Het-Bhavsar/Atrium/README.md

<p align="center">
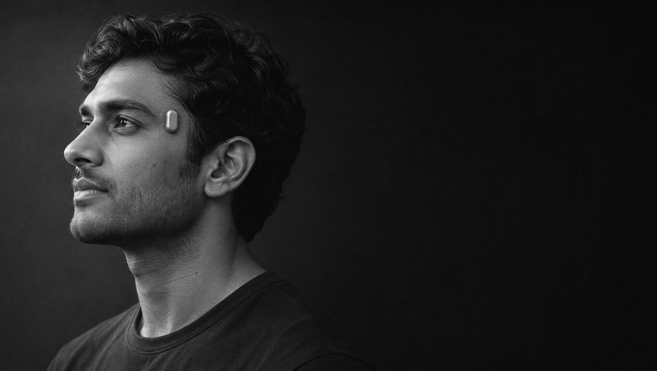
[picture p1: docs/images/photos/hero_mono.jpg]
A man in profile wearing the Atrium pod beside his eye
  
  <br><sub>Illustration: the pod at true scale. No EVT units are built yet.</sub>
</p>

<p align="center">
  Atrium mark
</p>

<h1 align="center">Atrium</h1>

<p align="center">
  <b>An open optical wearable, small enough to forget.</b><br>
  Designed in Ahmedabad by <a href="https://localforge.in">Local Forge</a>.
</p>

<p align="center">
  <a href="https://certification.oshwa.org/in000108.html">OSHW certification mark, UID IN000108</a>
</p>

<p align="center">
  <a href="docs/quick-start.md">Quick start</a> ·
  <a href="#the-story">Story</a> ·
  <a href="#inside">Inside</a> ·
  <a href="#whats-next">What's next</a> ·
  <a href="#at-a-glance">At a glance</a> ·
  <a href="#get-the-app">Get the app</a> ·
  <a href="#whats-in-this-repository">Repository</a> ·
  <a href="CONTRIBUTING.md">Contribute</a> ·
  <a href="#licence">Licence</a>
</p>

---

## Small. Quiet. Open.

Atrium is a 20.9 × 11 × 5.3 mm pod worn on the temporal region, the flat of the head beside the eye. It reads the skin
with light and motion: pulse, heart-rate variability, skin-temperature trend, sleep and activity. It keeps a log and
syncs it to your phone over Bluetooth LE. A small Plinth charges it, and a pocket case charges it on the go.

https://github.com/user-attachments/assets/29e595bc-7b6f-4664-8e52-f603c6576f4c

<p align="center">
  <sub>The film, 57 s: the radio island, the power island, the flex, the cell, the pod, then green and red light on skin.
  <a href="docs/images/video/atrium_assembly_film_1080p.mp4">Download the MP4</a>.</sub>
</p>

<p align="center">
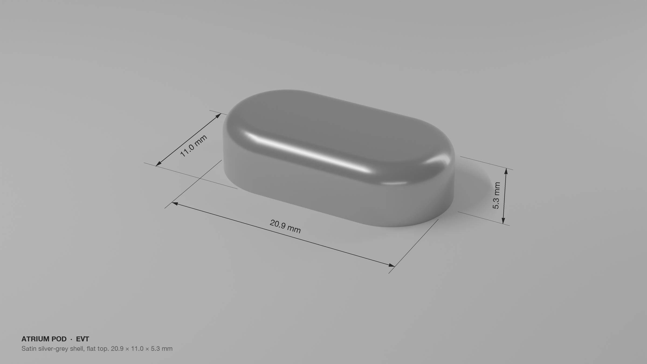
[picture p2: docs/images/renders/pod_studio_dimensions.png]
Studio render of the pod with its dimensions: 20.9 by 11.0 by 5.3 mm
  
</p>

<p align="center">
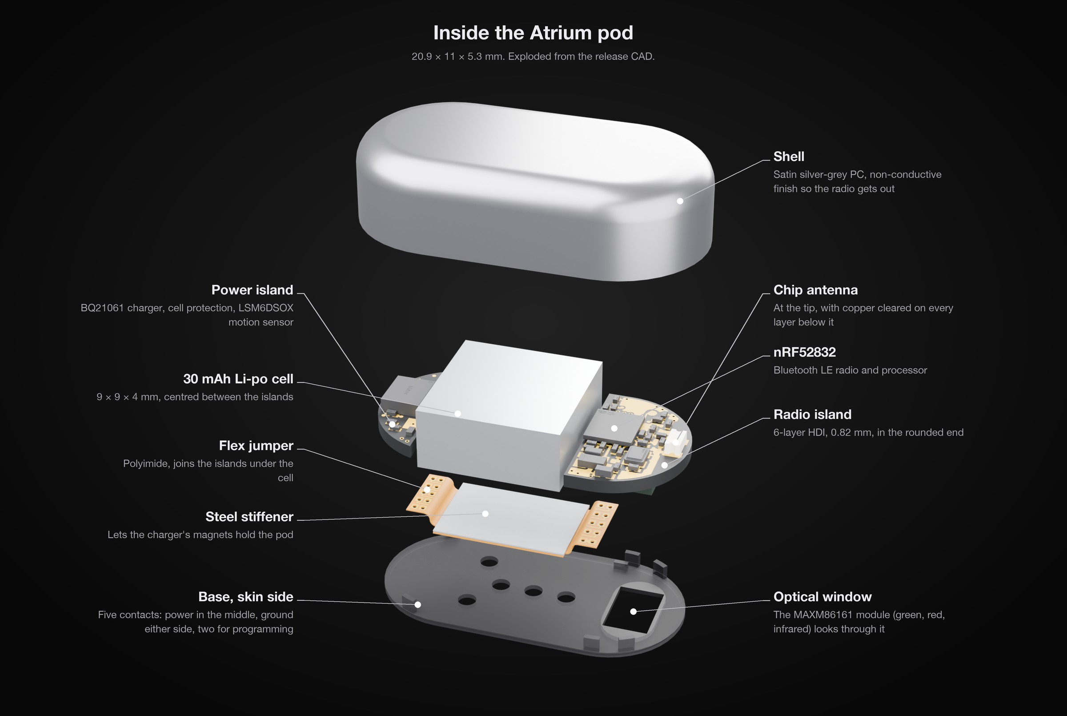
[picture p3: docs/images/plates/pod_exploded_infographic.jpg]
Exploded view of the pod with each part labelled: shell, chip antenna, nRF52832, radio island, power island, cell, flex, stiffener, base and optical window
  
</p>

Every file that defines it is here: schematics, board layouts, Gerbers, BOMs, enclosure CAD and drawings, the
simulations behind the numbers, the firmware for the pod and the case, and the phone app. Read it, build it, change it.

<p align="center">
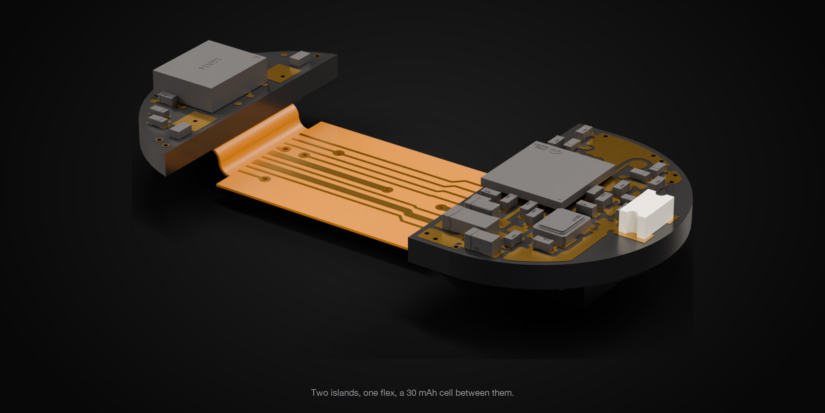
[picture p4: docs/images/plates/boards.jpg]
The two pod boards joined by the flex
  
</p>

<p align="center">
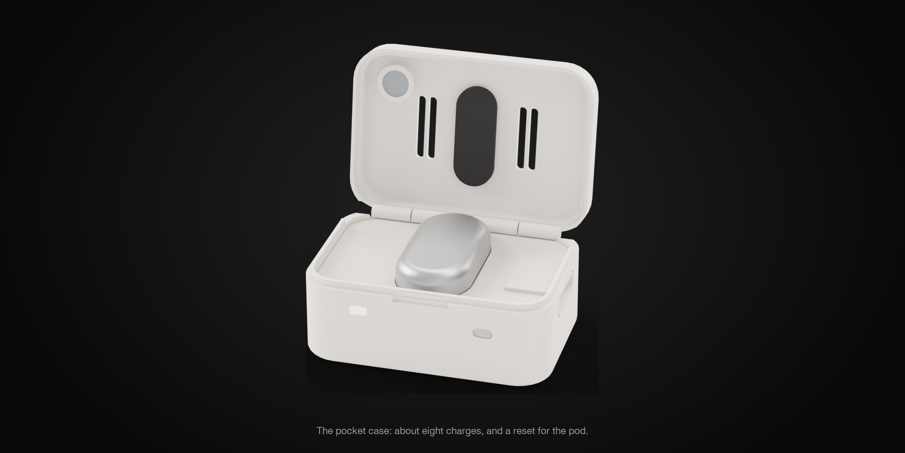
[picture p5: docs/images/plates/case.jpg]
Charging case, open, with the pod in its nest
  
</p>

## Quick start

| I want to | Start here |
|---|---|
| Try the app without a pod | Install the demo APK from [Releases](https://github.com/Het-Bhavsar/Atrium/releases/latest) |
| Read the design | Schematic and PCB PDFs in `hardware/`, drawings in `mechanical/` |
| Build the firmware | `firmware/tests/fw.sh image`, then `test` and `build` (Docker only) |
| Make, flash and pair pods | [`docs/quick-start.md`](docs/quick-start.md) |

## The story

Every great building has a centre. In a Roman house it was the atrium: an open hall with the sky for a roof. Light came
in there, people gathered there, and nothing was hidden. Your heart has one too: the chamber where blood arrives before
every beat.

I named Atrium after both. It reads your pulse with light, and like the hall, it is open: every schematic, every line of
firmware and every data format is public.

It started as a 28 × 14 mm board with a discrete optical front end. That was too big to forget on your head, so I moved
the optics into one module, dropped to a 30 mAh cell, and split the electronics into two small boards in the rounded
ends of the pod, joined by a flex under a centred cell. Each step, and what I tried and left behind, is in
[`docs/story.md`](docs/story.md) and [`legacy/`](legacy/).

<p align="center">
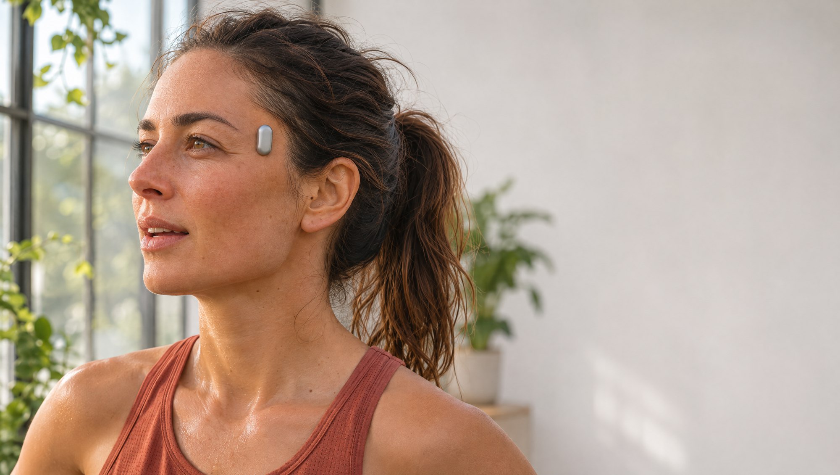
[picture p6: docs/images/photos/pod_worn.jpg]
The pod worn upright in the temporal hollow, beside the eye
  
  <br><sub>Worn upright in the temporal hollow, a thumb-width behind the eye. Illustrations, with the pod at true scale.</sub>
</p>

**Atrium. Open to the sky. Open to everyone.**

## Inside

Every board is routed by hand: no autorouter, arc bends on the antenna feed and a copper-free zone under the chip
antenna on every layer.

<p align="center">
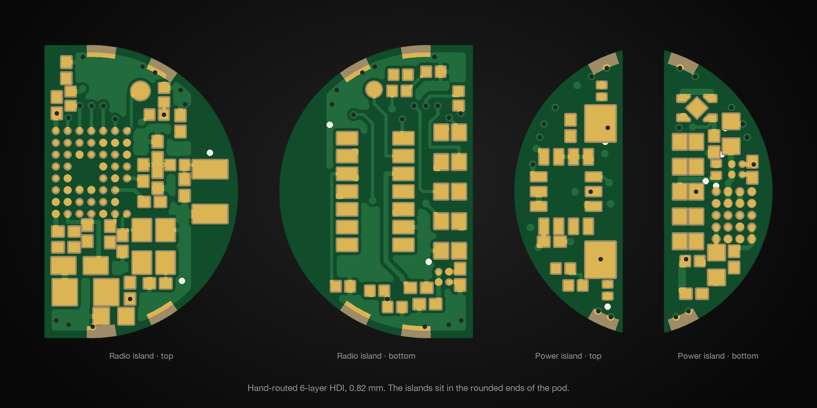
[picture p7: docs/images/plates/layout_islands.jpg]
Radio and power island layouts, top and bottom
  
</p>

<p align="center">
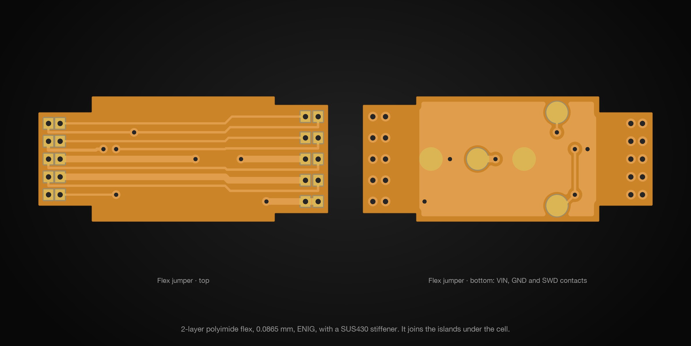
[picture p8: docs/images/plates/layout_flex.jpg]
Flex jumper layout, top and bottom
  
</p>

<p align="center">
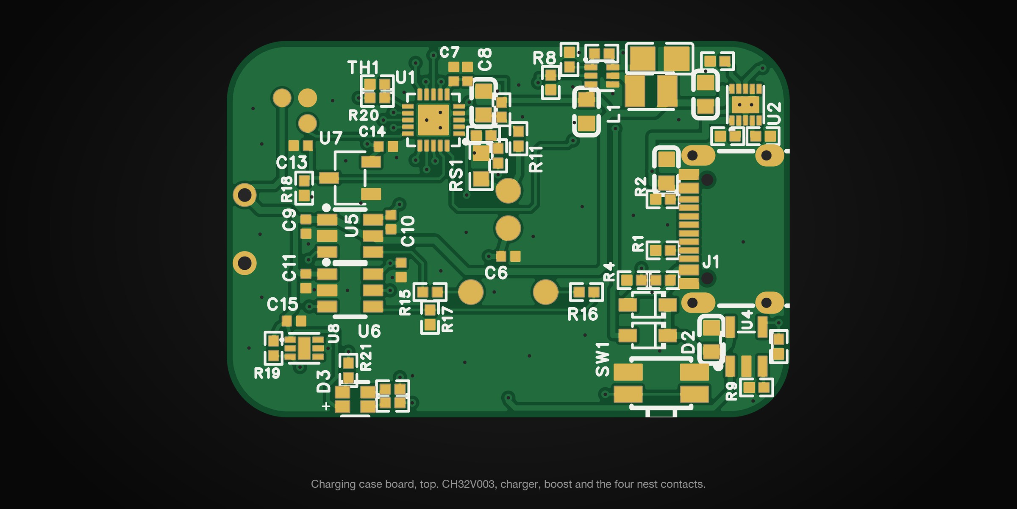
[picture p9: docs/images/plates/layout_case.jpg]
Charging case board layout, top
  
</p>

<p align="center">
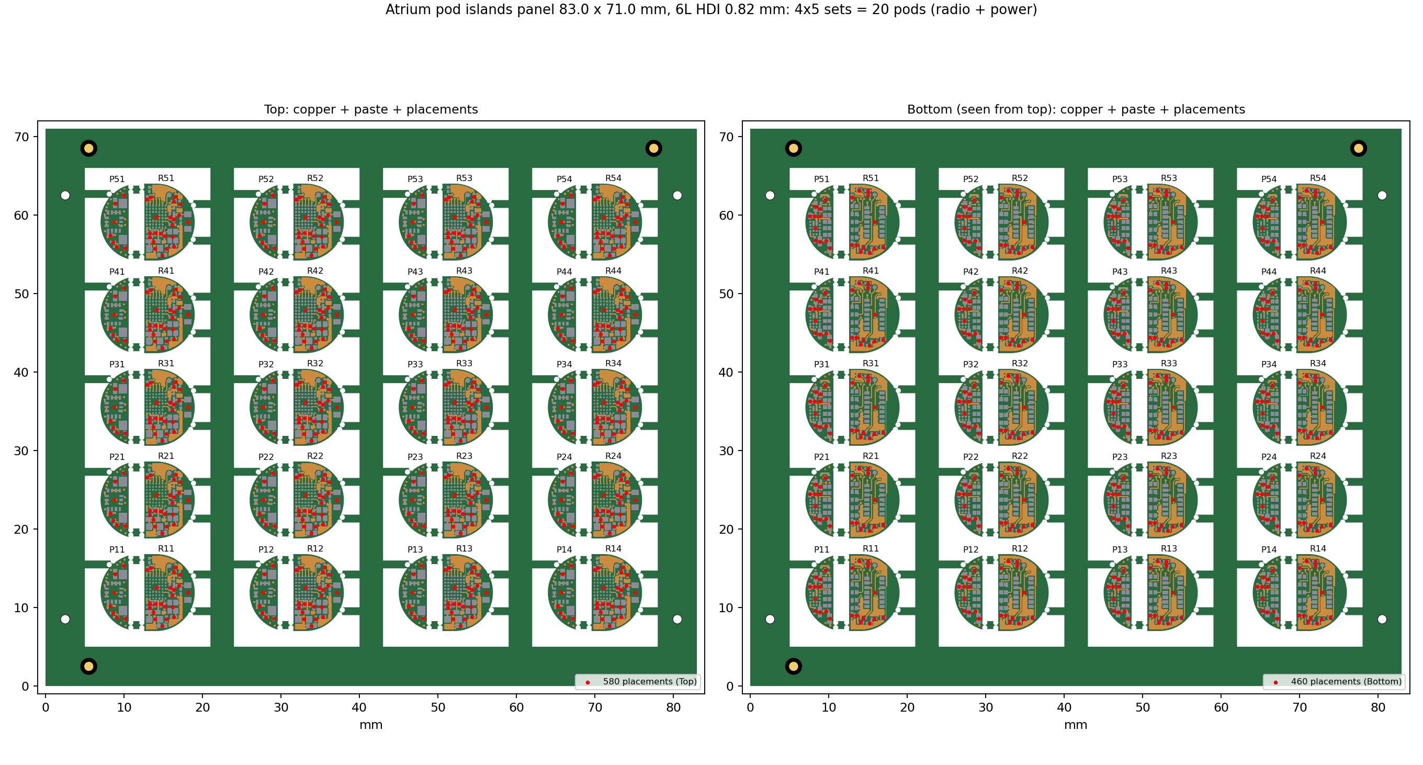
[picture p10: hardware/pod/islands-panel/Pod_Islands_Panel_render.png]
The islands panel: 20 pods on one 6-layer panel
  
  <br><sub>One 83 × 71 mm panel builds 20 pods: one PCB order, one stencil per side, one assembly run.</sub>
</p>

## What's next

The EVT build is about proving the basics on real heads. While that happens, these are the three directions I care
most about.

**Smaller, with a custom cell.** The pod is 20.9 mm long today because the cell is an off-the-shelf 9 × 9 × 4 mm
pouch, and the radio island, cell and power island have to sit in a row. With a cell made to the shape of the shell I
think we can bring the pod to around 17 mm. That is the size I wanted from the start, and the first thing I will chase
after EVT.

**A voice on the head.** The temporal region sits right on the bone. The next version could add bone-conduction audio and
a voice pickup, so you can tap the pod and talk to an AI assistant, with the answer heard through
the bone and nothing in your ear. It is designed on paper and deliberately left out of EVT, so this build stays simple.

### Brain blood flow?

It's the first thing people ask about a sensor on the side of the head, so here is the straight answer: **no, Atrium
can't see blood flow in the brain, and neither can any sensor whose light and detector sit this close
together.** I wanted it to, so I tested it before
claiming anything.

<p align="center">
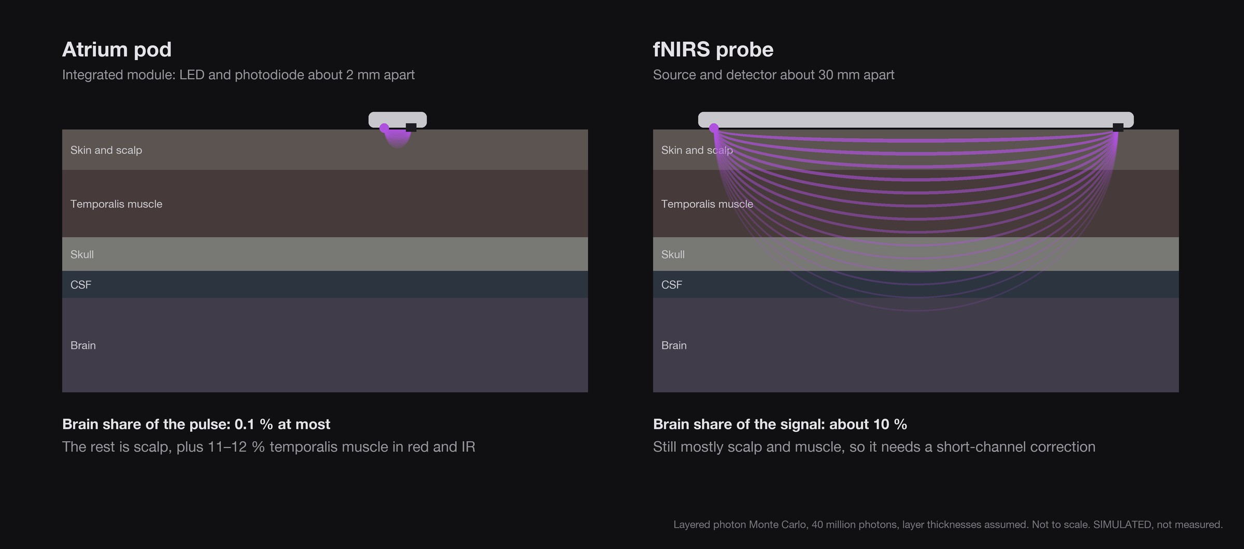
[picture p11: docs/images/research/light_depth_explainer.jpg]
How deep light travels at 2 mm and at 30 mm spacing
  
</p>

An optical sensor works by shining light into the skin and catching what scatters back. The light comes back along a
curved path, and **how deep that path goes depends on how far apart the light and the detector are.** Under the pod
there are a few millimetres of scalp, 4 to 17 mm of jaw muscle depending on the person, then the skull and some fluid
before you reach the brain.

- **The usual way, which Atrium uses.** An integrated optical module: green, red and infrared LEDs and the photodiode
  in one 2.9 × 4.3 mm package, so they are fixed about 2 mm apart by the part itself. Our photon simulations say green never leaves the scalp, and in red and infrared the brain's share of the
  pulse is **0.1 % at most**; the rest is scalp and the temporalis muscle. The pulse at the side of your head comes from
  the superficial temporal artery, which feeds the scalp, not the brain.
- **A far detector, which we tried.** Rev B.1 had a second photodiode 18.5 mm from the LEDs. At that distance our
  simulation puts the brain at about 1 % of the pulse and the jaw muscle at about three quarters, so it was dropped.
- **The fNIRS way.** Near-infrared light with the source and the detector about **3 cm** apart, so the light that makes
  it across has gone deep enough to reach the brain. Even then the brain is only **about 10 %** of the signal, which
  is why research systems add a short scalp-only channel and subtract it.

Better processing can't close that gap. To detect a brain signal in a 24-person study it would need to be about 2 % of
the pulse; at the pod's spacing it is 20 to 450 times smaller, depending on the person, faster sampling barely helps, and the jaw muscle
produces false "deep" results on its own. So when a small device says it reads brain blood flow, ask how far apart its
light and detector are, whether it has a short channel, and what it was validated against.

A 3 cm optical path needs a band or a longer probe and a proper study with a reference. It is on my research list, not
in this product. Atrium is a wellness device: pulse, heart-rate variability, sleep and skin temperature, done
honestly. The full reasoning is in [`docs/brain-blood-flow.md`](docs/brain-blood-flow.md), and the study itself, with its
figures and all the data, is in [`docs/research/brain-blood-flow/`](docs/research/brain-blood-flow/README.md).

If any of this is the part you want to build, start with the [roadmap](docs/roadmap.md) and open an issue.

— Het

## At a glance

| | |
|---|---|
| **Pod** | 20.9 × 11 × 5.3 mm capsule, flat top, satin silver-grey (NCVM on PC, non-conductive for the antenna) |
| **Boards** | Two rigid 6-layer HDI islands, 0.82 mm (1+4+1, laser microvias, filled via-in-pad), joined by a 2-layer polyimide flex under the cell |
| **Radio** | Bluetooth LE, nRF52832 WLCSP; KH-1608 chip antenna at the tip, 50 Ω coplanar feed with arc bends, copper-free on every layer under the antenna |
| **Optics** | MAXM86161A module (green, red and infrared LEDs, photodiode, front end) behind a pill window |
| **Other sensors** | LSM6DSOX motion, a skin NTC and a top NTC |
| **Power** | 30 mAh Li-po (9 × 9 × 4 mm), BQ21061 charger, AP6683 protection, 1.8 V rails; about 4 days in the default mode (to be measured on EVT units) |
| **Charging** | ENIG contacts on the skin side: VIN at the centre and ground either side, so it charges either way round, plus two SWD contacts for the programming jig and the charging case. A steel stiffener and two magnets hold it on the Plinth |
| **Case** | 2-layer board: CH32V003 MCU, BQ24040 charger with cell-temperature cut-off, 5 V boost and current limit into the pod; about 8 pod charges per case charge (estimated) |
| **Wear** | Upright, window end up. A hidden 0.15 mm disposable pad in a bed under the pod; nothing shows |
| **Build** | Parts from the LCSC / JLCPCB catalogue; both islands on one panel for one PCBA order |
| **Software** | Pod firmware on Zephyr RTOS with MCUboot, case firmware for the CH32V003, Flutter app for Android and iOS. No account and no cloud: data stays on the phone |

## Get the app

<p align="center">
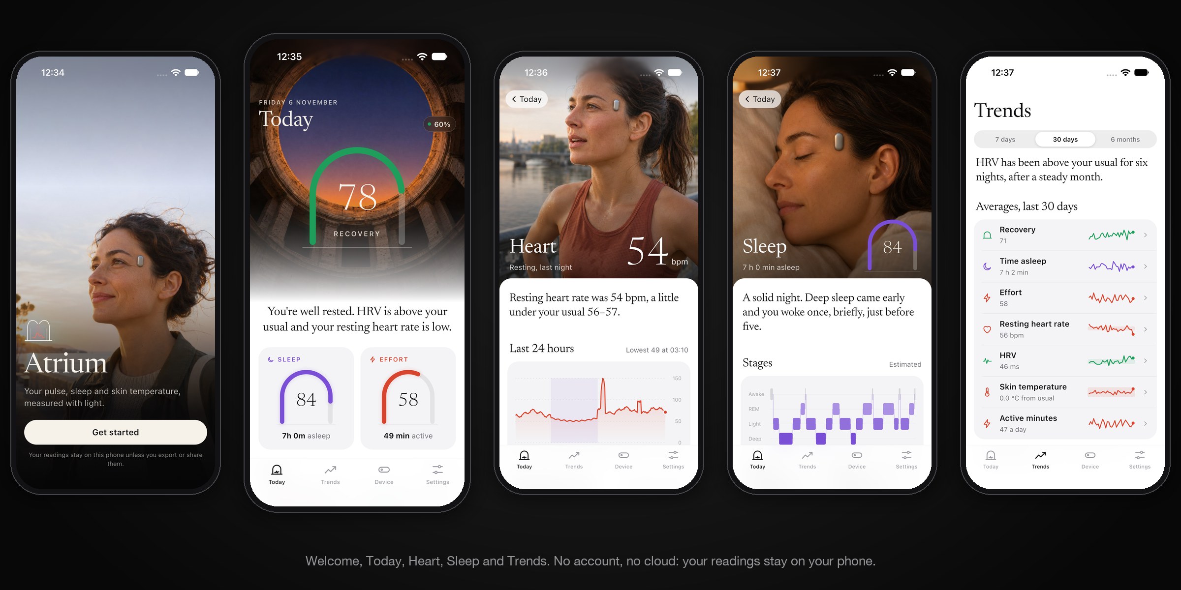
[picture p12: docs/images/app/app_daily.jpg]
App screens: Welcome, Today, Heart, Sleep, Trends
  
</p>

<p align="center">
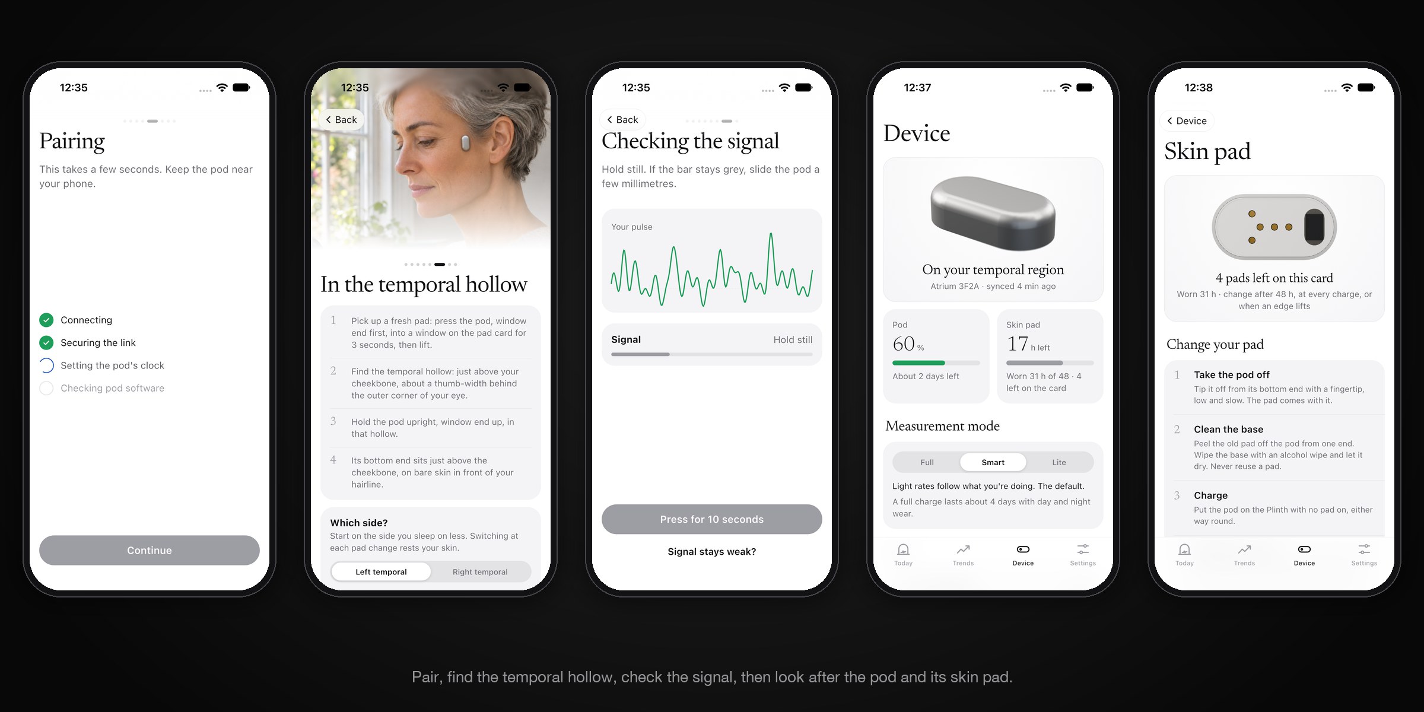
[picture p13: docs/images/app/app_setup.jpg]
Setup screens: pairing, placement, signal check, device and skin pad
  
  <br><sub>Screens from the demo build, with sample data. The photographs in the app are illustrations.</sub>
</p>

The Android app is on the [Releases page](https://github.com/Het-Bhavsar/Atrium/releases/latest):

- `atrium-…-demo-arm64-v8a.apk`: sample data, no pod needed. Start here.
- `atrium-…-pod-arm64-v8a.apk`: talks to a real pod over Bluetooth.
- `armeabi-v7a` builds for older phones.

The iOS app builds from `app/android-ios` with Flutter (see its README).

## What's in this repository

```
hardware/
  pod/radio-island/      schematic (SchDoc, PDF, SVG) · pcb (PcbDoc, PDF, STEP, renders) · production (Gerbers, BOM, CPL, IPC netlist)
  pod/power-island/      same
  pod/flex-jumper/       same
  pod/islands-panel/     the 4 × 5 panel of both islands: PcbDoc, Gerbers, BOM, CPL, order notes
  case/charging-case/    same as the islands
  design-data/           netlist, pin map, PCB and flex rules, board outlines (DXF)
  simulation/            reports: RF chain, impedance, link budget, optics, power, charging, thermal, assembly
  stencil-report.md      stencil area ratios for every board
  easyeda/               the native EasyEDA Pro project: every board, editable
mechanical/
  pod/ case/ plinth/ programming-jig/ packaging/    drawings (PDF) · STEP · STL · GLB · DXF
  renders/                                          product and section renders
firmware/                pod (Zephyr) and case (CH32V003) firmware with tests
app/android-ios/         Flutter app for Android and iOS
docs/                    story, architecture, mechanical, placement, charging case, build and test, features, BLE GATT, brochure
legacy/                  earlier revisions and concepts, with why each was dropped
```

The `.SchDoc` and `.PcbDoc` files are Altium format, exported from EasyEDA Pro, and open in Altium Designer and in KiCad
(File → Import). The PDFs and Gerbers need no EDA tool.

## Status

Engineering validation (EVT).

| | |
|---|---|
| Schematics | Captured and checked against the netlist |
| Boards | Hand-routed: radio and power islands (6-layer HDI), flex jumper, charging case. DRC: islands and panel 0 errors; flex and case have explained, accepted items ([`hardware/README.md`](hardware/README.md#checks)) |
| Production files | Gerbers, BOM, CPL and a 4 × 5 islands panel ready to order |
| Enclosure | Pod, skin pad, Plinth, case, jig and packaging CAD with fit checks and drawings |
| Firmware | Pod and case firmware build; unit tests pass |
| App | Android and iOS app with demo and real-pod modes; v0.1.2 APKs |
| First units | Not built yet |

Open engineering items are tracked in [`docs/open-items.md`](docs/open-items.md).

## Contributing

Atrium is built in the open and welcomes help: firmware, the app, signal processing, mechanical, testing on real heads,
documentation. Start with [`CONTRIBUTING.md`](CONTRIBUTING.md) and the [roadmap](docs/roadmap.md).

## Not a medical device

Atrium is for wellness and research. It does not diagnose, treat or prevent any condition, and its readings must not be
used for medical decisions.

## Licence

Copyright 2026 Het Bhavsar. Atrium is published through [Local Forge](https://localforge.in), an open-source
community that enables made-in-India hardware development. Source location:
<https://github.com/Het-Bhavsar/Atrium>.

| Folder | What it covers | Licence | SPDX |
|---|---|---|---|
| `hardware/`, `mechanical/` | Schematics, layout, the EasyEDA Pro project, production files, CAD, drawings, simulations | [CERN Open Hardware Licence v2, Strongly Reciprocal](LICENSE) | `CERN-OHL-S-2.0` |
| `firmware/` | Pod and case firmware | [Apache License 2.0](firmware/LICENSE) | `Apache-2.0` |
| `app/` | Phone app | [Apache License 2.0](app/LICENSE) | `Apache-2.0` |
| `docs/`, `README.md` and the other Markdown files | Documentation, images, renders, photographs and research data | [Creative Commons Attribution-ShareAlike 4.0](docs/LICENSE) | `CC-BY-SA-4.0` |
| `legacy/` | Earlier revisions: design files under `CERN-OHL-S-2.0`, text and images under `CC-BY-SA-4.0` | [legacy/LICENSE.md](legacy/LICENSE.md) | both |

- **Hardware.** CERN-OHL-S-2.0 is strongly reciprocal: if you make and convey a product from these files, or a modified
  version of them, you must make the complete source of your version available under the same licence, keep the
  copyright and licence notices, and keep or add a source location that points to it.
- **Software.** Apache-2.0 allows use, change and redistribution, including commercial, with a patent grant. Keep the
  licence and copyright notices and mark the files you change.
- **Documents.** CC BY-SA 4.0 requires credit ("Atrium by Het Bhavsar / Local Forge", with a link to the source location), a link to
  the licence, a note of changes, and the same licence on adaptations.
- **Names and marks.** The licences cover the design, code and text. They do not grant rights to the names "Atrium" and
  "Local Forge" or their logos. A product built from these files must not suggest that Local Forge made or endorses it.
- **Selling it.** The licences let anyone make, change and sell Atrium without asking first. What they may not do is
  close it or borrow its name: whoever sells hardware made from these files must publish the complete source of their
  version (including their changes) under CERN-OHL-S-2.0, keep every copyright, licence and source-location notice,
  credit the documentation, and must not use the names Atrium or Local Forge, their logos or an OSHWA certification
  that is not theirs. Someone who breaks these terms loses the licence. The seller, not the designer, is responsible
  for the safety and regulatory approval of what they sell.
- **Third-party material.** Libraries the firmware and app build against, the app font, the datasets behind the sleep
  model and the depth study, and the component library parts keep their own licences; see
  [THIRD_PARTY_NOTICES.md](THIRD_PARTY_NOTICES.md).
- **No warranty.** Each licence disclaims all warranties and liability to the extent the law allows.

Atrium is certified open source hardware: [OSHW] IN000108 | Certified open source hardware | [oshwa.org/cert](https://certification.oshwa.org/in000108.html).
OSHWA certified version 0.1.0-evt on 14 November 2026. The certification covers the openness of the design, not its
safety or quality ([certification.md](docs/certification.md)).
