Het-Bhavsar/Atrium/hardware/pod/islands-panel/README.md

# Pod islands panel

One 6-layer panel carries both pod islands, so a build needs one PCB order, one stencil per side and one assembly setup.

| Item | Value |
|---|---|
| Panel | 83.0 × 71.0 mm, 5 mm frame, 3 mm bar between the columns. Above the 70 × 70 mm minimum for JLC Standard PCBA, which the islands need (0.35 mm IC pitch, 0.3 mm BGA pitch, parts on both sides) |
| Contents | 4 columns × 5 rows of sets: 20 radio islands and 20 power islands (20 pods) |
| Stack-up | JLC06081H-2313, 0.82 mm, the same as the single boards |
| Tabs | Each pod is held at both ends: two radio tip tabs (inside the antenna's copper-free zone) and one power tab at 133°; the two islands of a set are joined by two corner tabs. Nearest pad to any tab end: 0.40 mm |
| Break-off | Mouse bites: two 0.50 mm NPTH holes per tab end at 0.65 mm pitch, centres 0.30 mm outside the board edge (280 per panel) |
| Copper at the tabs | Pour kept off every tab body and 0.2 mm back from each joint, the same pull-back as every board edge |
| Fiducials and tooling | 3 fiducials per side (1.0 mm copper, 2.0 mm mask opening), 4 × 1.152 mm NPTH tooling holes |
| Placements | 1,040 per panel (580 top, 460 bottom), 31 BOM lines |
| Nets | Each island has its own net names (`GND_R11`, `VSYS_P32`, …), so the flying-probe netlist keeps the islands apart |

## Files

| File | What it is |
|---|---|
| `Pod_Islands_Panel.PcbDoc` | Panel layout (Altium format, exported from EasyEDA Pro) |
| `Pod_Islands_Panel_gerber.zip` | Gerbers, drills and the flying-probe file. Paste layers carry the enlarged fine-pitch apertures |
| `Pod_Islands_Panel_BOM.csv`, `Pod_Islands_Panel_CPL.csv` | Assembly files in JLC format; designators carry the set (`U1_R11` = radio, row 1, column 1). CPL positions are in the same coordinates as the Gerbers |
| `Pod_Islands_Panel_render.png` | Top and bottom with every placement marked |

The panel was checked against both source boards part by part (all 40 islands: parts, pad nets, tracks, vias) and, as
Gerbers, layer by layer: all six copper layers, both masks and both paste layers match an independent merged-Gerber build, and the 4,484 drill hits match (3,944 holes: EasyEDA writes each of the 540 through vias into both the `Through` and the `Through_Via` drill file). EasyEDA DRC on the panel: 0 errors. The panel PCB carries four panel-only rules:
board outline to hole and to TH pad 0 (the mouse bites sit on the edge by design), hole to hole 0.10 mm (bite pairs),
and board outline to SMD pad 0.195 mm, which absorbs a 1 µm rounding of the column-2 offset at the radio flex pads
(0.200 mm on the island itself, where the 0.20 mm rule passes).

## Order notes

1. Customer panel with two different designs. Confirm the "different designs" fee and HDI acceptance with the fab.
2. Stencil: one per side, 0.08 mm electropolished foil, on a frame. Ask the factory not to resize apertures.
3. Depanel by cutting the tabs (blade or router), never by snapping: WLCSP and DSBGA parts sit a few millimetres from
   the tabs on a 0.82 mm board. Sand the nubs flush; the islands sit in a 0.15 mm wall clearance.
4. X-ray U1 (WLCSP) and U2, U10, U13 (DSBGA) on the first panel.
5. Support the panel under the frame and bars on both passes (worst island deflection about 64 µm at a 2 N nozzle force).
6. Bottom side first.
7. Check the orientation of the WLCSP, DSBGA, LGA and DFN parts in the fab's CPL preview before paying.
