Het-Bhavsar/Atrium/hardware/stencil-report.md

# Stencil area-ratio report

Per-pad stencil apertures of every EVT board, from the paste Gerbers in each `production/` folder (IPC-7525: area ratio ≥ 0.66 releases cleanly from a laser-cut foil; 0.5–0.66 needs an electropolished or nano-coated foil). The pod islands are ordered with a 0.08 mm electropolished foil; the fine-pitch apertures (U1 0.21 mm, U2/U13 0.20 mm, U10 0.22 mm circles, U12 exposed pad 0.38 mm square) are already enlarged in the released paste layers.

| Board | Side | Apertures | Smallest (mm) | Min AR @0.08 | @0.10 | @0.12 | Below 0.66 @0.10 |
|---|---|---|---|---|---|---|---|
| RADIO | top | 101 | 0.21 x 0.21 (U1.H7) | 0.70 | 0.56 | 0.47 | 50 |
| RADIO | bottom | 49 | 0.20 x 0.20 (U2.B2) | 0.67 | 0.54 | 0.45 | 4 |
| POWER | top | 28 | 0.30 x 0.20 (D12.1) | 0.78 | 0.62 | 0.52 | 4 |
| POWER | bottom | 55 | 0.20 x 0.20 (U13.B2) | 0.67 | 0.54 | 0.45 | 30 |
| FPC1 | top | 20 | 0.45 x 0.50 (.JP1) | 1.50 | 1.20 | 1.00 | 0 |
| FPC1 | bottom | 5 | 1.00 x 1.00 (.P3) | 2.98 | 2.39 | 1.99 | 0 |
| CASE | top | 174 | 0.60 x 0.20 (U1.1) | 0.96 | 0.77 | 0.64 | 0 |

Apertures under 0.66 on a 0.10 foil:
- RADIO top U1.H7: 0.21 x 0.21 mm, AR 0.70 / 0.56 / 0.47 (0.08 / 0.10 / 0.12 foil)
- RADIO top U1.G7: 0.21 x 0.21 mm, AR 0.70 / 0.56 / 0.47 (0.08 / 0.10 / 0.12 foil)
- RADIO top U1.F7: 0.21 x 0.21 mm, AR 0.70 / 0.56 / 0.47 (0.08 / 0.10 / 0.12 foil)
- RADIO top U1.E7: 0.21 x 0.21 mm, AR 0.70 / 0.56 / 0.47 (0.08 / 0.10 / 0.12 foil)
- RADIO top U1.D7: 0.21 x 0.21 mm, AR 0.70 / 0.56 / 0.47 (0.08 / 0.10 / 0.12 foil)
- RADIO top U1.C7: 0.21 x 0.21 mm, AR 0.70 / 0.56 / 0.47 (0.08 / 0.10 / 0.12 foil)
- RADIO top U1.B7: 0.21 x 0.21 mm, AR 0.70 / 0.56 / 0.47 (0.08 / 0.10 / 0.12 foil)
- RADIO top U1.A7: 0.21 x 0.21 mm, AR 0.70 / 0.56 / 0.47 (0.08 / 0.10 / 0.12 foil)
- RADIO top U1.H6: 0.21 x 0.21 mm, AR 0.70 / 0.56 / 0.47 (0.08 / 0.10 / 0.12 foil)
- RADIO top U1.G6: 0.21 x 0.21 mm, AR 0.70 / 0.56 / 0.47 (0.08 / 0.10 / 0.12 foil)
- RADIO top U1.F6: 0.21 x 0.21 mm, AR 0.70 / 0.56 / 0.47 (0.08 / 0.10 / 0.12 foil)
- RADIO top U1.E6: 0.21 x 0.21 mm, AR 0.70 / 0.56 / 0.47 (0.08 / 0.10 / 0.12 foil)
- RADIO top U1.D6: 0.21 x 0.21 mm, AR 0.70 / 0.56 / 0.47 (0.08 / 0.10 / 0.12 foil)
- RADIO top U1.C6: 0.21 x 0.21 mm, AR 0.70 / 0.56 / 0.47 (0.08 / 0.10 / 0.12 foil)
- RADIO top U1.B6: 0.21 x 0.21 mm, AR 0.70 / 0.56 / 0.47 (0.08 / 0.10 / 0.12 foil)
- RADIO top U1.A6: 0.21 x 0.21 mm, AR 0.70 / 0.56 / 0.47 (0.08 / 0.10 / 0.12 foil)
- RADIO top U1.H5: 0.21 x 0.21 mm, AR 0.70 / 0.56 / 0.47 (0.08 / 0.10 / 0.12 foil)
- RADIO top U1.G5: 0.21 x 0.21 mm, AR 0.70 / 0.56 / 0.47 (0.08 / 0.10 / 0.12 foil)
- RADIO top U1.F5: 0.21 x 0.21 mm, AR 0.70 / 0.56 / 0.47 (0.08 / 0.10 / 0.12 foil)
- RADIO top U1.C5: 0.21 x 0.21 mm, AR 0.70 / 0.56 / 0.47 (0.08 / 0.10 / 0.12 foil)
- RADIO top U1.B5: 0.21 x 0.21 mm, AR 0.70 / 0.56 / 0.47 (0.08 / 0.10 / 0.12 foil)
- RADIO top U1.A5: 0.21 x 0.21 mm, AR 0.70 / 0.56 / 0.47 (0.08 / 0.10 / 0.12 foil)
- RADIO top U1.H4: 0.21 x 0.21 mm, AR 0.70 / 0.56 / 0.47 (0.08 / 0.10 / 0.12 foil)
- RADIO top U1.G4: 0.21 x 0.21 mm, AR 0.70 / 0.56 / 0.47 (0.08 / 0.10 / 0.12 foil)
- RADIO top U1.F4: 0.21 x 0.21 mm, AR 0.70 / 0.56 / 0.47 (0.08 / 0.10 / 0.12 foil)
- RADIO top U1.C4: 0.21 x 0.21 mm, AR 0.70 / 0.56 / 0.47 (0.08 / 0.10 / 0.12 foil)
- RADIO top U1.B4: 0.21 x 0.21 mm, AR 0.70 / 0.56 / 0.47 (0.08 / 0.10 / 0.12 foil)
- RADIO top U1.A4: 0.21 x 0.21 mm, AR 0.70 / 0.56 / 0.47 (0.08 / 0.10 / 0.12 foil)
- RADIO top U1.H3: 0.21 x 0.21 mm, AR 0.70 / 0.56 / 0.47 (0.08 / 0.10 / 0.12 foil)
- RADIO top U1.G3: 0.21 x 0.21 mm, AR 0.70 / 0.56 / 0.47 (0.08 / 0.10 / 0.12 foil)
- RADIO top U1.F3: 0.21 x 0.21 mm, AR 0.70 / 0.56 / 0.47 (0.08 / 0.10 / 0.12 foil)
- RADIO top U1.E3: 0.21 x 0.21 mm, AR 0.70 / 0.56 / 0.47 (0.08 / 0.10 / 0.12 foil)
- RADIO top U1.D3: 0.21 x 0.21 mm, AR 0.70 / 0.56 / 0.47 (0.08 / 0.10 / 0.12 foil)
- RADIO top U1.C3: 0.21 x 0.21 mm, AR 0.70 / 0.56 / 0.47 (0.08 / 0.10 / 0.12 foil)
- RADIO top U1.B3: 0.21 x 0.21 mm, AR 0.70 / 0.56 / 0.47 (0.08 / 0.10 / 0.12 foil)
- RADIO top U1.A3: 0.21 x 0.21 mm, AR 0.70 / 0.56 / 0.47 (0.08 / 0.10 / 0.12 foil)
- RADIO top U1.H2: 0.21 x 0.21 mm, AR 0.70 / 0.56 / 0.47 (0.08 / 0.10 / 0.12 foil)
- RADIO top U1.G2: 0.21 x 0.21 mm, AR 0.70 / 0.56 / 0.47 (0.08 / 0.10 / 0.12 foil)
- RADIO top U1.F2: 0.21 x 0.21 mm, AR 0.70 / 0.56 / 0.47 (0.08 / 0.10 / 0.12 foil)
- RADIO top U1.E2: 0.21 x 0.21 mm, AR 0.70 / 0.56 / 0.47 (0.08 / 0.10 / 0.12 foil)
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
- POWER bottom U12.1: 0.40 x 0.20 mm, AR 0.80 / 0.64 / 0.53 (0.08 / 0.10 / 0.12 foil)
- POWER bottom U12.4: 0.40 x 0.20 mm, AR 0.80 / 0.64 / 0.53 (0.08 / 0.10 / 0.12 foil)
- POWER bottom U12.3: 0.40 x 0.20 mm, AR 0.80 / 0.64 / 0.53 (0.08 / 0.10 / 0.12 foil)
