Het-Bhavsar/Atrium/hardware/simulation/summary.md

# Atrium simulation results

Each section links to its full report.

## Power budget (locked 20.9 mm build)

Full report: [results/power_budget.md](power_budget.md)

## NTC + SAADC (TH1 skin, TH4 top)

Full report: [results/ntc_saadc.md](ntc_saadc.md)

## BLE link budget (pod on the temporal region -> phone)

Full report: [results/link_budget.md](link_budget.md)

## 50 ohm feed on the 6-layer stack (L1 over L2, prepreg 2313)

Full report: [results/cpwg_6l.md](cpwg_6l.md)

## I2C pull-ups (1.8 V, 400 kHz)

Full report: [results/i2c_pullup.md](i2c_pullup.md)

## 32 MHz crystal load

Full report: [results/crystal_load.md](crystal_load.md)

## Charging (BQ21061, 15 mA, CC/CV, generic cell model)

Full report: [results/charge.md](charge.md)

## Tolerance stacks

Full report: [results/stack_tolerance.md](stack_tolerance.md)

## HRV (RMSSD) timing error vs PPG sample rate

Full report: [results/hrv_timing.md](hrv_timing.md)

## Pi-match search: synthetic detuned antenna (demo)

Full report: [results/smith_match_demo.md](smith_match_demo.md)

## RF chain as drawn: insertion loss and harmonic rejection (50 ohm ports)

Full report: [results/rf_chain.md](rf_chain.md)

## Flex jumper DC: line resistance and IR drop

Full report: [results/flex_dc.md](flex_dc.md)

## PPG optics at the temporal region (MAXM86161, diffusion model)

Full report: [results/ppg_optics.md](ppg_optics.md)

## Pod thermal (steady state)

Full report: [results/thermal.md](thermal.md)
