Het-Bhavsar/Atrium/hardware/design-data/pinmap/nrf52832_pinmap.md

# nRF52832-CIAA pin map

Canonical table: `docs/architecture.md` (pin map section).
Source of truth: `hardware/design-data/netlist/atrium_nets.yaml` (nets on `U1.P0.x`).
Firmware mirror: `firmware/boards/atrium/atrium_pod/atrium_pod.dts` and `atrium_pod-pinctrl.dtsi`.
