Het-Bhavsar/Atrium/hardware/case/mechanical/renders/case_fit_report.txt

ATRIUM CASE FIT CHECK
================================================================
Case:
[PASS] pogo engagement: cradle floor 11.62, barrel top 11.50, plunger tip 13.10 = pad face 13.10
[PASS] pogo stroke: working compression 0.6 vs max stroke 1.2 [VERIFY part drawing]
[PASS] plunger in window hole: radial 0.30 vs pocket float 0.15
[PASS] USB-C J1 vs docked pod: overlap 0.00 mm3; J1 rear y 6.8, pod skin y 7.3: clearance 0.50 mm nominal, 0.35 with pocket float
[PASS] case cell swell (6.3 max +10 %): pocket 7.2 - 6.93 - foam solid 0.24 = +0.03
[PASS] case cell footprint (max): x 12.6-39.6 in -0.2-41.2, w 25.5 in 26.4
[PASS] hall closed: magnet 1.49 mm beside, face 1.40 mm above the die: |Bz| 88 mT vs BOP max 4.8 mT x2
[PASS] magnet pocket vs pod pocket: cradle wall between them 0.50 mm
    lid  10 deg:   8.4 mm,  3.882 mT (on-axis bound)
    lid  20 deg:  15.1 mm,  0.784 mT (on-axis bound)
    lid  30 deg:  21.6 mm,  0.280 mT (on-axis bound)
    lid 100 deg:  60.6 mm,  0.014 mT (on-axis bound)
[PASS] hall open (lid 100 deg): 0.014 mT vs BRP min 0.5 mT

    lid at  10 deg: overlap 0.0000 mm3
    lid at  30 deg: overlap 0.0000 mm3
    lid at  60 deg: overlap 0.0000 mm3
    lid at  90 deg: overlap 0.0000 mm3
    lid at 110 deg: overlap 0.0000 mm3
[PASS] lid swing 10-110 deg: max overlap 0.0000 mm3 with base, cradle and pod

Case outer: 44.4 x 29.4 x 19.9 mm (hinge knuckles add 1.5 mm)

FAILED: none
