Het-Bhavsar/Atrium/docs/open-items.md

# Open items

The engineering questions still open on the EVT pod and charging case, with where each one is closed. Status as of 2026-11-11; close each item with its source (datasheet section or measurement).

Build-specific items (B-1 to B-10) are in [build-assembly-test.md](build-assembly-test.md). `[VERIFY]` in any doc marks a value that is not yet confirmed.

## Datasheet checks before schematic freeze

| # | Item | Where to check |
|---|---|---|
| O-1 | Closed 2026-11-11: the radio island matches Nordic's CIAA WLCSP DC/DC reference part for part: C3 1.0 pF shunt on the ANT ball, L3 3.3 nH series, C6 100 pF on DEC3, C7 100 pF on DEC2 (A2, which the reference does decouple), C4 100 nF on DEC1, C9 1.0 µF on DEC4, L1 10 µH and L2 15 nH, C8 4.7 µF at A7, C5 100 nF at H7, C1 / C2 12 pF for the 8 pF crystal. Only case sizes differ: C9 is 0201 (0402 in the reference) and C8 is 0201 (0603), so C8 keeps less of its 4.7 µF under bias [VERIFY on the first pod: VDD ripple in radio TX] | nRF52832 PS, Reference circuitry, Figure 5 and Table 5; CIAA reference layout 1.0 schematic |
| O-2 | Closed 2026-11-11: TI says "if LDO is not used, short to VINLS" and gives VINLS at least 1 µF. The board ties LS/LDO (ball D4) to VINLS (E4) with C56 1 µF. NC1 (C3) may float. NC2 (C4) is "connect to ground if possible"; it is left open, as on TI's EVM, where it only goes to a header. LP (D3) is tied low on purpose: the charger then answers on I²C only with VIN present, and the firmware talks to it only when docked (`firmware/README.md`, cut-off row) | TI SLUSDU0A Table 5-1; BQ21061EVM user guide SLUUC59 |
| O-3 | Closed 2026-11-11: ICHG_CTRL is 0x13 and resets to 0x08, which is 10 mA (1.25 mA per code while ICHARGE_RANGE, PCHRGCTRL 0x14 bit 7, is 0). Ship mode is ICCTRL0 0x35 bit 7 and takes effect when VIN goes away. The 50 s I²C watchdog returns the charger registers to reset unless the host keeps talking. The firmware writes ICHG at every dock and services the watchdog every 10 s | TI SLUSDU0A Tables 7-20, 7-21 and 7-29, section 7.3.2.2 |
| O-4 | Closed 2026-11-11: overcharge 4.25 / 4.30 / 4.35 V (release 4.10 V), overdischarge 2.7 / 2.8 / 2.9 V (release 3.0 V), discharge over-current 0.9 A typical, short circuit 10 A, RDS(on) 55 mΩ at 3.6 V. Keep the BQ21061 at its 4.20 V regulation: the AP6683 can trip from 4.25 V | ALLPOWER AP6683 data sheet (LCSC C2849565), page 3 |
| O-5 | MAXM86161A INTB polarity (open-drain; the data sheet does not state the level). PART_ID is 0x36 in both the MAXM86161 and MAXM86161A data sheets | Bring-up: scope INTB on the first pod |
| O-6 | Closed 2026-11-11: COUT 1 µF nominal with 0.5 µF effective as the stability minimum; no input capacitor is needed below 0.5 Ω of source impedance, and C51 22 µF is beside U13. C63 and C21 are 1 µF 6.3 V X5R 0201 (GRM033R60J105KEA2D) at 1.8 V [VERIFY with Murata's DC-bias data that at least 0.5 µF is left; a 1 µF 0402 is the fallback] | TI SBVS277C section 6.3 and section 8.1 |
| O-7 | Closed 2026-11-11: in every Kinghelm layout the pad nearest the feed line is the feed and the far pad has no ground. The board matches: pad 2 is the feed, pad 1 is unconnected (O-48). Layouts 2 and 3 also run a floating copper extension from the far pad (a 2.0 × 0.7 mm strip to the board edge; an L-shaped trace of about 4.5 + 2 mm that stays 0.5 mm clear of ground); layout 1 has none, and neither has ours, since the 1.36 mm-wide zone has no room for one (O-13). Our clearance is smaller than Kinghelm's 5 × 3 to 5.5 × 4 mm, as known; the match is tuned on the VNA (O-13) | Kinghelm KH-1608-H08 specification V1.0, pages 4 to 6 |
| O-8 | Closed 2026-11-08: JLC06081H-2313 6-layer 0.82 mm, CPWG 0.124 mm / 0.127 mm gap (JLC impedance calculator) | – |
| O-9 | JLC flex: adhesiveless option, 1/3 oz Cu, PI 12.5 µm, ENIG on both sides, PI stiffener | JLC FPC capabilities |
| O-10 | Zephyr: `st,lsm6dso` binding properties for the LSM6DSOX; MLC via ST's tools | The Zephyr version you build with |

## Added by the 2026-11-07 review

| # | Item | Where to check |
|---|---|---|
| O-22 | Closed 2026-11-11: pinout 1 VDD, 2 and 3 GND (cell negative), 4 VM (pack negative), plus the exposed pad; it matches the board. The data sheet's application circuit takes VDD straight from the cell, and its evaluation board uses 1 k / 0.1 µF; R51 330 Ω and C55 100 nF stay (about 0.2 mV of error at 0.7 µA). Thresholds in O-4 | ALLPOWER AP6683 data sheet, pages 2, 3, 5 and 11 |
| O-23 | Closed 2026-11-11: body 1.70 ± 0.20 × 0.93 ± 0.20 × 0.75 ± 0.20 mm; land pattern and pads in O-50 | Kinghelm KH-1608-H08 specification V1.0, pages 2 and 6 |
| O-24 | Closed 2026-11-11: C23733 is Samsung CL05A475MP5NRNC, 4.7 µF 10 V X5R 0402 (better than the 6.3 V part first assumed); a JLC basic part | LCSC C23733 |
| O-25 | JLC FPC minimum static bend radius for 1-layer adhesiveless PI (bend zones r about 0.41–0.43 mm, about 5.8 × t) | JLC FPC capabilities |
| O-26 | Closed 2026-11-11 for the PCB. The supplier publishes no drawing. Its two photos show the 400909 with a protection board folded along one 9 mm edge and two nickel tabs, about 1.3 mm wide, about 4.5 mm apart and centred on that edge. The power island's BT1 / BT2 pads (1.0 × 1.2 mm, 4.6 mm apart, centred on the cell) match within what a photo can show. The photo also gives the tolerances: 9 ± 1 mm wide and long, 4.0 ± 0.2 mm thick. A cell at +1 mm would not fit the 9.3 mm bay, so the order must ask for at most 9.2 mm (O-11). Order the cells to our drawing: tabs 4.6 mm apart, centred, positive tab on the BT1 side (B-3) | Supplier listing photos, 2026-11-11; B-3 |
| O-27 | ~~Zirconia coupon on the VNA~~: the production shell is now PC with NCVM, see O-36 (zirconia only for a premium edition) | VNA |
| O-28 | Plinth magnet pull on the 0.1 mm SUS430 stiffener against two pogos at ≤ 0.3 N each | Bench |
| O-29 | Closed 2026-11-11: the library footprint (0.60 × 1.15 mm pads at 1.512 mm pitch) is replaced by Kinghelm's land pattern (O-50) | Kinghelm KH-1608-H08 specification V1.0, page 6 |
| O-30 | Closed 2026-11-10: the radio island is routed with DRC 0 (O-45, O-47); nothing is added on it for EVT | Layout |
| O-31 | Closed 2026-11-11: our pads are exactly ADI's land pattern: 14 pads 0.660 × 0.400 mm, 0.600 mm pitch, columns 1.900 mm apart (±0.95), rows over 3.600 mm. Package 2.9 × 4.3 × 1.4 mm, terminals 0.40 × 0.60 mm. Keep copper and vias away from the two Ø0.1 mm features near pins 7 and 8 (they have no pads) | ADI 21-100309 rev B and 90-100106 rev A |
| O-32 | 6-layer HDI 1+4+1 (JLC06081H-2313, 0.82 mm): buried-via and lamination fees are "manual quote" on the order page. Confirm the stacked L1–L5 skip via (laser on buried) and filled via-in-pad on the WLCSP / DSBGA with JLC engineering before ordering. JLC's HDI FAQ (2026-11-09) treats a skip via as a blind via and splits it into a laser via stacked on a mechanical buried via in production, so the single 0.10 mm L1–L5 and L2–L6 holes in the drill files are the expected data. The buried part needs a pad 0.15 mm larger than its hole: with the 0.25 mm inner pads it has to be drilled at 0.10 mm, which JLC lists as extreme capability for a buried span of up to 1.0 mm (about 0.69 mm here). Confirm that with JLC engineering, or grow the inner pads to 0.30 mm for a standard 0.15 mm buried drill | JLC order page / engineering |
| O-33 | Closed 2026-11-11, accepted for EVT. Nordic's CIAA reference layout (its Gerbers) uses 0.193 mm round ball pads, a 0.345 mm mask opening (not solder-mask-defined) and 1:1 paste. Ours: 0.170 mm pads (15 of the 50 also carry the 0.25 mm microvia pad), 0.272 mm mask openings, not solder-mask-defined, and 0.21 mm paste. Nordic staff on DevZone give 0.14 to 0.20 mm as fine and endorse filled, capped via-in-pad. X-ray the first panel (B-2). For DVT: 0.19 mm pads to match the reference | nRF52832-CIAA reference layout 1.0 Gerbers; nRF52832 PS v1.9 Table 2 (ball 0.20 mm); Nordic DevZone 11290, 92252, 104232 |
| O-45 | Part spacing on the islands (2026-11-10 ECO). Pad-to-pad gaps under 0.15 mm went from 20 to 11 on the radio island and from 8 to 4 on the power island; DRC stays at 0. What is left has no legal move inside the outline: the RF match (C3, C42, Z41, ANT1: 0.107–0.132 mm, kept short on purpose), parts held by the board edge (C8–C9 0.090, C4–C9 0.095, R11–TH4 0.105, C30–L1 0.108, C10–R3 0.112, C12–C30 0.130, C53–R51 0.145) and passives next to fine-pitch ICs (C9–U1 0.109, C60–U11 0.103, C53–U10 0.109, C56–U10 0.132). JLC recommends 0.15 mm between 0201/0402 parts and 1.0 mm from a chip to a QFN or BGA. For EVT: tell the assembler, check these spots with AOI and X-ray on the first panel, and keep the 0.08 mm stencil. For DVT: grow the islands or move parts so every passive is at least 0.30 mm from a fine-pitch IC | First panel AOI / X-ray; DVT layout |
| O-47 | Blind-via clearance to the routed edge. JLC's HDI rules ask for 0.35 mm from a blind or skip via's hole edge to the routed edge. The 2026-11-10 change moved 12 of the 14 vias that were closer (8 on the radio island, 4 on the power island, and all 20 copies on the panel); DRC stays at 0 on both islands and the panel. Two remain on the radio island: the DEC1 microvia in U1's outer ball column (0.291 mm; the ball pads sit 0.34 mm from the edge, so only moving U1 about 0.07 mm inward clears it) and the GND microvia in pad JR3 (0.289 mm; no spot in that pad keeps the 0.15 mm via spacing to the TH4_SENSE, TH1_SENSE and DCC vias, although JLC's own spacing rules would allow (14.27, 5.29)). For EVT: ask JLC engineering to accept both. For DVT: move U1 inward | JLC engineering; DVT layout |
| O-48 | Closed 2026-11-10, pin-by-pin datasheet review before fabrication. Three faults fixed: (a) radio island RF match: C3 1.0 pF now shunts the ANT ball node to ground and L3 3.3 nH follows it, as in the nRF52832 CIAA DC/DC reference (PS v1.8, section 53.5, Figure 175); the board had L3 first. C3, L3 and C42 swapped lands, so only C3 pin 1 changed net (RF_50R to ANT_NRF). (b) ANT1 pin 1 (far end) is no longer tied to GND: none of the Kinghelm KH-1608-H08 layouts grounds it (spec V1.0 p5-6). (c) Charging case R19 is fitted, 330k (C25778): the HAL248 output is open drain (Hallwee V3.3 p4) and the firmware reads the lid pin without a pull-up. Radio island DRC 0 after the change; same edits on all 20 panel copies. (d) Flex JP6 (GND) had no copper path to the flex ground (only through the power island), so a bare-board test against the flex netlist would fail; a bottom track now ties it to the ground pour | nRF52832 PS, Kinghelm spec, Hallwee data sheet |
| O-49 | Closed 2026-11-10, follow-up to the O-48 review. (a) Power island C50 (VIN) and C52 (CELL_P) were 1 uF 0201s, which keep well under the BQ21061's 1 uF effective minimum at 4.35-5.3 V DC bias; both are now 10 uF 10 V 0402 (CL05A106MP5NUNC, C315248), about 2.0 uF at 5.3 V and 2.5 uF at 4.35 V on Samsung's curves. C50 keeps its spot on the top; C52 is now vertical on the bottom between the clamp band and R51, and the through GND via under its old spot moved to (3.20, 1.62). All 20 panel copies carry the same change. (b) Case VBUS had no surge clamp: D4 TSD05DYFR (C22396185) now sits from VBUS to GND beside C1. (c) Case USB detect: D1 leaks up to about 60 uA at 70 C back into VBUS while the boost runs, which lifted VBUS_DET above VIL through the 100k R4; R3 and R4 are now 2.2k (C25879): 0.13 V with USB out, 2.3-2.8 V with it in. (d) Crystal C0: NDK's specification for the NX1612SA 32 MHz 8 pF (EXS00A-CS14160) gives C0 0.54 pF and ESR 60 ohm max, inside Nordic's 100 ohm limit for C0 <= 3 pF; the crystal stays (confirm the STD-CIS-3 suffix with NDK). (e) Case U6 DIR floated until firmware set PC7: R25 100k (C25741) now holds it low (pod to MCU) from power-up. Schematics, boards, panel and every export were redone; DRC 0 on both islands and the panel; on the case, DRC lists only J1's own pads to its own slots (0.171 mm against 0.2 mm), inside the vendor footprint and unchanged | Samsung CL05A106MP5NUNC DC-bias curve, TI TSD05 data sheet, 1N5819WS leakage curve, NDK EXS00A-CS14160, TI SN74LVC1T45 data sheet |
| O-50 | Closed 2026-11-11, antenna land pattern. ANT1 now uses Kinghelm's footprint: 0.70 × 0.90 mm pads at 1.875 mm pitch (1.175 mm gap under the body), same centre (19.40, 5.50). It was 0.60 × 1.15 mm at 1.512 mm, which put copper 0.13 mm further under the body. The pads end 0.27 mm from the board edge (was 0.20 mm). The feed from Z41 is one straight 50 Ω line into pad 2. The top keep-out keeps one notch, for that feed only, so ground stops at x 18.76 mm all along the antenna zone. The feed-end silk dot moved 0.19 mm outward, clear of the larger pad opening. All 20 panel copies carry the same change; DRC 0 on the radio island and the panel. Return loss is still tuned on the VNA (O-13) | Kinghelm KH-1608-H08 specification V1.0, page 6 |

## EVT measurements

| # | Item | Pass criteria |
|---|---|---|
| O-11 | 10 × 400909 cells: dimensions and capacity at 0.2 C | All ≤ 9.2 × 9.2 × 4.05 mm; capacity known (the power budget assumes 30 mAh × 80 %) |
| O-12 | Contact pads in artificial sweat (ISO 3160-2), 72 h worn | No visible corrosion, < 1 µA leakage |
| O-13 | Antenna: S11 with shell, cell and head (or phantom); tune the pi-match. Expect the resonance above 2.45 GHz (estimate): our copper-free zone is about 1.36 × 5.6 mm, half of Kinghelm's smallest layout (5 × 3 mm), and pad 1 has no tuning extension, which Kinghelm adds in that layout (O-7). The match brings the impedance to 50 Ω but cannot recover efficiency lost far off resonance; if the radiated check (O-14) falls short, DVT widens the zone and adds a floating extension on pad 1 as in Kinghelm's layout 3 | ≤ −10 dB across 2402–2480 MHz |
| O-14 | OTA RSSI at 1 / 3 / 5 m, phone in hand / front pocket / back pocket | Compare with the link budget in `hardware/simulation/` |
| O-15 | Average current with a PPK2 in each mode | Compare with the power budget in `hardware/simulation/` (189 µA typical) |
| O-16 | VLED headroom: lowest VSYS at which the green PPG SNR holds | Sets the firmware optical cut-off (placeholder 3.3 V) |
| O-17 | NTC accuracy against a reference thermometer, 20–45 °C | ±0.3 °C after the R–T table replaces the beta LUT |
| O-18 | HRV against a chest-strap ECG: 25 sps with interpolation vs 100 sps windows | RMSSD bias < 3 ms at rest |
| O-19 | Skin pad wear: 5–10 people, desk day, run, shower, side-sleep; days per pad (1–2 estimated), edge lift, removal comfort | No lift-off within a day; no irritation |
| O-20 | ~~Skin cradle retention~~: superseded by the skin pad (2026-11-07) | – |
| O-21 | Swell: 300 cycles, measure cell growth | ≤ 0.2 mm (the swell gap) |
| O-43 | MAXM86161A optics, first pods (no recording exists yet): (a) green DC per mA and perfusion on 10 people across skin types at 5, 10 and 15 mA, and whether DC is linear in current; (b) dark noise in counts at each ADC range (4, 8, 16, 32 µA), LEDs off; (c) IR and red DC at 10 mA on light skin at the 16 µA range (saturation; the optics model's IR efficiency is under the data sheet's); (d) green Vf at 5–15 mA (with O-16); (e) whether a LEDx_PA write while sampling glitches the FIFO | Sets whether a green trim ships, with its target and floor, and whether the ADC range changes. Until then the LED currents stay at the mode table (`hardware/simulation/ppg_optics.md`) |
| O-44 | Firmware update on the first pods, with the app: (a) the MCUmgr image list is readable right after the slot swap, so the app can wait for the image to be confirmed (60 s) before it reports done; (b) an upload cut part-way resumes, or restarts cleanly, when the same image (same hash) is sent again; (c) the swap time for a 214 KB image (the app waits 10 s before reconnecting) | The app's update flow finishes with the version and the confirmed state checked, and a bad image reverts by itself (`docs/ble_gatt.md` §9) |
| O-34 | Skin pad tape: double-coated medical, opaque skin-tone, about 0.15 mm total (the bed depth follows the tape) | 3M / Solventum data sheets; converter |
| O-35 | Pad converter: die-cut registration ≤ 0.10 mm so the pad lands in the bed off the card | Converter sample |
| O-36 | NCVM silver shell: antenna return loss and efficiency, bare vs coated shell; re-tune the match if it moves | VNA, with O-13 |
| O-37 | Shell rim hardcoat on skin: ISO 10993-5/-10, or mask the rim during NCVM | Coating supplier |
| O-38 | Board clamp vs island thickness 0.82 ± 0.10 mm: the ribs and posts are rigid, so a 0.92 mm board meets 0.10 mm of interference and a 0.72 mm board rattles. Options: a compliant pad on each rib tip (for example 0.2 mm silicone foam at 25–75 % compression) or crush bumps. 2026-11-08: solder-mask openings were added on both islands, both sides, at the clamp bands, which takes the nominal crush from 0.024 mm toward 0 [VERIFY on a measured board; the board STEP still exports a single 0.844 mm slab] | First PCB lot, calipers |
| O-39 | Closed 2026-11-08: the flex fab outline is the flat pattern, with the lands moved 0.47 mm (power) and 0.51 mm (radio) outboard to give each S-bend its bend allowance; the mechanical fit check passes | – |
| O-46 | Case thermistor TH2 (BQ24040 TS): its courtyard is 0.100 mm from the deck, exactly at the 0.1 mm minimum (case fit report, 2026-11-10), and it sits on the board 3.0 mm from U2, above the cell rather than on it. Check the deck clears it on the first printed case, and log TH2 against a thermocouple taped to the cell while charging at 200 mA from 20 °C and 40 °C ambient; if the cell runs more than 3 °C above TH2, shift the JEITA window or move TH2 | First case build, thermocouple |
| O-40 | Charging case: measure the KP-502030 (thickness, lead exit and gauge, PCM; the CAD reserves 5.0 mm and runs the leads to holes at (−15.5, ±2.0)); pick the SMD pogo (free 3.25, 1.0 stroke, ≤ 0.3 N at 0.68); the lid foam (1.0 thick, 1.5–2.7 N at 25 %); HAL248 operate point vs about 18 mT; SKSCLAE010 stem centre height and width (the CAD assumes 0.6 / 1.2); USB-C C2765186 STEP vs the 17.99 mouth; and whether a 0.2 mm recessed 2.8 × 1.4 mm cap is pressable with a fingertip (print it) | Sharvi sample, pogo and foam data sheets |
| O-41 | Closed 2026-11-10: U3 is now the MAXM86161AEFD+T (LCSC C54021201), the active code. Its data sheet (19-102034 Rev 1) against the MAXM86161 (19-100523 Rev 1): same package outline 21-100309 and land pattern 90-100106, same 14-pin pinout, same register map, PART_ID 0x36 and 128-word FIFO, so the footprint and driver are unchanged. Only the LEDs differ: green 70 mW at 175 mA (was 25 mW at 150 mA) with Vf 3.1 V typ, 3.4 V max (was 3.35 / 3.8 V); red 11 mW at 20 mA (was 9 mW), Vf 2.4 V max (was 2.5 V); infrared unchanged. JLC had none in stock on 2026-11-10, so the order goes through JLC parts sourcing. The old MAXM86161EFD+T fits the same board. | Data sheet comparison; first A-code part on the bench |
| O-42 | Closed 2026-11-09: version text on the bottom silkscreen, 1.0 mm characters: `ATRIUM EVT v0.1.0 2026-11` on the charging-case board and `EVT v0.1` on the flex (inside every pod). The radio and power islands have no clear strip for text of a legible size (the largest fits 0.55 mm characters), so the pod is marked through its flex. DRC unchanged apart from the known accepted items | – |
