Het-Bhavsar/Atrium/hardware/pod/flex-jumper/pcb/Atrium_Flex_Jumper_PCB.pdf

No. | Quantity | Comment | Designator | Footprint | Value | Manufacturer Part
Manufacturer | Supplier Part | Supplier
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
