Het-Bhavsar/Atrium/app/README.md

# App

<p align="center">
  Five app screens: Welcome, Today, Heart, Sleep, Trends
</p>

<p align="center">
  Setup screens: pairing, placement, signal check, device and skin pad
  <br><sub>Screens from the demo build, with sample data. The photographs in the app are illustrations.</sub>
</p>

| Folder | Contents |
|---|---|
| `android-ios/` | The Atrium phone app (Flutter, Android and iOS): pairing, fit guide, daily views, sync and pod updates. Build and run steps are in its README |

Prebuilt Android APKs are on the [Releases page](https://github.com/Het-Bhavsar/Atrium/releases/latest). Licence:
Apache-2.0 (see `LICENSE`).

## Every screen

From the demo build on an iPhone 17 Pro simulator.

<table>
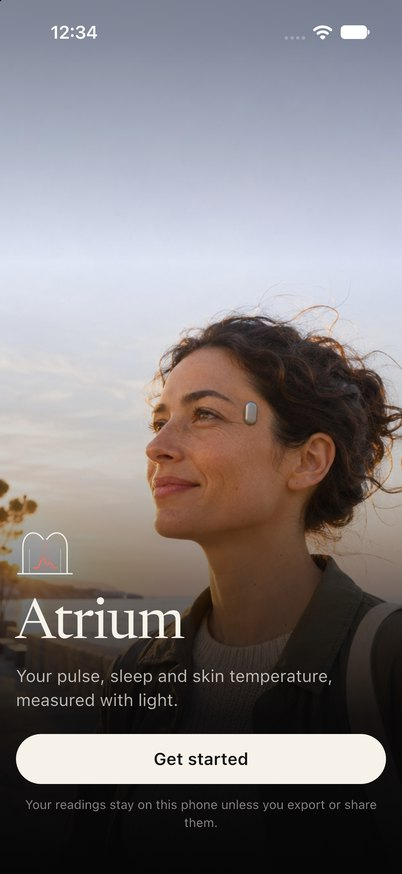
[picture p50: docs/images/app/screen_welcome.jpg]
Welcome screen
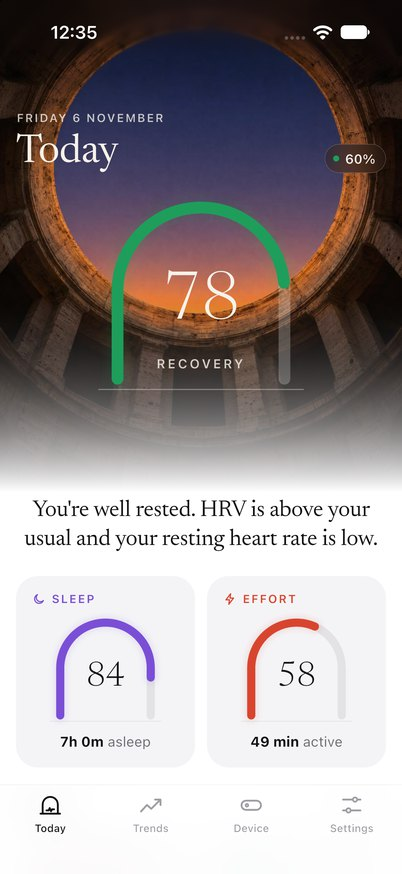
[picture p51: docs/images/app/screen_today.jpg]
Today screen
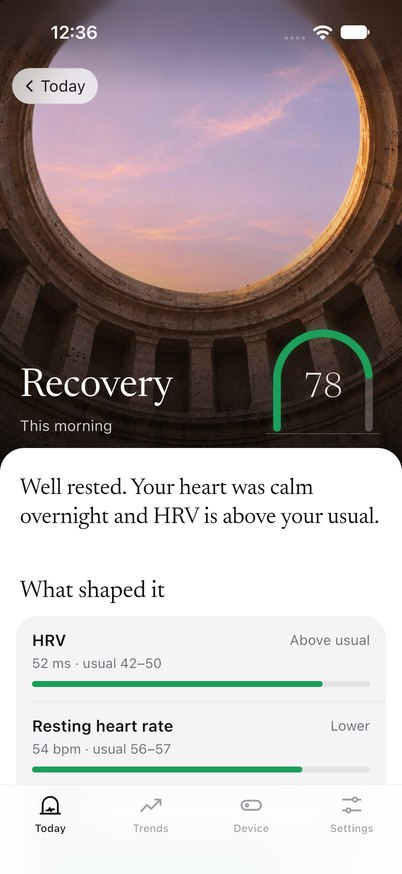
[picture p52: docs/images/app/screen_recovery.jpg]
Recovery screen
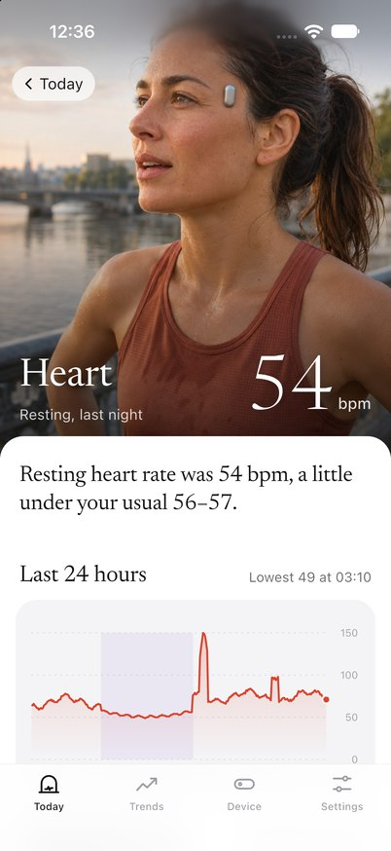
[picture p53: docs/images/app/screen_heart.jpg]
Heart screen
<tr><td align="center"><br><sub>Welcome</sub></td><td align="center"><br><sub>Today</sub></td><td align="center"><br><sub>Recovery</sub></td><td align="center"><br><sub>Heart</sub></td></tr>
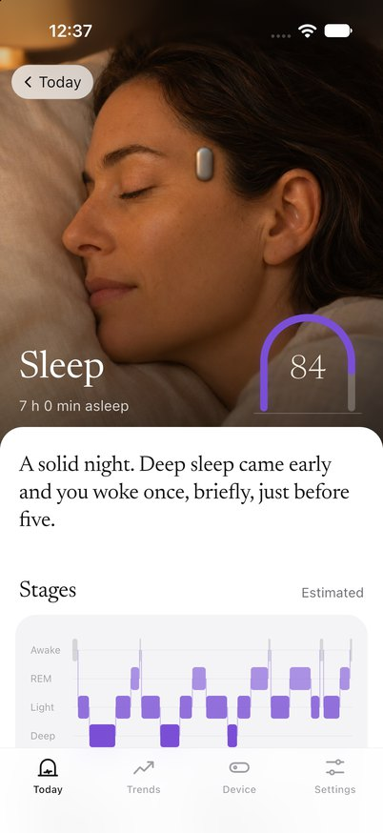
[picture p54: docs/images/app/screen_sleep.jpg]
Sleep screen
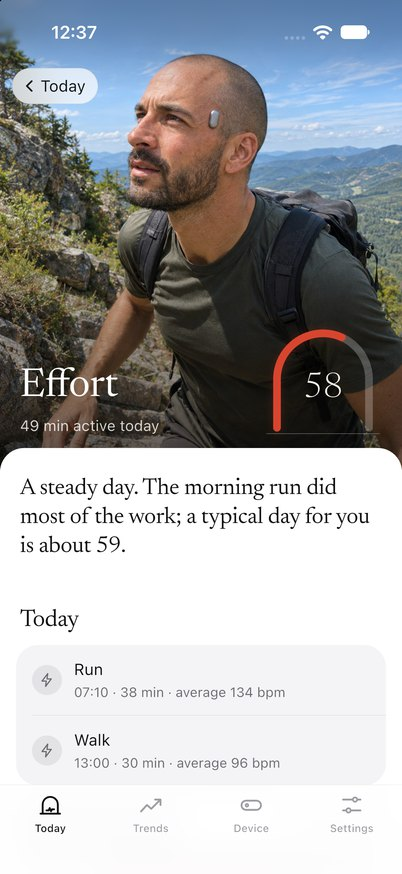
[picture p55: docs/images/app/screen_effort.jpg]
Effort screen
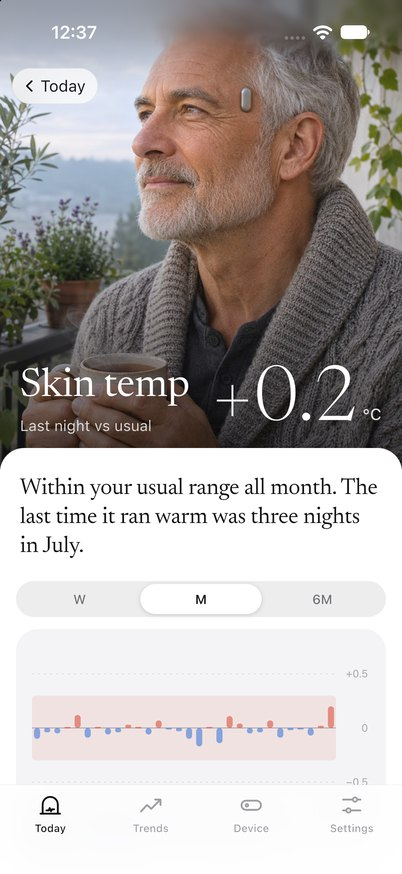
[picture p56: docs/images/app/screen_temp.jpg]
Skin temperature screen
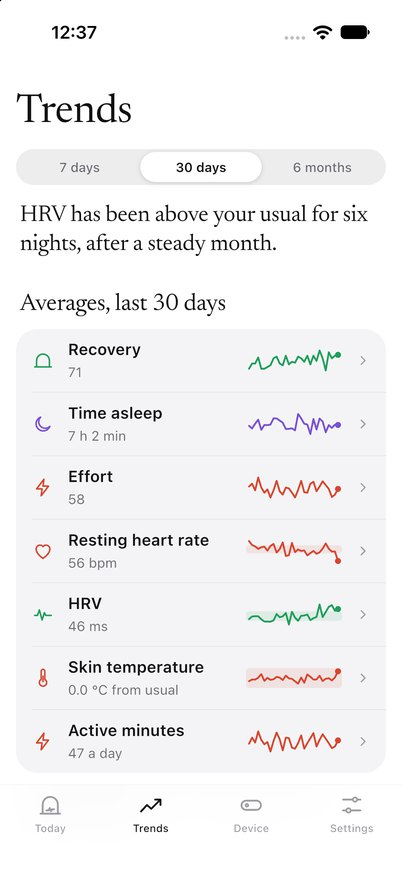
[picture p57: docs/images/app/screen_trends.jpg]
Trends screen
<tr><td align="center"><br><sub>Sleep</sub></td><td align="center"><br><sub>Effort</sub></td><td align="center"><br><sub>Skin temperature</sub></td><td align="center"><br><sub>Trends</sub></td></tr>
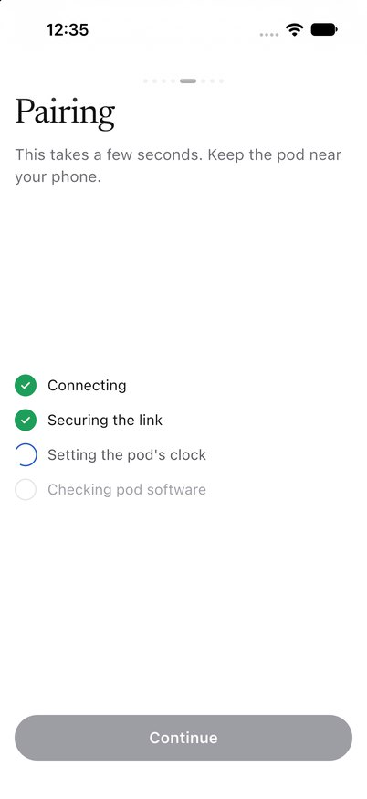
[picture p58: docs/images/app/screen_pair.jpg]
Pairing screen
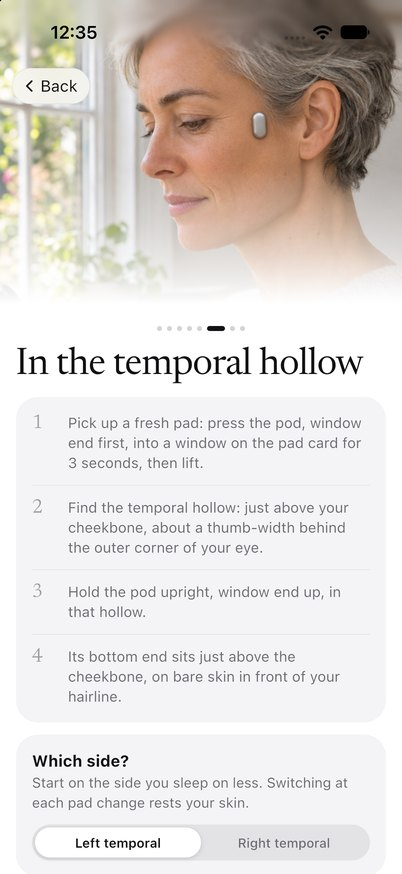
[picture p59: docs/images/app/screen_place-noglasses.jpg]
Placement screen
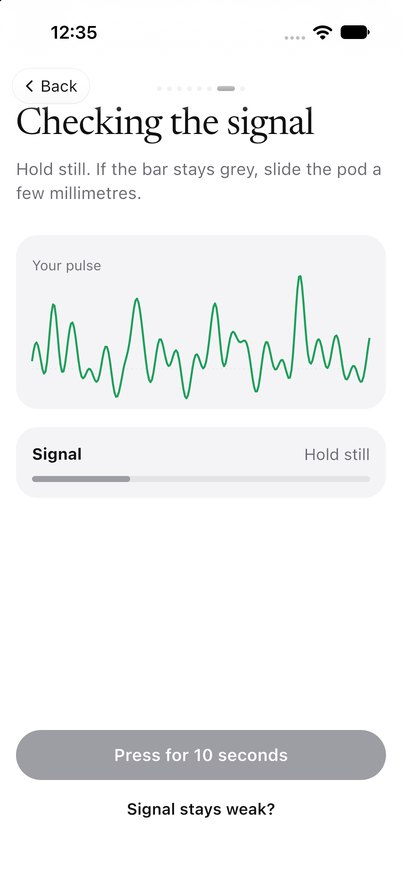
[picture p60: docs/images/app/screen_signal.jpg]
Signal check screen
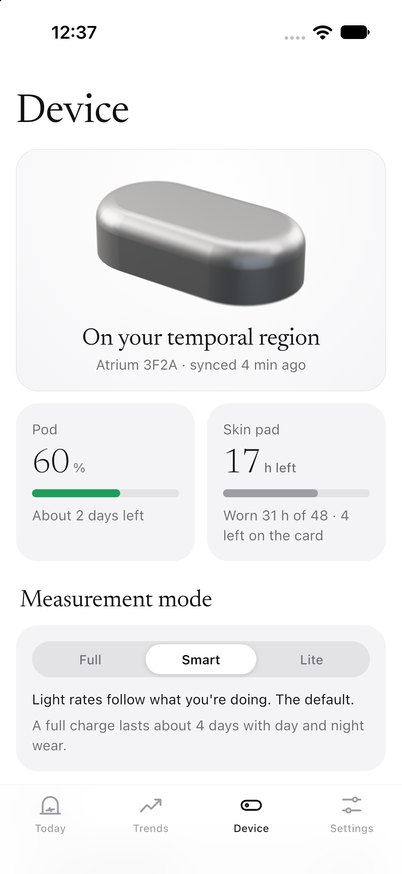
[picture p61: docs/images/app/screen_device.jpg]
Device screen
<tr><td align="center"><br><sub>Pairing</sub></td><td align="center"><br><sub>Placement</sub></td><td align="center"><br><sub>Signal check</sub></td><td align="center"><br><sub>Device</sub></td></tr>
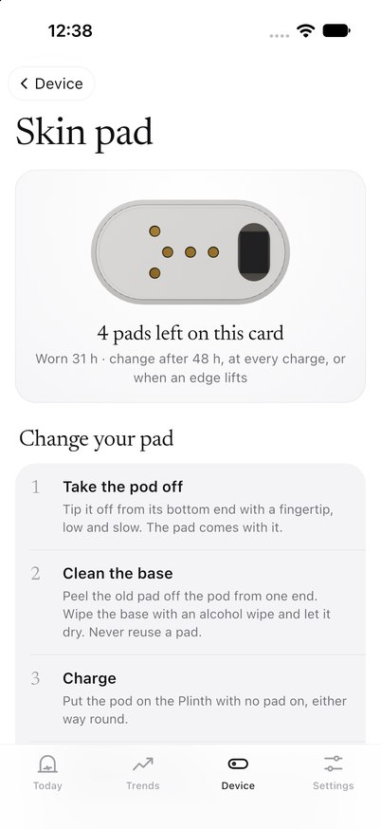
[picture p62: docs/images/app/screen_pad.jpg]
Skin pad screen
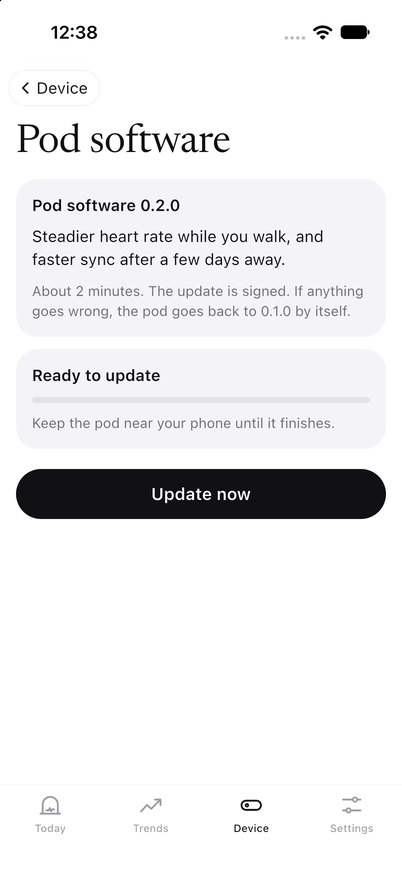
[picture p63: docs/images/app/screen_fw.jpg]
Pod software screen
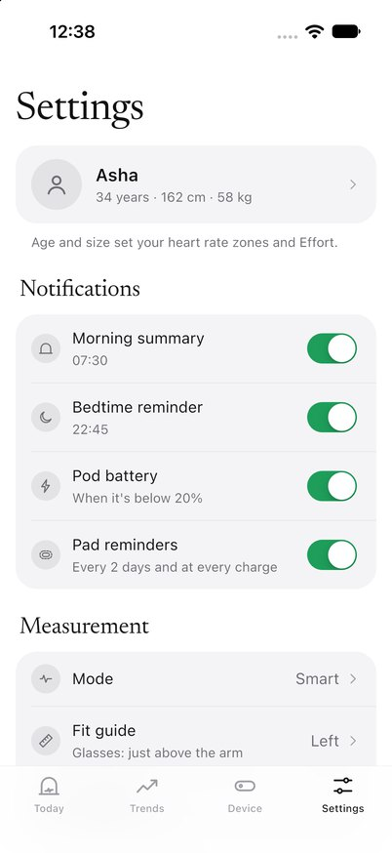
[picture p64: docs/images/app/screen_settings.jpg]
Settings screen
<tr><td align="center"><br><sub>Skin pad</sub></td><td align="center"><br><sub>Pod software</sub></td><td align="center"><br><sub>Settings</sub></td></tr>
</table>
