Het-Bhavsar/Atrium/hardware/pod/radio-island/pcb/Atrium_Radio_Island_PCB.pdf

No. | Quantity | Comment | Designator | Footprint | Value | Manufacturer Part | Manufacturer | Supplier Part | Supplier
1 | 1 | KH-1608-H0 8 | ANT1 | ANT-SMD_L 1.7-W0.9 | | KH-1608-H0 8 | kinghelm( 金 ) 航标 | C2925416 | LCSC
2 | 2 | 12pF | C1,C2 | C0201 | 12pF | GRM0335C1 H120GA01D | muRata(村田 ) | C161404 | LCSC
3 | 1 | 1pF | C3 | C0201 | 1pF | GJM0335C1 H1R0BB01D | muRata(村田 ) | C237514 | LCSC
4 | 3 | 100nF | C4,C5,C12 | C0201 | 100nF | GRM033R60 J104KE19D | muRata(村田 ) | C76928 | LCSC
5 | 2 | 100pF | C6,C7 | C0201 | 100pF | 0201CG101J 500NT | FH(风华 ) | C62550 | LCSC
6 | 1 | 4.7uF | C8 | C0201 | 4.7uF | GRM035R60 J475ME15D | muRata(村田 ) | C335103 | LCSC
7 | 5 | 1uF | C9,C20,C21,C31,C32 | C0201 | 1uF | GRM033R60 J105KEA2D | muRata(村田 ) | C76929 | LCSC
8 | 1 | 10uF | C30 | C0402 | 10uF | CL05A106M Q5NUNC | SAMSUNG( 三星 ) | C15525 | LCSC
9 | 1 | 10uH | L1 | L0603 | 10uH | LQM18DN10 0M70L | muRata(村田 ) | C713281 | LCSC
10 | 1 | 15nH | L2 | L0402-R-RD | 15nH | VHF100505H Q15NJT | FH(风华 ) | C395049 | LCSC
11 | 1 | 3.3nH | L3 | L0201-RD | 3.3nH | LQP03TN3N 3B02D | muRata(村田 ) | C98045 | LCSC
12 | 2 | 4.7k | R1,R2 | R0201 | 4.7k | RC0201FR-0 74K7L | YAGEO(国巨 ) | C138135 | LCSC
13 | 1 | 100k | R3 | R0201 | 100k | 0201WMF10 03TEE | UNI-ROYAL( 厚声 ) | C270364 | LCSC
14 | 2 | 1M | R5,R41 | R0201 | 1M | RC0201FR-0 71ML | YAGEO(国巨 ) | C295786 | LCSC
15 | 2 | 10k | R10,R11 | R0201 | 10k | RT0201BRD 0710KL | YAGEO(国巨 ) | C852211 | LCSC
16 | 1 | 2.2M | R40 | R0201 | 2.2M | RC0201FR-0 72M2L | YAGEO(国巨 ) | C474576 | LCSC
17 | 2 | NCP03XH10 3F05RL | TH1,TH4 | R0201 | 10K | NCP03XH10 3F05RL | muRata(村田 ) | C98098 | LCSC
18 | 1 | NRF52832-C IAA-G-R7 | U1 | WLCSP-50_ L3.2-W3.0-T L_NRF52832 | | NRF52832-C IAA-G-R7 | NORDIC | C3606951 | LCSC
19 | 1 | TPS7A0218P YCHR | U2 | WLCSP-4_L 0.6-W0.6-P0. 35-R2-C2-TL | | TPS7A0218P YCHR | TI(德州仪器 ) | C3752366 | LCSC
20 | 1 | MAXM86161 AEFD+T | U3 | OLGA-14_L4 .3-W2.9-P0.6 0-TL | | MAXM86161 AEFD+T | Analog Devices | C54021201 | LCSC
21 | 1 | - | Y1 | CRYSTAL-S MD_4P-L1.6-W1.2-BL | - NX1612SA-3 | 2MHZ-STD-CIS-3 | NDK | C910049 | LCSC

22

1

0 | Z41 | R0201
0 | 0201WMF00
00TEE

UNI-ROYAL(
厚声

)

C473473 LCSC
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
