Het-Bhavsar/Atrium/hardware/pod/power-island/pcb/Atrium_Power_Island_PCB.pdf

No. | Quantity | Comment | Designator | Footprint | Value | Manufacturer Part | Manufacturer | Supplier Part | Supplier
1 | 2 | 10uF | C50,C52 | C0402 | 10uF | CL05A106M P5NUNC | SAMSUNG( ) 三星 | C315248 | LCSC
2 | 1 | 22uF | C51 | C0402 | 22uF | GRM155R60 J226ME11D | muRata(村田 ) | C415703 | LCSC
3 | 1 | 4.7uF | C53 | C0402 | 4.7uF | CL05A475M P5NRNC | SAMSUNG( 三星 ) | C23733 | LCSC
4 | 2 | 100nF | C55,C60 | C0201 | 100nF | GRM033R60 J104KE19D | muRata(村田 ) | C76928 | LCSC
5 | 2 | 1uF | C56,C63 | C0201 | 1uF | GRM033R60 J105KEA2D | muRata(村田 ) | C76929 | LCSC
6 | 3 | ESD5V3U04-0201 | D10,D12,D13 | X3-DFN0603 -2_L0.6-W0.3 -RD | | ESD5V3U04-0201 | TECH PUBLI C(台舟 ) | C521889 | LCSC
7 | 1 | 10k | R50 | R0201 | 10k | 0201WMF10 02TEE | UNI-ROYAL( ) 厚声 | C473048 | LCSC
8 | 1 | 330 | R51 | R0201 | 330 | RC0201FR-0 7330RL | YAGEO(国巨 ) | C274872 | LCSC
9 | 1 | NCP03XH10 3F05RL | TH5 | R0201 | 10K | NCP03XH10 3F05RL | muRata(村田 ) | C98098 | LCSC
10 | 1 | BQ21061YF PR | U10 | DSBGA-20_L 2.0-W1.6-R4-C5-P0.40-BL -1 | | BQ21061YF PR | TI(德州仪器 ) | C2869893 | LCSC
11 | 1 | LSM6DSOXT R | U11 | LGA-14L_L3. 0-W2.5-P0.5 0-TL | | LSM6DSOXT R | ST(意法半导 体) | C481766 | LCSC
12 | 1 | AP6683 | U12 | DFN-4_L1.0-W1.0-P0.65-BL-EP | | AP6683 | ALLPOWER( 铨力 ) | C2849565 | LCSC
13 | 1 | TPS7A0218P YCHR | U13 | WLCSP-4_L 0.6-W0.6-P0. 35-R2-C2-TL | | TPS7A0218P YCHR | TI(德州仪器 ) | C3752366 | LCSC
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
