Het-Bhavsar/Atrium/legacy/concepts/README.md

# Concepts (not taken forward)

Studies made on the final EVT insides (20.9 × 11 × 5.3 mm), kept for reference.

| Item | What it showed | Outcome |
|---|---|---|
| `form-studies/form_study.png` | Out-of-the-box forms on the same insides: the capsule, Comet (round head, tapered tail), Hover (sloped ends) and Hover with a thumb-print dish | The capsule was chosen: flat top, R 1.8 round, one continuous side wall |
| `form-studies/pod_side.png`, `pod_in_skin.png` | Side profile, and the pod seated in an early skin carrier | The carrier gave way to the frame-and-bed base |
| `form-studies/case_button_options.png` | Charging-case button: a separate cap through a lip, or a flexure tab cut in the wall | The separate cap went into the EVT case |
| `skin-cradle/` | A soft cradle that held the pod on the skin (STEP, STL) | Replaced by a hidden 0.15 mm disposable pad in a 0.05 mm bed |
