Het-Bhavsar/Atrium/app/android-ios/assets/img/box-open.png

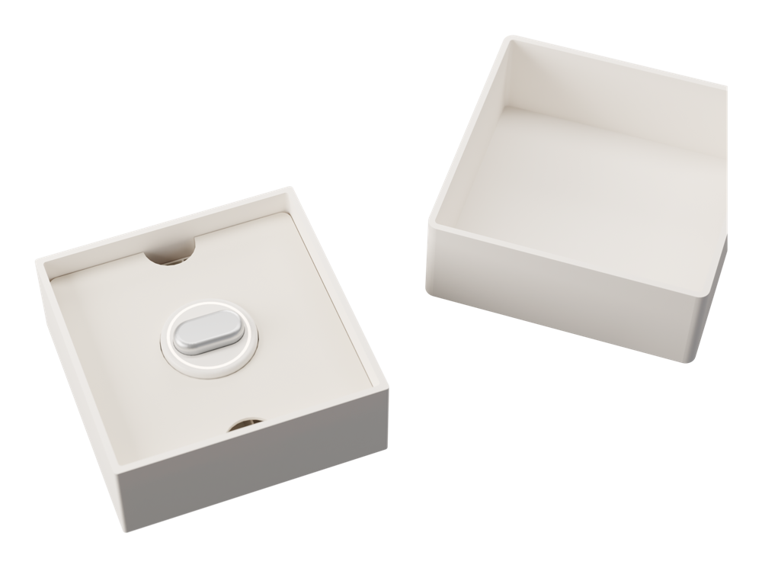
app/android-ios/assets/img/box-open.png
