Het-Bhavsar/Atrium/app/android-ios/assets/img/effort.jpg

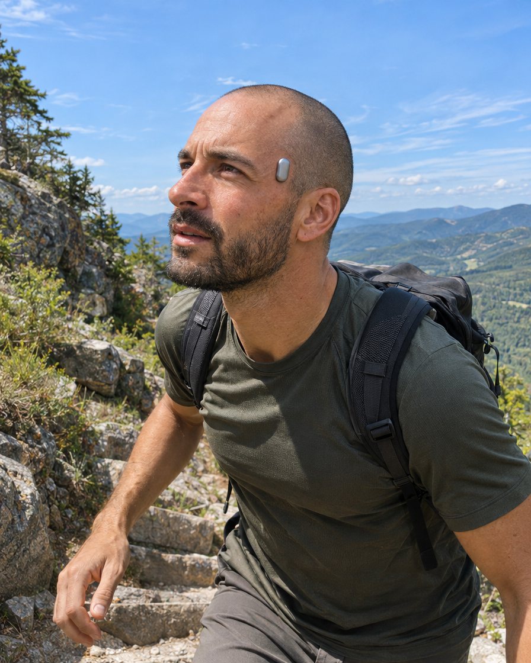
app/android-ios/assets/img/effort.jpg
