Het-Bhavsar/Atrium/app/android-ios/assets/img/fit-glasses.jpg

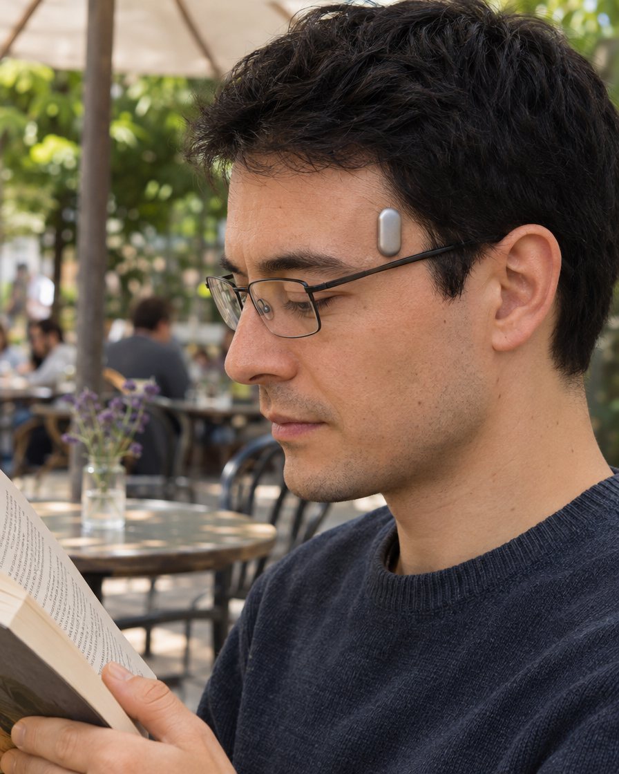
app/android-ios/assets/img/fit-glasses.jpg
