Het-Bhavsar/Atrium/app/android-ios/assets/img/fit-noglasses.jpg

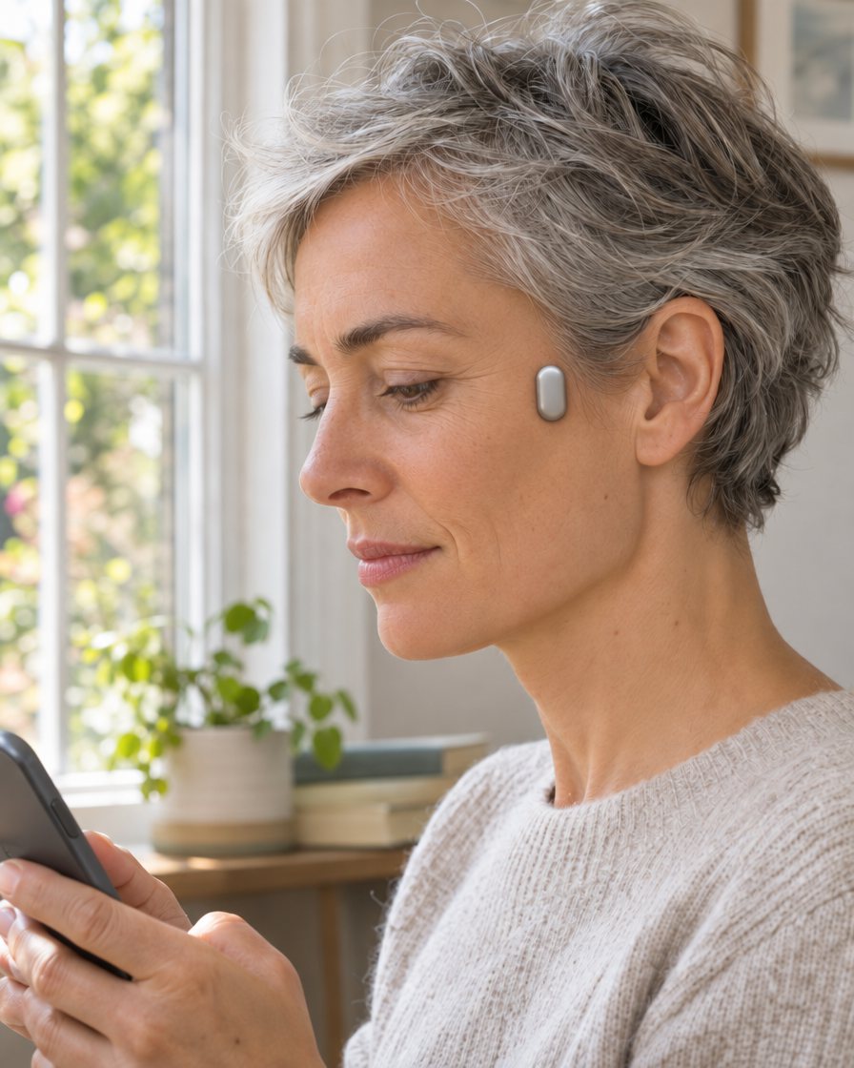
app/android-ios/assets/img/fit-noglasses.jpg
