Het-Bhavsar/Atrium/app/android-ios/assets/img/heart.jpg

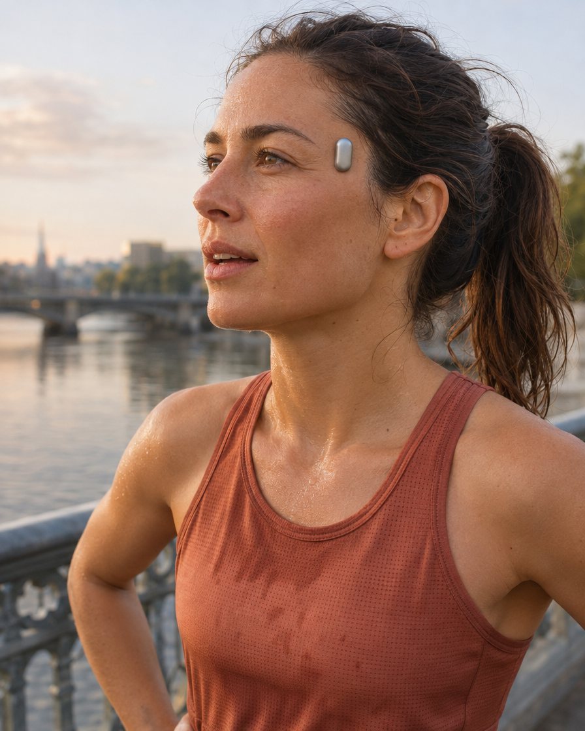
app/android-ios/assets/img/heart.jpg
