Het-Bhavsar/Atrium/app/android-ios/assets/img/local-forge.jpg

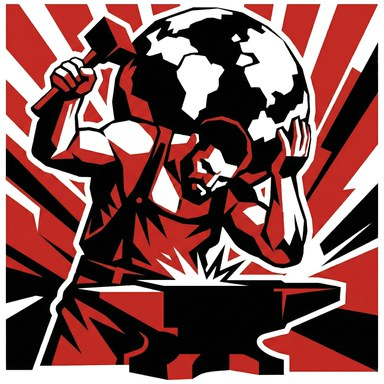
app/android-ios/assets/img/local-forge.jpg
