Het-Bhavsar/Atrium/app/android-ios/assets/img/pod-plinth.png

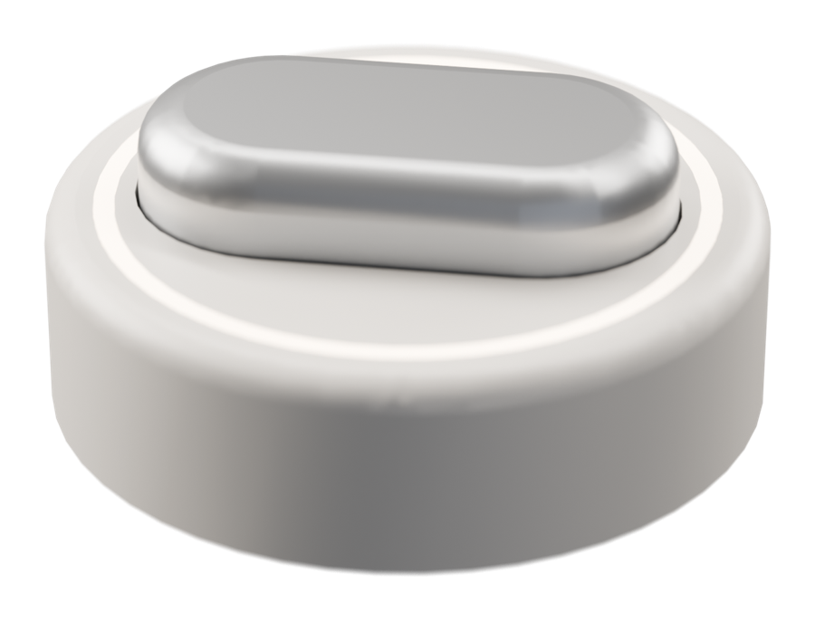
app/android-ios/assets/img/pod-plinth.png
