Het-Bhavsar/Atrium/app/android-ios/assets/img/pod-skin.png

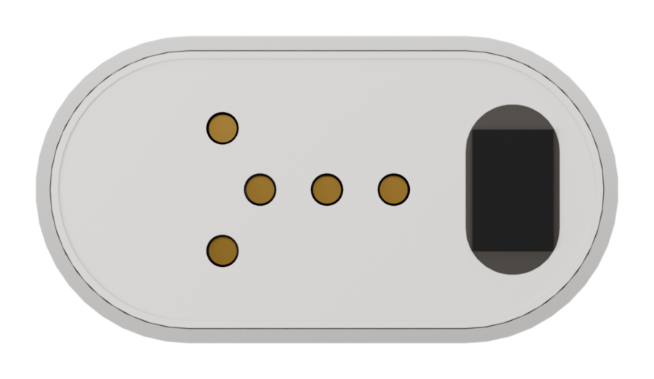
app/android-ios/assets/img/pod-skin.png
