Het-Bhavsar/Atrium/app/android-ios/assets/img/pod.png

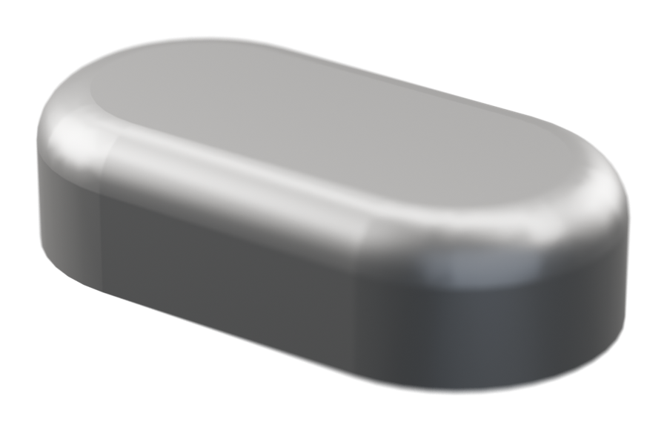
app/android-ios/assets/img/pod.png
