Het-Bhavsar/Atrium/app/android-ios/assets/img/sky-dawn.jpg

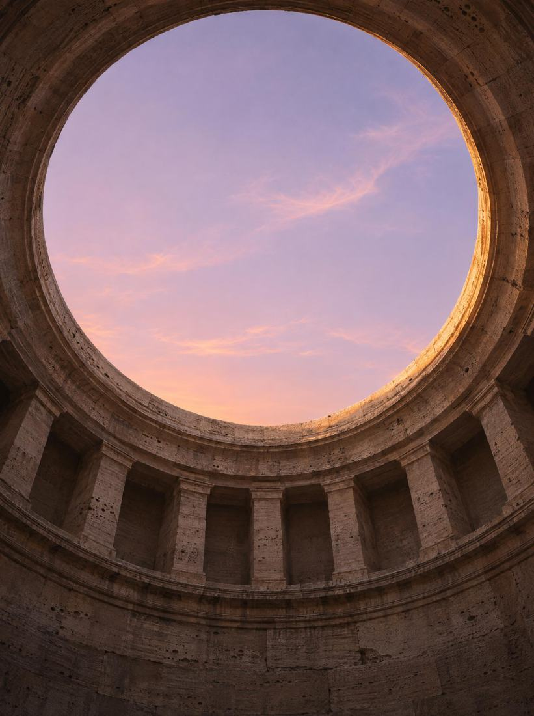
app/android-ios/assets/img/sky-dawn.jpg
