Het-Bhavsar/Atrium/app/android-ios/assets/img/sky-day.jpg

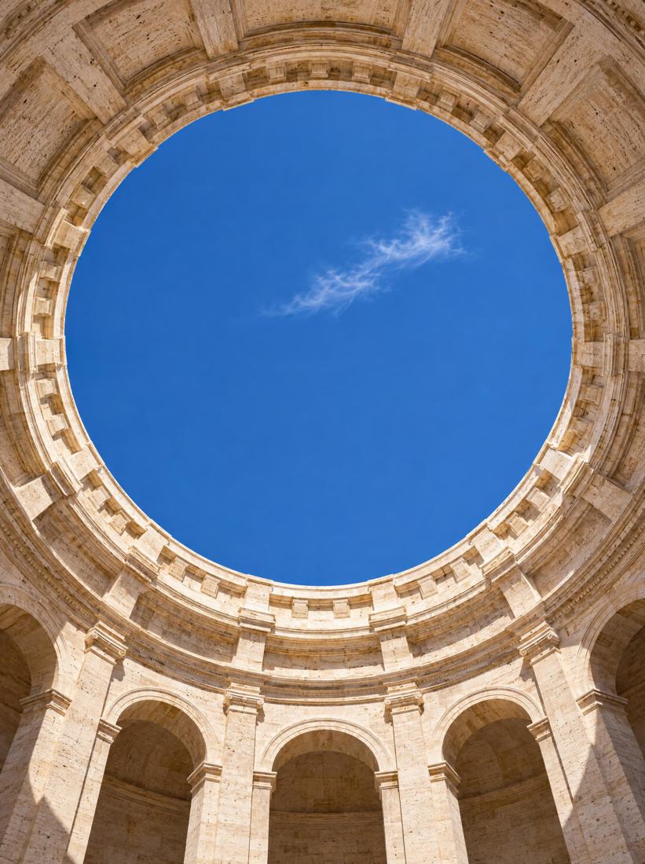
app/android-ios/assets/img/sky-day.jpg
