Het-Bhavsar/Atrium/app/android-ios/assets/img/sky-dusk.jpg

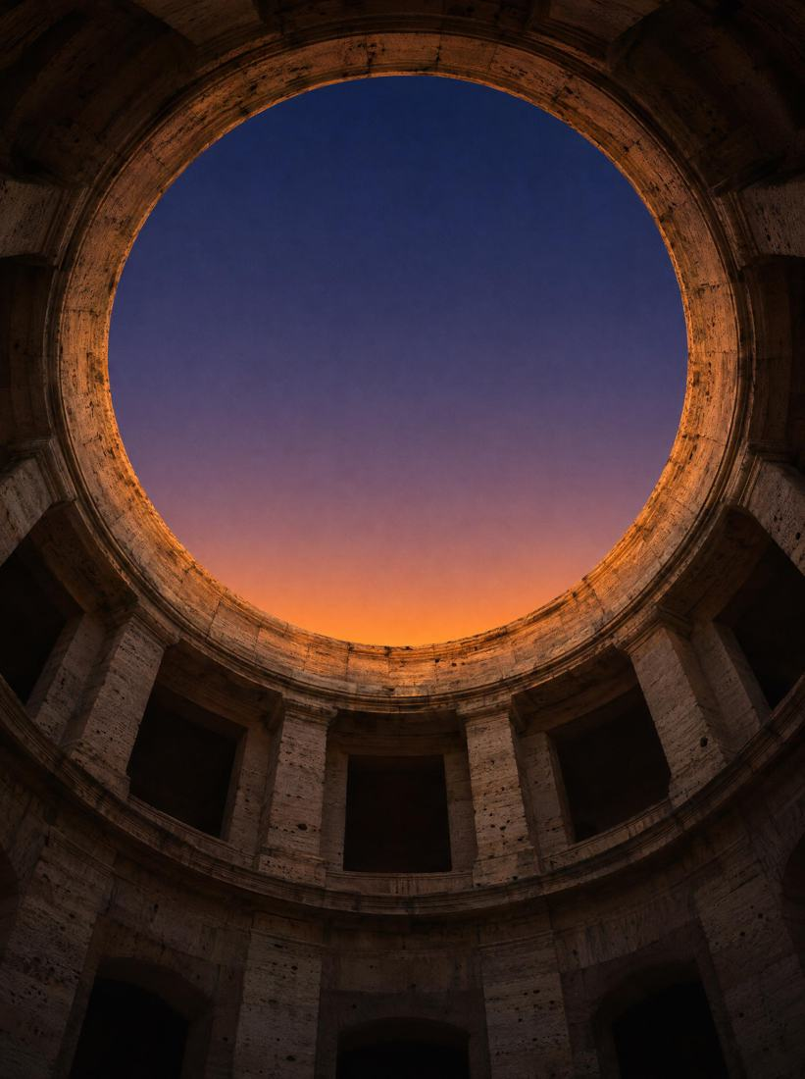
app/android-ios/assets/img/sky-dusk.jpg
