Het-Bhavsar/Atrium/app/android-ios/assets/img/sky-night.jpg

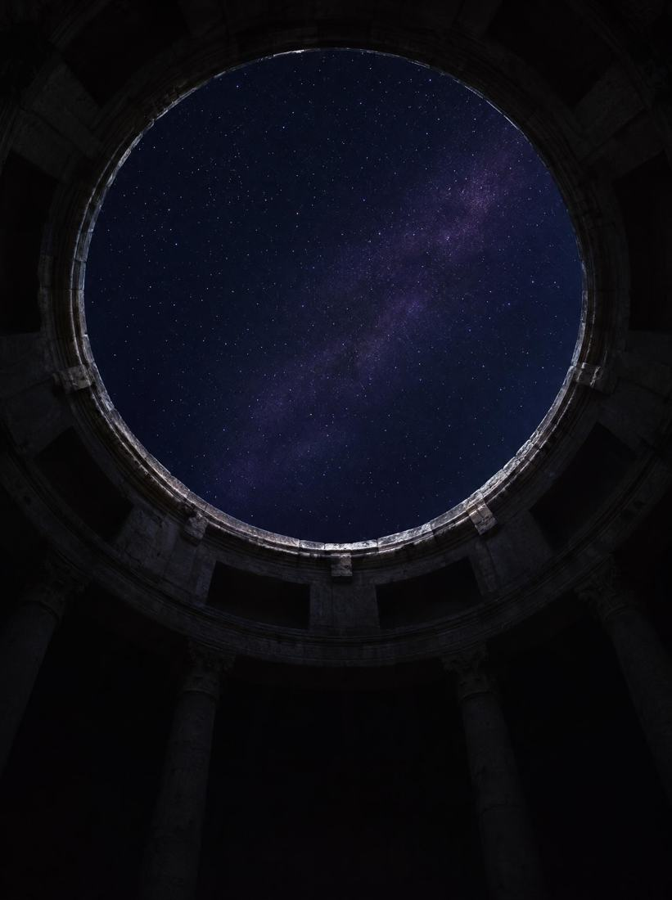
app/android-ios/assets/img/sky-night.jpg
