Het-Bhavsar/Atrium/app/android-ios/assets/img/sleep.jpg

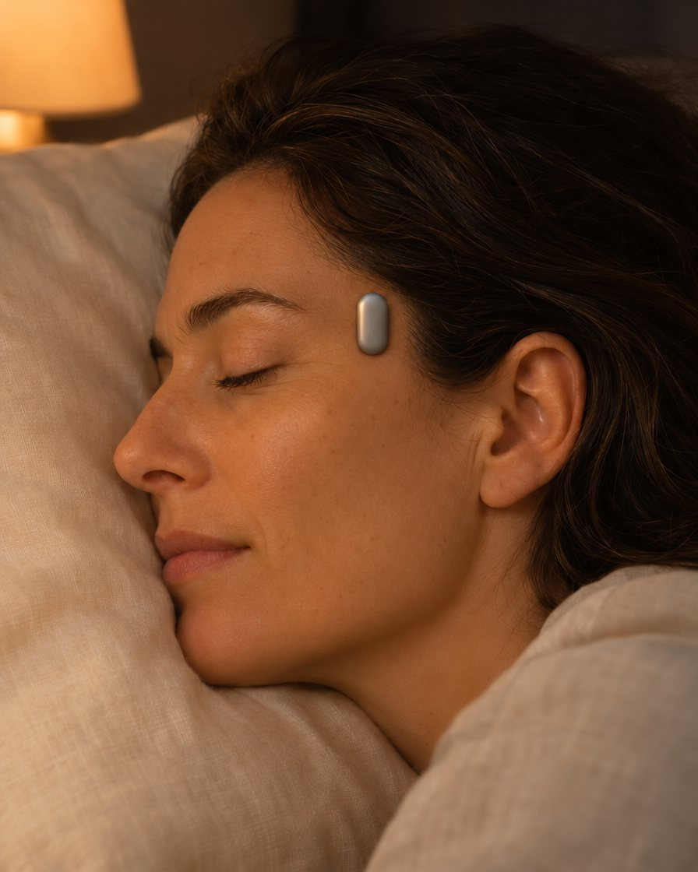
app/android-ios/assets/img/sleep.jpg
