Het-Bhavsar/Atrium/app/android-ios/assets/img/temp.jpg

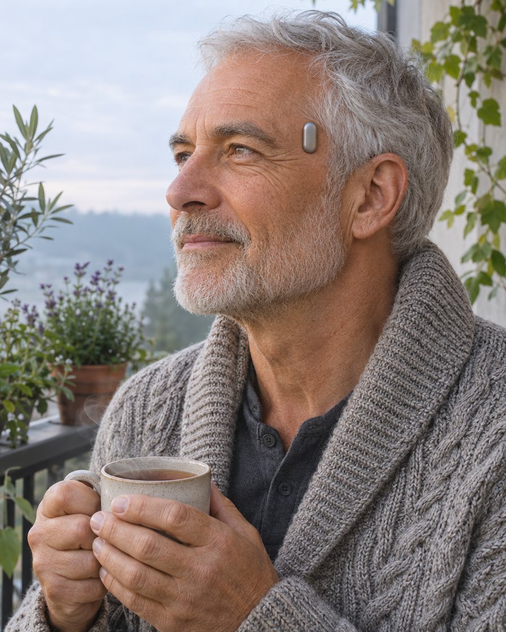
app/android-ios/assets/img/temp.jpg
