Het-Bhavsar/Atrium/app/android-ios/assets/img/welcome.jpg

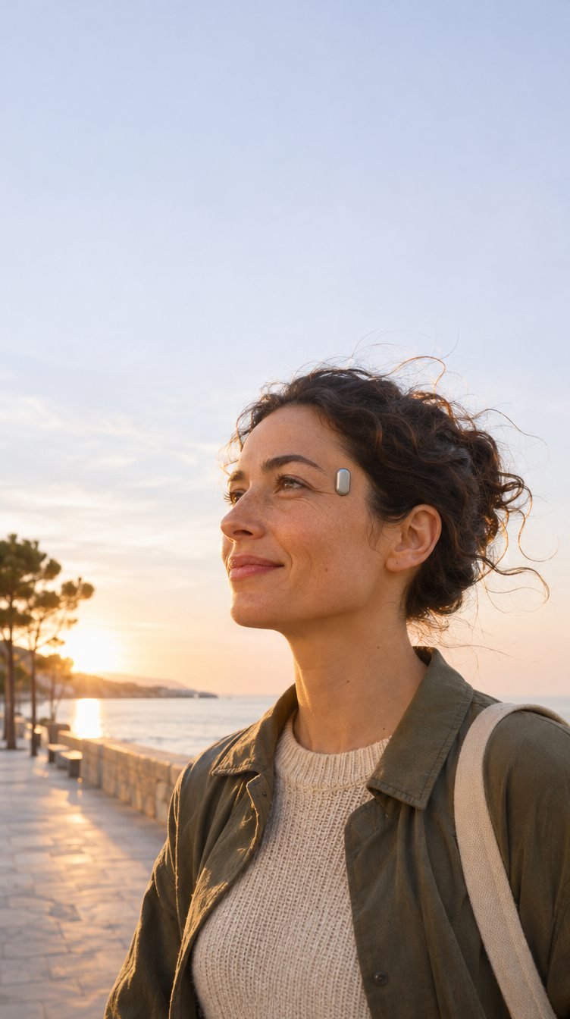
app/android-ios/assets/img/welcome.jpg
