Het-Bhavsar/Atrium/docs/images/renders/boards_dark.png

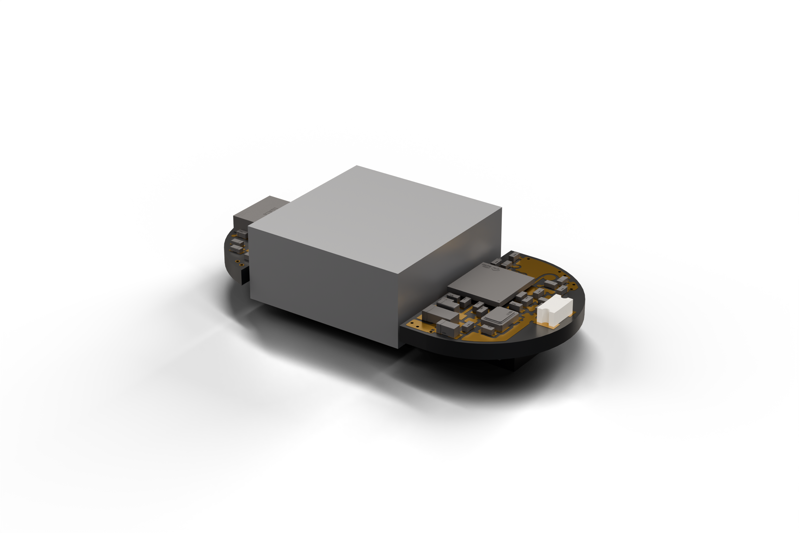
docs/images/renders/boards_dark.png
