Het-Bhavsar/Atrium/docs/images/renders/boards_open_dark.png

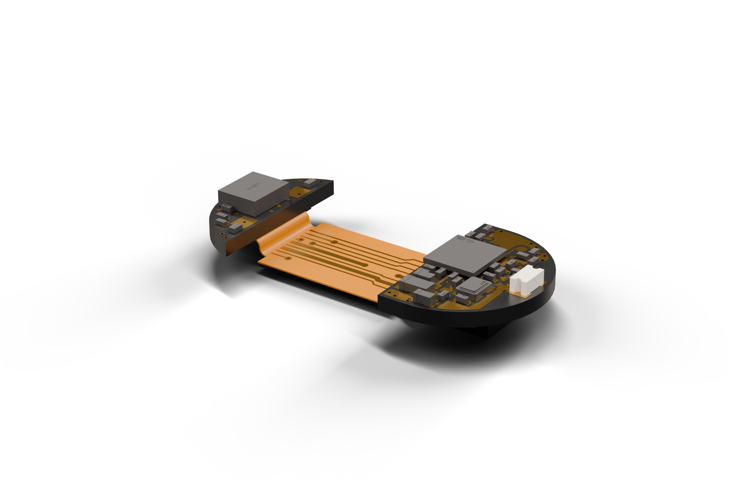
docs/images/renders/boards_open_dark.png
