Het-Bhavsar/Atrium/docs/images/renders/boards_top_dark.png

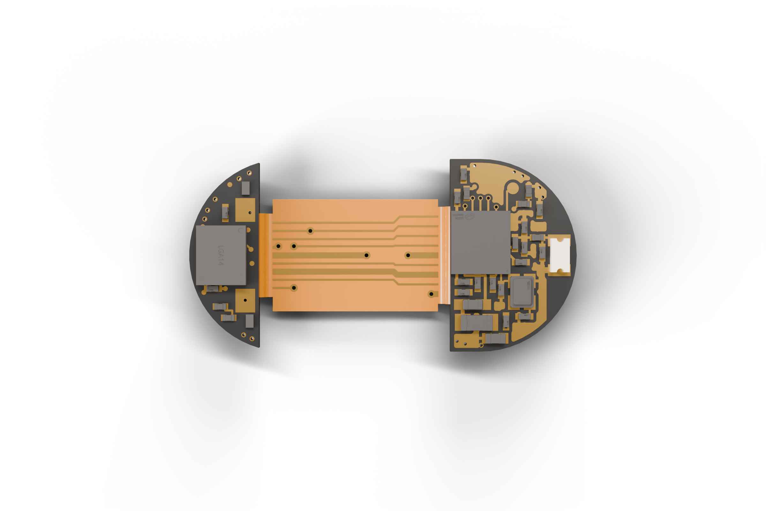
docs/images/renders/boards_top_dark.png
