Het-Bhavsar/Atrium/docs/images/renders/case_closed.png

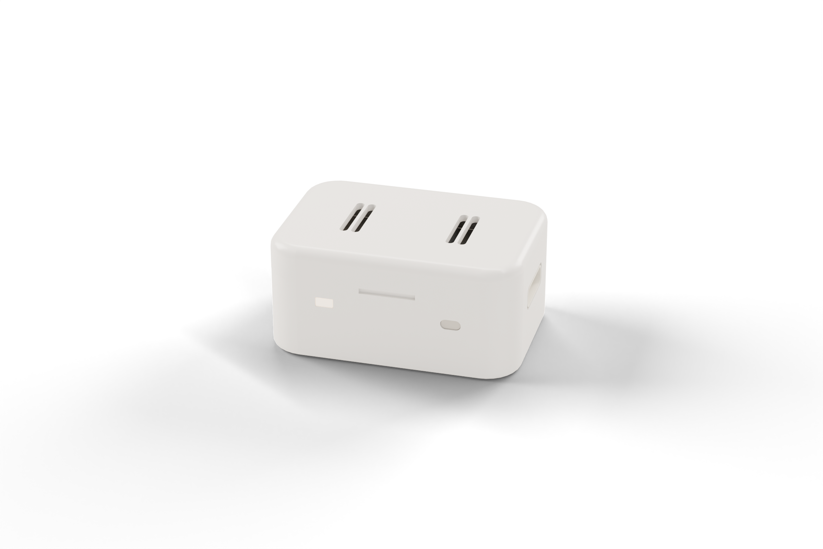
docs/images/renders/case_closed.png
