Het-Bhavsar/Atrium/docs/images/renders/case_open.png

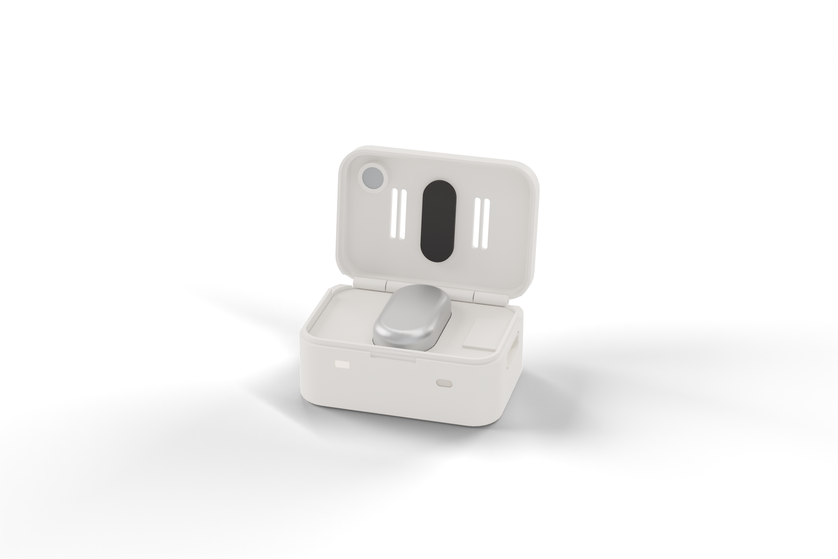
docs/images/renders/case_open.png
