Het-Bhavsar/Atrium/docs/images/renders/hero_dark.png

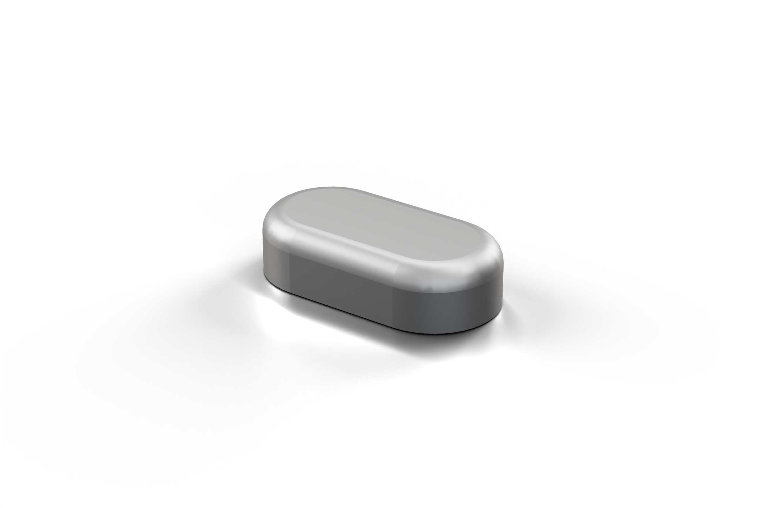
docs/images/renders/hero_dark.png
