Het-Bhavsar/Atrium/docs/images/renders/packaging.png

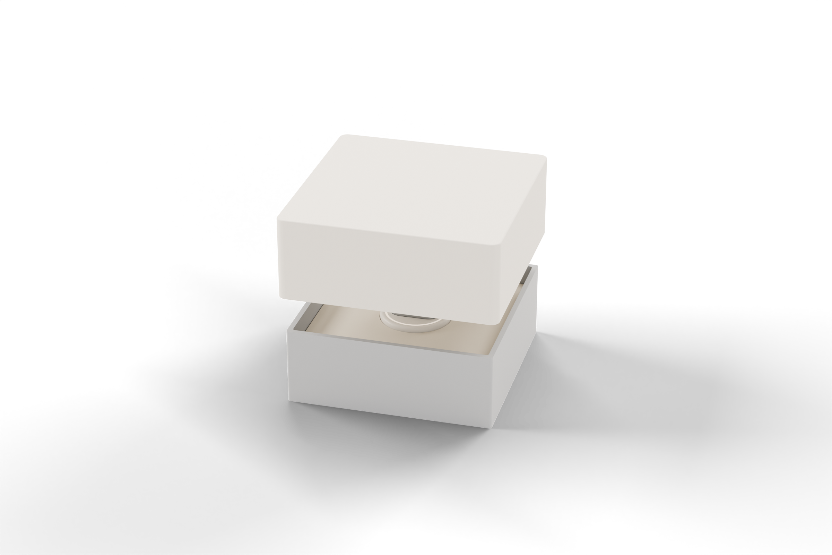
docs/images/renders/packaging.png
