Het-Bhavsar/Atrium/docs/images/renders/pad.png

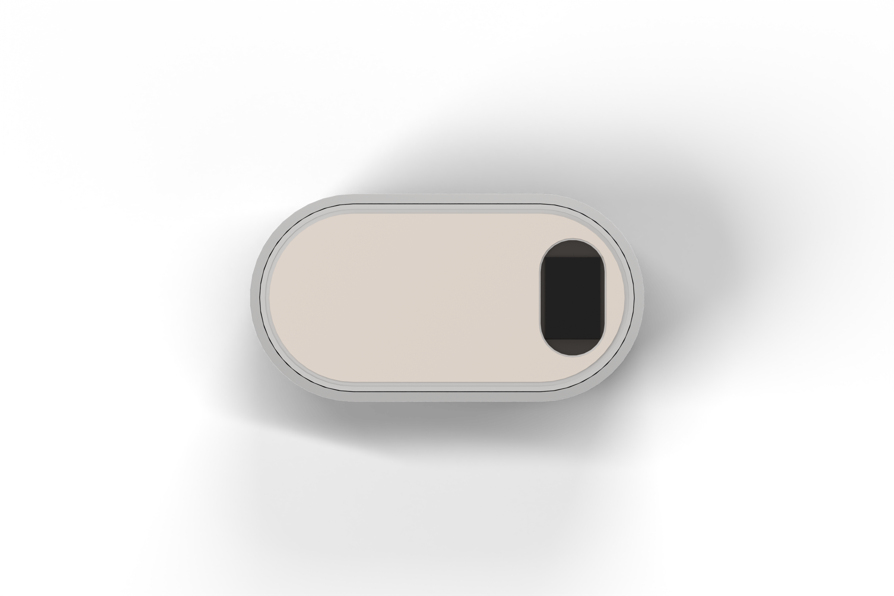
docs/images/renders/pad.png
