Het-Bhavsar/Atrium/docs/images/renders/plinth.png

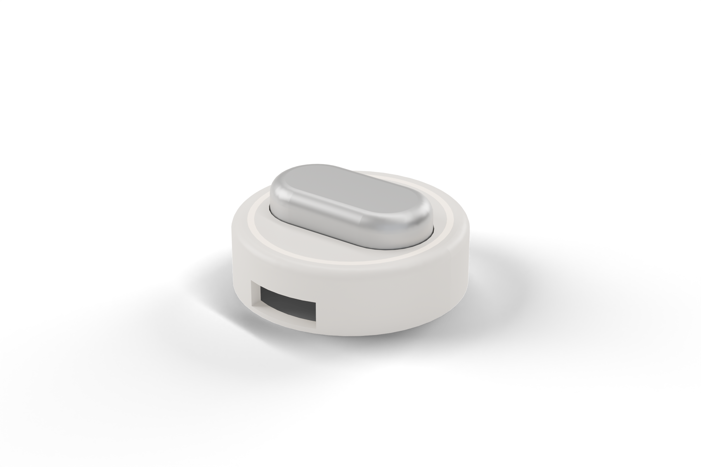
docs/images/renders/plinth.png
