Het-Bhavsar/Atrium/docs/images/renders/pod_low.png

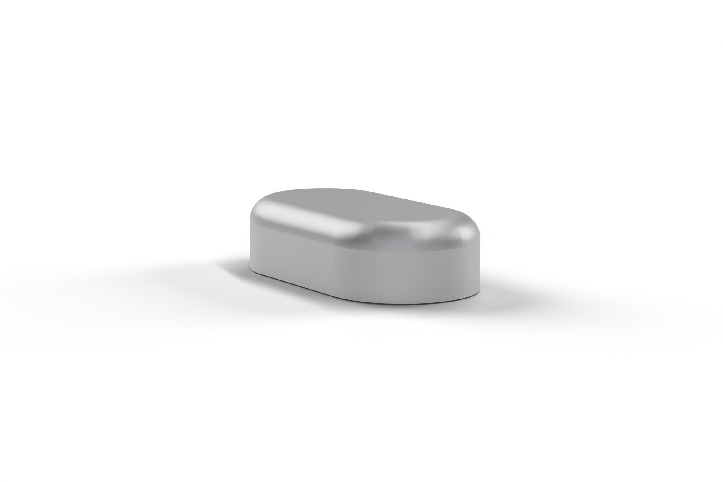
docs/images/renders/pod_low.png
