Het-Bhavsar/Atrium/docs/images/renders/pod_open.png

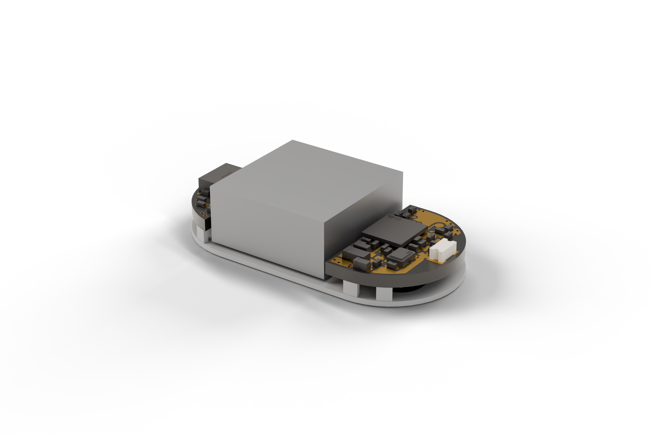
docs/images/renders/pod_open.png
