Het-Bhavsar/Atrium/docs/images/renders/pod_threequarter.png

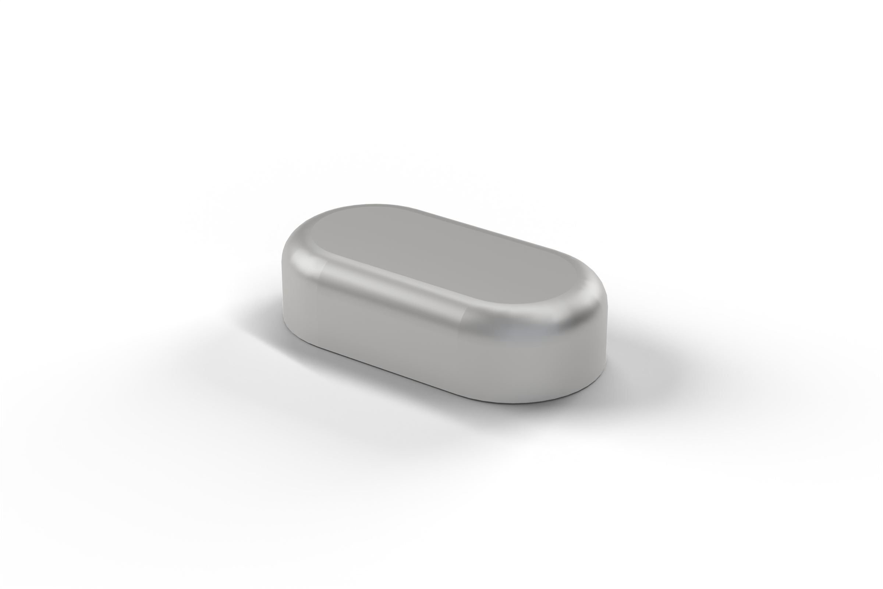
docs/images/renders/pod_threequarter.png
