Het-Bhavsar/Atrium/docs/images/renders/pod_top.png

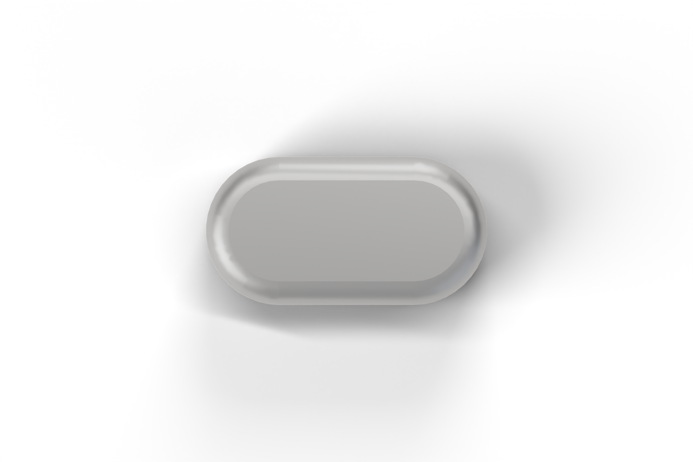
docs/images/renders/pod_top.png
