Het-Bhavsar/Atrium/hardware/case/charging-case/pcb/Atrium_Charging_Case_render_top.png

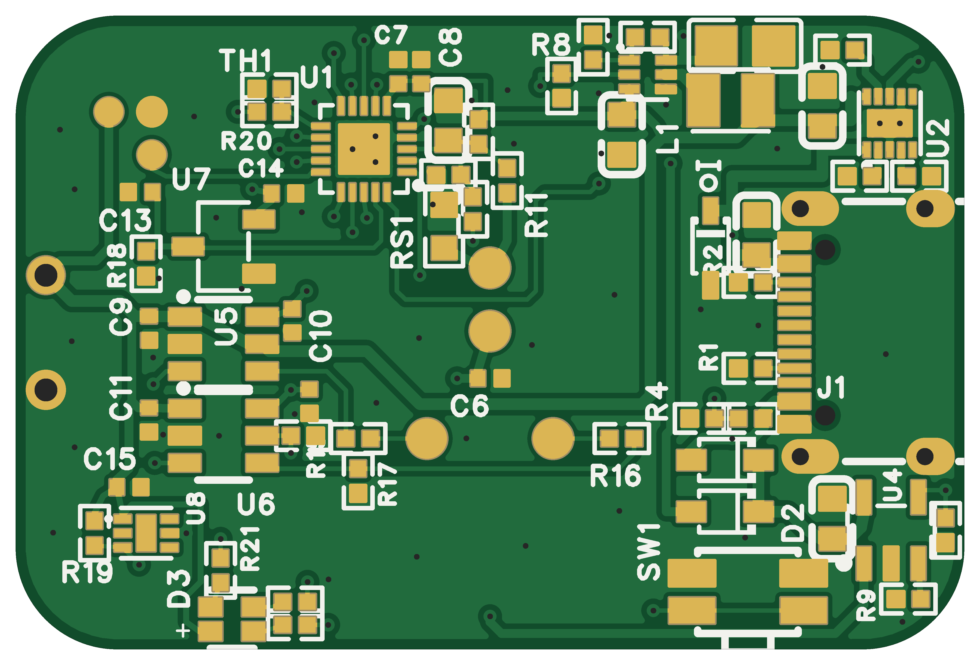
hardware/case/charging-case/pcb/Atrium_Charging_Case_render_top.png
