Het-Bhavsar/Atrium/hardware/design-data/outline/atrium_outlines.png

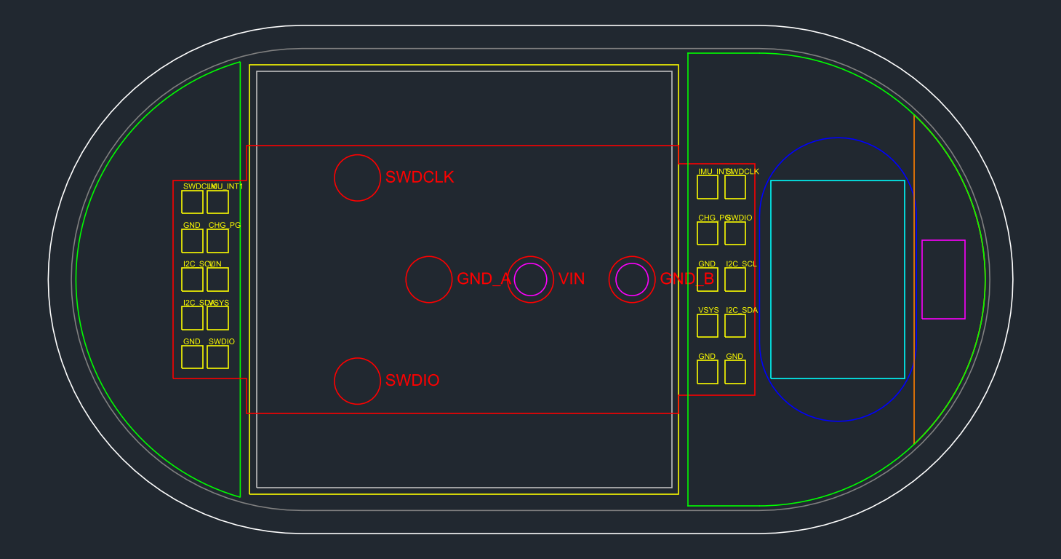
hardware/design-data/outline/atrium_outlines.png
