Het-Bhavsar/Atrium/hardware/pod/flex-jumper/pcb/Atrium_Flex_Jumper_render_top.png

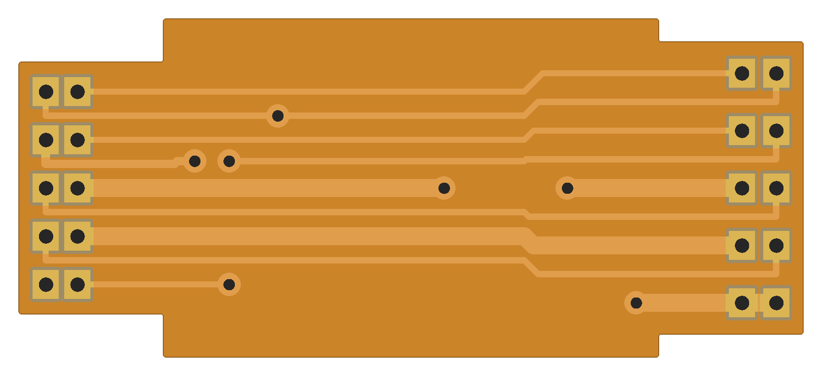
hardware/pod/flex-jumper/pcb/Atrium_Flex_Jumper_render_top.png
