Het-Bhavsar/Atrium/hardware/pod/power-island/pcb/Atrium_Power_Island_render_top.png

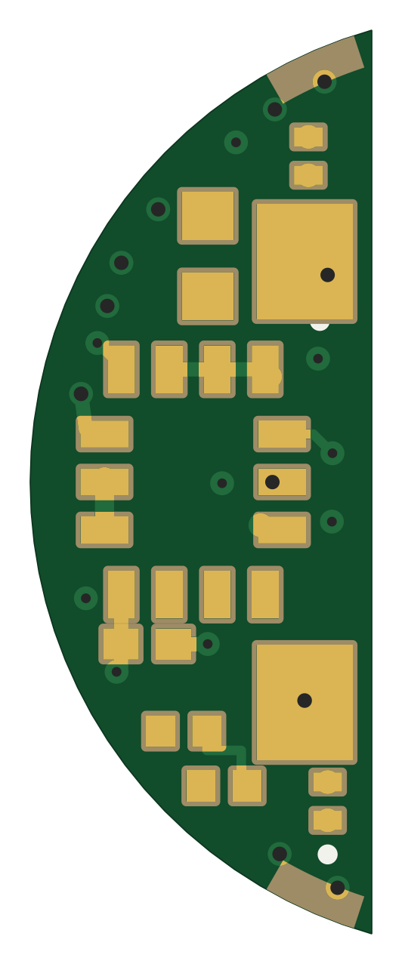
hardware/pod/power-island/pcb/Atrium_Power_Island_render_top.png
