Het-Bhavsar/Atrium/hardware/pod/radio-island/pcb/Atrium_Radio_Island_render_bottom.png

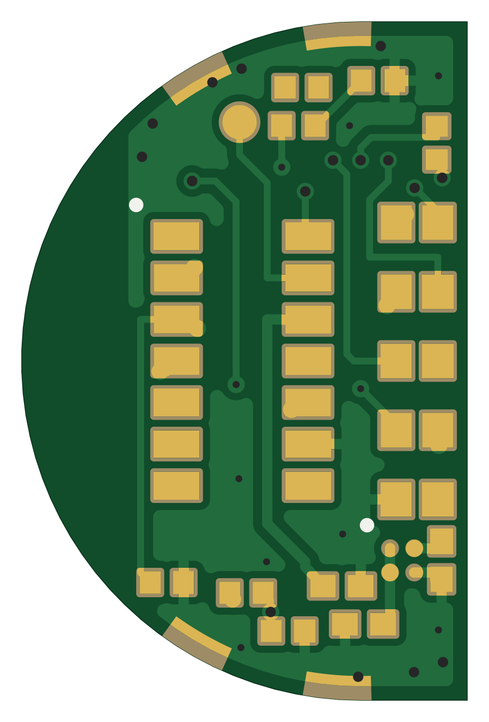
hardware/pod/radio-island/pcb/Atrium_Radio_Island_render_bottom.png
