Het-Bhavsar/Atrium/hardware/simulation/charge.png

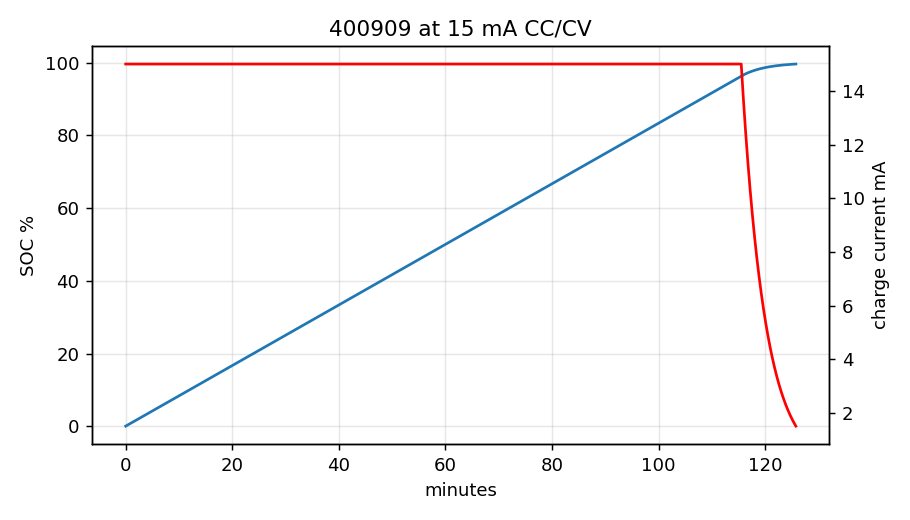
hardware/simulation/charge.png
