Het-Bhavsar/Atrium/hardware/simulation/hrv_timing.png

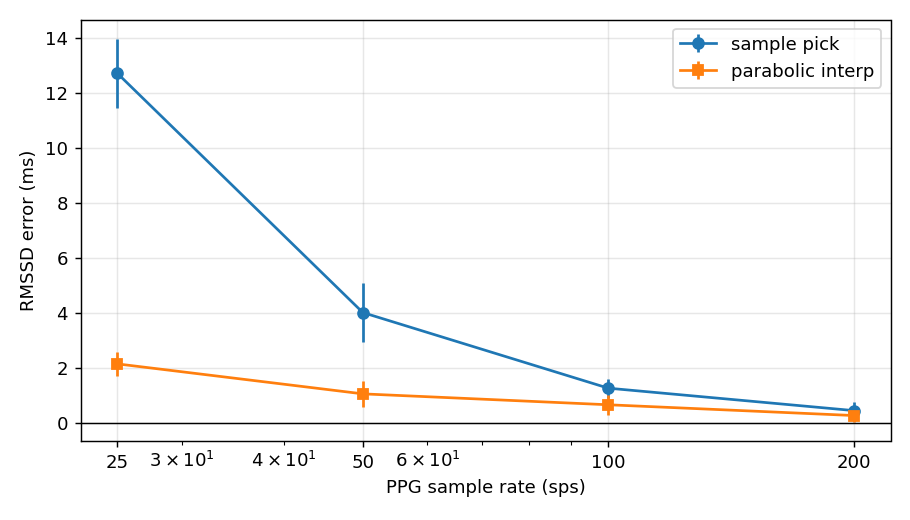
hardware/simulation/hrv_timing.png
