Het-Bhavsar/Atrium/hardware/simulation/link_budget.png

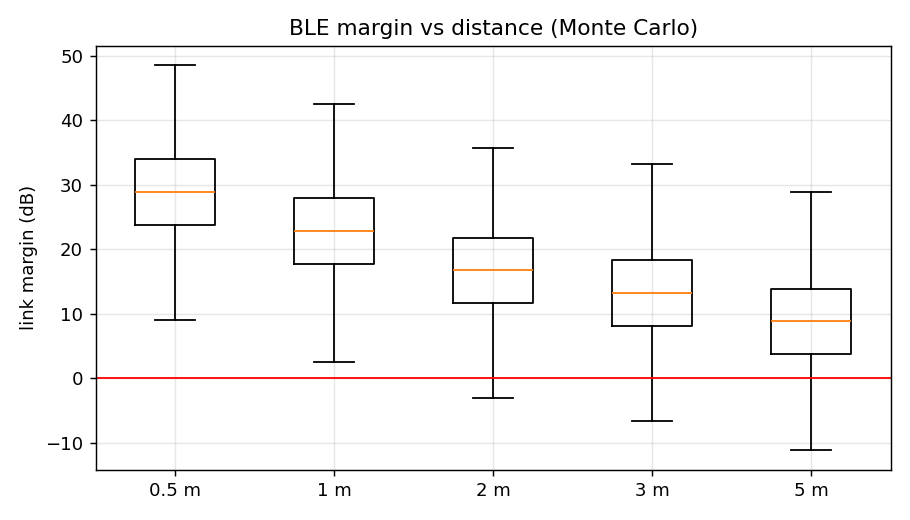
hardware/simulation/link_budget.png
