Het-Bhavsar/Atrium/hardware/simulation/ntc_saadc.png

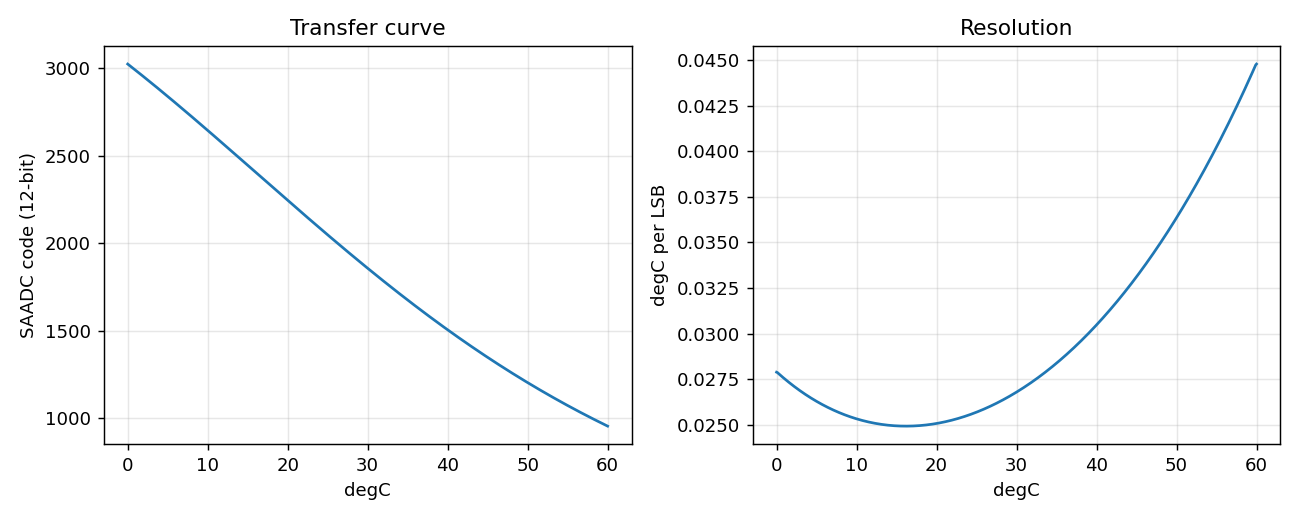
hardware/simulation/ntc_saadc.png
