Het-Bhavsar/Atrium/hardware/simulation/power_budget.png

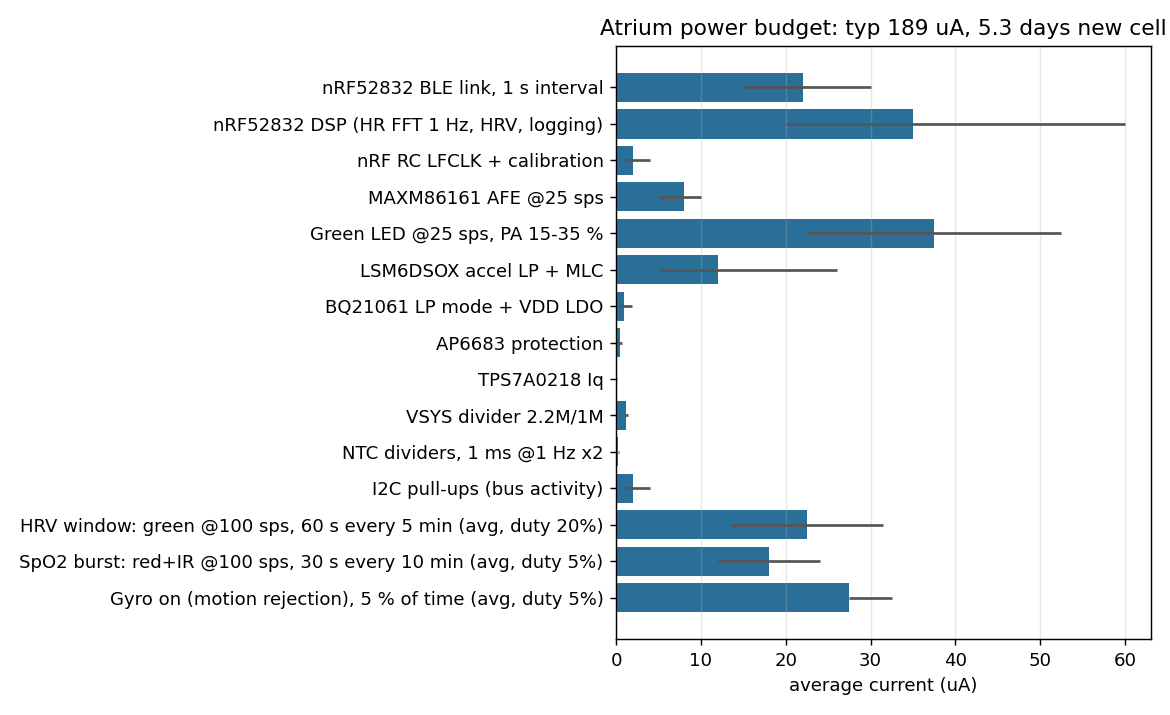
hardware/simulation/power_budget.png
