Het-Bhavsar/Atrium/hardware/simulation/ppg_optics.png

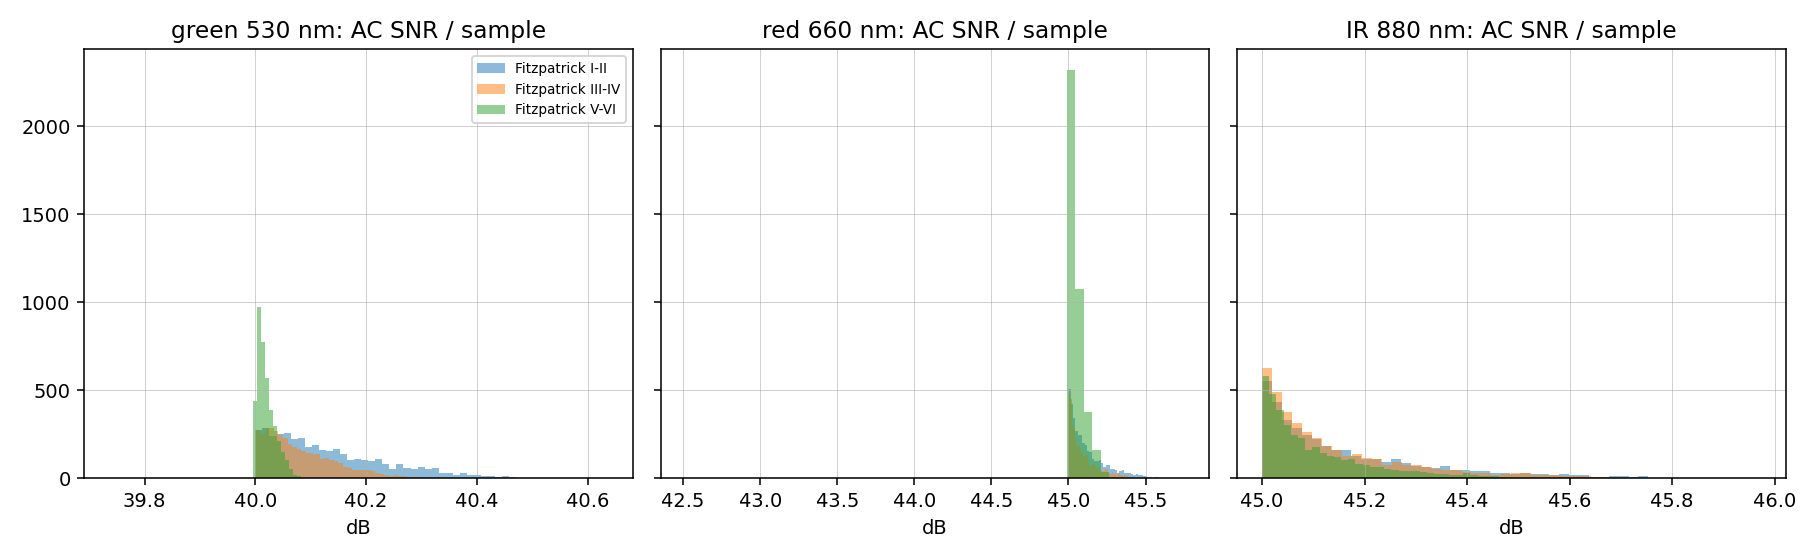
hardware/simulation/ppg_optics.png
