Het-Bhavsar/Atrium/hardware/simulation/rf_chain.png

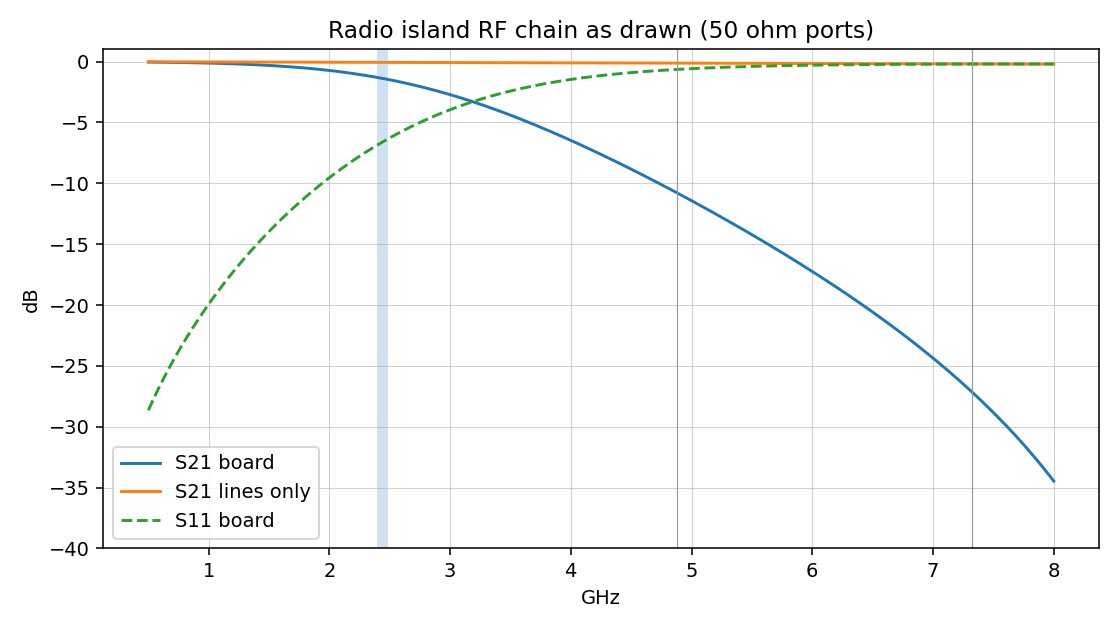
hardware/simulation/rf_chain.png
