Het-Bhavsar/Atrium/hardware/simulation/smith_match_demo.png

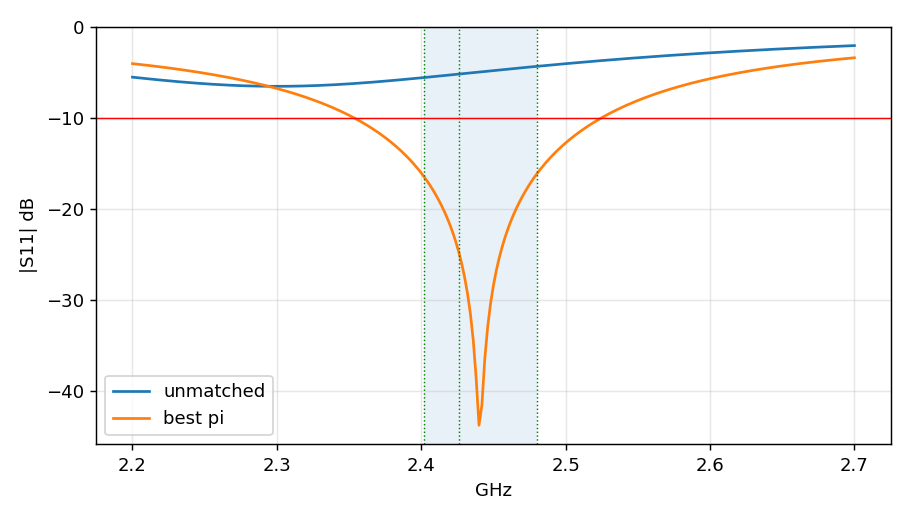
hardware/simulation/smith_match_demo.png
