Het-Bhavsar/Atrium/mechanical/case/DXF/case_pcb_outline.png

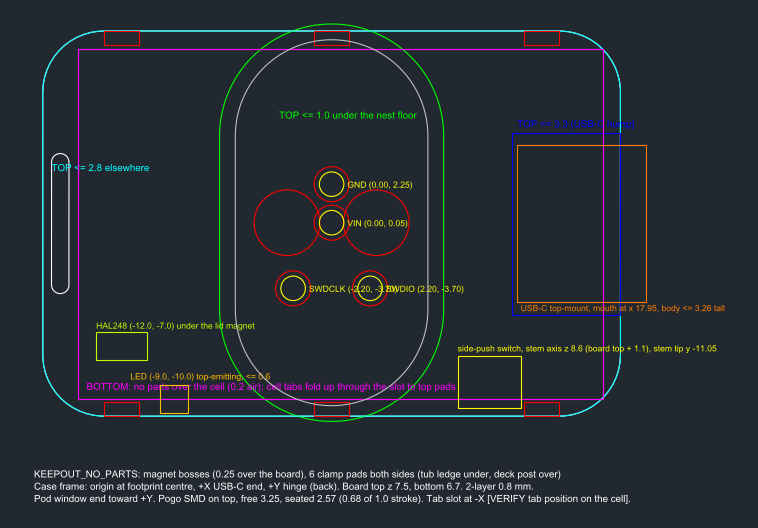
mechanical/case/DXF/case_pcb_outline.png
