Het-Bhavsar/Atrium/mechanical/renders/case_open.png

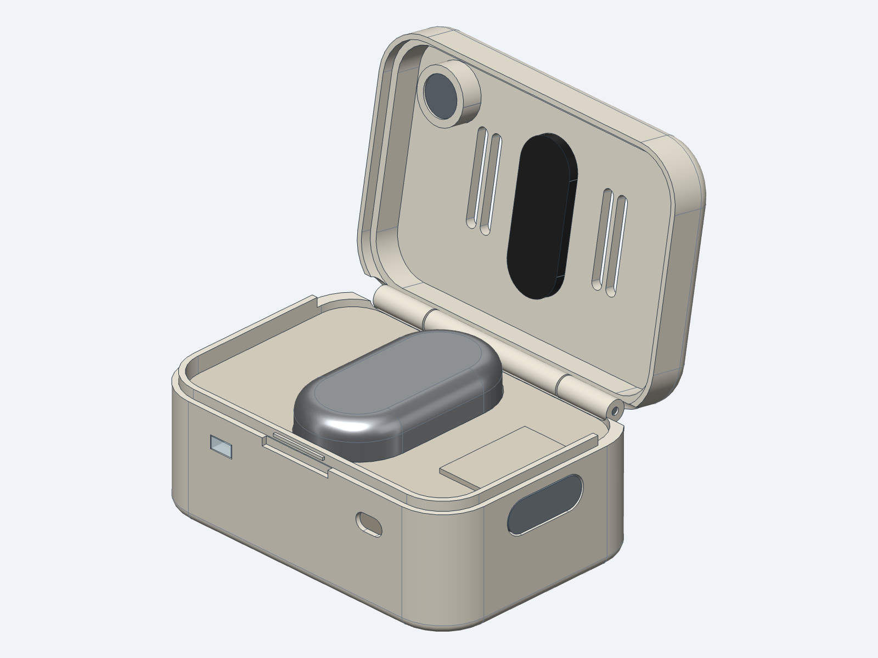
mechanical/renders/case_open.png
