Het-Bhavsar/Atrium/mechanical/renders/case_section_x0.png

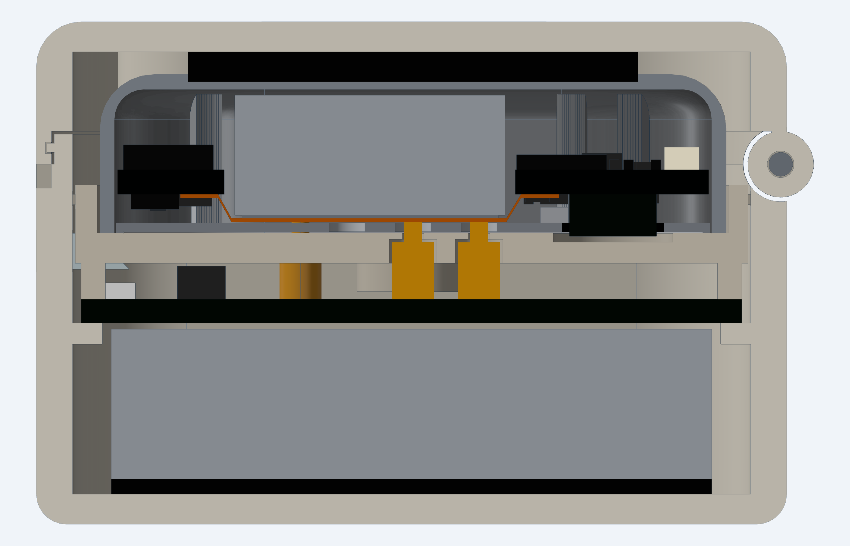
mechanical/renders/case_section_x0.png
