Het-Bhavsar/Atrium/mechanical/renders/hero_on_pad_skin_side.png

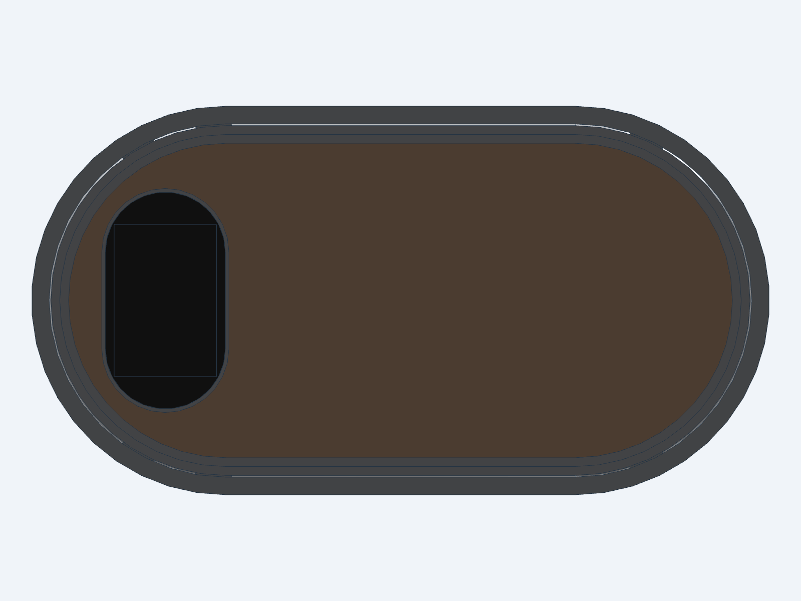
mechanical/renders/hero_on_pad_skin_side.png
