Het-Bhavsar/Atrium/mechanical/renders/hero_pod_clear_three_quarter.png

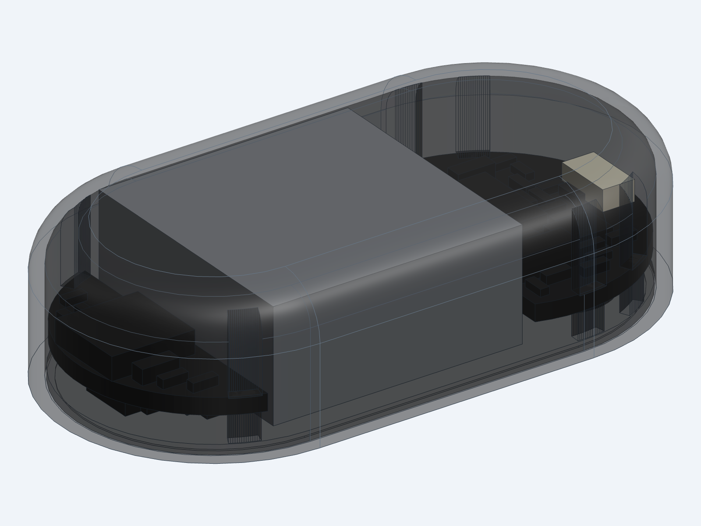
mechanical/renders/hero_pod_clear_three_quarter.png
