Het-Bhavsar/Atrium/mechanical/renders/hero_pod_low.png

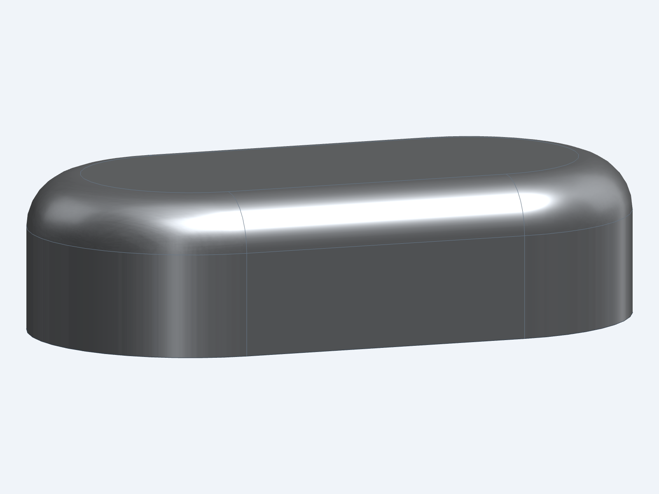
mechanical/renders/hero_pod_low.png
