Het-Bhavsar/Atrium/mechanical/renders/hero_pod_top.png

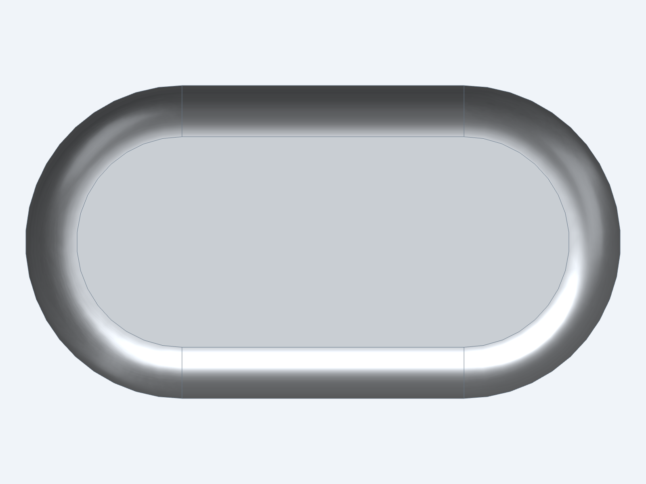
mechanical/renders/hero_pod_top.png
