Het-Bhavsar/Atrium/mechanical/renders/hero_skin_frame_low.png

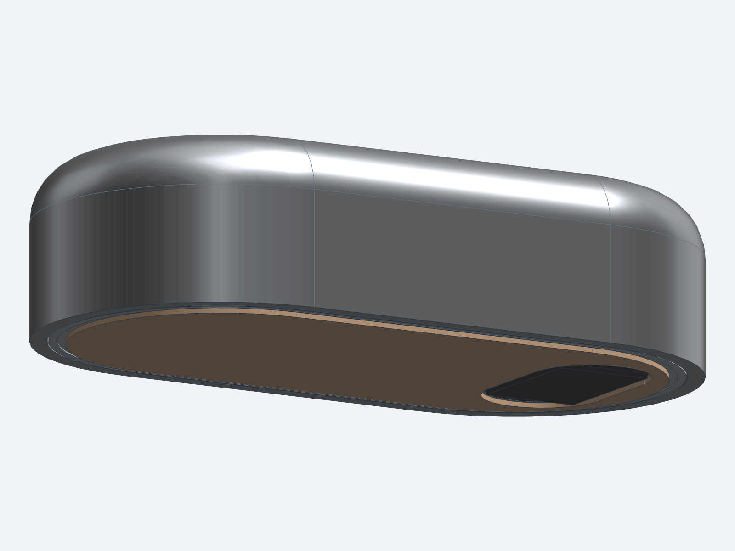
mechanical/renders/hero_skin_frame_low.png
