Het-Bhavsar/Atrium/mechanical/renders/hero_worn.png

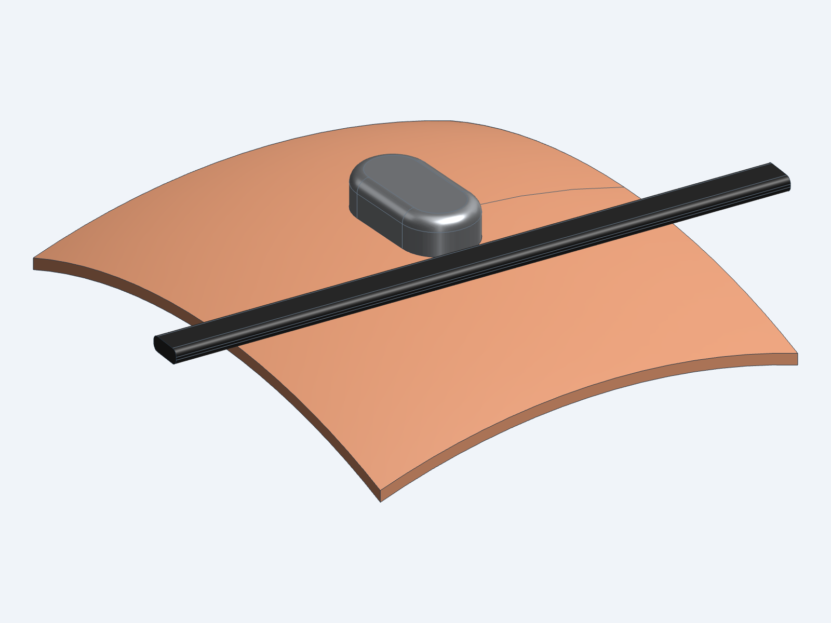
mechanical/renders/hero_worn.png
