Het-Bhavsar/Atrium/mechanical/renders/hero_worn_face_on.png

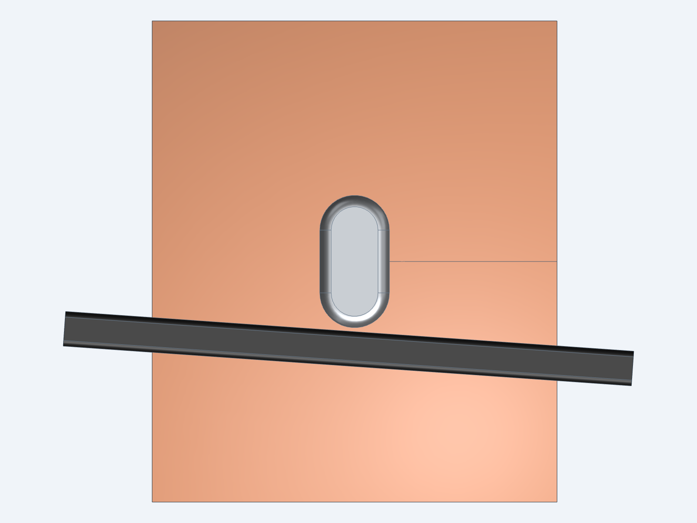
mechanical/renders/hero_worn_face_on.png
