Het-Bhavsar/Atrium/mechanical/renders/packaging_closed.png

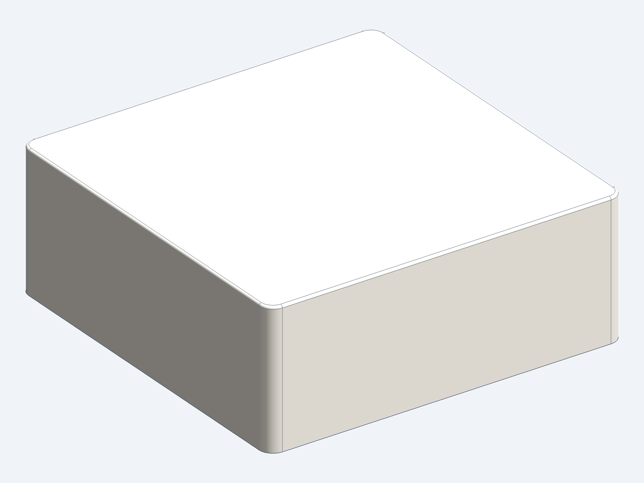
mechanical/renders/packaging_closed.png
