Het-Bhavsar/Atrium/hardware/pod/islands-panel-1x2/Pod_Islands_Panel_1x2_BOM.csv

Comment | Designator | Footprint | LCSC Part # | Qty per panel
KH-1608-H08 2.45 GHz chip antenna 0603 | ANT1_R11,ANT1_R21 |  | C2925416 | 2
100 nF X5R 0201 | C12_R11,C4_R11,C5_R11,C12_R21,C4_R21,C5_R21,C55_P11,C60_P11,C55_P21,C60_P21 |  | C76928 | 10
12 pF C0G 0201 | C1_R11,C2_R11,C1_R21,C2_R21 |  | C161404 | 4
1 uF X5R 0201 | C20_R11,C21_R11,C31_R11,C32_R11,C9_R11,C20_R21,C21_R21,C31_R21,C32_R21,C9_R21,C56_P11,C63_P11,C56_P21,C63_P21 |  | C76929 | 14
10 uF X5R 0402 | C30_R11,C30_R21 |  | C15525 | 2
1.0 pF C0G 0201 | C3_R11,C3_R21 |  | C237514 | 2
10 uF X5R 0402 10 V | C50_P11,C50_P21,C52_P11,C52_P21 |  | C315248 | 4
22 uF X5R 0402 6.3 V | C51_P11,C51_P21 |  | C415703 | 2
4.7 uF X5R 0402 6.3 V | C53_P11,C53_P21 |  | C23733 | 2
100 pF C0G 0201 | C6_R11,C7_R11,C6_R21,C7_R21 |  | C62550 | 4
4.7 uF X5R 0201 | C8_R11,C8_R21 |  | C335103 | 2
ESD5V3U04-0201 | D10_P11,D12_P11,D13_P11,D10_P21,D12_P21,D13_P21 |  | C521889 | 6
LQM18DN100M70L 10 uH 0603 | L1_R11,L1_R21 |  | C713281 | 2
15 nH 0402 | L2_R11,L2_R21 |  | C395049 | 2
3.3 nH 0201 | L3_R11,L3_R21 |  | C98045 | 2
10 kohm 0201 0.1 % 25 ppm | R10_R11,R11_R11,R10_R21,R11_R21 |  | C852211 | 4
4.7 kohm 0201 1 % | R1_R11,R2_R11,R1_R21,R2_R21 |  | C138135 | 4
100 kohm 0201 | R3_R11,R3_R21 |  | C270364 | 2
2.2 Mohm 0201 1 % | R40_R11,R40_R21 |  | C474576 | 2
1 Mohm 0201 | R41_R11,R5_R11,R41_R21,R5_R21 |  | C295786 | 4
10 kohm 0201 1 % | R50_P11,R50_P21 |  | C473048 | 2
330 ohm 0201 | R51_P11,R51_P21 |  | C274872 | 2
NCP03XH103F05RL 10k B3380 0201 | TH1_R11,TH4_R11,TH1_R21,TH4_R21,TH5_P11,TH5_P21 |  | C98098 | 6
BQ21061YFPR I2C linear charger | U10_P11,U10_P21 | DSBGA-20 2.0x1.6 0.4p | C2869893 | 2
LSM6DSOXTR IMU | U11_P11,U11_P21 | LGA-14 2.5x3.0x0.83 | C481766 | 2
AP6683 1-cell protection with integrated FET | U12_P11,U12_P21 | DFN-4-EP 1x1 | C2849565 | 2
NRF52832-CIAA-G-R7 | U1_R11,U1_R21 | WLCSP-50 3.0x3.2 0.4p | C3606951 | 2
TPS7A0218PYCHR 1.8 V LDO | U2_R11,U2_R21,U13_P11,U13_P21 | DSBGA-4 0.64x0.64 (YCH) | C3752366 | 4
MAXM86161AEFD+T | U3_R11,U3_R21 | OLGA-14 2.9x4.3x1.4 | C54021201 | 2
NX1612SA-32MHZ-STD-CIS-3 32 MHz 8 pF 1612 | Y1_R11,Y1_R21 |  | C910049 | 2
0 ohm 0201 (series pi element) | Z41_R11,Z41_R21 |  | C473473 | 2
