Het-Bhavsar/Atrium/hardware/case/bom/case_bom.csv

refs | qty | part | lcsc | jlc_type | unit_usd | package | mfr_part
J1 | 1 | USB-C 6P | C668623 | expand | 0.039 | SMD | TYPE-C 6P(073)
U1 | 1 | BQ24073RGTR (OUT 4.4 V, replaces BQ24075 per schematic sim) | C15220 | expand | 0.9796 | QFN-16-EP(3x3) | BQ24073RGTR
U2 | 1 | TPS61099DRVR | C2842395 | expand | 1.3116 | WSON-6-EP(2x2) | TPS61099DRVR
L1 | 1 | 1uH DFE201610E-1R0M=P2 | C161082 | expand | 0.1369 | 0806 | DFE201610E-1R0M=P2
U3 | 1 | SY6280AAAC | C207620 | expand | 0.0903 | SOT-23-5 | SY6280AAAC
U4 | 1 | DRV5032FADBZR | C140921 | expand | 0.1751 | SOT-23 | DRV5032FADBZR
Q1 | 1 | 2N7002 | C8545 | base | 0.0172 | SOT-23 | 2N7002
P1 P2 | 2 | Pogo 2.0 x 4.5 | C2826546 | expand | 0.0763 | SMD,D=2mm | BWCD-L4.5W2.0H2.3
D1 | 1 | SMF6.0A unidirectional TVS, VRWM 6.0 V | C2857264 | expand | 0.0182 | SOD-123FL | SMF6.0A
LED1 | 1 | Red 0603 KT-0603R | C2286 | base | 0.0077 | 0603 | KT-0603R
LED2 | 1 | Green 0603 KT-0603G | C12624 | expand | 0.0119 | 0603 | KT-0603G
R1 R2 | 2 | 5.1k 1% 0402 | C25905 | base | 0.0023 | 0402 | 0402WGF5101TCE
R3 | 1 | 5.9k 1% 0402 | C273691 | expand | 0.0029 | 0402 | RC0402FR-075K9L
R4 | 1 | 3.24k 1% 0402 | C11457 | expand | 0.0012 | 0402 | 0402WGF3241TCE
R5 | 1 | 33.2k 1% 0402 | C122548 | expand | 0.001 | 0402 | 0402WGF3322TCE
R6 R7 | 2 | 1k 1% 0402 | C11702 | base | 0.0013 | 0402 | 0402WGF1001TCE
R8 R11 | 2 | 1M 1% 0402 | C26083 | base | 0.0015 | 0402 | 0402WGF1004TCE
R9 | 1 | 270k 1% 0402 | C25770 | expand | 0.0021 | 0402 | 0402WGF2703TCE
R10 | 1 | 16.9k 1% 0402 | C25858 | expand | 0.0013 | 0402 | 0402WGF1692TCE
C1 C2 | 2 | 4.7uF 16V X5R 0603 | C19666 | base | 0.015 | 0603 | CL10A475KO8NNNC
C3 | 1 | 10uF 10V X5R 0603 | C19702 | base | 0.0203 | 0603 | CL10A106KP8NNNC
C4 | 1 | 22uF 6.3V X5R 0603 | C59461 | base | 0.0171 | 0603 | CL10A226MQ8NRNC
C5 C7 C8 | 3 | 1uF 25V X5R 0402 | C52923 | base | 0.0063 | 0402 | CL05A105KA5NQNC
C6 C9 | 2 | 100nF 16V X7R 0402 | C1525 | base | 0.0031 | 0402 | CL05B104KO5NNNC
U5 | 1 | TLV803EC29DBZR supervisor 2.93 V open drain | C2867948 | expand | 0.3366 | SOT-23 | TLV803EC29DBZR
