Het-Bhavsar/Atrium/hardware/case/schematic/case_pin_netlist.csv

ref | pin | pin_name_or_value | net
J1 | A9 | VBUS | VBUS_IN
J1 | A5 | CC1 | CC1
J1 | B5 | CC2 | CC2
J1 | G | GND | GND
U1 | 13 | IN | VBUS_IN
U1 | 12 | ILIM | ILIM
U1 | 16 | ISET | ISET
U1 | 14 | TMR | TMR
U1 | 4 | #CE | GND
U1 | 6 | EN1 | GND
U1 | 5 | EN2 | VBUS_IN
U1 | 15 | TD | GND
U1 | 8 | VSS | GND
U1 | EP | VSS | GND
U1 | 10 | OUT | SYS
U1 | 11 | OUT | SYS
U1 | 2 | BAT | CVBAT
U1 | 3 | BAT | CVBAT
U1 | 1 | TS | NTC
U1 | 9 | #CHG | LEDR_K
U1 | 7 | #PGOOD | LEDG_K
U2 | 6 | VIN | SYS
U2 | 4 | EN | EN_5V
U2 | 1 | GND | GND
U2 | EP | GND | GND
U2 | 5 | SW | SW_B
U2 | 2 | VOUT | V5
U2 | 3 | FB | FB
U3 | 5 | IN | V5
U3 | 4 | EN | EN_5V
U3 | 3 | ISET | ISET2
U3 | 2 | GND | GND
U3 | 1 | OUT | POD_VBUS
U4 | 1 | VCC | SYS
U4 | 3 | GND | GND
U4 | 2 | OUT | HALL
Q1 | 1 | G | HALL
Q1 | 2 | S | GND
Q1 | 3 | D | EN_5V
BT1 | + | + | CVBAT
BT1 | − | − | GND
BT1 | T | NTC | NTC
P1 | 1 | pogo | POD_VBUS
P2 | 1 | pogo | GND
R1 | 1 | 5.1k | CC1
R1 | 2 | 5.1k | GND
R2 | 1 | 5.1k | CC2
R2 | 2 | 5.1k | GND
C1 | 1 | 4.7µF | VBUS_IN
C1 | 2 | 4.7µF | GND
D1 | 1 | SMF6.0A | VBUS_IN
D1 | 2 | SMF6.0A | GND
R3 | 1 | 5.9k 1% | ISET
R3 | 2 | 5.9k 1% | GND
R4 | 1 | 3.24k 1% | ILIM
R4 | 2 | 3.24k 1% | GND
R5 | 1 | 33.2k 1% | TMR
R5 | 2 | 33.2k 1% | GND
C7 | 1 | 1µF | VBUS_IN
C7 | 2 | 1µF | GND
C2 | 1 | 4.7µF | SYS
C2 | 2 | 4.7µF | GND
C8 | 1 | 1µF | CVBAT
C8 | 2 | 1µF | GND
R6 | 1 | 1k | VBUS_IN
R6 | 2 | 1k | LED1_A
LED1 | A | red | LED1_A
LED1 | K | red | LEDR_K
R7 | 1 | 1k | VBUS_IN
R7 | 2 | 1k | LED2_A
LED2 | A | green | LED2_A
LED2 | K | green | LEDG_K
L1 | 1 | 1µH C161082 | SYS
L1 | 2 | 1µH C161082 | SW_B
C3 | 1 | 10µF | SYS
C3 | 2 | 10µF | GND
C4 | 1 | 22µF | V5
C4 | 2 | 22µF | GND
R8 | 1 | 1M 1% | V5
R8 | 2 | 1M 1% | FB
R9 | 1 | 270k 1% | FB
R9 | 2 | 270k 1% | GND
R10 | 1 | 16.9k 1% | ISET2
R10 | 2 | 16.9k 1% | GND
C5 | 1 | 1µF | POD_VBUS
C5 | 2 | 1µF | GND
R11 | 1 | 1M | SYS
R11 | 2 | 1M | EN_5V
C6 | 1 | 100nF | SYS
C6 | 2 | 100nF | GND
U5 | 3 | VDD | SYS
U5 | 2 | RESET# | EN_5V
U5 | 1 | GND | GND
C9 | 1 | 100nF | SYS
C9 | 2 | 100nF | GND
