Het-Bhavsar/Atrium/hardware/pod/schematic/pod_pin_netlist.csv

ref | pin | pin_name_or_value | net
U7 | B1 | VIN | VBAT
U7 | C1 | EN | VBAT
U7 | C2 | VSET | GND
U7 | A1 | GND | GND
U7 | B2 | SW | SW
U7 | A2 | VOS | V1V8
U6 | 2 | CELL | VBAT
U6 | 3 | VDD | VBAT
U6 | 1 | CTG | GND
U6 | 6 | QSTRT | GND
U6 | 4 | GND/EP | GND
U6 | 9 | GND/EP | GND
U6 | 8 | SDA | SDA
U6 | 7 | SCL | SCL
U6 | 5 | ALRT | FG_ALRT
BT1 | + | cell + tab | VBAT
BT1 | - | cell - tab | BATN
D1 | K |  | VBUS
D1 | A |  | GND
U1 | A7 | VDD | V1V8
U1 | H7 | VDD | V1V8
U1 | B7 | DEC1 | DEC1
U1 | A2 | DEC2 | DEC2
U1 | C2 | DEC3 | DEC3
U1 | A6 | DEC4 | DEC4
U1 | B6 | DCC | NC
U1 | B2 | XC1 | XC1
U1 | A1 | XC2 | XC2
U1 | D7 | P0.00/XL1 | XL1
U1 | C7 | P0.01/XL2 | XL2
U1 | C4 | VSS | GND
U1 | C5 | VSS | GND
U1 | E3 | VSS | GND
U1 | F5 | VSS | GND
U1 | D2 | VSS_PA | GND
U1 | D1 | ANT | ANT
U1 | B3 | P0.25 | PPG_INT
U1 | A3 | P0.28 | IMU_INT1
U1 | F4 | P0.11 | IMU_INT2
U1 | A4 | P0.29 | FG_ALRT
U1 | A5 | P0.30 | TMP_ALERT
U1 | B5 | P0.31 | CHRG_N
U1 | H6 | P0.12 | FL_CS
U1 | G4 | P0.13 | FL_SCK
U1 | H5 | P0.14 | FL_MOSI
U1 | H4 | P0.15 | FL_MISO
U1 | G1 | SWDIO | SWDIO
U1 | F1 | SWDCLK | SWCLK
U1 | H1 | P0.21/nRESET | NRESET
Y1 | 1 | X | XC1
Y1 | 2 | GND | GND
Y1 | 4 | GND | GND
Y1 | 3 | X | XC2
Y2 | 1 | X | XL1
Y2 | 2 | X | XL2
AE1 | 1 | feed | RF2
AE1 | 2 | pad 2 | GND
U2 | A2 | VDD | V1V8
U2 | B3 | VLED | VBAT
U2 | B1 | VREF | VREF
U2 | A1 | GND | GND
U2 | C3 | PGND | GND
U2 | A4 | PD1_IN | PD1_K
U2 | A3 | PD2_IN | PD2_K
U2 | C1 | LED1_DRV | LED_G
U2 | D1 | LED2_DRV | LED_R
U2 | D2 | LED3_DRV | LED_IR
U2 | C2 | LED4_DRV/TRIG | GND
U2 | B2 | INTB | PPG_INT
U2 | D3 | SDI/SDA | SDA
U2 | D4 | SCLK/SCL | SCL
U2 | C4 | SDO/ADDR | V1V8
U2 | B4 | CSB/I2C_SEL | V1V8
D2 | 2 | A common | VBAT
D2 | 5 | A common | VBAT
D2 | 3 | K green | LED_G
D2 | 4 | K red | LED_R
D2 | 1 | K IR | LED_IR
PD1 | 1 | A | GND
PD1 | 3 | C | PD1_K
PD1 | 4 | C | PD1_K
PD1 | 5 | C | PD1_K
PD2 | 1 | A | GND
PD2 | 3 | C | PD2_K
PD2 | 4 | C | PD2_K
PD2 | 5 | C | PD2_K
U3 | 8 | Vdd | V1V8
U3 | 5 | Vdd_IO | V1V8
U3 | 6 | GND | GND
U3 | 7 | GND | GND
U3 | 1 | SDO/SA0 | GND
U3 | 12 | CS | V1V8
U3 | 10 | OCS_Aux | NC
U3 | 11 | SDO_Aux | NC
U3 | 14 | SDA | SDA
U3 | 13 | SCL | SCL
U3 | 4 | INT1 | IMU_INT1
U3 | 9 | INT2 | IMU_INT2
U3 | 2 | SDx/AH1 | GND
U3 | 3 | SCx/AH2 | GND
U4 | 5 | V+ | V1V8
U4 | 2 | GND | GND
U4 | 4 | ADD0 | GND
U4 | 7 | EP | GND
U4 | 6 | SDA | SDA
U4 | 1 | SCL | SCL
U4 | 3 | ALERT | TMP_ALERT
U8 | 8 | VCC | V1V8
U8 | 4 | GND | GND
U8 | EP | GND | GND
U8 | 3 | WP# | V1V8
U8 | 7 | HOLD# | V1V8
U8 | 1 | CS# | FL_CS
U8 | 6 | CLK | FL_SCK
U8 | 5 | DI | FL_MOSI
U8 | 2 | DO | FL_MISO
J1.1 | 1 | VBUS | VBUS
J1.2 | 1 | GND | GND
J1.3 | 1 | SWCLK | SWCLK_P
J1.4 | 1 | SWDIO | SWDIO_P
J1.5 | 1 | nRESET | NRESET_P
U5 | A2 | IN | VBUS
U5 | A1 | OUT | VBAT
U5 | B1 | TS | TS
U5 | B2 | ISET | ISET
U5 | C1 | CHG# | CHRG_N
U5 | C2 | VSS | GND
U9 | 1 | VDD | PROT_VDD
U9 | 2 | GND | BATN
U9 | 3 | CTL | SHIP
U9 | 4 | VM | GND
U9 | 5 | EP | BATN
U1 | D6 | P0.03/AIN1 | NTC_SENSE
U1 | E6 | P0.04 | NTC_PWR
U1 | E7 | P0.05 | SHIP
R1 | 1 | 6.04k 1% | ISET
R1 | 2 | 6.04k 1% | GND
C1 | 1 | 1µF | VBUS
C1 | 2 | 1µF | GND
C2 | 1 | 4.7µF | VBAT
C2 | 2 | 4.7µF | GND
L1 | 1 | 2.2µH C5224594 | SW
L1 | 2 | 2.2µH C5224594 | V1V8
C3 | 1 | 4.7µF | VBAT
C3 | 2 | 4.7µF | GND
C4 | 1 | 10µF | V1V8
C4 | 2 | 10µF | GND
C5 | 1 | 1µF | VBAT
C5 | 2 | 1µF | GND
C11 | 1 | 12pF | XC1
C11 | 2 | 12pF | GND
C12 | 1 | 12pF | XC2
C12 | 2 | 12pF | GND
C13 | 1 | 10pF | XL1
C13 | 2 | 10pF | GND
C14 | 1 | 10pF | XL2
C14 | 2 | 10pF | GND
C15 | 1 | 100nF | DEC1
C15 | 2 | 100nF | GND
C16 | 1 | 1µF | DEC4
C16 | 2 | 1µF | GND
C17 | 1 | 100nF | V1V8
C17 | 2 | 100nF | GND
C18 | 1 | 4.7µF | V1V8
C18 | 2 | 4.7µF | GND
C19 | 1 | 100pF | DEC3
C19 | 2 | 100pF | GND
CM1 | 1 | 1.0pF | ANT
CM1 | 2 | 1.0pF | GND
LM1 | 1 | 3.3nH | ANT
LM1 | 2 | 3.3nH | RF1
CM2 | 1 | DNP | RF1
CM2 | 2 | DNP | GND
CT1 | 1 | DNP | RF1
CT1 | 2 | DNP | GND
RT1 | 1 | 0Ω | RF1
RT1 | 2 | 0Ω | RF2
CT2 | 1 | DNP | RF2
CT2 | 2 | DNP | GND
C7 | 1 | 10µF | VBAT
C7 | 2 | 10µF | GND
C8 | 1 | 100nF | VBAT
C8 | 2 | 100nF | GND
C9 | 1 | 1µF | V1V8
C9 | 2 | 1µF | GND
C10 | 1 | 1uF | VREF
C10 | 2 | 1uF | GND
R3 | 1 | 4.7k | SDA
R3 | 2 | 4.7k | V1V8
R4 | 1 | 4.7k | SCL
R4 | 2 | 4.7k | V1V8
R5 | 1 | 100Ω | SWDIO
R5 | 2 | 100Ω | SWDIO_P
R6 | 1 | 100Ω | SWCLK
R6 | 2 | 100Ω | SWCLK_P
R7 | 1 | 100Ω | NRESET
R7 | 2 | 100Ω | NRESET_P
C6 | 1 | 100nF | V1V8
C6 | 2 | 100nF | GND
C20 | 1 | 100nF | V1V8
C20 | 2 | 100nF | GND
C21 | 1 | 100nF | V1V8
C21 | 2 | 100nF | GND
R12 | 1 | 1k | VBAT
R12 | 2 | 1k | PROT_VDD
C22 | 1 | 100nF | PROT_VDD
C22 | 2 | 100nF | BATN
TH1 | 1 | NTC 10k 1% B3380 (edge reference) | NTC_SENSE
TH1 | 2 | NTC 10k 1% B3380 (edge reference) | GND
R13 | 1 | 10k 0.1% (NTC divider) | NTC_PWR
R13 | 2 | 10k 0.1% (NTC divider) | NTC_SENSE
TH2 | 1 | NTC 10k 1% B3380 (cell temp → charger TS) | TS
TH2 | 2 | NTC 10k 1% B3380 (cell temp → charger TS) | GND
U1 | F7 | P0.06 | SDA
U1 | F6 | P0.07 | SCL
C23 | 1 | 100pF | DEC2
C23 | 2 | 100pF | GND
TP1 | 1 | test pad | VBAT
TP2 | 1 | test pad | V1V8
TP3 | 1 | test pad | BATN
TP4 | 1 | test pad | SHIP
U1 | C6 | P0.02/AIN0 | VBUS_SENSE
U1 | G7 | P0.08 | CHG_INH
R14 | 1 | 1M | VBUS
R14 | 2 | 1M | VBUS_SENSE
R15 | 1 | 470k | VBUS_SENSE
R15 | 2 | 470k | GND
R16 | 1 | 1k | CHG_INH
R16 | 2 | 1k | TS
