Het-Bhavsar/Atrium/hardware/case/pcb/placement/case_placement.csv

ref | side | x_mm | y_mm | w_mm | h_mm | max_height_mm | label
J1 | top | 20.0 | 3.4 | 9.0 | 6.8 | 3.3 | USB-C 6P
D1 | top | 13.6 | 5.6 | 1.7 | 0.9 | 0.7 | TVS VBUS
R1 | top | 13.6 | 3.0 | 1.0 | 0.5 | 0.35 | 5k1 CC1
R2 | top | 26.4 | 3.0 | 1.0 | 0.5 | 0.35 | 5k1 CC2
C1 | top | 26.4 | 5.4 | 1.6 | 0.8 | 0.8 | 4u7 VBUS
U1 | top | 8.0 | 10.0 | 3.5 | 3.5 | 0.9 | BQ24075
R3 | top | 4.0 | 13.4 | 1.0 | 0.5 | 0.35 | ISET
R4 | top | 6.2 | 13.4 | 1.0 | 0.5 | 0.35 | ILIM
R5 | top | 8.4 | 13.4 | 1.0 | 0.5 | 0.35 | TMR
C2 | top | 11.8 | 13.4 | 1.6 | 0.8 | 0.8 | 4u7 OUT
C7 | top | 11.8 | 9.0 | 1.6 | 0.8 | 0.8 | 1u IN
C8 | top | 4.4 | 9.0 | 0.8 | 1.6 | 0.8 | 1u BAT
LED1 | top | 3.0 | 22.5 | 1.6 | 0.8 | 0.6 | red CHG
LED2 | top | 6.0 | 22.5 | 1.6 | 0.8 | 0.6 | green PGOOD
R6 | top | 3.0 | 20.6 | 1.0 | 0.5 | 0.35 | 1k
R7 | top | 6.0 | 20.6 | 1.0 | 0.5 | 0.35 | 1k
U2 | top | 28.0 | 10.0 | 2.0 | 2.0 | 0.8 | TPS61099
L1 | top | 31.4 | 10.0 | 2.0 | 1.6 | 1.0 | 1u DFE2016
C3 | top | 28.0 | 7.6 | 1.6 | 0.8 | 0.8 | 10u VIN
C4 | top | 34.6 | 10.0 | 0.8 | 1.6 | 0.8 | 22u VOUT
R8 | top | 26.0 | 12.4 | 1.0 | 0.5 | 0.35 | FB top
R9 | top | 28.2 | 12.4 | 1.0 | 0.5 | 0.35 | FB bot
U3 | top | 28.0 | 16.0 | 3.0 | 2.8 | 1.1 | SY6280
R10 | top | 31.6 | 16.0 | 0.5 | 1.0 | 0.35 | ISET
C5 | top | 34.2 | 16.0 | 0.8 | 1.6 | 0.8 | 1u OUT
POGO1 | top | 18.73 | 20.3 | 2.0 | 2.0 | 4.5 | VBUS
POGO2 | top | 21.27 | 20.3 | 2.0 | 2.0 | 4.5 | GND
U4 | top | 36.6 | 22.4 | 3.0 | 2.8 | 1.1 | DRV5032 hall
Q1 | top | 31.6 | 22.0 | 3.0 | 2.8 | 1.1 | 2N7002
R11 | top | 31.6 | 19.4 | 1.0 | 0.5 | 0.35 | 1M
C6 | top | 36.0 | 19.2 | 1.0 | 0.5 | 0.5 | 100n hall
BT+ | top | 36.4 | 4.0 | 2.0 | 1.6 | 0.1 | cell +
BT- | top | 36.4 | 6.6 | 2.0 | 1.6 | 0.1 | cell −
NTC | top | 33.4 | 4.0 | 1.4 | 1.4 | 0.1 | cell NTC
