Het-Bhavsar/Atrium/hardware/pod/bom/pod_bom.csv

refs | qty | part | lcsc | jlc_type | unit_usd | package | mfr_part
U1 | 1 | nRF52832-CIAA-R | C509405 | expand | 5.31 | WLCSP-50(3x3.2) | NRF52832-CIAA-R
U2 | 1 | MAX86174AENE+T | C5669018 | expand | 6.803 | WLP-16(1.7x1.8) | MAX86174AENE+T
U3 | 1 | LSM6DSV16XTR | C5267406 | expand | 3.3525 | LGA-14 | LSM6DSV16XTR
U4 | 1 | TMP117AIDRVR | C699536 | expand | 1.0319 | WDFN-6-EP(2x2) | TMP117AIDRVR
U5 | 1 | BQ25101YFPR | C478468 | expand | 0.8144 | DSBGA-6 | BQ25101YFPR
U6 | 1 | MAX17048G+T10 | C2682616 | expand | 2.0115 | DFN-8-EP(2x2) | MAX17048G+T10
U7 | 1 | TPS62840YBGR | C2071139 | expand | 1.1415 | DSBGA-6(1x1.5) | TPS62840YBGR
U8 | 1 | W25Q64JWUUIQ | C6604692 | expand | 3.0532 | USON-8(3x4) | W25Q64JWUUIQ
U9 | 1 | LPB1010HQVF | C47345803 | expand | 0.0875 | DFN-4-EP(1x1) | LPB1010HQVF
L1 | 1 | 2.2uH SLO160808T2R2MTT | C5224594 | expand | 0.0995 | 0603 | SLO160808T2R2MTT
D1 | 1 | ESD5V3U04-0201 (replaces ESDA5-1F4, not in EasyEDA library) | C521889 | expand | 0.0401 | 0201 | ESD5V3U04-0201
D2 | 1 | SFH 7016 | C2900452 | expand | 1.4179 | SMD-6P,1.9x1.7mm | SFH 7016
PD1 PD2 | 2 | VEMD5080X01 | C5224049 | expand | 1.7106 | SMD-4P,5x4mm | VEMD5080X01
Y1 | 1 | 32 MHz XRCGB32M000F1S1BR0 | C6938063 | expand | 0.1981 | SMD2016-4P | XRCGB32M000F1S1BR0
Y2 | 1 | 32.768 kHz Q-SC16S0322070AAAN | C5221452 | expand | 0.3019 | SMD1610-2P | Q-SC16S0322070AAAN
AE1 | 1 | RFECA3216060A1T | C127620 | expand | 0.0563 | 1206 | RFECA3216060A1T
TH1 TH2 | 2 | NTC 10k NCP03XH103F05RL | C98098 | expand | 0.0167 | 0201 | NCP03XH103F05RL
C8 C15 C20 C21 C22 | 5 | 100nF 16V X5R 0201 | C307380 | expand | 0.004 | 0201 | CL03A104KO3NNNC
C6 C17 | 2 | 100nF 16V X7R 0402 | C1525 | base | 0.0031 | 0402 | CL05B104KO5NNNC
C1 C5 C9 C10 C16 | 5 | 1uF 25V X5R 0402 | C52923 | base | 0.0063 | 0402 | CL05A105KA5NQNC
C2 C3 C18 | 3 | 4.7uF 10V X5R 0402 | C23733 | base | 0.0118 | 0402 | CL05A475MP5NRNC
C4 C7 | 2 | 10uF 6.3V X5R 0402 | C15525 | base | 0.0257 | 0402 | CL05A106MQ5NUNC
C11 C12 | 2 | 12pF C0G 0201 | C85890 | expand | 0.005 | 0201 | GRM0335C1H120JA01D
C13 C14 | 2 | 10pF C0G 0201 | C76921 | expand | 0.0032 | 0201 | GRM0335C1H100JA01D
C19 C23 | 2 | 100pF C0G 0201 | C76922 | expand | 0.0067 | 0201 | GRM0335C1H101JA01D
CM1 | 1 | 1.0pF C0G 0201 high-Q | C237514 | expand | 0.0197 | 0201 | GJM0335C1H1R0BB01D
LM1 | 1 | 3.3nH 0201 LQP03TN3N3B02D | C98045 | expand | 0.0128 | 0201 | LQP03TN3N3B02D
RT1 | 1 | 0R 0201 | C473473 | expand | 0.0011 | 0201 | 0201WMF0000TEE
R1 | 1 | 6.04k 1% 0201 | C270341 | expand | 0.0014 | 0201 | 0201WMF6041TEE
R12 R16 | 2 | 1k 1% 0201 | C270365 | expand | 0.0012 | 0201 | 0201WMF1001TEE
R5 R6 R7 | 3 | 100R 1% 0201 | C77623 | expand | 0.0023 | 0201 | RC0201FR-07100RL
R13 | 1 | 10k 0.1% 0201 | C852211 | expand | 0.0581 | 0201 | RT0201BRD0710KL
R3 R4 | 2 | 4.7k 1% 0402 | C25900 | base | 0.0017 | 0402 | 0402WGF4701TCE
R14 | 1 | 1M 1% 0201 | C473482 | expand | 0.0015 | 0201 | 0201WMF1004TEE
R15 | 1 | 470k 1% 0201 | C473560 | expand | 0.0012 | 0201 | 0201WMF4703TEE
