Het-Bhavsar/Atrium/hardware/case/charging-case/production/Atrium_Charging_Case_BOM.csv

No. | Quantity | Comment | Designator | Footprint | Value | Manufacturer Part | Manufacturer | Supplier Part | Supplier
1 | 3 | 10uF | C1,C3,C5 | C0603 | 10uF | CL10A106KP8NNNC | SAMSUNG(三星) | C19702 | LCSC
2 | 1 | 4.7uF | C2 | C0603 | 4.7uF | CL10A475KO8NNNC | SAMSUNG(三星) | C19666 | LCSC
3 | 1 | 22uF | C4 | C0805 | 22uF | CL21A226MAYNNNE | SAMSUNG(三星) | C602037 | LCSC
4 | 4 | 1uF | C6,C8,C13,C14 | C0402 | 1uF | CL05A105KA5NQNC | SAMSUNG(三星) | C52923 | LCSC
5 | 6 | 100nF | C7,C9,C10,C11,C12,C15 | C0402 | 100nF | CL05B104KO5NNNC | SAMSUNG(三星) | C1525 | LCSC
6 | 1 | 100pF | C16 | C0603 | 100pF | CL10C101JB8NNNC | SAMSUNG(三星) | C14858 | LCSC
7 | 2 | 1N5819WS | D1,D2 | SOD-323_L1.8-W1.3-LS2.5-RD |  | 1N5819WS | Hottech(合科泰) | C191023 | LCSC
8 | 1 | XL-1615RGBC-RF | D3 | LED-ARRAY-SMD_4P-L1.6-W1.5-BR_XL-1615RGBC-RF |  | XL-1615RGBC-RF | XINGLIGHT(成兴光) | C965840 | LCSC
9 | 1 | TSD05DYFR | D4 | SOD-323_L1.7-W1.3-LS2.6_DYF0002A |  | TSD05DYFR | TI(德州仪器) | C22396185 | LCSC
10 | 1 | TYPE-C 16PIN 2MD(073) | J1 | USB-C-SMD_TYPE-C-16PIN-2MD-073 |  | TYPE-C 16PIN 2MD(073) | SHOU HAN(首韩) | C2765186 | LCSC
11 | 1 | 1uH | L1 | IND-SMD_L2.5-W2.0_WPN252012H | 1uH | WPN252012H1R0MT | Sunlord(顺络) | C98348 | LCSC
12 | 2 | 5.1kΩ | R1,R2 | R0402 | 5.1kΩ | 0402WGF5101TCE | UNI-ROYAL(厚声) | C25905 | LCSC
13 | 2 | 2.2kΩ | R3,R4 | R0402 | 2.2kΩ | 0402WGF2201TCE | UNI-ROYAL(厚声) | C25879 | LCSC
14 | 1 | 2.7kΩ | R5 | R0402 | 2.7kΩ | 0402WGF2701TCE | UNI-ROYAL(厚声) | C25885 | LCSC
15 | 1 | 768kΩ | R6 | R0402 | 768kΩ | 0402WGF7683TCE | UNI-ROYAL(厚声) | C27017 | LCSC
16 | 3 | 100kΩ | R7,R20,R25 | R0402 | 100kΩ | 0402WGF1003TCE | UNI-ROYAL(厚声) | C25741 | LCSC
17 | 4 | 1MΩ | R8,R10,R17,R18 | R0402 | 1MΩ | 0402WGF1004TCE | UNI-ROYAL(厚声) | C26083 | LCSC
18 | 1 | 15kΩ | R9 | R0402 | 15kΩ | 0402WGF1502TCE | UNI-ROYAL(厚声) | C25756 | LCSC
19 | 1 | 10kΩ | R11 | R0402 | 10kΩ | 0402WGF1002TCE | UNI-ROYAL(厚声) | C25744 | LCSC
20 | 1 | 1.5MΩ | R12 | R0402 | 1.5MΩ | 0402WGF1504TCE | UNI-ROYAL(厚声) | C22276 | LCSC
21 | 2 | 1kΩ | R13,R21 | R0402 | 1kΩ | 0402WGF1001TCE | UNI-ROYAL(厚声) | C11702 | LCSC
22 | 1 | 20kΩ | R14 | R0402 | 20kΩ | 0402WGF2002TCE | UNI-ROYAL(厚声) | C25765 | LCSC
23 | 2 | 100Ω | R15,R16 | R0402 | 100Ω | 0402WGF1000TCE | UNI-ROYAL(厚声) | C25076 | LCSC
24 | 1 | 330kΩ | R19 | R0402 | 330kΩ | 0402WGF3303TCE | UNI-ROYAL(厚声) | C25778 | LCSC
25 | 2 | 330Ω | R22,R23 | R0402 | 330Ω | 0402WGF3300TCE | UNI-ROYAL(厚声) | C25104 | LCSC
26 | 1 | 2kΩ | R24 | R0402 | 2kΩ | 0402WGF2001TCE | UNI-ROYAL(厚声) | C4109 | LCSC
27 | 1 | 1Ω | RS1 | R0603 | 1Ω | 0603WAF100KT5E | UNI-ROYAL(厚声) | C22936 | LCSC
28 | 1 | SKSCLAE010 | SW1 | SW-SMD_4P-L3.5-W2.9-P1.30-LS4.8 |  | SKSCLAE010 | ALPSALPINE(阿尔卑斯阿尔派) | C130445 | LCSC
29 | 1 | NCU15WF104F6SRC | TH1 | R0402 |  | NCU15WF104F6SRC | muRata(村田) | C458473 | LCSC
30 | 1 | NCP15XH103F03RC | TH2 | R0402 |  | NCP15XH103F03RC | muRata(村田) | C77131 | LCSC
31 | 1 | CH32V003F4U6 | U1 | QFN-20_L3.0-W3.0-P0.40-TL-EP1.7 |  | CH32V003F4U6 | WCH(南京沁恒) | C5299908 | LCSC
32 | 1 | BQ24040DSQR | U2 | WSON-10_L2.0-W2.0-P0.40-BL-EP |  | BQ24040DSQR | TI(德州仪器) | C81080 | LCSC
33 | 1 | TPS61023DRLR | U3 | SOT-563-6_L1.6-W1.2-P0.5-LS1.6-BR |  | TPS61023DRLR | TI(德州仪器) | C919459 | LCSC
34 | 1 | SY6280AAC | U4 | SOT-23-5_L3.0-W1.7-P0.95-LS2.8-BL |  | SY6280AAC | Silergy(矽力杰) | C55136 | LCSC
35 | 2 | SN74LVC1T45DBVR | U5,U6 | SOT-23-6_L2.9-W1.6-P0.95-LS2.8-BR |  | SN74LVC1T45DBVR | TI(德州仪器) | C7843 | LCSC
36 | 1 | XC6206P182MR | U7 | SOT-23-3_L2.9-W1.6-P1.90-LS2.8-BR |  | XC6206P182MR | TOREX(特瑞仕) | C21659 | LCSC
37 | 1 | HAL248 SW | U8 | DFN-6_HAL248_SW |  | HAL248 SW | Hallwee(霍尔微电子) | C6320892 | LCSC
