Het-Bhavsar/Atrium/hardware/pod/pcb/placement/pod_placement.csv

ref | side | x_mm | y_mm | w_mm | h_mm | max_height_mm | label
C2 | top | 5.2 | 5.6 | 0.5 | 1.0 | 0.5 | 4u7 VBAT
U7 | top | 6.4 | 3.6 | 1.0 | 1.5 | 0.5 | TPS62840
L1 | top | 6.4 | 1.9 | 1.6 | 0.8 | 0.8 | 2u2
C3 | top | 7.6 | 3.6 | 0.5 | 1.0 | 0.5 | 4u7 Cin
C4 | top | 8.0 | 2.0 | 1.0 | 0.5 | 0.5 | 10u Cout
R2 | top | 5.4 | 4.0 | 0.3 | 0.6 | 0.3 | VSET
U6 | top | 7.2 | 10.8 | 2.0 | 2.0 | 0.8 | MAX17048
C5 | top | 5.6 | 9.6 | 0.5 | 1.0 | 0.5 | 1u FG
U2 | top | 13.0 | 4.0 | 1.7 | 1.8 | 0.5 | MAX86174A
C7 | top | 11.0 | 2.6 | 1.0 | 0.5 | 0.55 | 10u VLED
C8 | top | 11.0 | 3.6 | 0.6 | 0.3 | 0.3 | 100n VLED
C9 | top | 14.8 | 4.0 | 0.5 | 1.0 | 0.5 | 1u VDD
C10 | top | 13.0 | 2.2 | 1.0 | 0.5 | 0.5 | VREF cap
R3 | top | 13.6 | 9.6 | 1.0 | 0.5 | 0.35 | 4k7 SDA
R4 | top | 13.6 | 10.4 | 1.0 | 0.5 | 0.35 | 4k7 SCL
R5 | top | 15.2 | 9.2 | 0.6 | 0.3 | 0.3 | 100R SWDIO
R6 | top | 15.2 | 9.9 | 0.6 | 0.3 | 0.3 | 100R SWCLK
R7 | top | 15.2 | 10.6 | 0.6 | 0.3 | 0.3 | 100R RST
U1 | top | 18.2 | 7.0 | 3.0 | 3.2 | 0.5 | nRF52832
Y1 | top | 18.6 | 10.4 | 2.0 | 1.6 | 0.6 | 32 MHz
C11 | top | 16.9 | 9.9 | 0.6 | 0.3 | 0.3 | 12p
C12 | top | 16.9 | 10.6 | 0.6 | 0.3 | 0.3 | 12p
Y2 | top | 15.3 | 7.6 | 1.6 | 1.0 | 0.5 | 32.768k
C13 | top | 15.0 | 6.5 | 0.6 | 0.3 | 0.3 | 10p
C14 | top | 15.9 | 6.5 | 0.6 | 0.3 | 0.3 | 10p
C15 | top | 15.9 | 5.3 | 0.6 | 0.3 | 0.3 | DEC1 100n
C16 | top | 17.4 | 4.6 | 1.0 | 0.5 | 0.5 | DEC4 1u
C17 | top | 19.0 | 4.6 | 1.0 | 0.5 | 0.5 | VDD 100n
C18 | top | 17.4 | 3.6 | 1.0 | 0.5 | 0.5 | VDD 4u7
C19 | top | 19.0 | 3.7 | 0.6 | 0.3 | 0.3 | DEC2/3
CM1 | top | 20.2 | 7.8 | 0.3 | 0.6 | 0.3 | match C
LM1 | top | 20.8 | 7.0 | 0.6 | 0.3 | 0.3 | match L
CM2 | top | 21.4 | 7.8 | 0.3 | 0.6 | 0.3 | match C
CT1 | top | 22.2 | 7.8 | 0.3 | 0.6 | 0.3 | tune DNP
RT1 | top | 22.8 | 7.0 | 0.6 | 0.3 | 0.3 | 0R
CT2 | top | 23.25 | 7.8 | 0.3 | 0.6 | 0.3 | tune DNP
AE1 | top | 26.0 | 7.6 | 1.728 | 4.368 | 0.6 | chip ant
D2 | skin | 2.2 | 7.0 | 1.9 | 1.7 | 0.55 | SFH 7016
PD1 | skin | 8.2 | 7.0 | 4.1 | 5.2 | 0.85 | VEMD5080 near
U4 | skin | 14.0 | 7.0 | 2.0 | 2.0 | 0.8 | TMP117
C20 | skin | 14.0 | 5.4 | 0.6 | 0.3 | 0.3 | 100n TMP
PD2 | skin | 20.7 | 7.0 | 4.1 | 5.2 | 0.85 | VEMD5080 far
U3 | top | 10.4 | 11.0 | 3.0 | 2.5 | 0.83 | LSM6DSV16X
C6 | top | 12.4 | 11.0 | 0.5 | 1.0 | 0.5 | 100n IMU
U8 | top | 12.0 | 7.3 | 4.0 | 3.0 | 0.55 | W25Q64JW
C21 | top | 12.0 | 9.3 | 0.6 | 0.3 | 0.3 | 100n FLASH
TP1 | top | 9.0 | 4.4 | 0.8 | 0.8 | 0.05 | LED4 test
D1 | skin | 8.6 | 10.6 | 0.6 | 0.3 | 0.3 | ESDA5-1F4
J1.1 | skin | 9.0 | 12.0 | 1.2 | 1.2 | 0.0 | VBUS
J1.2 | skin | 11.54 | 12.0 | 1.2 | 1.2 | 0.0 | GND
J1.3 | skin | 14.08 | 12.0 | 1.2 | 1.2 | 0.0 | SWCLK
J1.4 | skin | 16.62 | 12.0 | 1.2 | 1.2 | 0.0 | SWDIO
J1.5 | skin | 19.16 | 12.0 | 1.2 | 1.2 | 0.0 | nRESET
U5 | top | 1.9 | 7.0 | 1.2 | 1.6 | 0.5 | BQ25101 DSBGA-6
R1 | top | 1.9 | 9.0 | 0.6 | 0.3 | 0.3 | ISET
C1 | top | 1.9 | 5.0 | 1.0 | 0.5 | 0.5 | 1u IN
TH2 | top | 3.3 | 7.0 | 0.6 | 0.3 | 0.3 | NTC cell (TS)
BT+ | top | 3.6 | 4.4 | 1.4 | 1.2 | 0.1 | cell + tab
BT- | top | 3.6 | 9.6 | 1.4 | 1.2 | 0.1 | cell - tab
U9 | top | 4.9 | 8.0 | 1.2 | 1.2 | 0.4 | LPB1010 prot
R12 | top | 4.9 | 6.4 | 0.6 | 0.3 | 0.3 | prot VDD R
C22 | top | 4.9 | 6.9 | 0.6 | 0.3 | 0.3 | prot VDD C
TH1 | top | 0.9 | 7.0 | 0.3 | 0.6 | 0.3 | NTC edge ref
R13 | top | 1.9 | 9.5 | 0.6 | 0.3 | 0.3 | NTC div 10k
