Het-Bhavsar/Atrium/mechanical/case/STEP/case_assembly.step

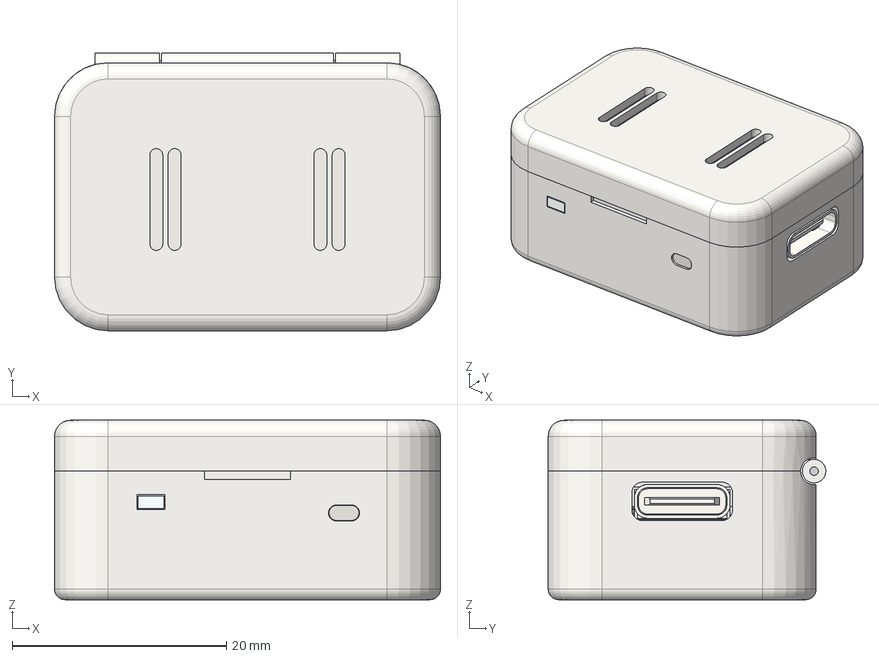
[picture p125: CAD file, 2026-11-09]
mechanical/case/STEP/case_assembly.step
36.0 x 25.9 x 16.8 mm
case_tub
case_deck
cell_kp502030
cell_foam
pogo_vin
pogo_gnd
pogo_swdio
pogo_swdclk
nest_magnet_1 x 2
board
hinge_pin
light_pipe
button_cap
cell_lead_pos
cell_lead_neg
case_lid
lid_pad_foam
lid_magnet
base
window_gasket
island_power
island_radio
ant1
u1
l3 x 7
z41 x 2
c6 x 2
c4 x 5
c7 x 4
l2
l1
y1
c1 x 2
u2
c30
r3
r53
r5 x 2
d12
r11
r41
r2
d13
r52 x 2
r10
r1
u11
u10
u13
c51
u12
c53
d10
c50
c60
th5
c63 x 3
c52
maxm86161
cell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
