Het-Bhavsar/Atrium/hardware/case/mechanical/STEP/atrium_case_assembly_lid_off_revB1-1.step

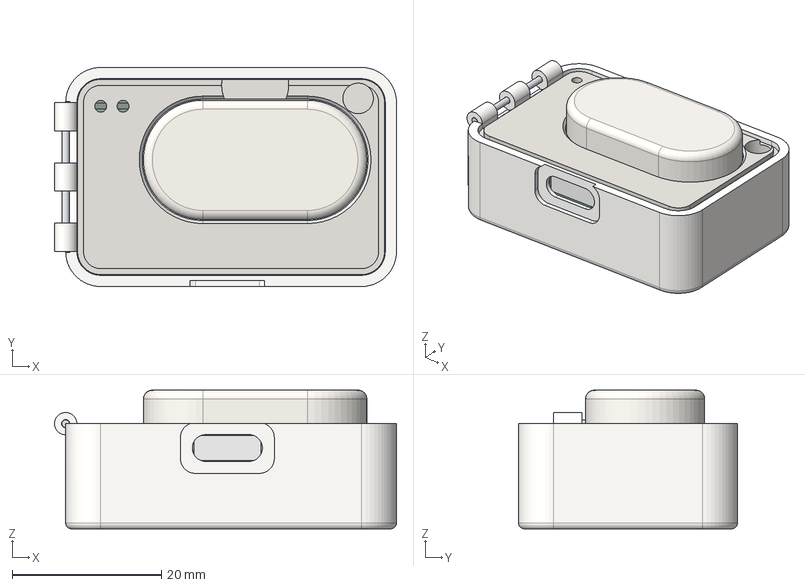
[picture p126: CAD file, 2026-11-06]
hardware/case/mechanical/STEP/atrium_case_assembly_lid_off_revB1-1.step
45.9 x 29.4 x 18.6 mm
case_base
cell_LP602525
cell_foam
case_pcb
J1
D1
R1 x 10
C1 x 4
U1 x 2
C8 x 21
LED1 x 2
U2 x 2
L1 x 2
U3 x 4
R10
C6
BTp x 4
NTC
P1
P2
case_cradle
hinge_pin_ss_d1
pod_top_shell
window_frame_black_pc
clear_led
clear_pd1
clear_pd2
thermal_button_316L
thermal_gap_pad
pod_pcb
C2 x 5
U7
C4 x 6
R2 x 6
U6
C7
R3 x 2
Y1
Y2
D2
PD1 x 2
U4
C20 x 2
U8
TP1
pad_J1_1 x 5
U5
U9
antenna_riser_fr4
AE1
cell_insulator_pi_tape
cell_301020
tab_pos
tab_neg
poron_swell_pad
pogo_seal_gasket
