Het-Bhavsar/Atrium/mechanical/pod/STEP/atrium_pod_assembly_ref.step

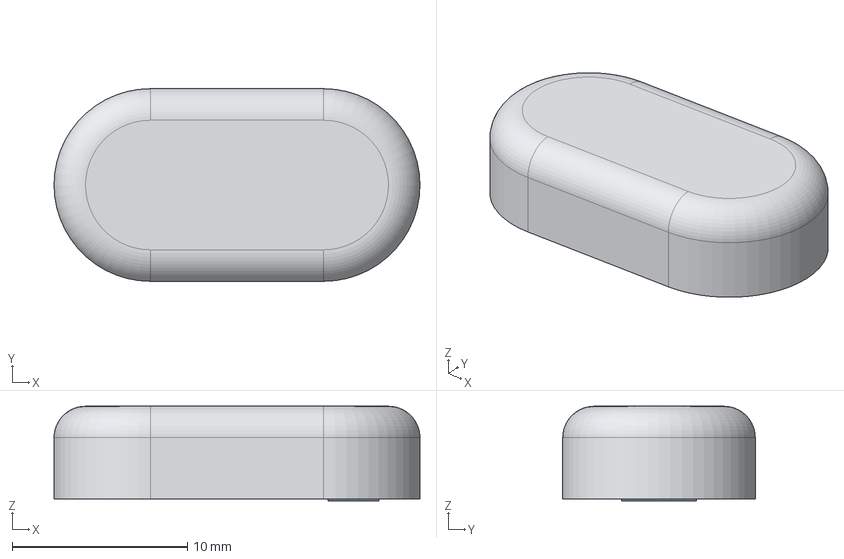
[picture p129: CAD file, 2026-11-09]
mechanical/pod/STEP/atrium_pod_assembly_ref.step
20.9 x 11.0 x 5.40 mm
base
window_gasket
island_power
island_radio
ant1
u1
l3 x 7
z41 x 2
c6 x 2
c4 x 5
c7 x 4
l2
l1
y1
c1 x 2
u2
c30
r3
r53
r5 x 2
d12
r11
r41
r2
d13
r52 x 2
r10
r1
u11
u10
u13
c51
u12
c53
d10
c50
c60
th5
c63 x 3
c52
maxm86161
cell
stiffener_sus430
flex
pad_vin x 5
