Het-Bhavsar/Atrium/hardware/pod/mechanical/STEP/atrium_pod_assembly_docked_revB1-1.step

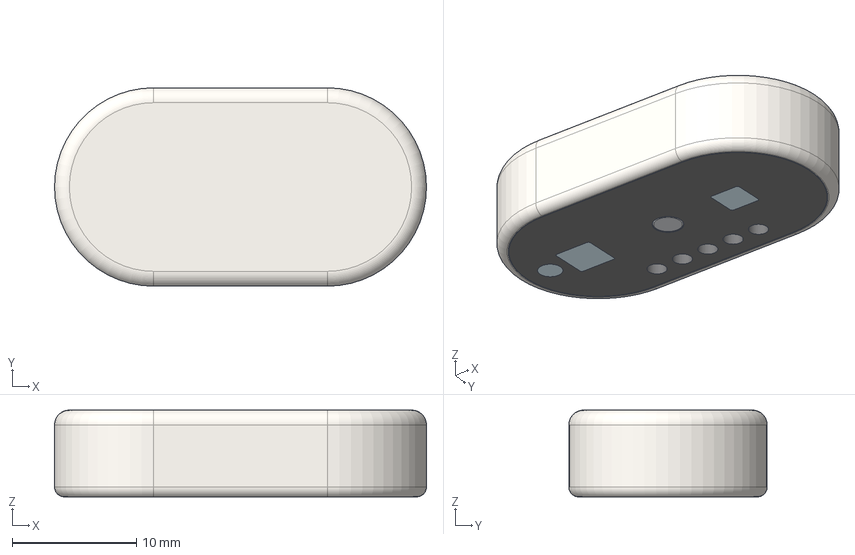
[picture p130: CAD file, 2026-11-06]
hardware/pod/mechanical/STEP/atrium_pod_assembly_docked_revB1-1.step
30.0 x 16.0 x 7.00 mm
pod_top_shell
window_frame_black_pc
clear_led
clear_pd1
clear_pd2
thermal_button_316L
thermal_gap_pad
pod_pcb
C2 x 5
U7
L1
C4 x 6
R2 x 6
U6
U2
C7
C8 x 18
R3 x 2
U1
Y1
Y2
D2
PD1 x 2
U4
C20 x 2
U3
U8
TP1
pad_J1_1 x 5
U5
BTp x 2
U9
antenna_riser_fr4
AE1
cell_insulator_pi_tape
cell_301020
tab_pos
tab_neg
poron_swell_pad
pogo_seal_gasket
