Het-Bhavsar/Atrium/hardware/case/charging-case/pcb/Atrium_Charging_Case.step

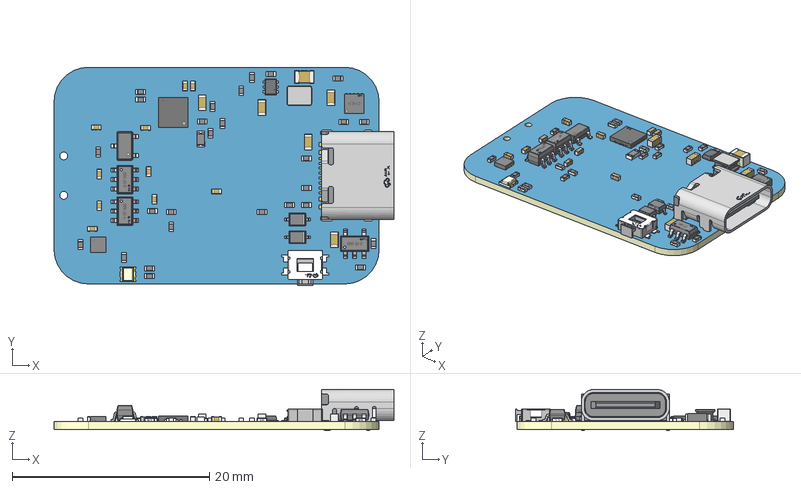
[picture p132: CAD file, 2026-11-14]
hardware/case/charging-case/pcb/Atrium_Charging_Case.step
34.5 x 22.2 x 4.16 mm
Board~pKXz
TopCopper~pKXz
BottomCopper~pKXz
TopSilkscreen~pKXz
BottomSilkscreen~pKXz
TopFpcStiffener~pKXz
BottomFpcStiffener~pKXz
C0603~C0603_L1.6-W0.8-H0.8~8BYh x 5
C0805~C0805_L2.0-W1.3-H1.3~7R14
C0402~C0402_L1.0-W0.5-H0.5~tspA x 10
IND-SMD_L2.5-W2.0_WPN252012H~IND-SMD_L2.5-W2.0-H1.2-252012~Cclq
USB-C-SMD_TYPE-C-16PIN-2MD-073~USB-C-SMD_TYPE-C-6PIN-2MD-073~yYUe
R0402~R0402_L1.0-W0.5-H0.4~k0I0 x 27
R0603~R0603~Pg0i
SW-SMD_4P-L3.5-W2.9-P1.30-LS4.8~SW-SMD_4P-L3.5-W2.9-P1.30-LS4~wOro
SOT-23-5_L3.0-W1.7-P0.95-LS2.8-BL~SOT-23-5_L2.9-W1.6-H1.1-LS2.8-P0.95~0y2Z
DFN-6_HAL248_SW~DFN-6_HAL248_SW~TSv2
SOT-23-6_L2.9-W1.6-P0.95-LS2.8-BR~SOT-23-6_L2.9-W1.6-H1.5-LS2.8-P0.95~ZigJ x 2
SOT-23-3_L2.9-W1.6-P1.90-LS2.8-BR~SOT-23-3L_L2.9-W1.6-H1.1-LS2.8-P0.95~hQTJ
SOD-323_L1.8-W1.3-LS2.5-RD~SOD-323_L1.8-W1.3-LS2.5-RD~6GKj x 2
QFN-20_L3.0-W3.0-P0.40-TL-EP1.7~QFN-20_L3.0-W3.0-H0.6-P0.40-BL~Cok4
LED-ARRAY-SMD_4P-L1.6-W1.5-BR_XL-1615RGBC-RF~LED-ARRAY-SMD_4P-L1.6-W1.5-BR_XL-1615RGBC-RF~3sAM
SOT-563-6_L1.6-W1.2-P0.5-LS1.6-BR~SOT-563-6_L1.6-W1.2-P0.5-LS1.6-BL~FM5W
WSON-10_L2.0-W2.0-P0.40-BL-EP~WSON-10_L2.0-W2.0-H0.8-P0.40~UBnM
