Het-Bhavsar/Atrium/hardware/case/mechanical/DXF/atrium_case_pcb_keepouts_revB1-1.dxf

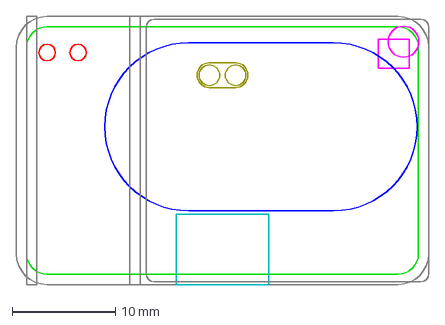
[picture p133: CAD file, 2026-11-06]
hardware/case/mechanical/DXF/atrium_case_pcb_keepouts_revB1-1.dxf
40.0 x 26.0 mm
