Het-Bhavsar/Atrium/hardware/design-data/outline/atrium_outlines.dxf

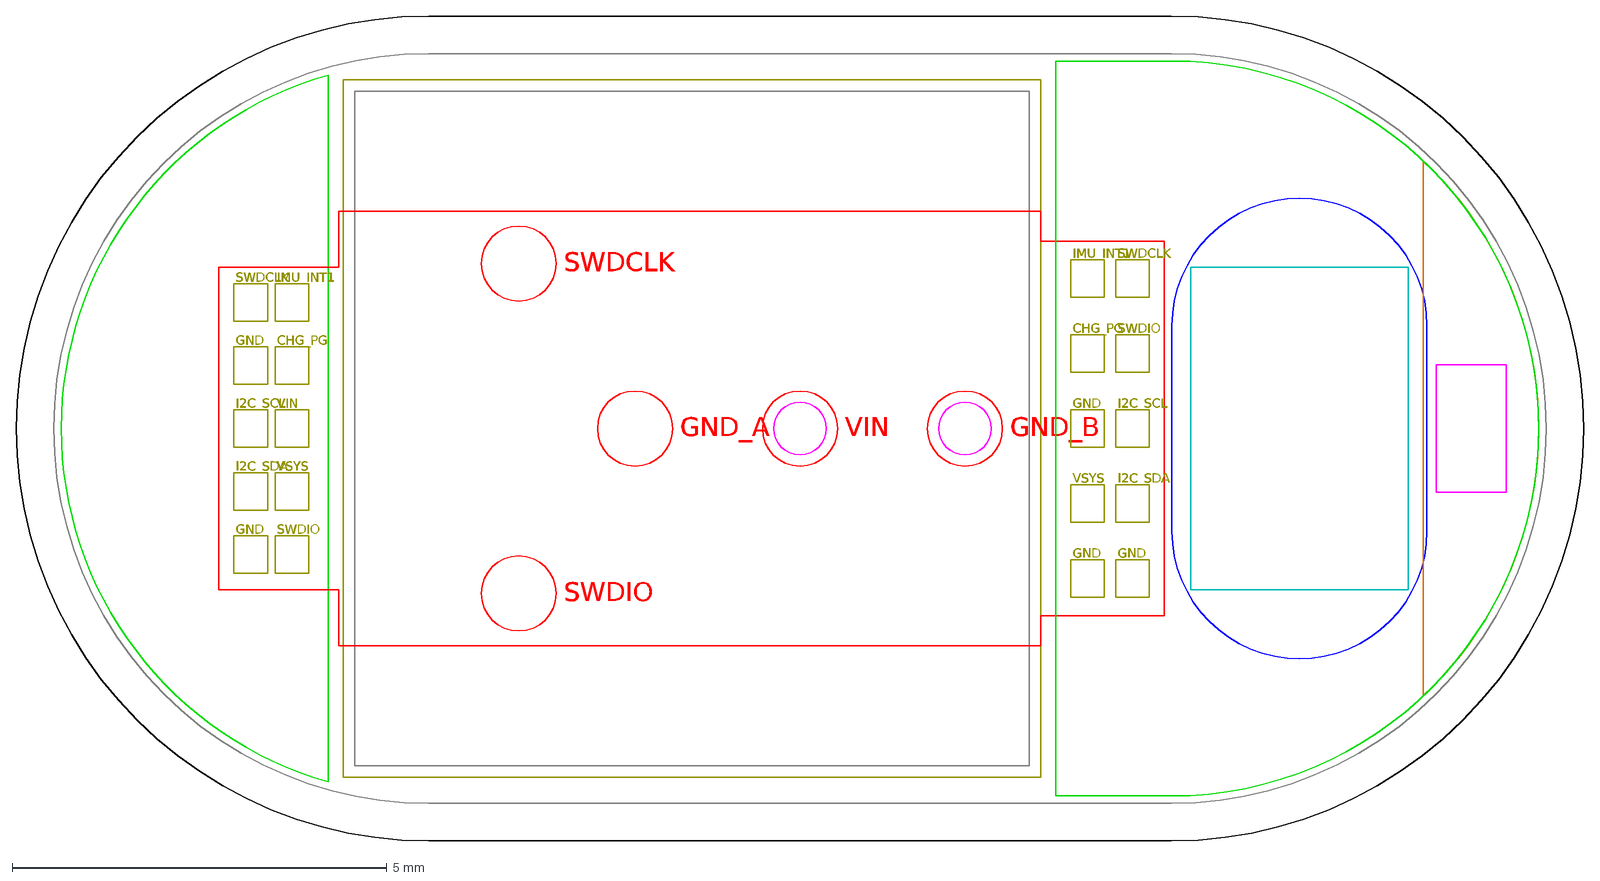
[picture p134: CAD file, 2026-11-09]
hardware/design-data/outline/atrium_outlines.dxf
VIN
GND_A
GND_B
SWDIO
SWDCLK
VSYS
CHG_PG
IMU_INT1
GND
I2C_SDA
I2C_SCL
