Het-Bhavsar/Atrium/hardware/pod/flex-jumper/pcb/Atrium_Flex_Jumper.step

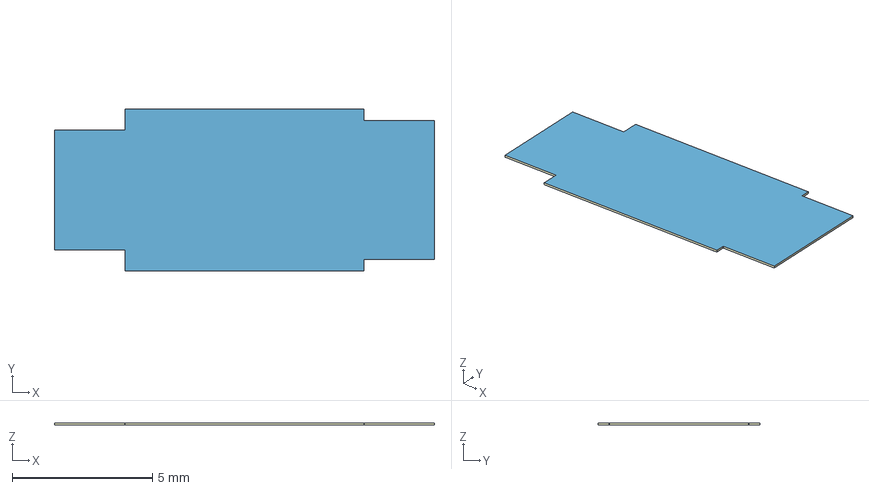
[picture p135: CAD file, 2026-11-10]
hardware/pod/flex-jumper/pcb/Atrium_Flex_Jumper.step
13.6 x 5.77 x 0.0865 mm
Board~kOEA
TopCopper~kOEA
BottomCopper~kOEA
TopSilkscreen~kOEA
BottomSilkscreen~kOEA
TopFpcStiffener~kOEA
BottomFpcStiffener~kOEA
