Het-Bhavsar/Atrium/hardware/pod/mechanical/DXF/atrium_pod_window_apertures_revB1-1.dxf

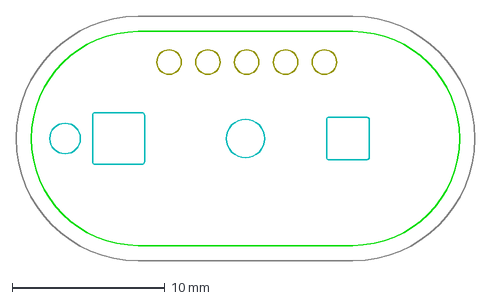
[picture p136: CAD file, 2026-11-06]
hardware/pod/mechanical/DXF/atrium_pod_window_apertures_revB1-1.dxf
30.0 x 16.0 mm
