Het-Bhavsar/Atrium/hardware/pod/mechanical/STEP/atrium_pod_adhesive_foam_0p5_revB1-1.step

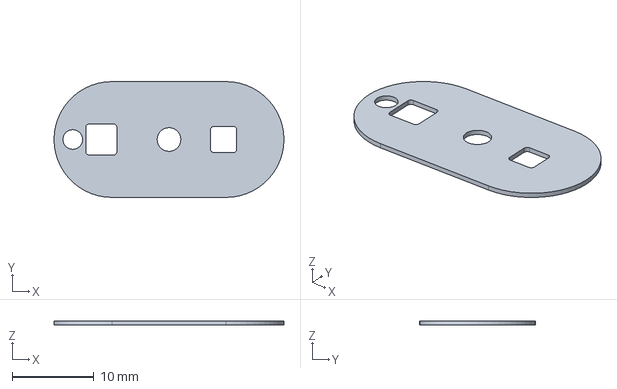
[picture p137: CAD file, 2026-11-06]
hardware/pod/mechanical/STEP/atrium_pod_adhesive_foam_0p5_revB1-1.step
28.2 x 14.2 x 0.5 mm
