Het-Bhavsar/Atrium/hardware/pod/power-island/pcb/Atrium_Power_Island.step

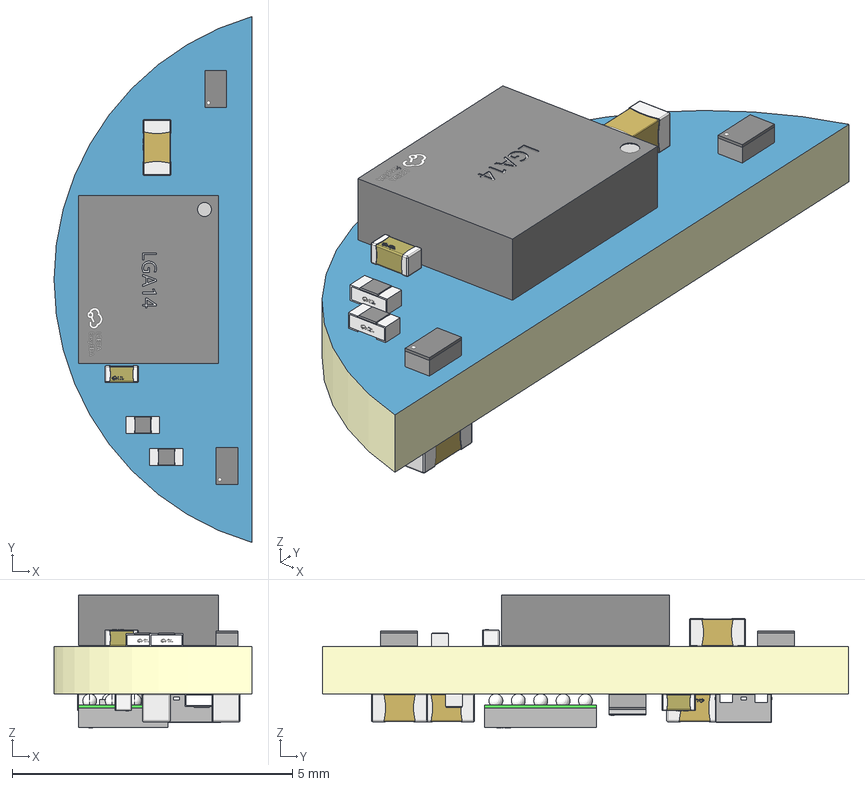
[picture p138: CAD file, 2026-11-10]
hardware/pod/power-island/pcb/Atrium_Power_Island.step
3.53 x 9.39 x 2.37 mm
Board~PRnA
TopCopper~PRnA
BottomCopper~PRnA
TopSilkscreen~PRnA
BottomSilkscreen~PRnA
TopFpcStiffener~PRnA
BottomFpcStiffener~PRnA
C0402~C0402_L1.0-W0.5-H0.5~RNx2 x 4
C0201~C0201_L0.6-W0.3-H0.3~lgNw x 4
X3-DFN0603-2_L0.6-W0.3-RD~X3-DFN0603-2_L0.6-W0.3-H0.3-RD~md1Q x 3
R0201~R0201_L0.6-W0.3-H0.3~Hj0l x 3
DSBGA-20_L2.0-W1.6-R4-C5-P0.40-BL-1~DSBGA-20_L2.0-W1.6-R4-C5-P0.40-BL-1~iCAl
WLCSP-4_L0.6-W0.6-P0.35-R2-C2-TL~WLCSP-4_L0.6-W0.6-H0.4-P0.35-R2-C2-TL~PeVQ
LGA-14L_L3.0-W2.5-P0.50-TL~LGA-14_L2.5-W3.0-H0.9-P0.50~iziV
DFN-4_L1.0-W1.0-P0.65-BL-EP~DFN-4_L1.0-W1.0-H0.5-P0.65-BL-EP~dVFX
