Het-Bhavsar/Atrium/hardware/pod/radio-island/pcb/Atrium_Radio_Island.step

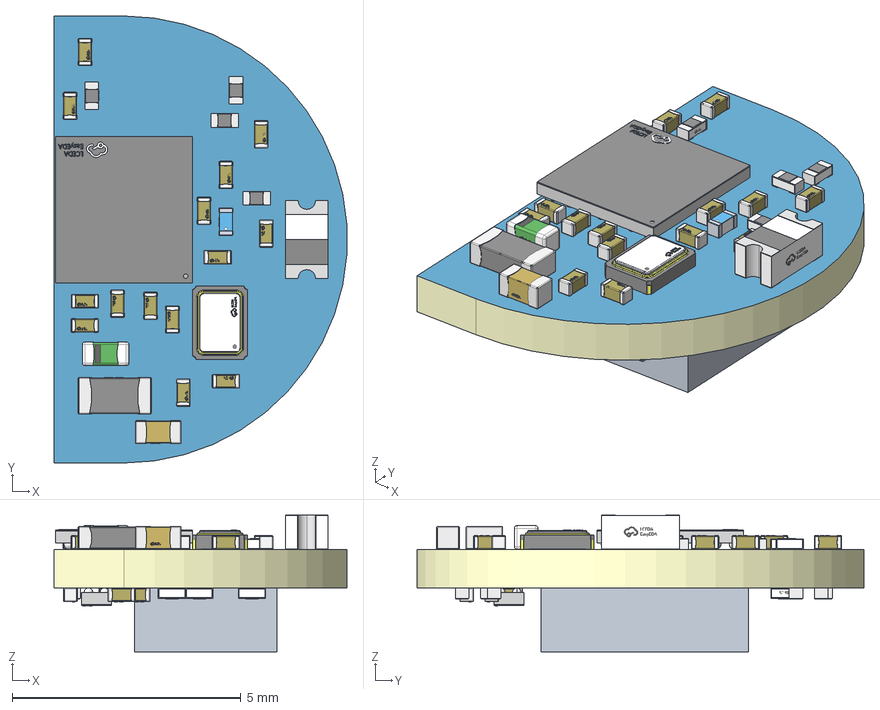
[picture p139: CAD file, 2026-11-11]
hardware/pod/radio-island/pcb/Atrium_Radio_Island.step
6.40 x 9.77 x 2.99 mm
Board~yoqp
TopCopper~yoqp
BottomCopper~yoqp
TopSilkscreen~yoqp
BottomSilkscreen~yoqp
TopFpcStiffener~yoqp
BottomFpcStiffener~yoqp
OLGA-14_L4.3-W2.9-P0.60-TL~default_model~yoqp
C0201~C0201_L0.6-W0.3-H0.3~yxZS x 17
C0402~C0402_L1.0-W0.5-H0.5~6C5L
ANT-SMD_L1.7-W0.9~ANT-SMD_L1.7-W0.9~l4uy
L0603~L0603_L1.6-W0.8-H0.5_BEAD~9Dq8
L0402-R-RD~L0402-R-RD~l3US
R0201~R0201_L0.6-W0.3-H0.3~DvMz x 11
L0201-RD~L0201-RD~nJRH
WLCSP-4_L0.6-W0.6-P0.35-R2-C2-TL~WLCSP-4_L0.6-W0.6-H0.4-P0.35-R2-C2-TL~AMAK
CRYSTAL-SMD_4P-L1.6-W1.2-BL~CRYSTAL-SMD_4P-L1.6-W1.2-BL~g3gU
WLCSP-50_L3.2-W3.0-TL_NRF52832~WLCSP-50_L3.2-W3.0-H0.4-TL_NRF52832~xpUX
