Het-Bhavsar/Atrium/mechanical/case/DXF/case_pcb_outline.dxf

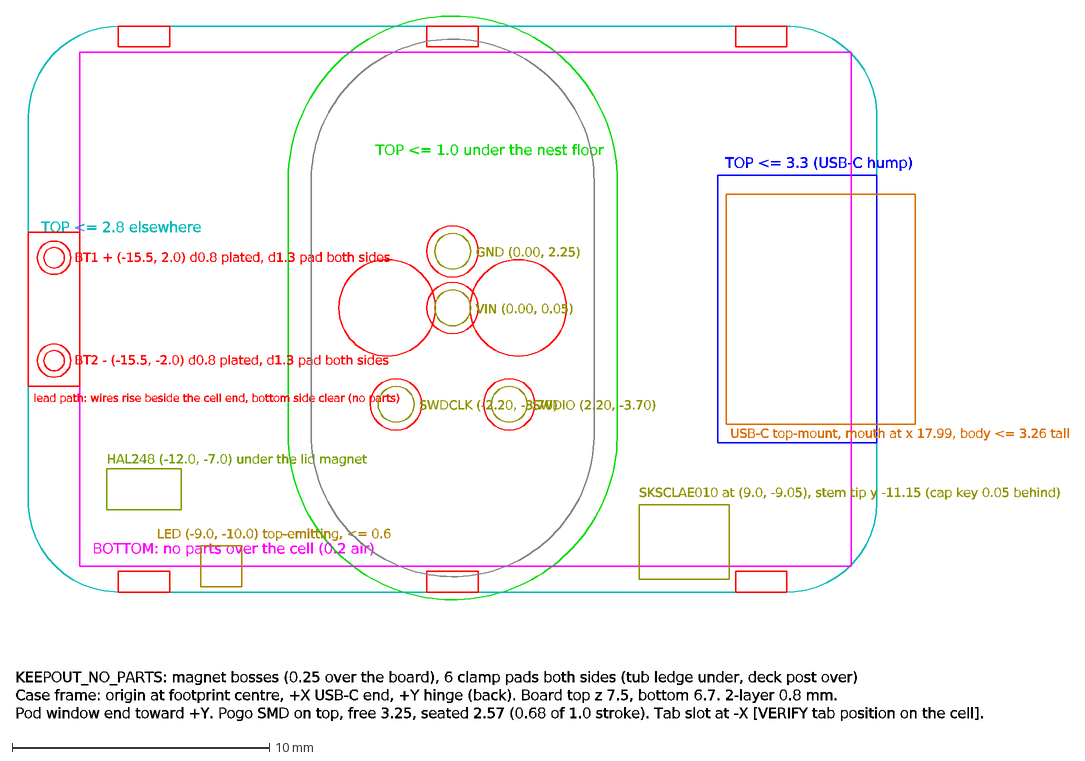
[picture p140: CAD file, 2026-11-09]
mechanical/case/DXF/case_pcb_outline.dxf
TOP <= 1.0 under the nest floor
TOP <= 2.8 elsewhere
TOP <= 3.3 (USB-C hump)
KEEPOUT_NO_PARTS: magnet bosses (0.25 over the board), 6 clamp pads both sides (tub ledge under, deck post over)
BOTTOM: no parts over the cell (0.2 air)
BT1 + (-15.5, 2.0) d0.8 plated, d1.3 pad both sides
BT2 - (-15.5, -2.0) d0.8 plated, d1.3 pad both sides
lead path: wires rise beside the cell end, bottom side clear (no parts)
VIN (0.00, 0.05)
GND (0.00, 2.25)
SWDIO (2.20, -3.70)
SWDCLK (-2.20, -3.70)
USB-C top-mount, mouth at x 17.99, body <= 3.26 tall
LED (-9.0, -10.0) top-emitting, <= 0.6
SKSCLAE010 at (9.0, -9.05), stem tip y -11.15 (cap key 0.05 behind)
HAL248 (-12.0, -7.0) under the lid magnet
Case frame: origin at footprint centre, +X USB-C end, +Y hinge (back). Board top z 7.5, bottom 6.7. 2-layer 0.8 mm.
Pod window end toward +Y. Pogo SMD on top, free 3.25, seated 2.57 (0.68 of 1.0 stroke). Tab slot at -X [VERIFY tab position on the cell].
