Het-Bhavsar/Atrium/mechanical/packaging/STEP/packaging_closed.step

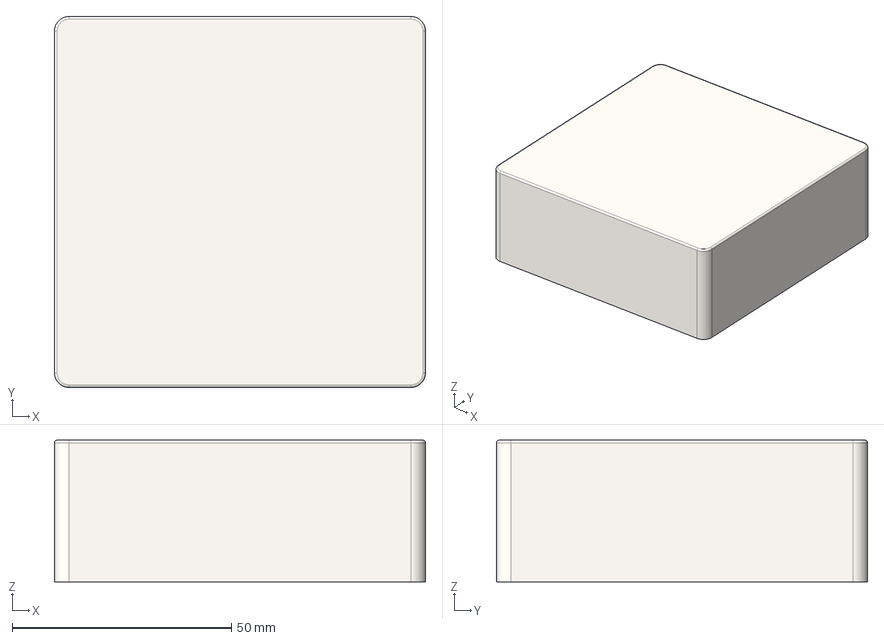
[picture p141: CAD file, 2026-11-09]
mechanical/packaging/STEP/packaging_closed.step
84.6 x 84.6 x 32.3 mm
lid
base x 2
pulp_tray
plinth
plinth_light_ring
window_gasket
maxm86161
pad_vin x 5
card_insert
cable_coil
cable_tie
cable_plug_1
usb_c_shell_1 x 2
cable_plug_2
pad_card_frame
pad_card_liner
skin_pad_1 x 6
