Het-Bhavsar/Atrium/mechanical/plinth/STEP/pod_on_plinth.step

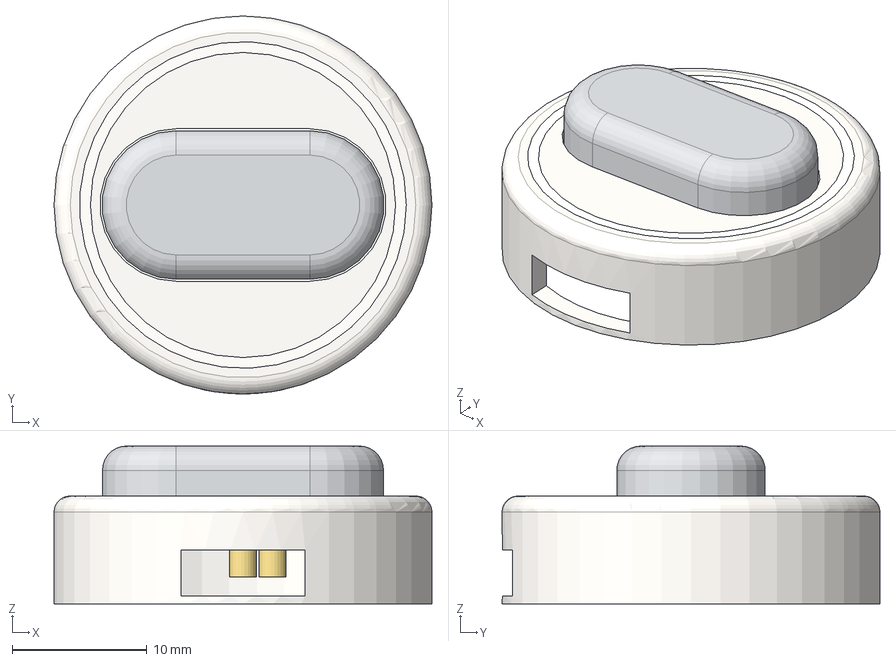
[picture p142: CAD file, 2026-11-09]
mechanical/plinth/STEP/pod_on_plinth.step
28.0 x 28.0 x 11.7 mm
plinth_housing
light_ring
base
window_gasket
cell
stiffener_sus430
board x 2
U3
fpc1
magnet_1 x 2
pogo_vin
pogo_gnd
