Het-Bhavsar/Atrium/mechanical/pod/DXF/skin_adhesive_dieline.dxf

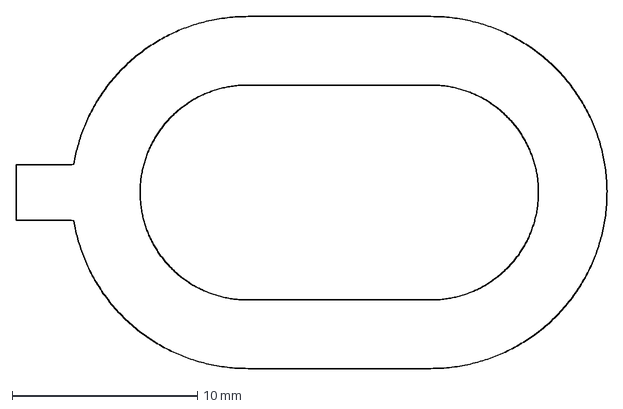
[picture p143: CAD file, 2026-11-09]
mechanical/pod/DXF/skin_adhesive_dieline.dxf
31.9 x 19.0 mm
