Het-Bhavsar/Atrium/mechanical/pod/reference-bodies/STEP/ref_cell_400909.step

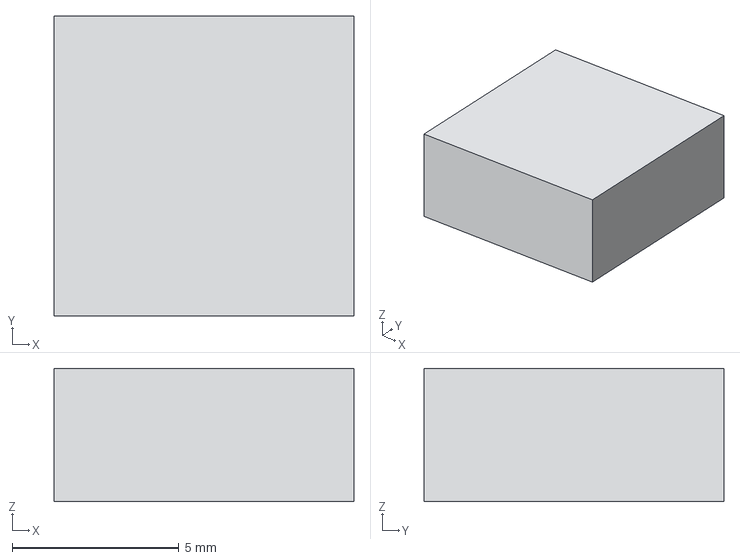
[picture p144: CAD file, 2026-11-09]
mechanical/pod/reference-bodies/STEP/ref_cell_400909.step
9.00 x 9.00 x 4.00 mm
