Het-Bhavsar/Atrium/mechanical/pod/STEP/pod_shell.step

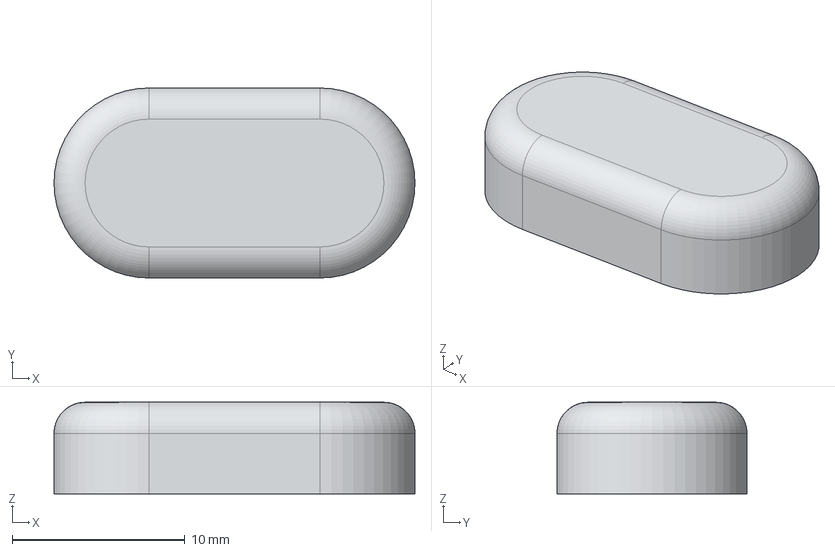
[picture p145: CAD file, 2026-11-09]
mechanical/pod/STEP/pod_shell.step
20.9 x 11.0 x 5.30 mm
