Het-Bhavsar/Atrium/mechanical/programming-jig/STEP/programming_jig.step

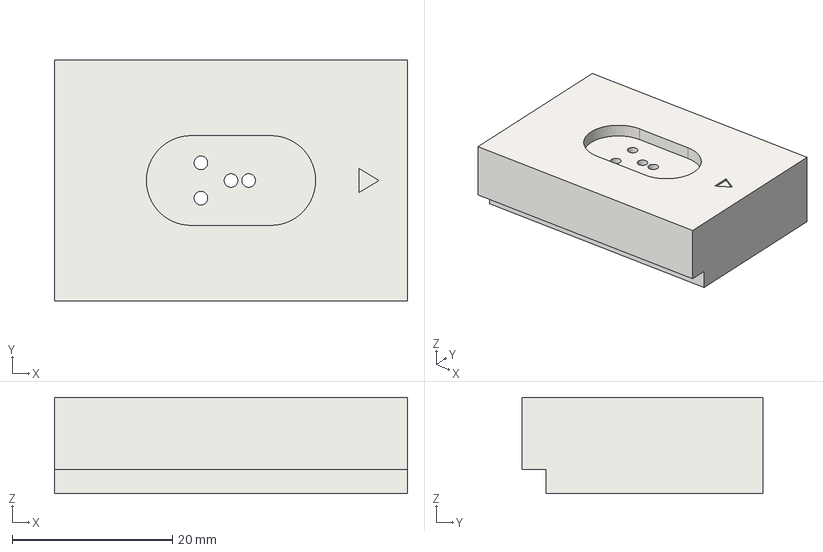
[picture p146: CAD file, 2026-11-09]
mechanical/programming-jig/STEP/programming_jig.step
44.0 x 30.0 x 12.0 mm
