Het-Bhavsar/Atrium/hardware/design-data/outline/board_radio_edge_cuts.dxf

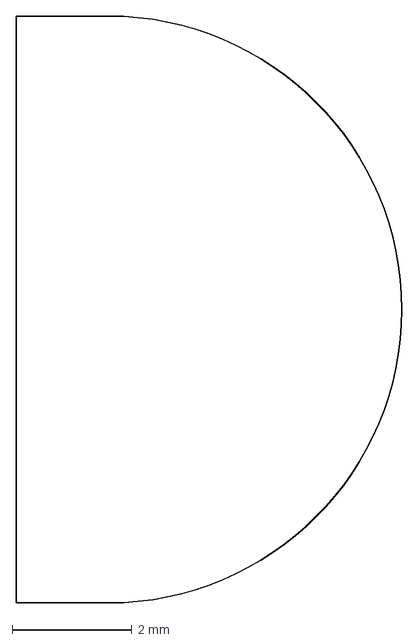
[picture p147: CAD file, 2026-11-09]
hardware/design-data/outline/board_radio_edge_cuts.dxf
6.44 x 9.80 mm
