Het-Bhavsar/Atrium/hardware/pod/mechanical/DXF/atrium_adhesive_diecut_revB1-1.dxf

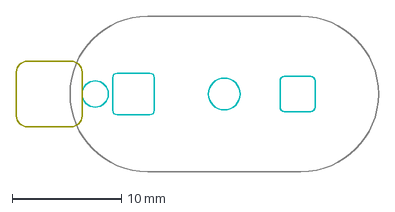
[picture p148: CAD file, 2026-11-06]
hardware/pod/mechanical/DXF/atrium_adhesive_diecut_revB1-1.dxf
33.1 x 14.2 mm
