Het-Bhavsar/Atrium/hardware/pod/mechanical/STEP/atrium_pod_adhesive_diecut_revB1-1.step

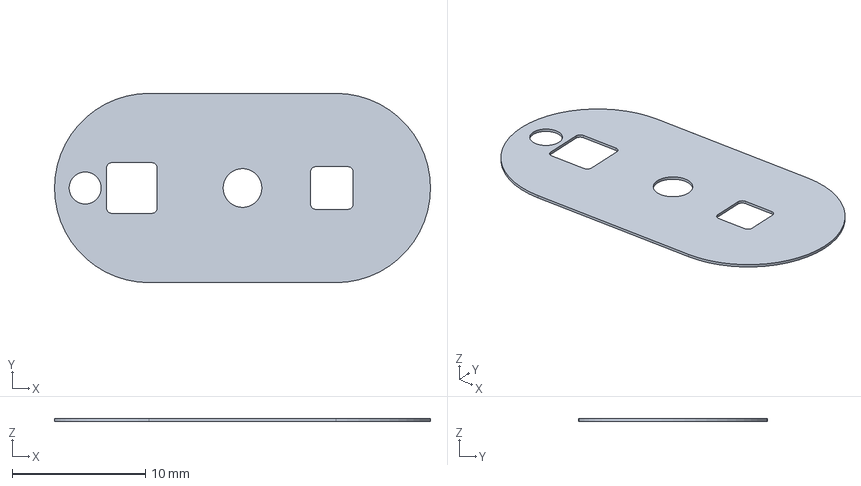
[picture p149: CAD file, 2026-11-06]
hardware/pod/mechanical/STEP/atrium_pod_adhesive_diecut_revB1-1.step
28.2 x 14.2 x 0.2 mm
