Het-Bhavsar/Atrium/mechanical/case/STEP/case_deck.step

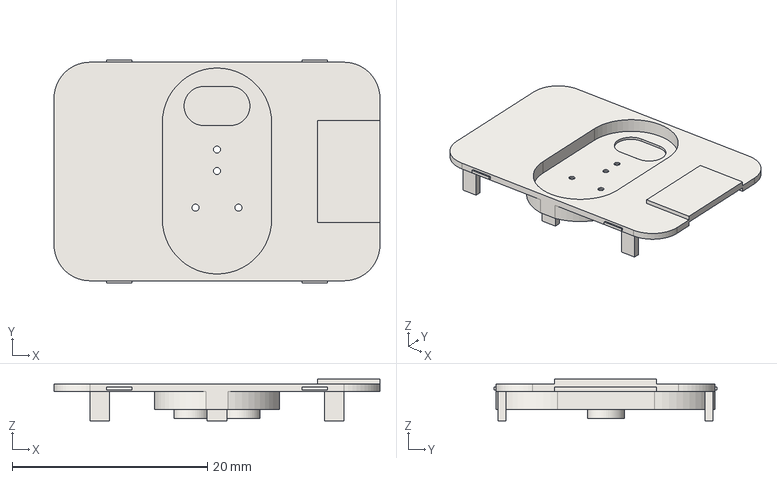
[picture p150: CAD file, 2026-11-09]
mechanical/case/STEP/case_deck.step
33.4 x 22.8 x 4.30 mm
