Het-Bhavsar/Atrium/mechanical/packaging/STEP/packaging_card_insert.step

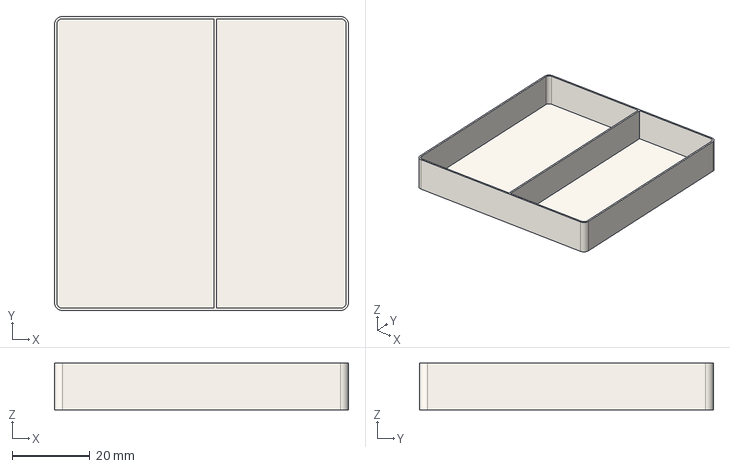
[picture p151: CAD file, 2026-11-09]
mechanical/packaging/STEP/packaging_card_insert.step
75.4 x 75.4 x 12.0 mm
