Het-Bhavsar/Atrium/mechanical/plinth/STEP/plinth_housing.step

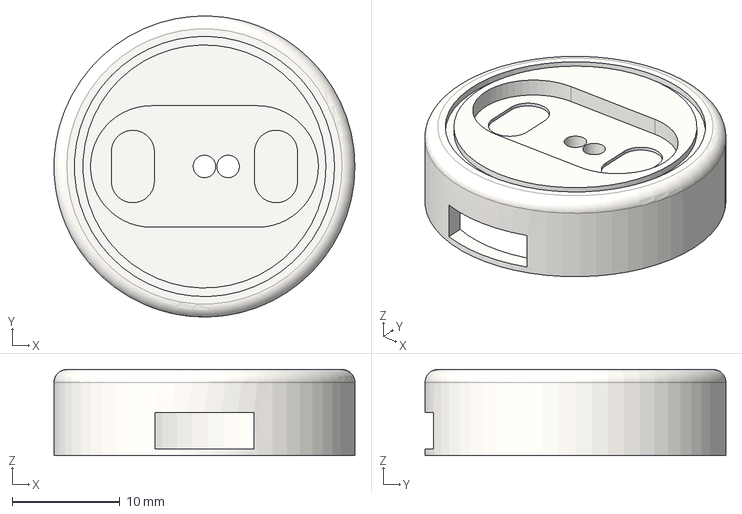
[picture p152: CAD file, 2026-11-09]
mechanical/plinth/STEP/plinth_housing.step
28.0 x 28.0 x 8.00 mm
