Het-Bhavsar/Atrium/mechanical/pod/DXF/skin_pad_dieline.dxf

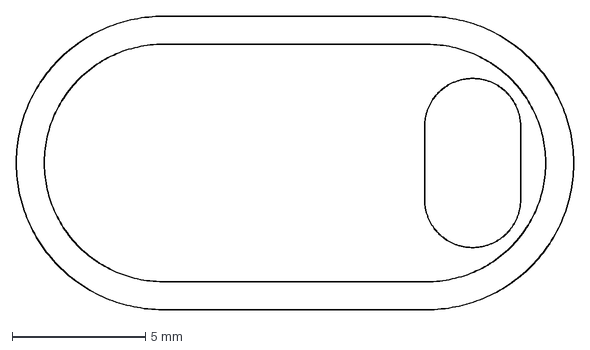
[picture p153: CAD file, 2026-11-09]
mechanical/pod/DXF/skin_pad_dieline.dxf
20.9 x 11.0 mm
