Het-Bhavsar/Atrium/mechanical/pod/reference-bodies/STEP/ref_maxm86161.step

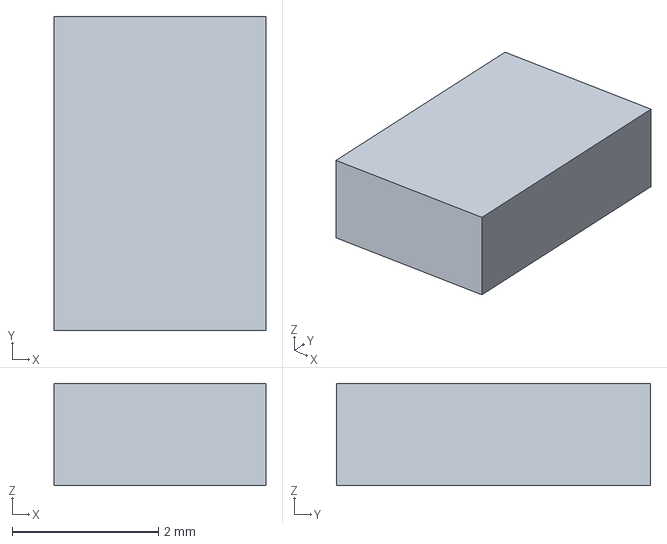
[picture p154: CAD file, 2026-11-09]
mechanical/pod/reference-bodies/STEP/ref_maxm86161.step
2.90 x 4.30 x 1.40 mm
