Het-Bhavsar/Atrium/mechanical/pod/STEP/pod_base.step

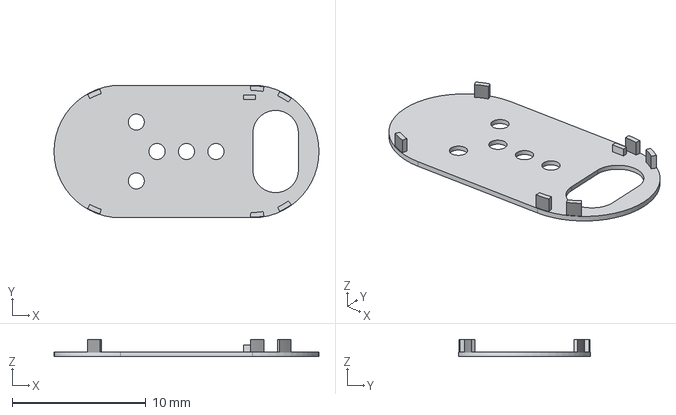
[picture p155: CAD file, 2026-11-09]
mechanical/pod/STEP/pod_base.step
19.8 x 9.90 x 1.30 mm
