Het-Bhavsar/Atrium/hardware/design-data/outline/fpc_outline_edge_cuts.dxf

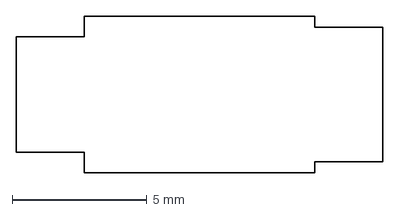
[picture p156: CAD file, 2026-11-09]
hardware/design-data/outline/fpc_outline_edge_cuts.dxf
13.6 x 5.80 mm
