Het-Bhavsar/Atrium/mechanical/case/STEP/case_button.step

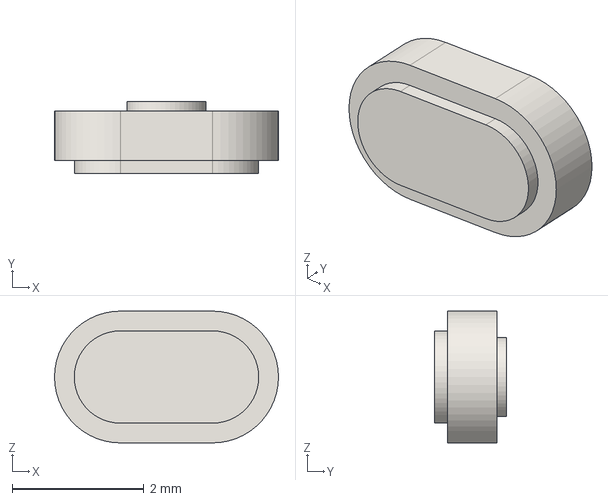
[picture p157: CAD file, 2026-11-09]
mechanical/case/STEP/case_button.step
3.40 x 1.10 x 2.00 mm
