Het-Bhavsar/Atrium/mechanical/packaging/STEP/packaging_pulp_tray.step

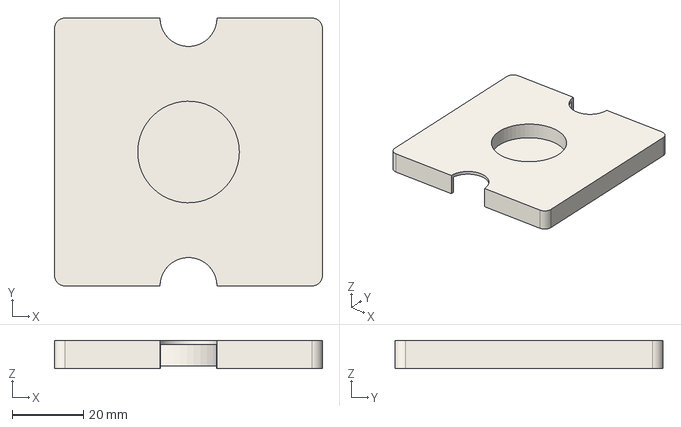
[picture p158: CAD file, 2026-11-09]
mechanical/packaging/STEP/packaging_pulp_tray.step
75.4 x 75.4 x 8.00 mm
