Het-Bhavsar/Atrium/mechanical/pod/reference-bodies/STEP/ref_stiffener_sus430.step

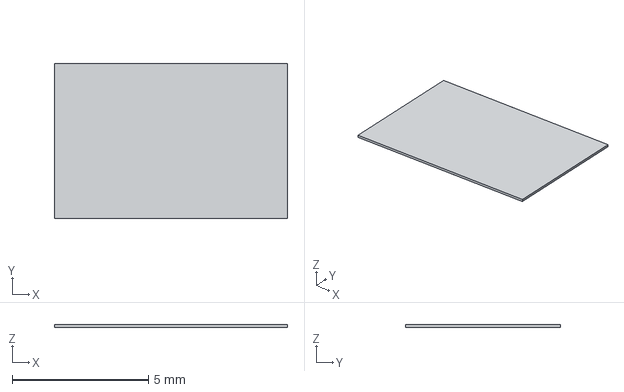
[picture p159: CAD file, 2026-11-09]
mechanical/pod/reference-bodies/STEP/ref_stiffener_sus430.step
8.55 x 5.70 x 0.1 mm
