Het-Bhavsar/Atrium/hardware/case/mechanical/STEP/atrium_case_magnet_revB1-1.step

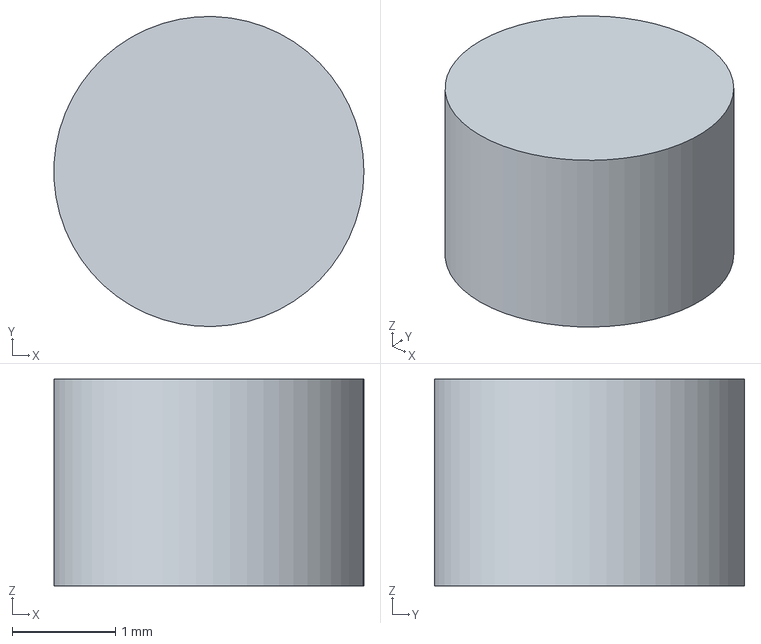
[picture p160: CAD file, 2026-11-06]
hardware/case/mechanical/STEP/atrium_case_magnet_revB1-1.step
3.00 x 3.00 x 2.00 mm
