Het-Bhavsar/Atrium/hardware/design-data/outline/board_power_edge_cuts.dxf

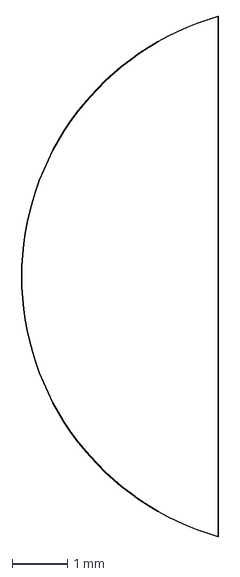
[picture p161: CAD file, 2026-11-09]
hardware/design-data/outline/board_power_edge_cuts.dxf
3.56 x 9.43 mm
