Het-Bhavsar/Atrium/hardware/pod/mechanical/STEP/atrium_pod_adhesive_liner_revB1-1.step

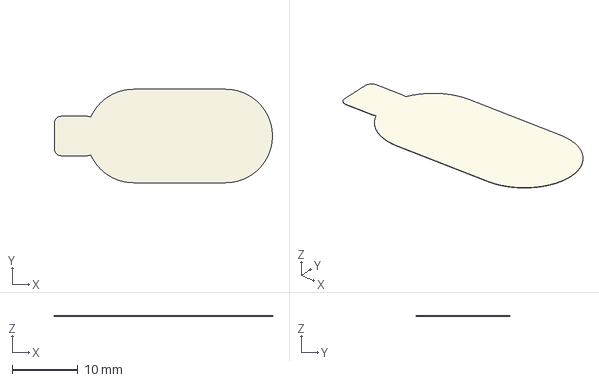
[picture p162: CAD file, 2026-11-06]
hardware/pod/mechanical/STEP/atrium_pod_adhesive_liner_revB1-1.step
33.1 x 14.2 x 0.05 mm
