Het-Bhavsar/Atrium/mechanical/case/STEP/case_tub.step

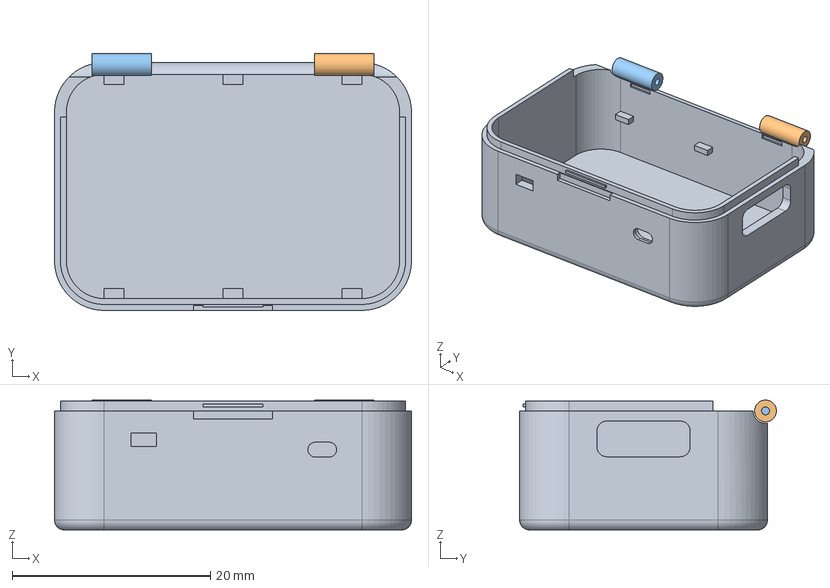
[picture p163: CAD file, 2026-11-09]
mechanical/case/STEP/case_tub.step
36.0 x 25.9 x 13.1 mm
