Het-Bhavsar/Atrium/mechanical/pod/reference-bodies/STEP/ref_flex.step

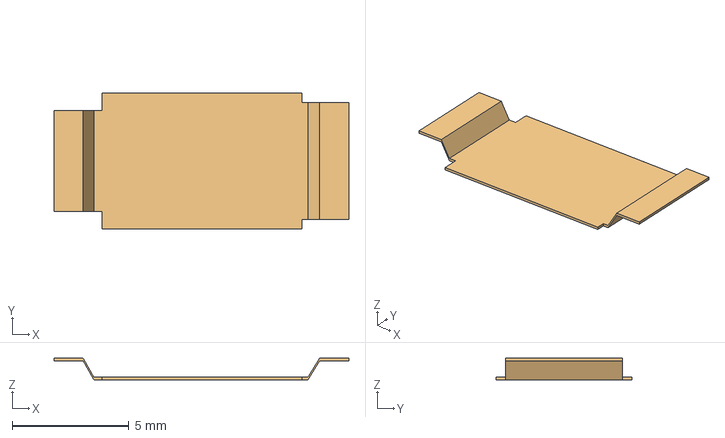
[picture p164: CAD file, 2026-11-09]
mechanical/pod/reference-bodies/STEP/ref_flex.step
12.6 x 5.80 x 0.92 mm
