Het-Bhavsar/Atrium/mechanical/pod/STEP/skin_adhesive_2477P.step

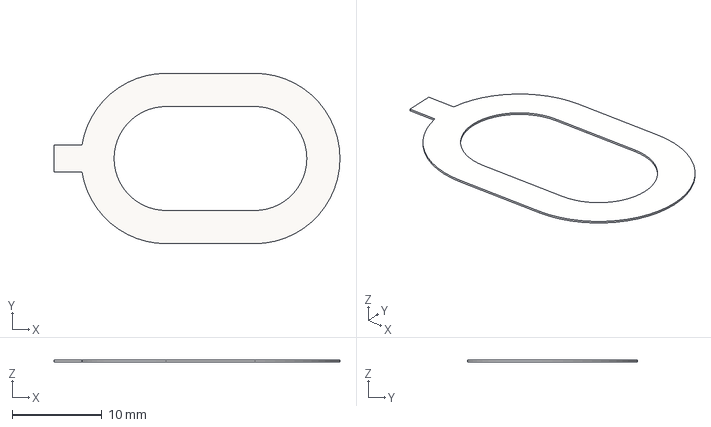
[picture p165: CAD file, 2026-11-09]
mechanical/pod/STEP/skin_adhesive_2477P.step
31.9 x 19.0 x 0.18 mm
