Het-Bhavsar/Atrium/hardware/case/mechanical/STEP/atrium_case_cradle_revB1-1.step

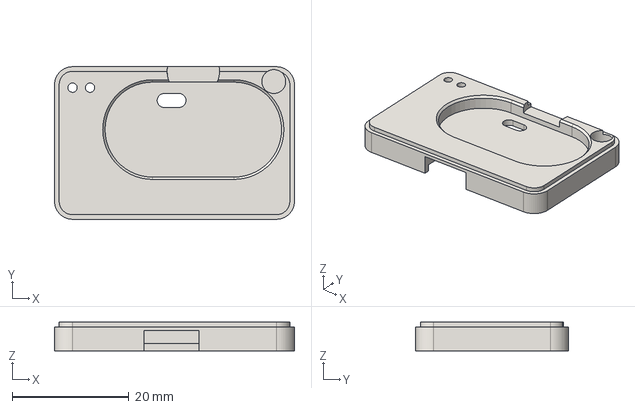
[picture p166: CAD file, 2026-11-06]
hardware/case/mechanical/STEP/atrium_case_cradle_revB1-1.step
41.2 x 26.2 x 4.92 mm
