Het-Bhavsar/Atrium/hardware/pod/mechanical/STEP/atrium_pod_window_frame_revB1-1.step

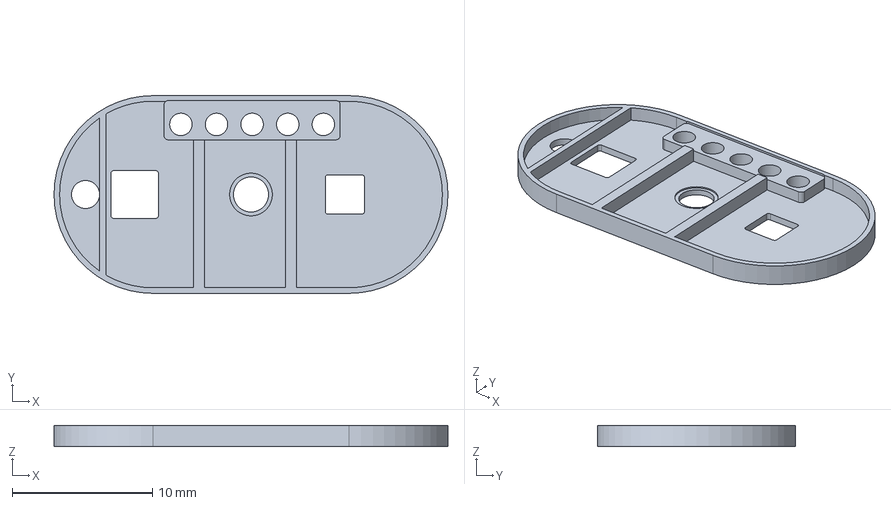
[picture p167: CAD file, 2026-11-06]
hardware/pod/mechanical/STEP/atrium_pod_window_frame_revB1-1.step
28.1 x 14.1 x 1.50 mm
