Het-Bhavsar/Atrium/mechanical/case/STEP/case_light_pipe.step

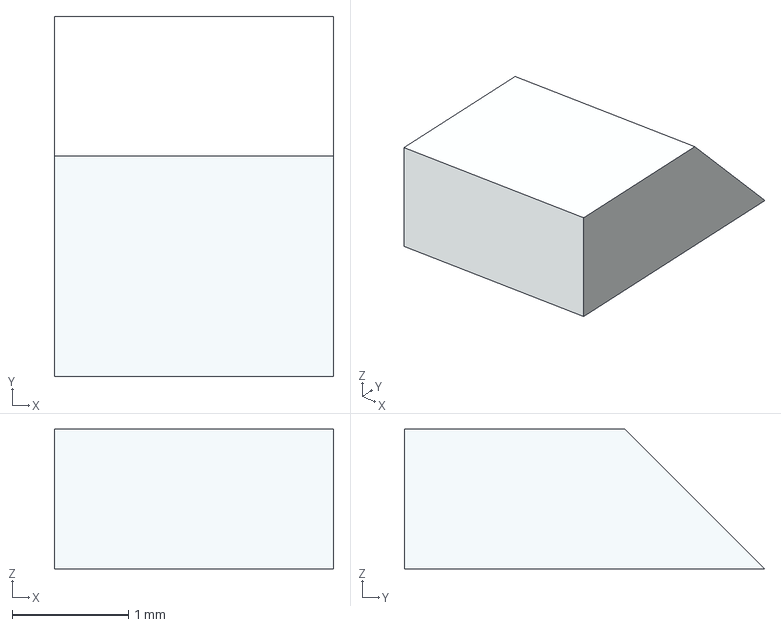
[picture p168: CAD file, 2026-11-09]
mechanical/case/STEP/case_light_pipe.step
2.40 x 3.10 x 1.20 mm
