Het-Bhavsar/Atrium/mechanical/pod/reference-bodies/STEP/ref_island_power.step

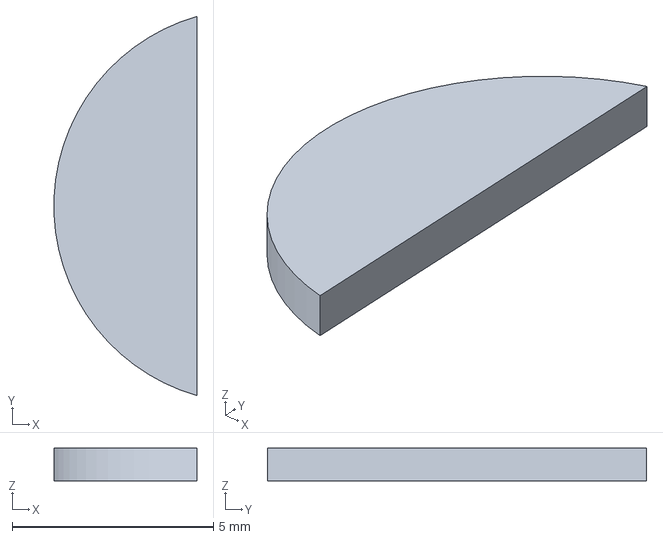
[picture p169: CAD file, 2026-11-09]
mechanical/pod/reference-bodies/STEP/ref_island_power.step
3.56 x 9.43 x 0.82 mm
