Het-Bhavsar/Atrium/mechanical/pod/STEP/atrium_pod_in_skin.step

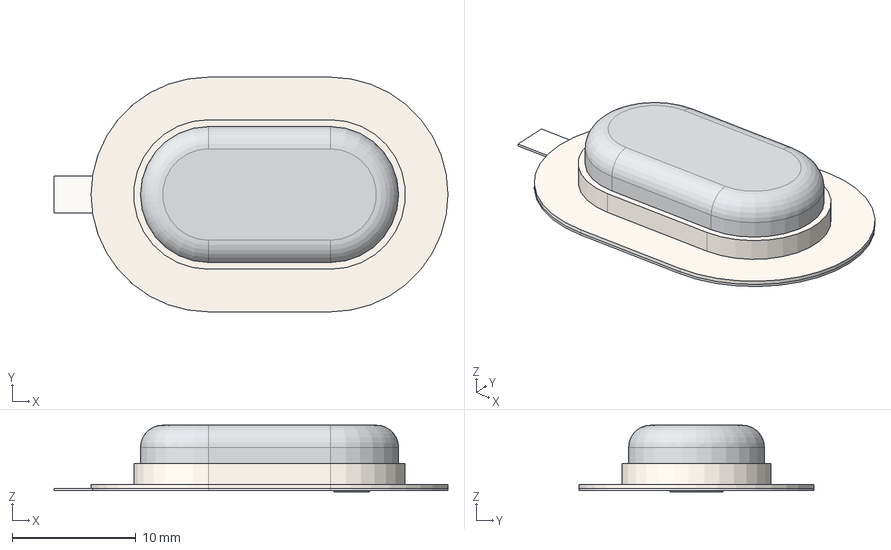
[picture p170: CAD file, 2026-11-09]
mechanical/pod/STEP/atrium_pod_in_skin.step
31.9 x 19.0 x 5.40 mm
base
window_gasket
cell
stiffener_sus430
board x 2
U3
fpc1
skin_cradle
skin_adhesive_2477P
