Het-Bhavsar/Atrium/hardware/case/mechanical/STEP/atrium_case_lid_revB1-1.step

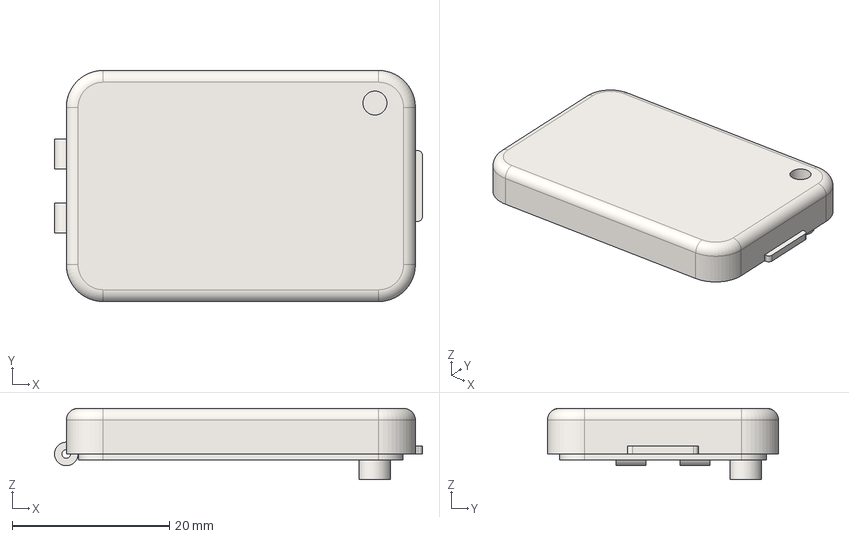
[picture p171: CAD file, 2026-11-06]
hardware/case/mechanical/STEP/atrium_case_lid_revB1-1.step
46.8 x 29.4 x 9.07 mm
