Het-Bhavsar/Atrium/mechanical/case/STEP/case_lid.step

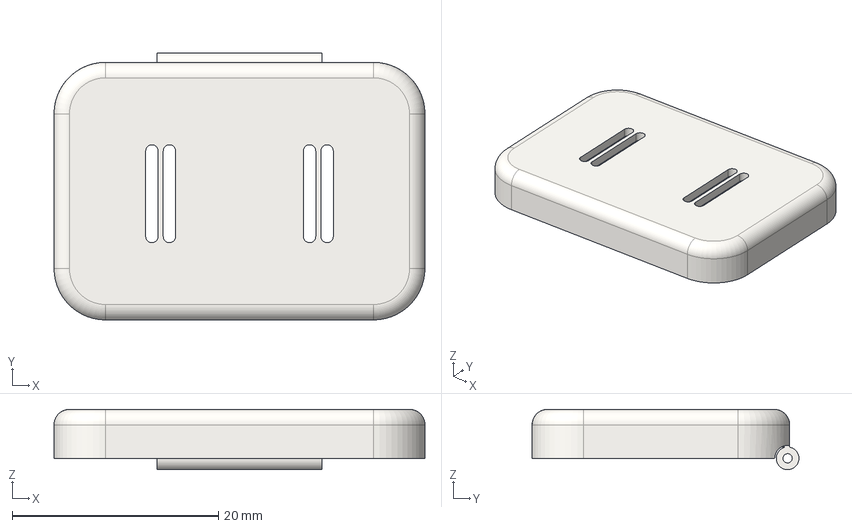
[picture p172: CAD file, 2026-11-09]
mechanical/case/STEP/case_lid.step
36.0 x 25.9 x 5.85 mm
