Het-Bhavsar/Atrium/mechanical/pod/reference-bodies/STEP/ref_island_radio.step

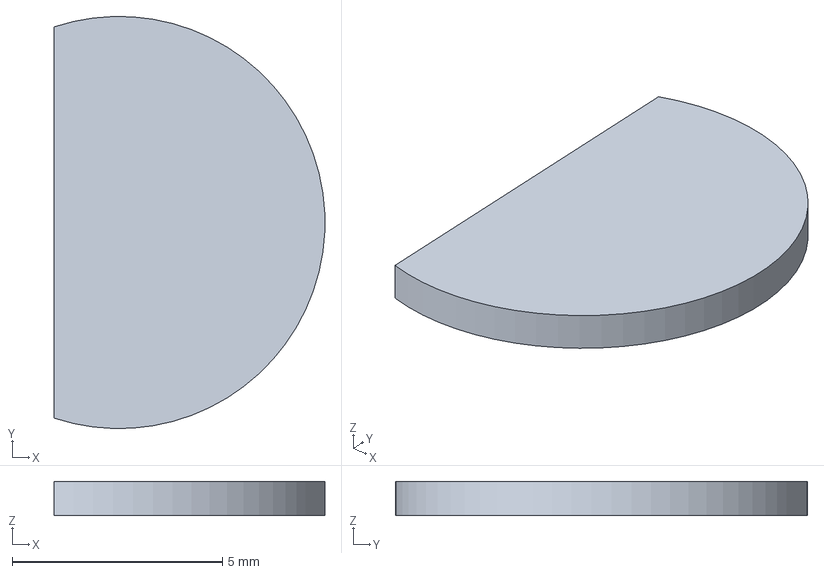
[picture p173: CAD file, 2026-11-09]
mechanical/pod/reference-bodies/STEP/ref_island_radio.step
6.43 x 9.80 x 0.82 mm
