Het-Bhavsar/Atrium/mechanical/pod/STEP/skin_pad.step

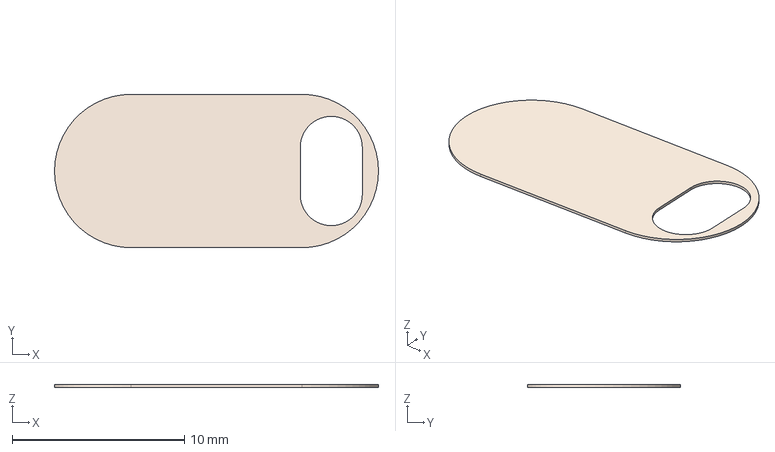
[picture p174: CAD file, 2026-11-09]
mechanical/pod/STEP/skin_pad.step
18.8 x 8.90 x 0.15 mm
