Het-Bhavsar/Atrium/hardware/case/mechanical/STEP/atrium_case_pcba_envelope_revB1-1.step

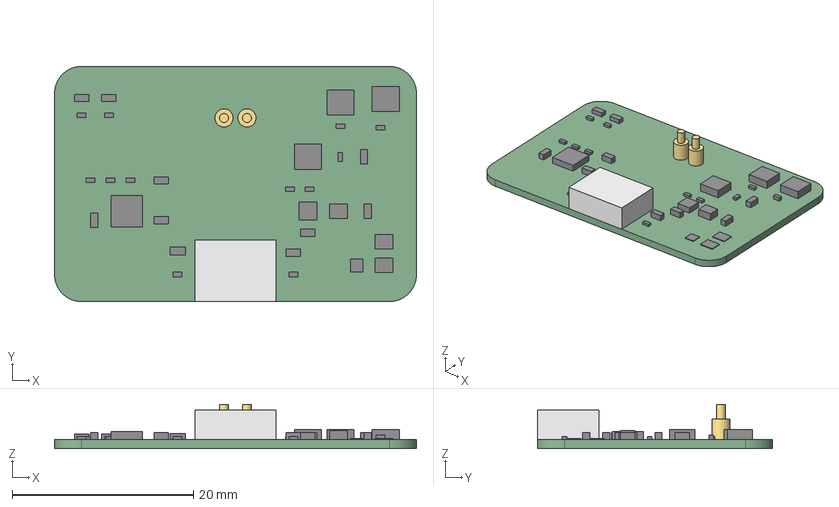
[picture p175: CAD file, 2026-11-06]
hardware/case/mechanical/STEP/atrium_case_pcba_envelope_revB1-1.step
40.0 x 26.0 x 4.90 mm
case_pcb
J1
D1
R1 x 10
C1 x 4
U1
C8 x 3
LED1 x 2
U2
L1
U3 x 3
R10
C6
BTp x 2
NTC
P1
P2
