Het-Bhavsar/Atrium/mechanical/pod/STEP/pod_window_gasket.step

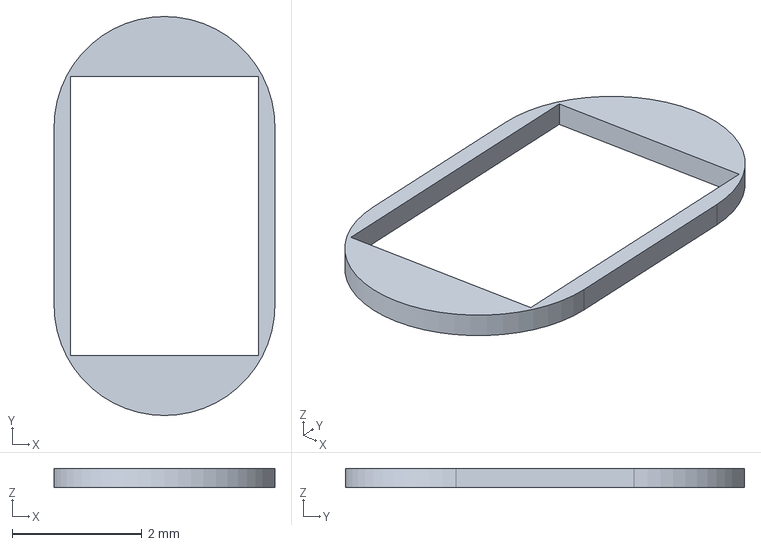
[picture p177: CAD file, 2026-11-09]
mechanical/pod/STEP/pod_window_gasket.step
3.40 x 6.14 x 0.3 mm
