Het-Bhavsar/Atrium/hardware/case/mechanical/STEP/atrium_case_hinge_pin_revB1-1.step

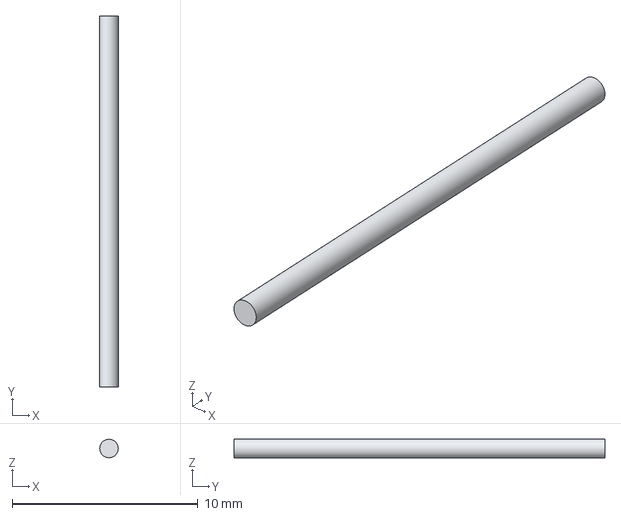
[picture p178: CAD file, 2026-11-05]
hardware/case/mechanical/STEP/atrium_case_hinge_pin_revB1-1.step
0.999 x 20.0 x 1 mm
