Het-Bhavsar/Atrium/hardware/pod/mechanical/STEP/atrium_pod_comfort_dummy_revB1-1.step

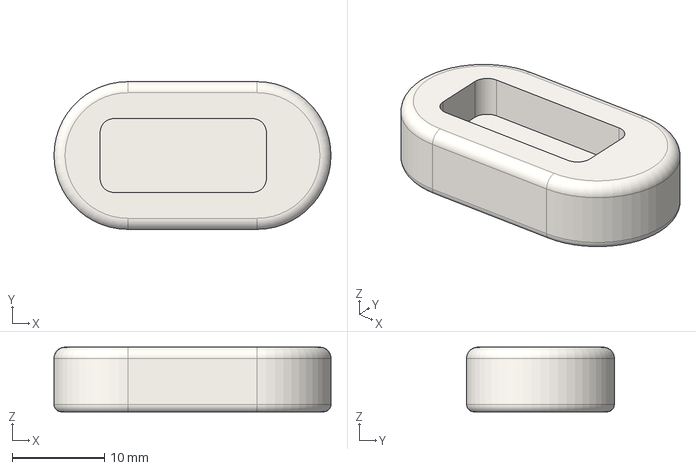
[picture p179: CAD file, 2026-11-06]
hardware/pod/mechanical/STEP/atrium_pod_comfort_dummy_revB1-1.step
30.0 x 16.0 x 7.00 mm
