Het-Bhavsar/Atrium/mechanical/pod/STEP/atrium_pod_on_pad.step

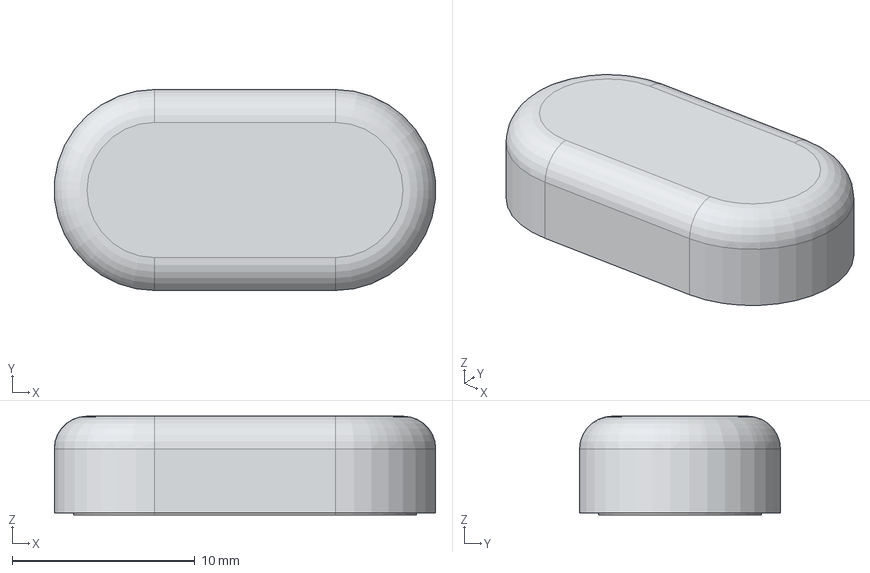
[picture p180: CAD file, 2026-11-09]
mechanical/pod/STEP/atrium_pod_on_pad.step
20.9 x 11.0 x 5.40 mm
base
window_gasket
cell
stiffener_sus430
board x 2
U3
fpc1
skin_pad
