Het-Bhavsar/Atrium/hardware/case/mechanical/STEP/atrium_case_cell_LP602525_revB1-1.step

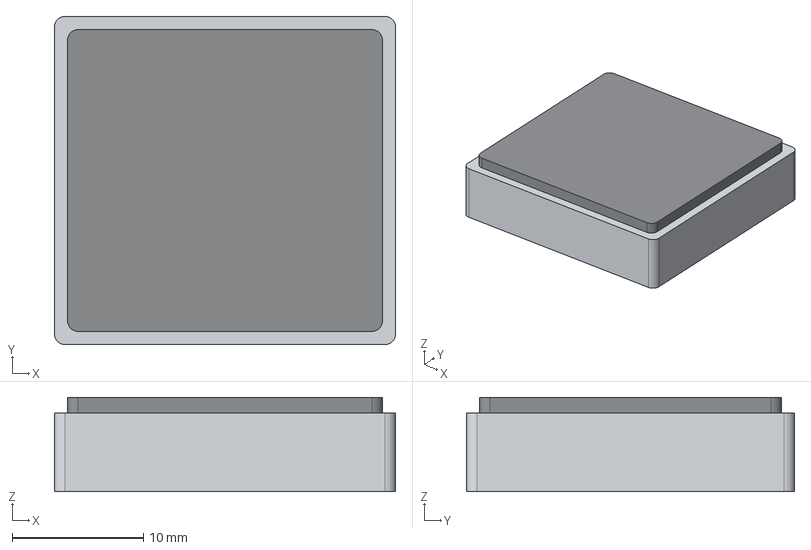
[picture p181: CAD file, 2026-11-05]
hardware/case/mechanical/STEP/atrium_case_cell_LP602525_revB1-1.step
26.0 x 25.0 x 7.20 mm
cell_LP602525
cell_foam
