Het-Bhavsar/Atrium/hardware/case/mechanical/STEP/atrium_case_base_revB1-1.step

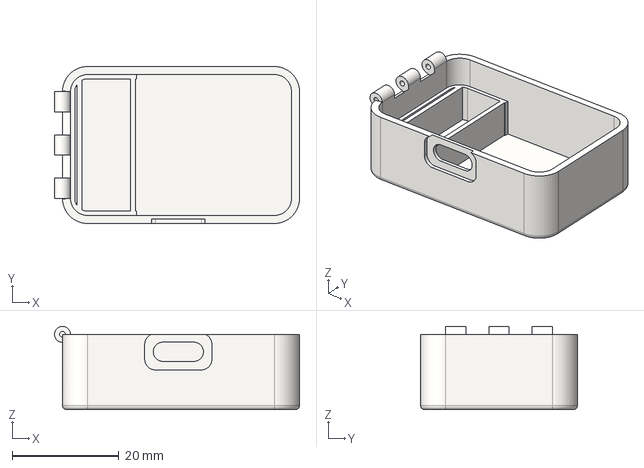
[picture p183: CAD file, 2026-11-05]
hardware/case/mechanical/STEP/atrium_case_base_revB1-1.step
45.9 x 29.4 x 15.6 mm
