Het-Bhavsar/Atrium/hardware/pod/mechanical/STEP/atrium_pod_pcba_envelope_antenna_flat_revB1-1.step

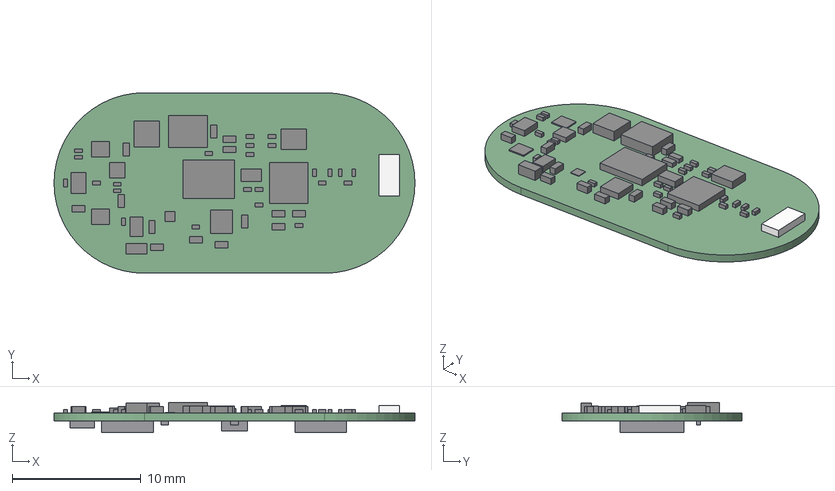
[picture p184: CAD file, 2026-11-05]
hardware/pod/mechanical/STEP/atrium_pod_pcba_envelope_antenna_flat_revB1-1.step
28.0 x 14.0 x 2.33 mm
pod_pcb
C2 x 5
U7
L1
C4 x 6
R2 x 6
U6
U2
C7
C8 x 18
R3 x 2
U1
Y1
Y2
D2
PD1 x 2
U4
C20 x 2
U3
U8
TP1
pad_J1_1 x 5
U5
BTp x 2
U9
AE1
