Het-Bhavsar/Atrium/hardware/pod/mechanical/STEP/atrium_pod_pogo_gasket_revB1-1.step

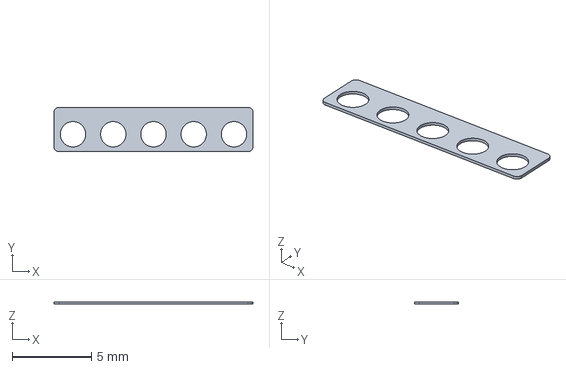
[picture p185: CAD file, 2026-11-05]
hardware/pod/mechanical/STEP/atrium_pod_pogo_gasket_revB1-1.step
12.6 x 2.80 x 0.15 mm
