Het-Bhavsar/Atrium/hardware/pod/mechanical/STEP/atrium_pod_window_clear_revB1-1.step

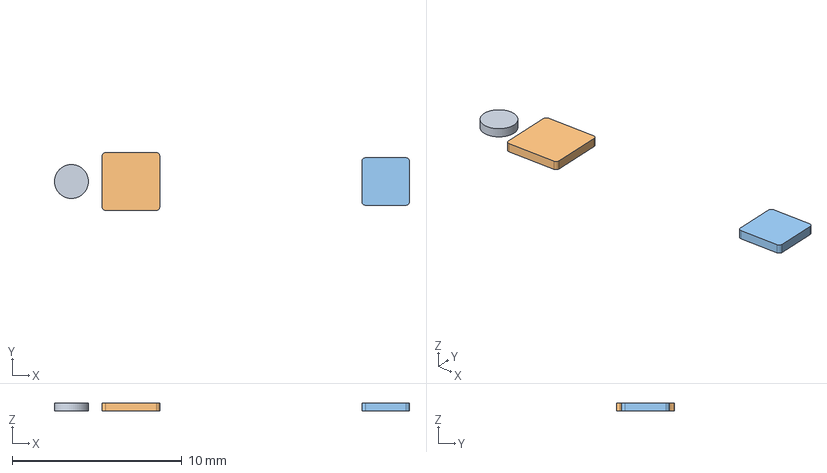
[picture p186: CAD file, 2026-11-05]
hardware/pod/mechanical/STEP/atrium_pod_window_clear_revB1-1.step
20.9 x 3.40 x 0.5 mm
clear_led
clear_pd1
clear_pd2
