Het-Bhavsar/Atrium/hardware/pod/mechanical/STEP/atrium_pod_cell_301020_revB1-1.step

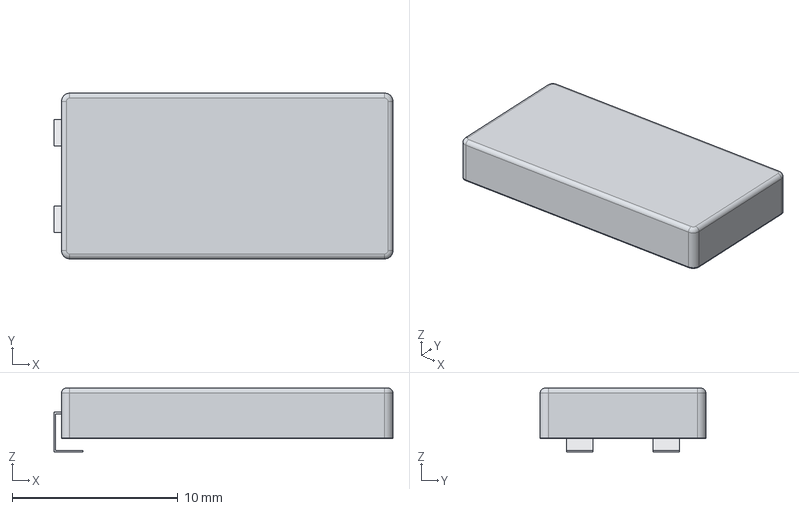
[picture p187: CAD file, 2026-11-05]
hardware/pod/mechanical/STEP/atrium_pod_cell_301020_revB1-1.step
20.4 x 10.0 x 3.85 mm
cell_insulator_pi_tape
cell_301020
tab_pos
tab_neg
