Het-Bhavsar/Atrium/hardware/pod/mechanical/STEP/atrium_pod_poron_pad_revB1-1.step

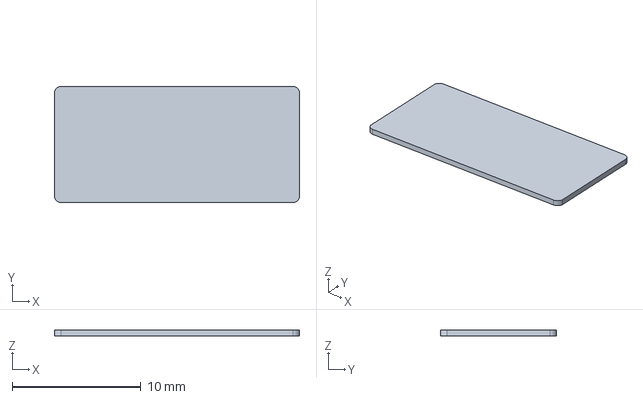
[picture p189: CAD file, 2026-11-05]
hardware/pod/mechanical/STEP/atrium_pod_poron_pad_revB1-1.step
19.0 x 9.00 x 0.45 mm
