Het-Bhavsar/Atrium/hardware/pod/mechanical/STEP/atrium_pod_thermal_gap_pad_revB1-1.step

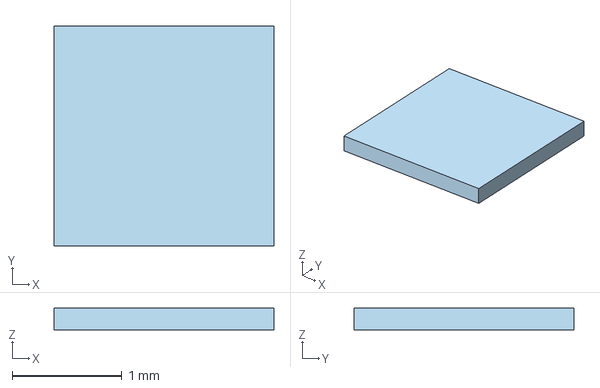
[picture p190: CAD file, 2026-11-05]
hardware/pod/mechanical/STEP/atrium_pod_thermal_gap_pad_revB1-1.step
2.00 x 2.00 x 0.2 mm
