Het-Bhavsar/Atrium/hardware/pod/mechanical/STEP/atrium_pod_thermal_button_revB1-1.step

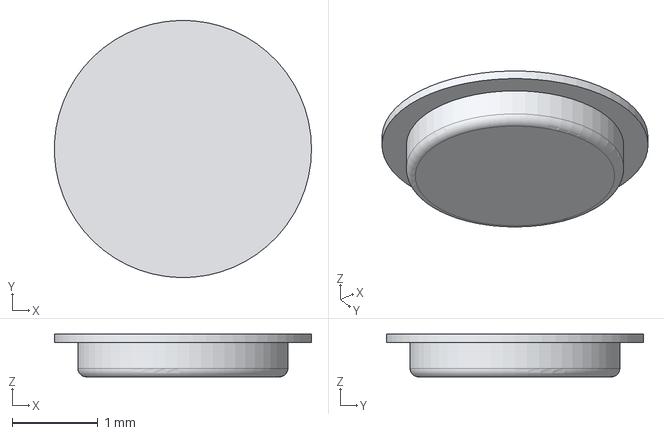
[picture p191: CAD file, 2026-11-05]
hardware/pod/mechanical/STEP/atrium_pod_thermal_button_revB1-1.step
3.00 x 3.00 x 0.5 mm
