Het-Bhavsar/Atrium/(list of files, cad)

Other CAD files:
hardware/case/mechanical/3MF/atrium_case_base_revB1-1.3mf
hardware/case/mechanical/3MF/atrium_case_cradle_revB1-1.3mf
hardware/case/mechanical/3MF/atrium_case_lid_revB1-1.3mf
hardware/case/mechanical/STL/atrium_case_base_revB1-1.stl
hardware/case/mechanical/STL/atrium_case_cradle_revB1-1.stl
hardware/case/mechanical/STL/atrium_case_lid_revB1-1.stl
hardware/pod/mechanical/3MF/atrium_pod_comfort_dummy_revB1-1.3mf
hardware/pod/mechanical/3MF/atrium_pod_top_shell_revB1-1.3mf
hardware/pod/mechanical/3MF/atrium_pod_window_frame_revB1-1.3mf
hardware/pod/mechanical/STL/atrium_pod_comfort_dummy_revB1-1.stl
hardware/pod/mechanical/STL/atrium_pod_top_shell_revB1-1.stl
hardware/pod/mechanical/STL/atrium_pod_window_frame_revB1-1.stl
legacy/concepts/skin-cradle/skin_cradle.step
legacy/concepts/skin-cradle/skin_cradle.stl
legacy/rev-b1/hardware/case/mechanical/3MF/atrium_case_base_revB1-1.3mf
legacy/rev-b1/hardware/case/mechanical/3MF/atrium_case_cradle_revB1-1.3mf
legacy/rev-b1/hardware/case/mechanical/3MF/atrium_case_lid_revB1-1.3mf
legacy/rev-b1/hardware/case/mechanical/STL/atrium_case_base_revB1-1.stl
legacy/rev-b1/hardware/case/mechanical/STL/atrium_case_cradle_revB1-1.stl
legacy/rev-b1/hardware/case/mechanical/STL/atrium_case_lid_revB1-1.stl
legacy/rev-b1/hardware/pod/mechanical/3MF/atrium_pod_comfort_dummy_revB1-1.3mf
legacy/rev-b1/hardware/pod/mechanical/3MF/atrium_pod_top_shell_revB1-1.3mf
legacy/rev-b1/hardware/pod/mechanical/3MF/atrium_pod_window_frame_revB1-1.3mf
legacy/rev-b1/hardware/pod/mechanical/STL/atrium_pod_comfort_dummy_revB1-1.stl
legacy/rev-b1/hardware/pod/mechanical/STL/atrium_pod_top_shell_revB1-1.stl
legacy/rev-b1/hardware/pod/mechanical/STL/atrium_pod_window_frame_revB1-1.stl
legacy/rev-b2-compact/board-outlines/atrium_blade_board_revB2.dxf
legacy/rev-b2-compact/board-outlines/atrium_pill_board.dxf
legacy/rev-b2-compact/board-outlines/atrium_pill_s_board.dxf
legacy/rev-b2-compact/board-outlines/atrium_pill_s_patch.dxf
legacy/rev-b2-compact/board-outlines/atrium_sail_board_revB2.dxf
legacy/rev-b2-compact/pill-s/3MF/atrium_pill_s_base.3mf
legacy/rev-b2-compact/pill-s/3MF/atrium_pill_s_shell.3mf
legacy/rev-b2-compact/pill-s/STEP/atrium_pill_s_assembly.step
legacy/rev-b2-compact/pill-s/STEP/atrium_pill_s_base.step
legacy/rev-b2-compact/pill-s/STEP/atrium_pill_s_shell.step
legacy/rev-b2-compact/pill-s/STL/atrium_pill_s_base.stl
legacy/rev-b2-compact/pill-s/STL/atrium_pill_s_shell.stl
legacy/rev-b2-compact/pill/3MF/atrium_pill_base.3mf
legacy/rev-b2-compact/pill/3MF/atrium_pill_shell.3mf
legacy/rev-b2-compact/pill/STEP/atrium_pill_assembly.step
legacy/rev-b2-compact/pill/STEP/atrium_pill_base.step
legacy/rev-b2-compact/pill/STEP/atrium_pill_shell.step
legacy/rev-b2-compact/pill/STL/atrium_pill_base.stl
legacy/rev-b2-compact/pill/STL/atrium_pill_shell.stl
mechanical/case/STL/case_button.stl
mechanical/case/STL/case_deck.stl
mechanical/case/STL/case_lid.stl
mechanical/case/STL/case_light_pipe.stl
mechanical/case/STL/case_tub.stl
mechanical/packaging/STL/packaging_card_insert.stl
mechanical/packaging/STL/packaging_pulp_tray.stl
mechanical/plinth/STL/plinth_housing.stl
mechanical/pod/STL/pod_base.stl
mechanical/pod/STL/pod_shell.stl
mechanical/pod/STL/pod_window_gasket.stl
mechanical/pod/STL/skin_adhesive_2477P.stl
mechanical/pod/STL/skin_pad.stl
mechanical/pod/reference-bodies/STL/ref_cell_400909.stl
mechanical/pod/reference-bodies/STL/ref_flex.stl
mechanical/pod/reference-bodies/STL/ref_island_power.stl
mechanical/pod/reference-bodies/STL/ref_island_radio.stl
mechanical/pod/reference-bodies/STL/ref_maxm86161.stl
mechanical/pod/reference-bodies/STL/ref_stiffener_sus430.stl
mechanical/programming-jig/STL/programming_jig.stl
