Het-Bhavsar/Atrium/app/android-ios/test/fixtures/phone/phone_baseline.csv

metric | history | tonight | deviation
rmssd_ms | 40.19 37.05 43.51 | 47.52
rmssd_ms | 51.82 45.66 41.68 40.29 49.49 | 54.81 | 9.1500
rmssd_ms | 46.64 37.60 39.25 nan 46.22 34.61 44.50 38.02 41.22 42.07 40.72 48.32 44.62 41.46 | 47.46 | 6.0000
rmssd_ms | 49.98 35.14 43.46 39.12 43.96 37.26 45.12 44.77 43.17 38.71 42.62 38.45 36.87 46.35 38.34 52.02 49.30 33.01 46.63 38.39 | 45.20 | 2.3050
resting_hr_bpm | 54.09 50.02 53.53 | 53.49
resting_hr_bpm | 55.92 51.64 55.48 51.80 53.34 | 52.32 | -1.0200
resting_hr_bpm | 56.90 55.14 58.86 nan 55.69 55.68 52.79 53.86 56.70 53.21 54.38 53.96 55.22 53.27 | 53.70 | -1.4400
resting_hr_bpm | 54.48 54.21 52.27 55.79 51.40 51.60 51.44 55.93 53.28 52.06 51.73 54.84 51.89 51.46 55.23 51.61 53.36 53.99 53.11 53.89 | 56.68 | 3.4850
skin_c | 34.50 34.35 34.23 | 34.56
skin_c | 34.53 34.65 34.51 34.50 34.46 | 34.50 | -0.0100
skin_c | 34.63 34.52 34.62 nan 34.70 34.28 34.95 34.67 34.41 34.78 34.60 34.48 34.47 34.40 | 34.61 | 0.0100
skin_c | 34.81 34.53 34.68 34.98 34.36 34.65 34.54 34.39 34.39 34.60 34.69 34.49 34.61 34.74 34.66 34.77 34.69 34.70 34.97 34.72 | 34.63 | -0.0450
