Het-Bhavsar/Atrium/app/android-ios/test/fixtures/phone/phone_epochs.csv

t_s | uptime | pulse_bpm | pulse_conf | on_skin | pulse_from_ir | docked | charging | rmssd_ms | n_diffs | activity_class | activity_mg | mlc_level_max | pulse_present_s | skin_c | steps | pitch_deg | roll_deg | burst_r | burst_conf
1793514600 | 0 | 96 | 0.6 | 1 | 0 | 0 | 0 | 0 | 0 | walk | 131 | 4 | 30 | 33.2 | 57 | -87 | -42 | 0 | 0
1793514630 | 0 | 95 | 0.6 | 1 | 0 | 0 | 0 | 0 | 0 | walk | 132 | 4 | 30 | 33.1 | 59 | -88 | -162 | 0 | 0
1793514660 | 0 | 94 | 0.6 | 1 | 0 | 0 | 0 | 0 | 0 | walk | 151 | 4 | 30 | 32.9 | 58 | -84 | -12 | 0 | 0
1793514690 | 0 | 89 | 0.6 | 1 | 0 | 0 | 0 | 0 | 0 | walk | 187 | 4 | 30 | 33 | 48 | -89 | 44 | 0 | 0
1793514720 | 0 | 94 | 0.6 | 1 | 0 | 0 | 0 | 0 | 0 | walk | 255 | 4 | 30 | 33.1 | 50 | -83 | -162 | 0 | 0
1793514750 | 0 | 91 | 0.6 | 1 | 0 | 0 | 0 | 0 | 0 | walk | 118 | 4 | 30 | 32.9 | 54 | -86 | -96 | 0 | 0
1793514780 | 0 | 93 | 0.6 | 1 | 0 | 0 | 0 | 0 | 0 | walk | 113 | 4 | 30 | 33.2 | 53 | -85 | -48 | 0 | 0
1793514810 | 0 | 92 | 0.6 | 1 | 0 | 0 | 0 | 0 | 0 | walk | 77 | 4 | 30 | 33.2 | 57 | -84 | -104 | 0 | 0
1793514840 | 0 | 92 | 0.6 | 1 | 0 | 0 | 0 | 0 | 0 | walk | 110 | 4 | 30 | 33 | 51 | -86 | 18 | 0 | 0
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
