Het-Bhavsar/Atrium/app/android-ios/test/fixtures/phone/phone_night_epochs.csv

t_s | f_log1p_act | f_act_mean | f_act_max | f_hr_z | f_hr_z_sd | f_t_h | p_asleep | asleep | position | on_pod
1793552700 | 4.18965474 | 3.00351694 | 4.18965474 | 5.25 | 0.673145601 | 0 | 0.226093434 | 0 | upright | 0
1793552730 | 2.89037176 | 3.16856925 | 4.18965474 | 3.75 | 0.636876946 | 0.00833333333 | 0.54633161 | 0 | upright | 0
1793552760 | 2.63905733 | 3.2169166 | 4.18965474 | 5.25 | 0.625 | 0.0166666667 | 0.544979552 | 0 | upright | 0
1793552790 | 3.04452244 | 3.21259851 | 4.18965474 | 3.75 | 0.667823071 | 0.025 | 0.526527153 | 0 | upright | 0
1793552820 | 2.77258872 | 3.23473738 | 4.18965474 | 5.25 | 0.644204936 | 0.0333333333 | 0.523374596 | 0 | upright | 0
1793552850 | 2.48490665 | 3.14041804 | 4.18965474 | 4.5 | 0.767361046 | 0.0416666667 | 0.583062023 | 0 | upright | 0
1793552880 | 4.15888308 | 3.03187963 | 4.18965474 | 4.25 | 0.806738152 | 0.05 | 0.263903768 | 0 | upright | 0
1793552910 | 3.55534806 | 2.96886625 | 4.18965474 | 4 | 0.746202507 | 0.0583333333 | 0.361875203 | 0 | upright | 0
1793552940 | 3.17805383 | 2.98100547 | 4.18965474 | 5.5 | 0.757196875 | 0.0666666667 | 0.374586133 | 0 | upright | 0
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
