Het-Bhavsar/Atrium/app/android-ios/test/fixtures/fit/fit_dark.csv

t_s | q | pi | rho | moving | saturated | dark | pulse_present | good
4 | 0 | 0.004262 | 0.4902 | 0 | 0 | 1 | 0 | 0
5 | 0 | 0.003520 | 0.3684 | 0 | 0 | 1 | 0 | 0
6 | 0 | 0.002839 | 0.2576 | 0 | 0 | 1 | 0 | 0
7 | 0 | 0.002254 | 0.1852 | 0 | 0 | 1 | 0 | 0
8 | 0 | 0.003941 | 0.4939 | 0 | 0 | 1 | 0 | 0
9 | 0 | 0.003279 | 0.2925 | 0 | 0 | 1 | 0 | 0
10 | 0 | 0.003254 | 0.2850 | 0 | 0 | 1 | 0 | 0
11 | 0 | 0.003086 | 0.2270 | 0 | 0 | 1 | 0 | 0
12 | 0 | 0.003595 | 0.4329 | 0 | 0 | 1 | 0 | 0
13 | 0 | 0.003921 | 0.5510 | 0 | 0 | 1 | 0 | 0
14 | 0 | 0.003382 | 0.3561 | 0 | 0 | 1 | 0 | 0
15 | 0 | 0.003751 | 0.4493 | 0 | 0 | 1 | 0 | 0
16 | 0 | 0.004206 | 0.4069 | 0 | 0 | 1 | 0 | 0
17 | 0 | 0.002684 | 0.1492 | 0 | 0 | 1 | 0 | 0
18 | 0 | 0.003247 | 0.2305 | 0 | 0 | 1 | 0 | 0
19 | 0 | 0.003447 | 0.3196 | 0 | 0 | 1 | 0 | 0
20 | 0 | 0.002124 | 0.1458 | 0 | 0 | 1 | 0 | 0
21 | 0 | 0.002452 | 0.2471 | 0 | 0 | 1 | 0 | 0
22 | 0 | 0.002478 | 0.2749 | 0 | 0 | 1 | 0 | 0
23 | 0 | 0.002659 | 0.2815 | 0 | 0 | 1 | 0 | 0
24 | 0 | 0.002123 | 0.2359 | 0 | 0 | 1 | 0 | 0
25 | 0 | 0.002492 | 0.2496 | 0 | 0 | 1 | 0 | 0
26 | 0 | 0.002577 | 0.2568 | 0 | 0 | 1 | 0 | 0
27 | 0 | 0.003580 | 0.4070 | 0 | 0 | 1 | 0 | 0
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
