Het-Bhavsar/Atrium/app/android-ios/test/fixtures/fit/fit_good.csv

t_s | q | pi | rho | moving | saturated | dark | pulse_present | good
4 | 74 | 0.001639 | 0.8845 | 0 | 0 | 0 | 0 | 0
5 | 81 | 0.001938 | 0.9541 | 0 | 0 | 0 | 0 | 0
6 | 81 | 0.001925 | 0.9916 | 0 | 0 | 0 | 0 | 0
7 | 79 | 0.001842 | 0.9539 | 0 | 0 | 0 | 0 | 0
8 | 78 | 0.001827 | 0.9457 | 0 | 0 | 0 | 0 | 0
9 | 78 | 0.001803 | 0.9462 | 0 | 0 | 0 | 0 | 0
10 | 78 | 0.001793 | 0.9354 | 0 | 0 | 0 | 0 | 0
11 | 78 | 0.001826 | 0.9684 | 0 | 0 | 0 | 0 | 0
12 | 81 | 0.001924 | 0.9887 | 0 | 0 | 0 | 0 | 0
13 | 82 | 0.001963 | 0.9904 | 0 | 0 | 0 | 1 | 1
14 | 82 | 0.001983 | 1.0125 | 0 | 0 | 0 | 1 | 1
15 | 82 | 0.001975 | 1.0003 | 0 | 0 | 0 | 1 | 1
16 | 79 | 0.001864 | 0.9714 | 0 | 0 | 0 | 1 | 1
17 | 79 | 0.001851 | 0.9786 | 0 | 0 | 0 | 1 | 1
18 | 79 | 0.001853 | 0.9693 | 0 | 0 | 0 | 1 | 1
19 | 79 | 0.001830 | 0.9549 | 0 | 0 | 0 | 1 | 1
20 | 78 | 0.001818 | 0.9411 | 0 | 0 | 0 | 1 | 1
21 | 78 | 0.001801 | 0.9369 | 0 | 0 | 0 | 1 | 1
22 | 80 | 0.001875 | 0.9636 | 0 | 0 | 0 | 1 | 1
23 | 81 | 0.001937 | 0.9647 | 0 | 0 | 0 | 1 | 1
24 | 82 | 0.001968 | 1.0072 | 0 | 0 | 0 | 1 | 1
25 | 82 | 0.001983 | 1.0042 | 0 | 0 | 0 | 1 | 1
26 | 80 | 0.001883 | 0.9657 | 0 | 0 | 0 | 1 | 1
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
