Het-Bhavsar/Atrium/app/android-ios/test/fixtures/fit/fit_moving.csv

t_s | q | pi | rho | moving | saturated | dark | pulse_present | good
4 | 75 | 0.001689 | 0.9282 | 0 | 0 | 0 | 0 | 0
5 | 82 | 0.001984 | 1.0052 | 0 | 0 | 0 | 0 | 0
6 | 83 | 0.002010 | 1.0081 | 0 | 0 | 0 | 0 | 0
7 | 81 | 0.001922 | 0.9884 | 0 | 0 | 0 | 0 | 0
8 | 79 | 0.001848 | 0.9710 | 0 | 0 | 0 | 0 | 0
9 | 79 | 0.001859 | 0.9655 | 0 | 0 | 0 | 0 | 0
10 | 79 | 0.001857 | 0.9757 | 0 | 0 | 0 | 0 | 0
11 | 79 | 0.001848 | 0.9736 | 1 | 0 | 0 | 0 | 0
12 | 77 | 0.001785 | 0.9375 | 1 | 0 | 0 | 0 | 0
13 | 77 | 0.001764 | 0.9025 | 1 | 0 | 0 | 1 | 0
14 | 80 | 0.001885 | 0.9387 | 1 | 0 | 0 | 1 | 0
15 | 82 | 0.001975 | 1.0058 | 1 | 0 | 0 | 1 | 0
16 | 83 | 0.002011 | 1.0060 | 1 | 0 | 0 | 1 | 0
17 | 82 | 0.001969 | 0.9900 | 1 | 0 | 0 | 1 | 0
18 | 79 | 0.001842 | 0.9463 | 1 | 0 | 0 | 1 | 0
19 | 79 | 0.001838 | 0.9465 | 1 | 0 | 0 | 1 | 0
20 | 79 | 0.001833 | 0.9472 | 1 | 0 | 0 | 1 | 0
21 | 79 | 0.001830 | 0.9528 | 0 | 0 | 0 | 1 | 1
22 | 78 | 0.001804 | 0.9320 | 0 | 0 | 0 | 1 | 1
23 | 78 | 0.001826 | 0.9684 | 0 | 0 | 0 | 1 | 1
24 | 79 | 0.001852 | 0.9500 | 0 | 0 | 0 | 1 | 1
25 | 81 | 0.001957 | 0.9706 | 0 | 0 | 0 | 1 | 1
26 | 82 | 0.001960 | 0.9754 | 0 | 0 | 0 | 1 | 1
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
