Het-Bhavsar/Atrium/app/android-ios/test/fixtures/fit/fit_noisy.csv

t_s | q | pi | rho | moving | saturated | dark | pulse_present | good
4 | 11 | 0.002113 | 0.4596 | 0 | 0 | 0 | 0 | 0
5 | 4 | 0.002023 | 0.4229 | 0 | 0 | 0 | 0 | 0
6 | 0 | 0.001549 | 0.2810 | 0 | 0 | 0 | 0 | 0
7 | 0 | 0.001373 | 0.2606 | 0 | 0 | 0 | 0 | 0
8 | 11 | 0.001911 | 0.4602 | 0 | 0 | 0 | 0 | 0
9 | 37 | 0.002309 | 0.5893 | 0 | 0 | 0 | 0 | 0
10 | 26 | 0.002006 | 0.5429 | 0 | 0 | 0 | 0 | 0
11 | 1 | 0.001624 | 0.4044 | 0 | 0 | 0 | 0 | 0
12 | 0 | 0.001431 | 0.2976 | 0 | 0 | 0 | 0 | 0
13 | 0 | 0.001305 | 0.3054 | 0 | 0 | 0 | 0 | 0
14 | 0 | 0.001505 | 0.3284 | 0 | 0 | 0 | 0 | 0
15 | 11 | 0.001680 | 0.4688 | 0 | 0 | 0 | 0 | 0
16 | 0 | 0.001723 | 0.3666 | 0 | 0 | 0 | 0 | 0
17 | 11 | 0.002083 | 0.4592 | 0 | 0 | 0 | 0 | 0
18 | 4 | 0.002130 | 0.4224 | 0 | 0 | 0 | 0 | 0
19 | 5 | 0.002442 | 0.4236 | 0 | 0 | 0 | 0 | 0
20 | 36 | 0.002656 | 0.5714 | 0 | 0 | 0 | 0 | 0
21 | 34 | 0.002572 | 0.5648 | 0 | 0 | 0 | 1 | 0
22 | 27 | 0.002285 | 0.5387 | 0 | 0 | 0 | 1 | 0
23 | 0 | 0.001855 | 0.3880 | 0 | 0 | 0 | 1 | 0
24 | 19 | 0.002172 | 0.5004 | 0 | 0 | 0 | 1 | 0
25 | 0 | 0.002250 | 0.3644 | 0 | 0 | 0 | 1 | 0
26 | 30 | 0.002907 | 0.5369 | 0 | 0 | 0 | 1 | 0
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
