Het-Bhavsar/Atrium/app/android-ios/test/fixtures/fit/fit_saturated.csv

t_s | q | pi | rho | moving | saturated | dark | pulse_present | good
4 | 75 | 0.001676 | 0.9332 | 0 | 0 | 0 | 0 | 0
5 | 82 | 0.001972 | 1.0058 | 0 | 0 | 0 | 0 | 0
6 | 82 | 0.001992 | 1.0159 | 0 | 0 | 0 | 0 | 0
7 | 80 | 0.001910 | 0.9978 | 0 | 0 | 0 | 0 | 0
8 | 79 | 0.001863 | 0.9788 | 0 | 0 | 0 | 0 | 0
9 | 79 | 0.001853 | 0.9613 | 0 | 0 | 0 | 0 | 0
10 | 78 | 0.001824 | 0.9383 | 0 | 0 | 0 | 0 | 0
11 | 78 | 0.001806 | 0.9401 | 0 | 0 | 0 | 0 | 0
12 | 78 | 0.001823 | 0.9593 | 0 | 0 | 0 | 0 | 0
13 | 80 | 0.001899 | 0.9833 | 0 | 0 | 0 | 1 | 1
14 | 82 | 0.001964 | 0.9915 | 0 | 0 | 0 | 1 | 1
15 | 82 | 0.001971 | 0.9915 | 0 | 0 | 0 | 1 | 1
16 | 0 | 0.008005 | 0.0025 | 0 | 1 | 0 | 0 | 0
17 | 0 | 0.029055 | 0.0544 | 0 | 1 | 0 | 0 | 0
18 | 0 | 0.024284 | 0.0568 | 0 | 1 | 0 | 0 | 0
19 | 0 | 0.020871 | 0.0586 | 0 | 1 | 0 | 0 | 0
20 | 0 | 0.001824 | 0.0446 | 0 | 1 | 0 | 0 | 0
21 | 0 | 0.000407 | 0.2718 | 0 | 1 | 0 | 0 | 0
22 | 0 | 0.000067 | 0.5025 | 0 | 1 | 0 | 0 | 0
23 | 0 | 0.000009 | 0.2355 | 0 | 1 | 0 | 0 | 0
24 | 0 | 0.000008 | 0.2099 | 0 | 1 | 0 | 0 | 0
25 | 0 | 0.000011 | 0.2538 | 0 | 1 | 0 | 1 | 0
26 | 0 | 0.000016 | 0.4920 | 0 | 1 | 0 | 0 | 0
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
