Het-Bhavsar/Atrium/app/android-ios/test/fixtures/fit/fit_weak.csv

t_s | q | pi | rho | moving | saturated | dark | pulse_present | good
4 | 14 | 0.000418 | 0.9272 | 0 | 0 | 0 | 0 | 0
5 | 21 | 0.000487 | 0.9777 | 0 | 0 | 0 | 0 | 0
6 | 21 | 0.000488 | 0.9711 | 0 | 0 | 0 | 0 | 0
7 | 19 | 0.000468 | 0.9705 | 0 | 0 | 0 | 0 | 0
8 | 18 | 0.000455 | 0.9394 | 0 | 0 | 0 | 0 | 0
9 | 18 | 0.000456 | 0.9529 | 0 | 0 | 0 | 0 | 0
10 | 18 | 0.000455 | 0.9571 | 0 | 0 | 0 | 0 | 0
11 | 19 | 0.000460 | 0.9525 | 0 | 0 | 0 | 0 | 0
12 | 19 | 0.000460 | 0.9724 | 0 | 0 | 0 | 0 | 0
13 | 20 | 0.000476 | 0.9583 | 0 | 0 | 0 | 1 | 0
14 | 22 | 0.000497 | 0.9776 | 0 | 0 | 0 | 1 | 0
15 | 22 | 0.000504 | 0.9992 | 0 | 0 | 0 | 1 | 0
16 | 23 | 0.000511 | 1.0065 | 0 | 0 | 0 | 1 | 0
17 | 20 | 0.000479 | 0.9710 | 0 | 0 | 0 | 1 | 0
18 | 17 | 0.000445 | 0.9453 | 0 | 0 | 0 | 1 | 0
19 | 16 | 0.000433 | 0.9271 | 0 | 0 | 0 | 1 | 0
20 | 15 | 0.000425 | 0.9362 | 0 | 0 | 0 | 1 | 0
21 | 16 | 0.000431 | 0.9303 | 0 | 0 | 0 | 1 | 0
22 | 17 | 0.000448 | 0.9556 | 0 | 0 | 0 | 1 | 0
23 | 21 | 0.000482 | 0.9934 | 0 | 0 | 0 | 1 | 0
24 | 23 | 0.000504 | 0.9983 | 0 | 0 | 0 | 1 | 0
25 | 23 | 0.000507 | 1.0064 | 0 | 0 | 0 | 1 | 0
26 | 23 | 0.000507 | 0.9924 | 0 | 0 | 0 | 1 | 0
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
