Het-Bhavsar/Atrium/hardware/case/schematic/atrium_case_schematic_revB1-1.pdf

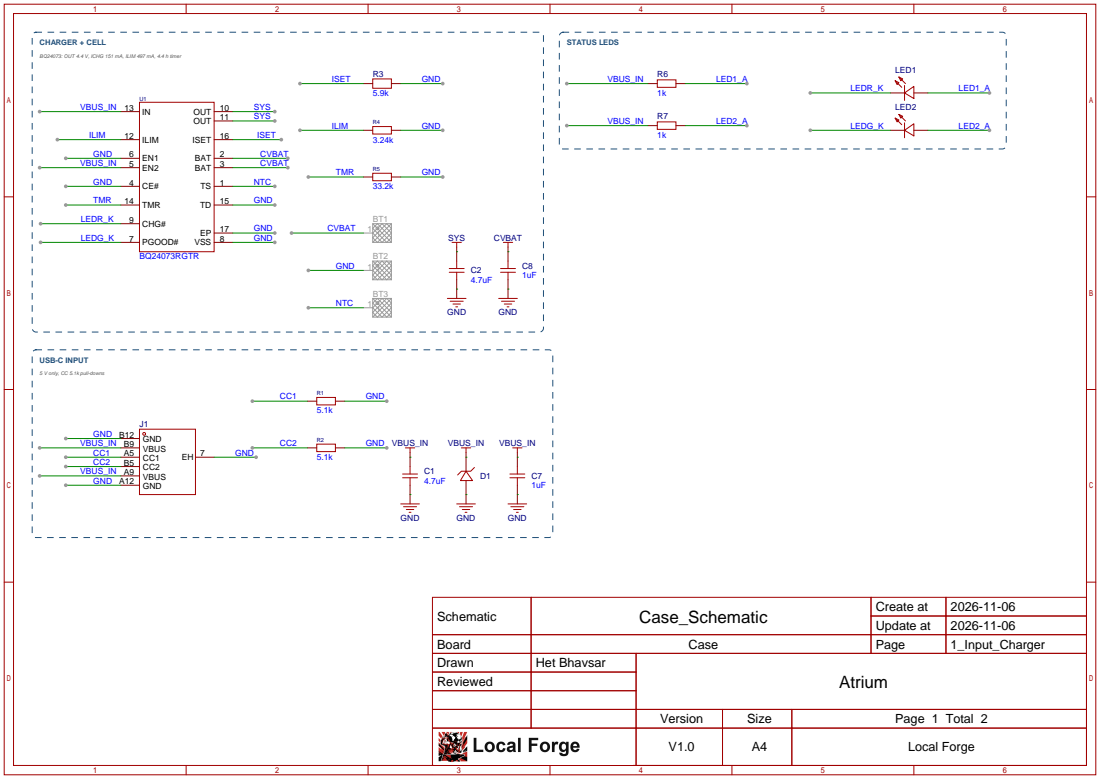
[picture p193: page 1]

BQ24073: OUT 4.4 V, ICHG 151 mA, ILIM 497 mA, 4.4 h timer

5 V only, CC 5.1k pull-downs

Schematic | Case_Schematic | Create at | 2026-11-06

Update at | 2026-11-06

Board | Case | Page | 1_Input_Charger
Drawn | Het Bhavsar | Atrium
Reviewed

Version | Size | Page 1 Total 2
V1.0 | A4 | Local Forge

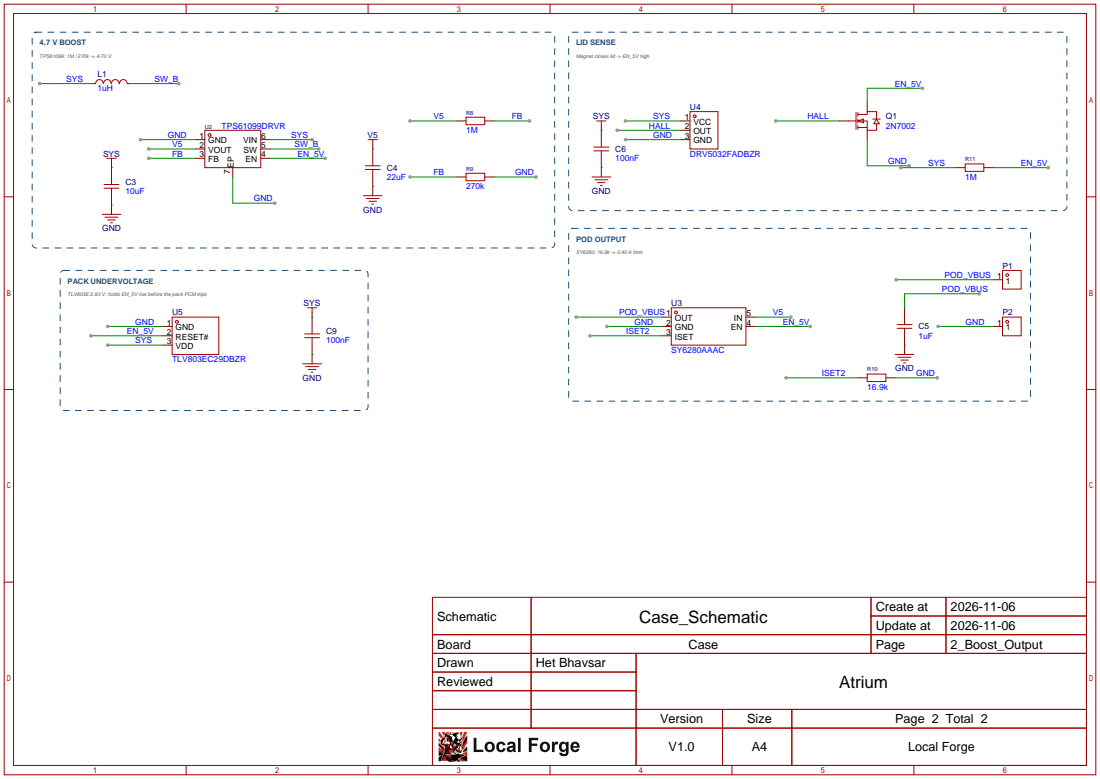
[picture p194: page 2]

Magnet closes lid -> EN_5V high

TLV803E 2.93 V: holds EN_5V low before the pack PCM trips

Schematic | Case_Schematic | Create at | 2026-11-06

Update at | 2026-11-06

Board | Case | Page | 2_Boost_Output
Drawn | Het Bhavsar | Atrium
Reviewed

Version | Size | Page 2 Total 2
V1.0 | A4 | Local Forge
