Het-Bhavsar/Atrium/hardware/pod/schematic/atrium_pod_schematic_revB1-1.pdf

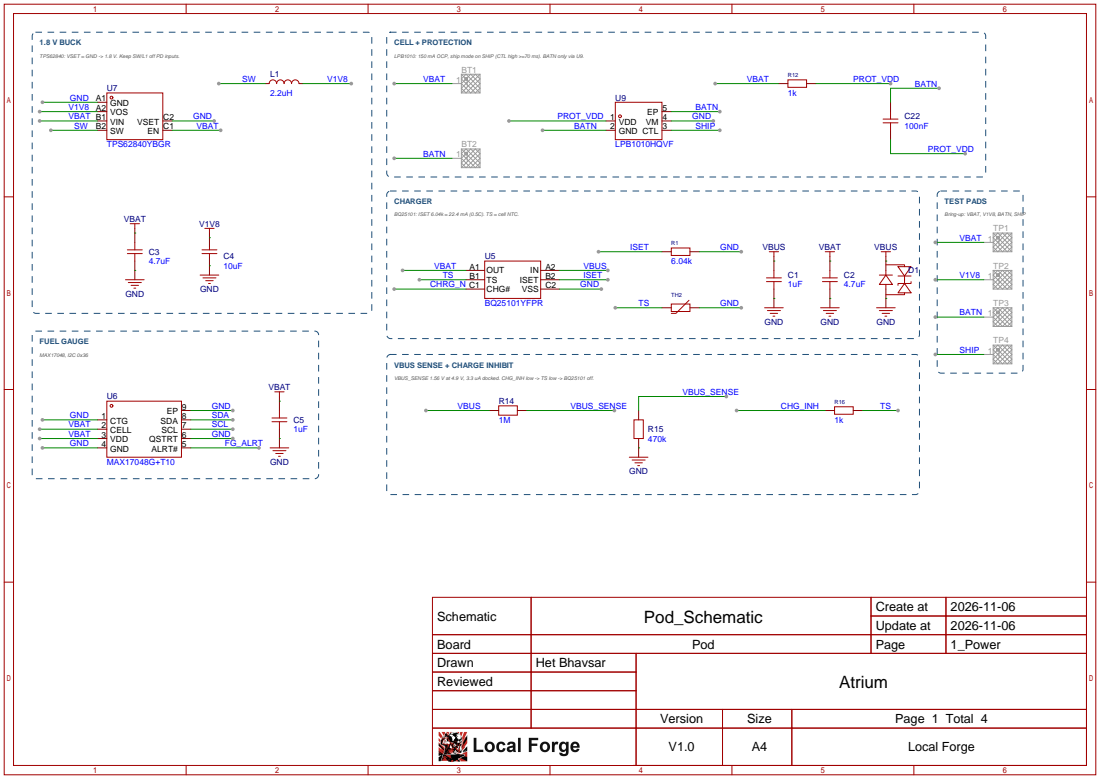
[picture p195: page 1]

TPS62840: VSET = GND -> 1.8 V. Keep SW/L1 off PD inputs.

LPB1010: 150 mA OCP, ship mode on SHIP (CTL high >=70 ms). BATN only via U9.
VBAT

BQ25101: ISET 6.04k = 22.4 mA (0.5C). TS = cell NTC.

VBUS SENSE + CHARGE INHIBIT

VBUS_SENSE 1.56 V at 4.9 V, 3.3 uA docked. CHG_INH low -> TS low -> BQ25101 off.

Schematic | Pod_Schematic | Create at | 2026-11-06

Update at | 2026-11-06

Board | Pod | Page | 1_Power
Drawn | Het Bhavsar | Atrium
Reviewed

Version | Size | Page 1 Total 4
V1.0 | A4 | Local Forge

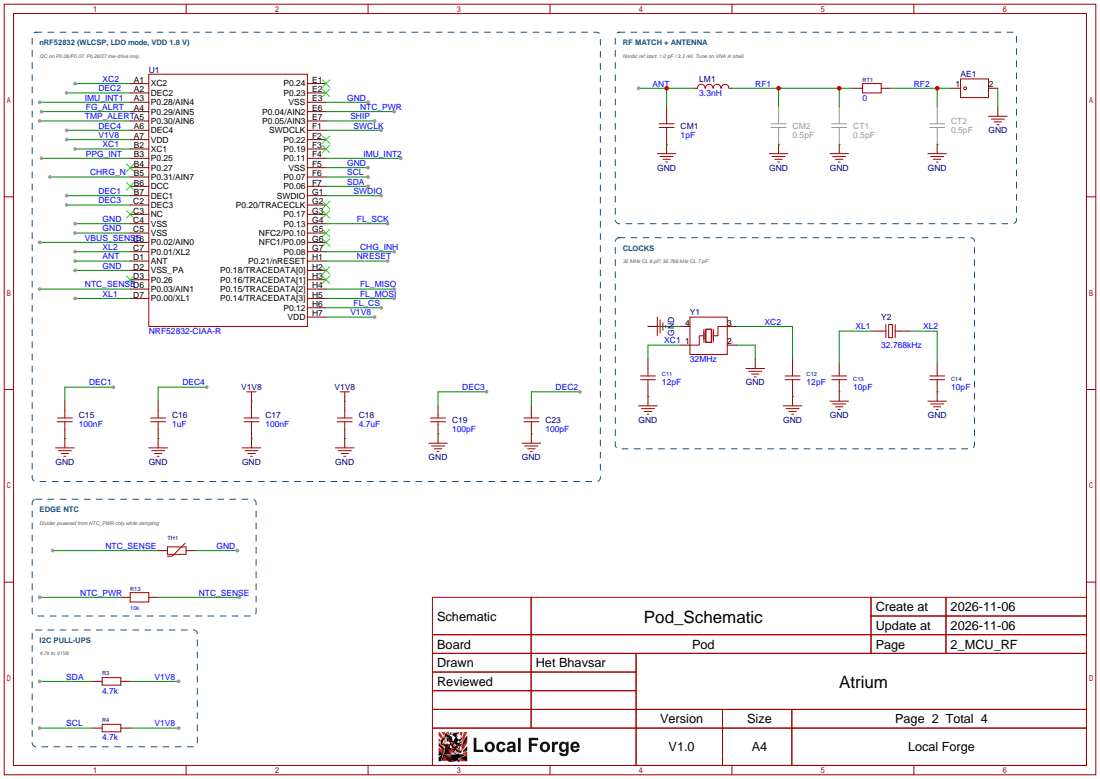
[picture p196: page 2]

nRF52832 (WLCSP, LDO mode, VDD 1.8 V)

I2C on P0.06/P0.07. P0.26/27 low-drive only.

Nordic ref start: 1.0 pF / 3.3 nH. Tune on VNA in shell.

32 MHz CL 8 pF; 32.768 kHz CL 7 pF

Divider powered from NTC_PWR only while sampling

Schematic | Pod_Schematic | Create at | 2026-11-06

Update at | 2026-11-06

Board | Pod | Page | 2_MCU_RF
Drawn | Het Bhavsar | Atrium
Reviewed

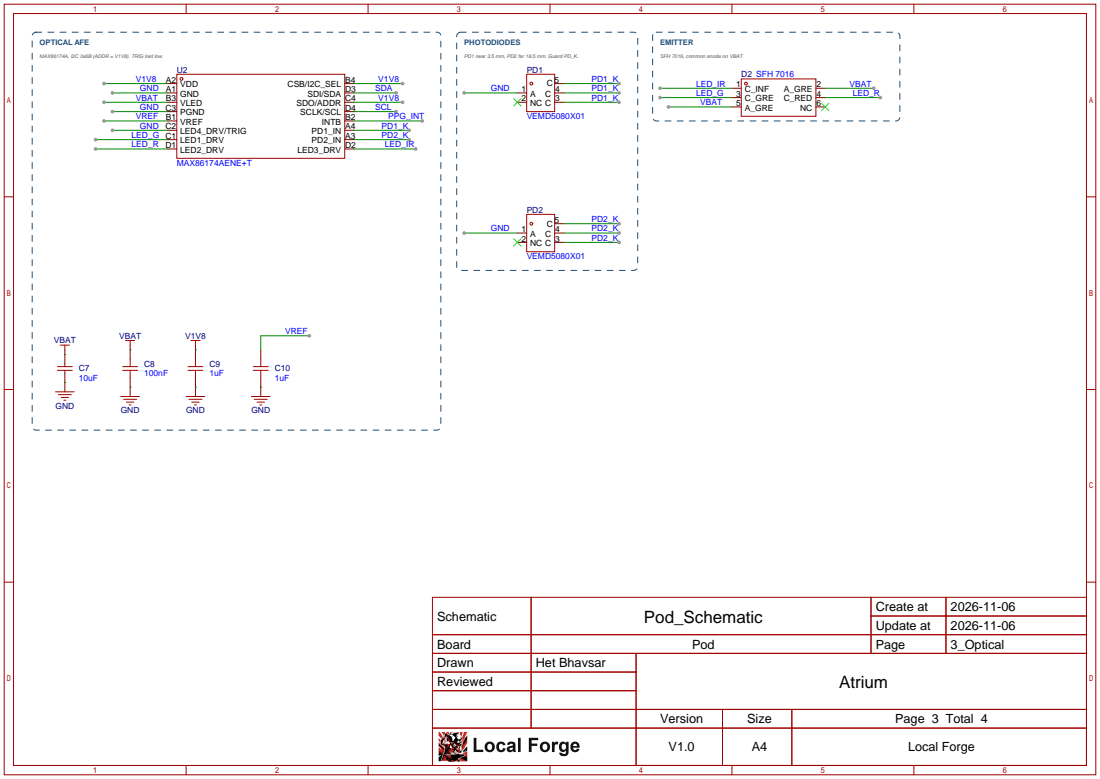
[picture p197: page 3]

MAX86174A, I2C 0x6B (ADDR = V1V8). TRIG tied low.

PD1 near 3.5 mm, PD2 far 18.5 mm. Guard PD_K.

SFH 7016, common anode on VBAT

Schematic | Pod_Schematic | Create at | 2026-11-06

Update at | 2026-11-06

Board | Pod | Page | 3_Optical
Drawn | Het Bhavsar | Atrium
Reviewed

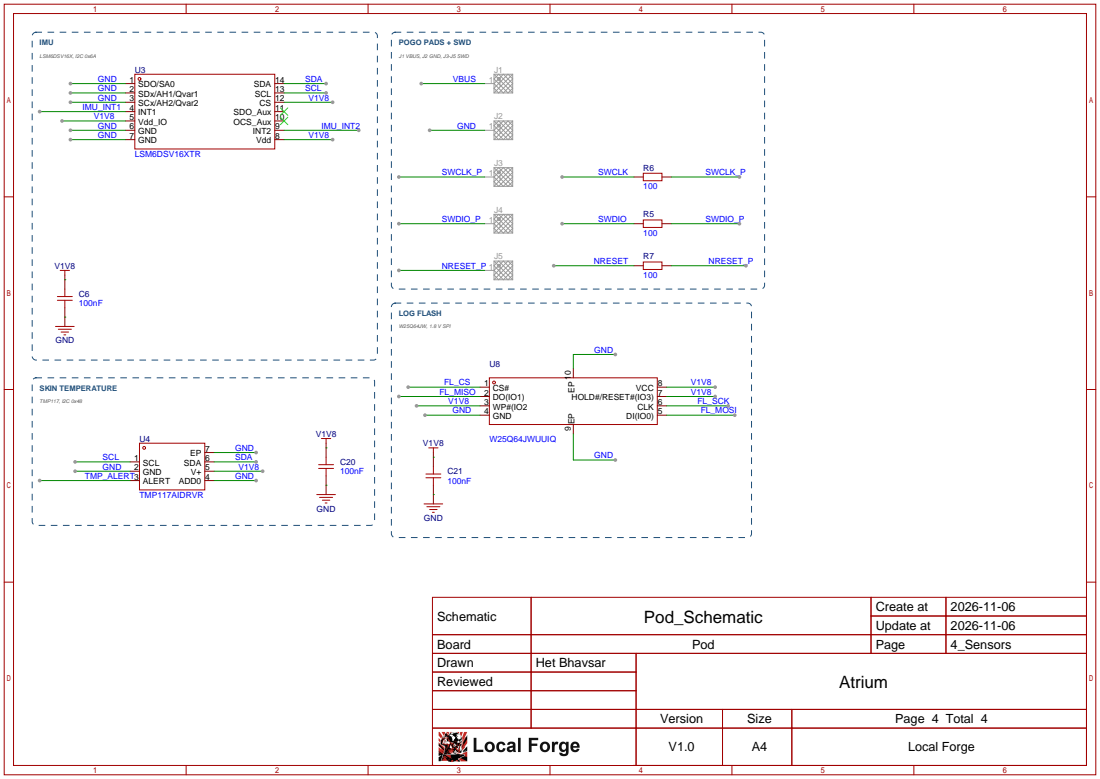
[picture p198: page 4]

Schematic | Pod_Schematic | Create at | 2026-11-06

Update at | 2026-11-06

Board | Pod | Page | 4_Sensors
Drawn | Het Bhavsar | Atrium
Reviewed
