Het-Bhavsar/Atrium/hardware/case/charging-case/schematic/Atrium_Charging_Case_Schematic.pdf

## ATRIUM EVT - CHARGING CASE (CH32V003, 500 mAh cell, pod feed, SWD reset)

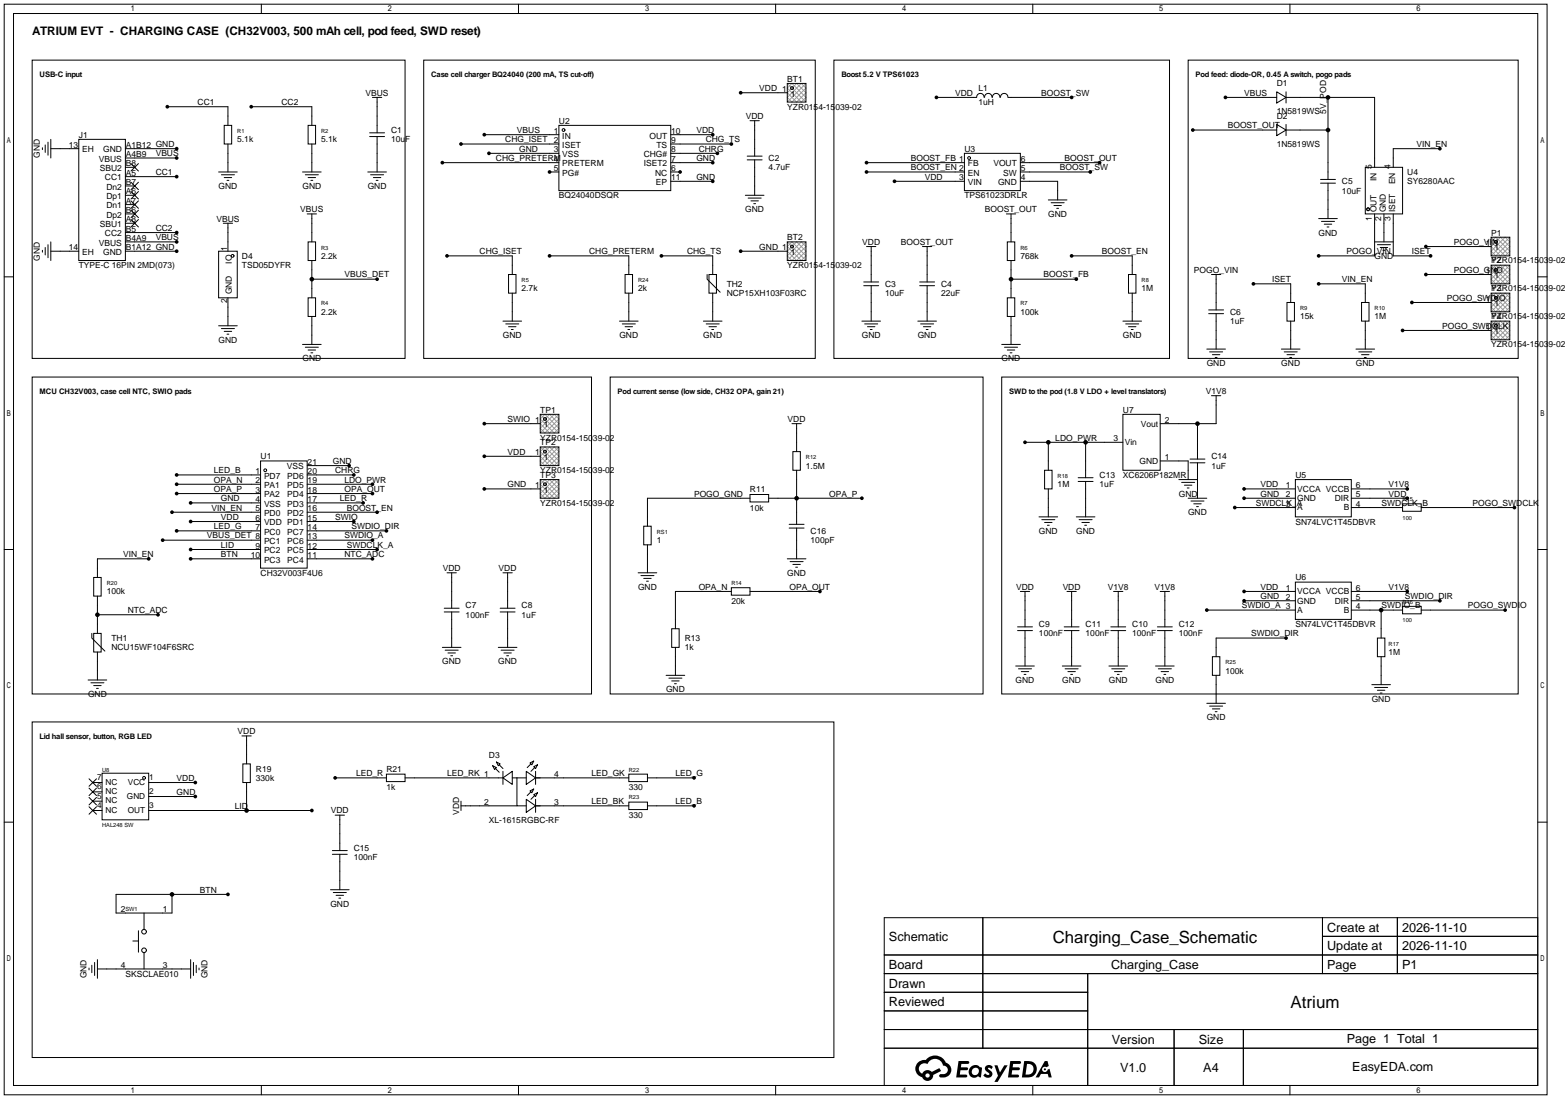
[picture p199: page 1]

Lid hall sensor, button, RGB LED

Schematic | Charging_Case_Schematic | Create at | 2026-11-10

Update at | 2026-11-10

Board | Charging_Case | Page | P1
Drawn | | Atrium
Reviewed

Version | Size | Page 1 Total 1
V1.0 | A4 | EasyEDA.com
