Het-Bhavsar/Atrium/hardware/pod/flex-jumper/schematic/Atrium_Flex_Jumper_Schematic.pdf

## ATRIUM EVT - FLEX JUMPER (2-layer FPC between the islands, skin-side contacts)

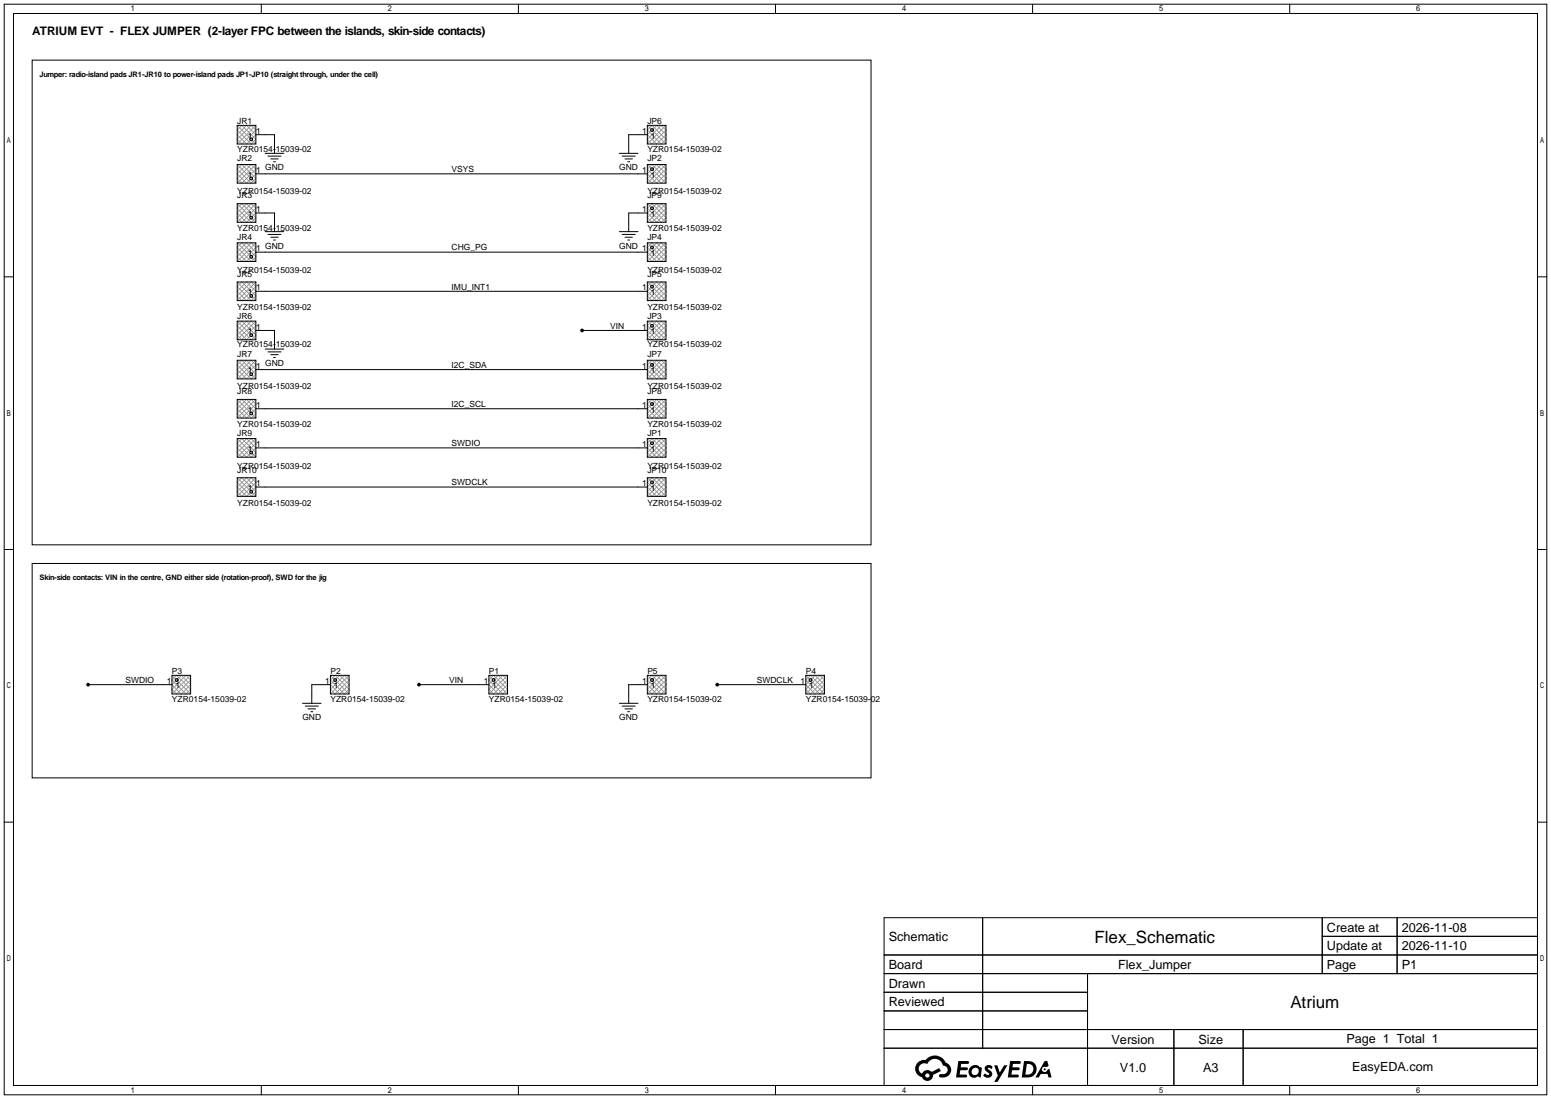
[picture p200: page 1]

Jumper: radio-island pads JR1-JR10 to power-island pads JP1-JP10 (straight through, under the cell)

Skin-side contacts: VIN in the centre, GND either side (rotation-proof), SWD for the jig

Schematic | Flex_Schematic | Create at | 2026-11-08

Update at | 2026-11-10

Board | Flex_Jumper | Page | P1
Drawn | | Atrium
Reviewed

Version | Size | Page 1 Total 1
V1.0 | A3 | EasyEDA.com
