Het-Bhavsar/Atrium/hardware/pod/power-island/schematic/Atrium_Power_Island_Schematic.pdf

## ATRIUM EVT - POWER ISLAND (BQ21061 charger, AP6683 cell protection, LSM6DSOX IMU)

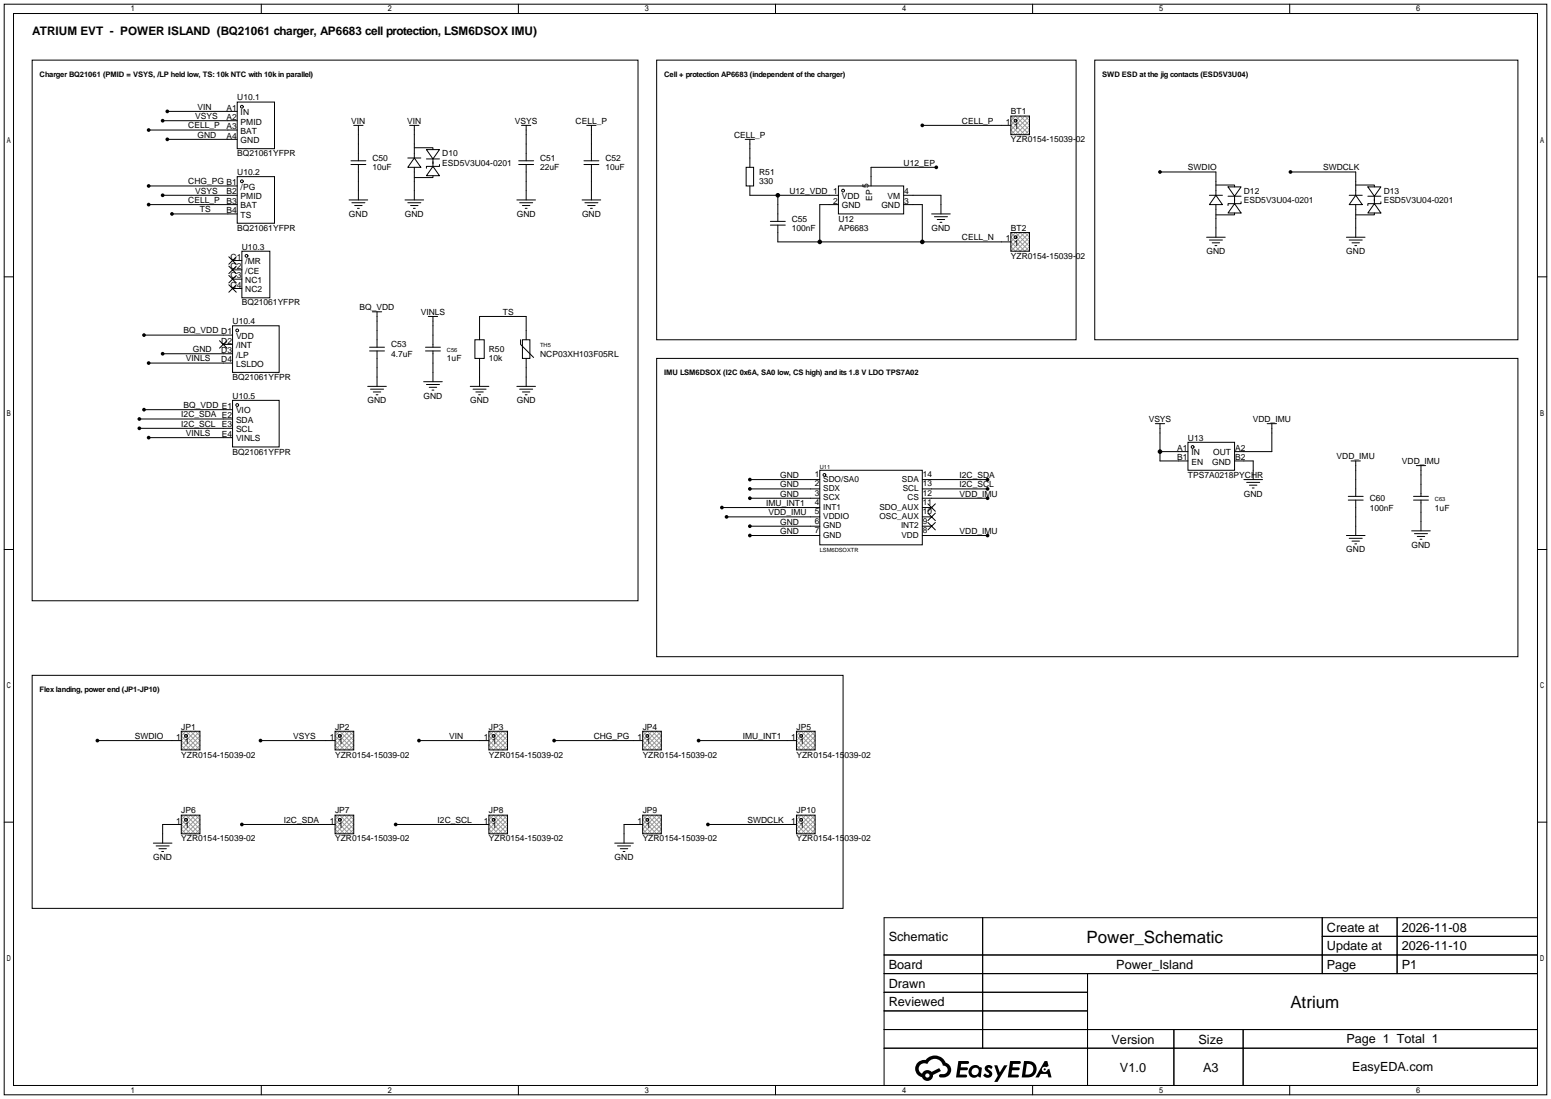
[picture p201: page 1]

IMU LSM6DSOX (I2C 0x6A, SA0 low, CS high) and its 1.8 V LDO TPS7A02

Flex landing, power end (JP1-JP10)

Schematic | Power_Schematic | Create at | 2026-11-08

Update at | 2026-11-10

Board | Power_Island | Page | P1
Drawn | | Atrium
Reviewed

Version | Size | Page 1 Total 1
V1.0 | A3 | EasyEDA.com
