Het-Bhavsar/Atrium/hardware/pod/radio-island/schematic/Atrium_Radio_Island_Schematic.pdf

## ATRIUM EVT - RADIO ISLAND (nRF52832-CIAA, BLE antenna, MAXM86161A optics, NTCs)

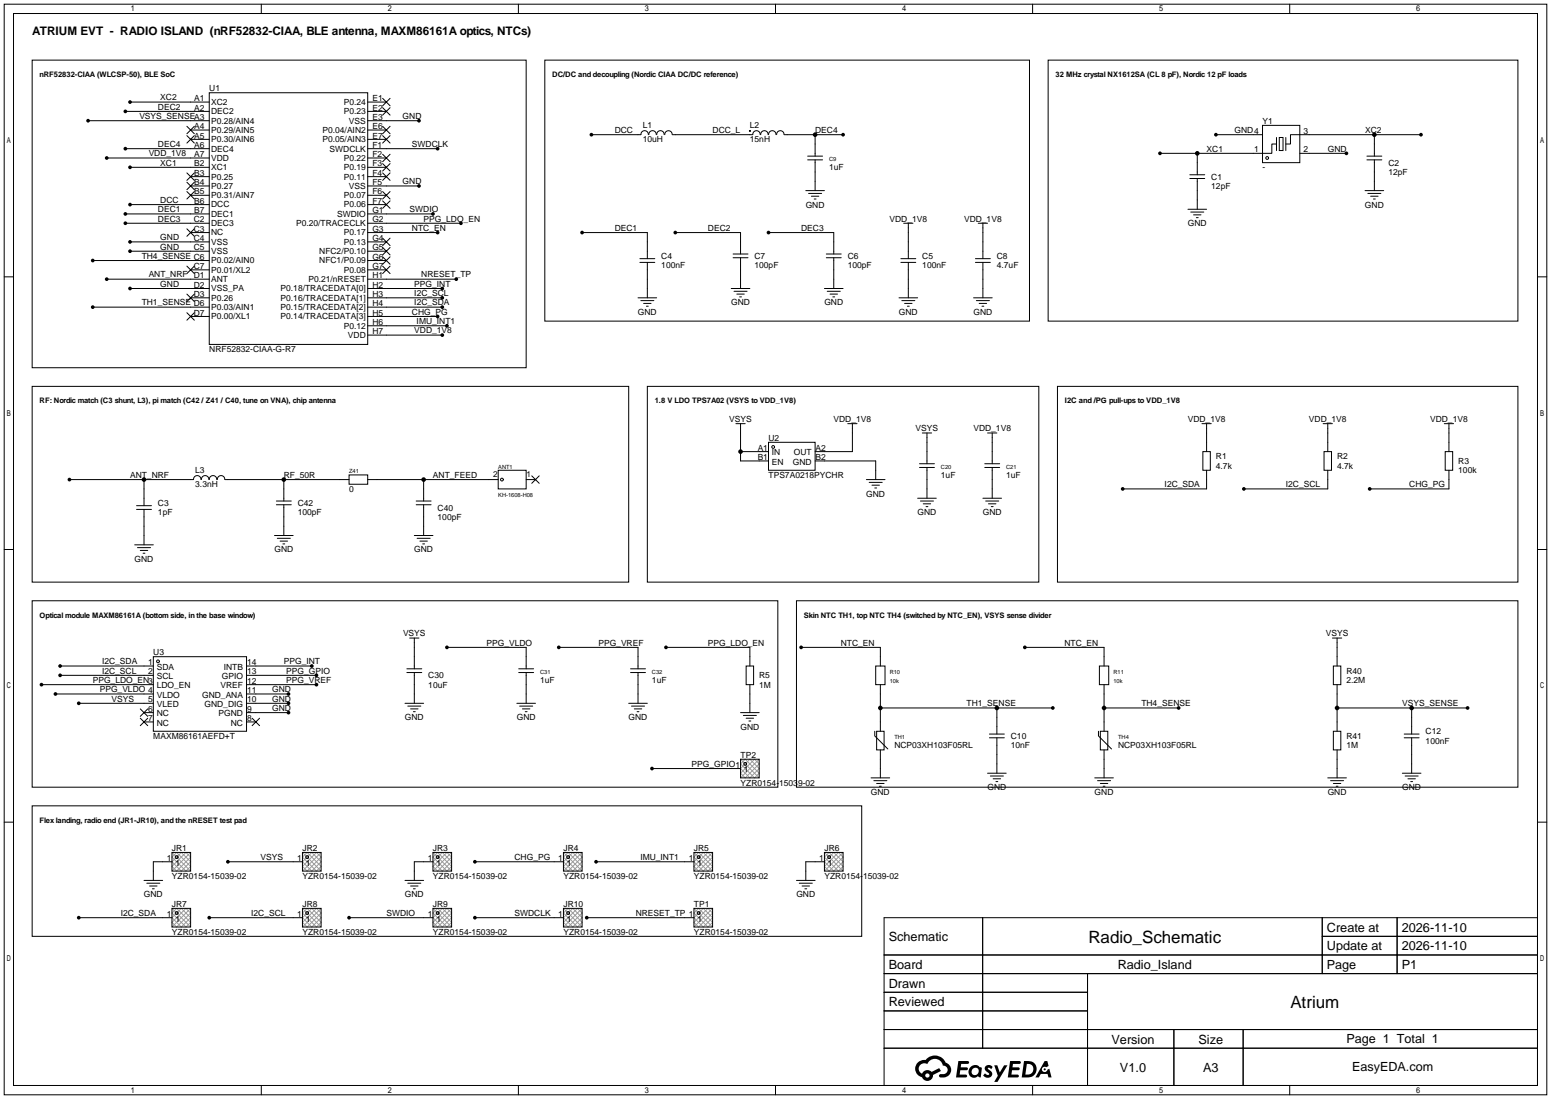
[picture p202: page 1]

Optical module MAXM86161A (bottom side, in the base window)

Skin NTC TH1, top NTC TH4 (switched by NTC_EN), VSYS sense divider

Flex landing, radio end (JR1-JR10), and the nRESET test pad

Schematic | Radio_Schematic | Create at | 2026-11-10

Update at | 2026-11-10

Board | Radio_Island | Page | P1
Drawn | | Atrium
Reviewed

Version | Size | Page 1 Total 1
V1.0 | A3 | EasyEDA.com
