Het-Bhavsar/Atrium/mechanical/case/drawings/case_button_drawing.pdf

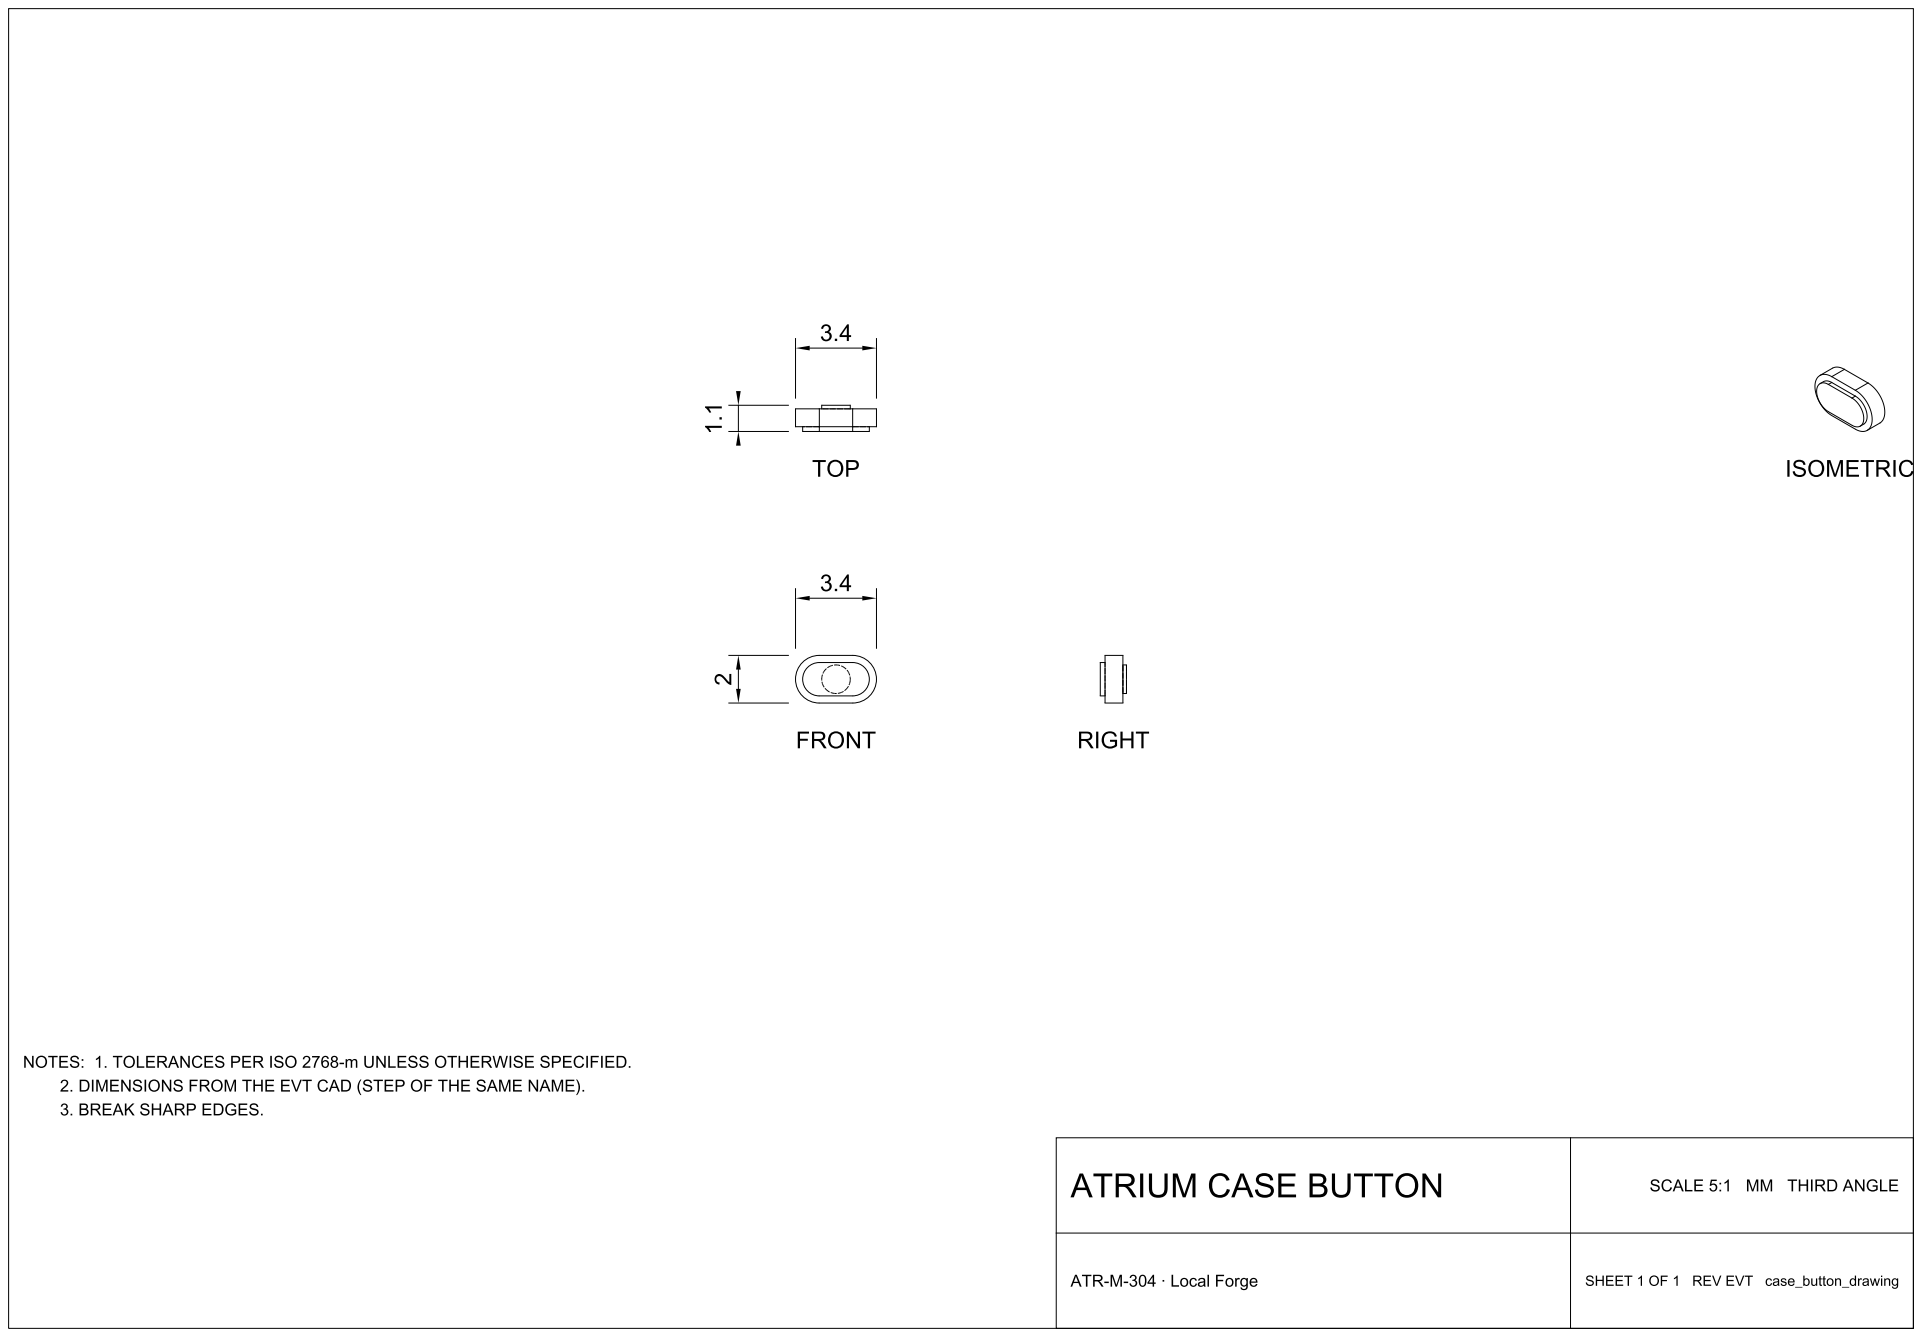
[picture p203: page 1]
