Het-Bhavsar/Atrium/mechanical/case/drawings/case_deck_drawing.pdf

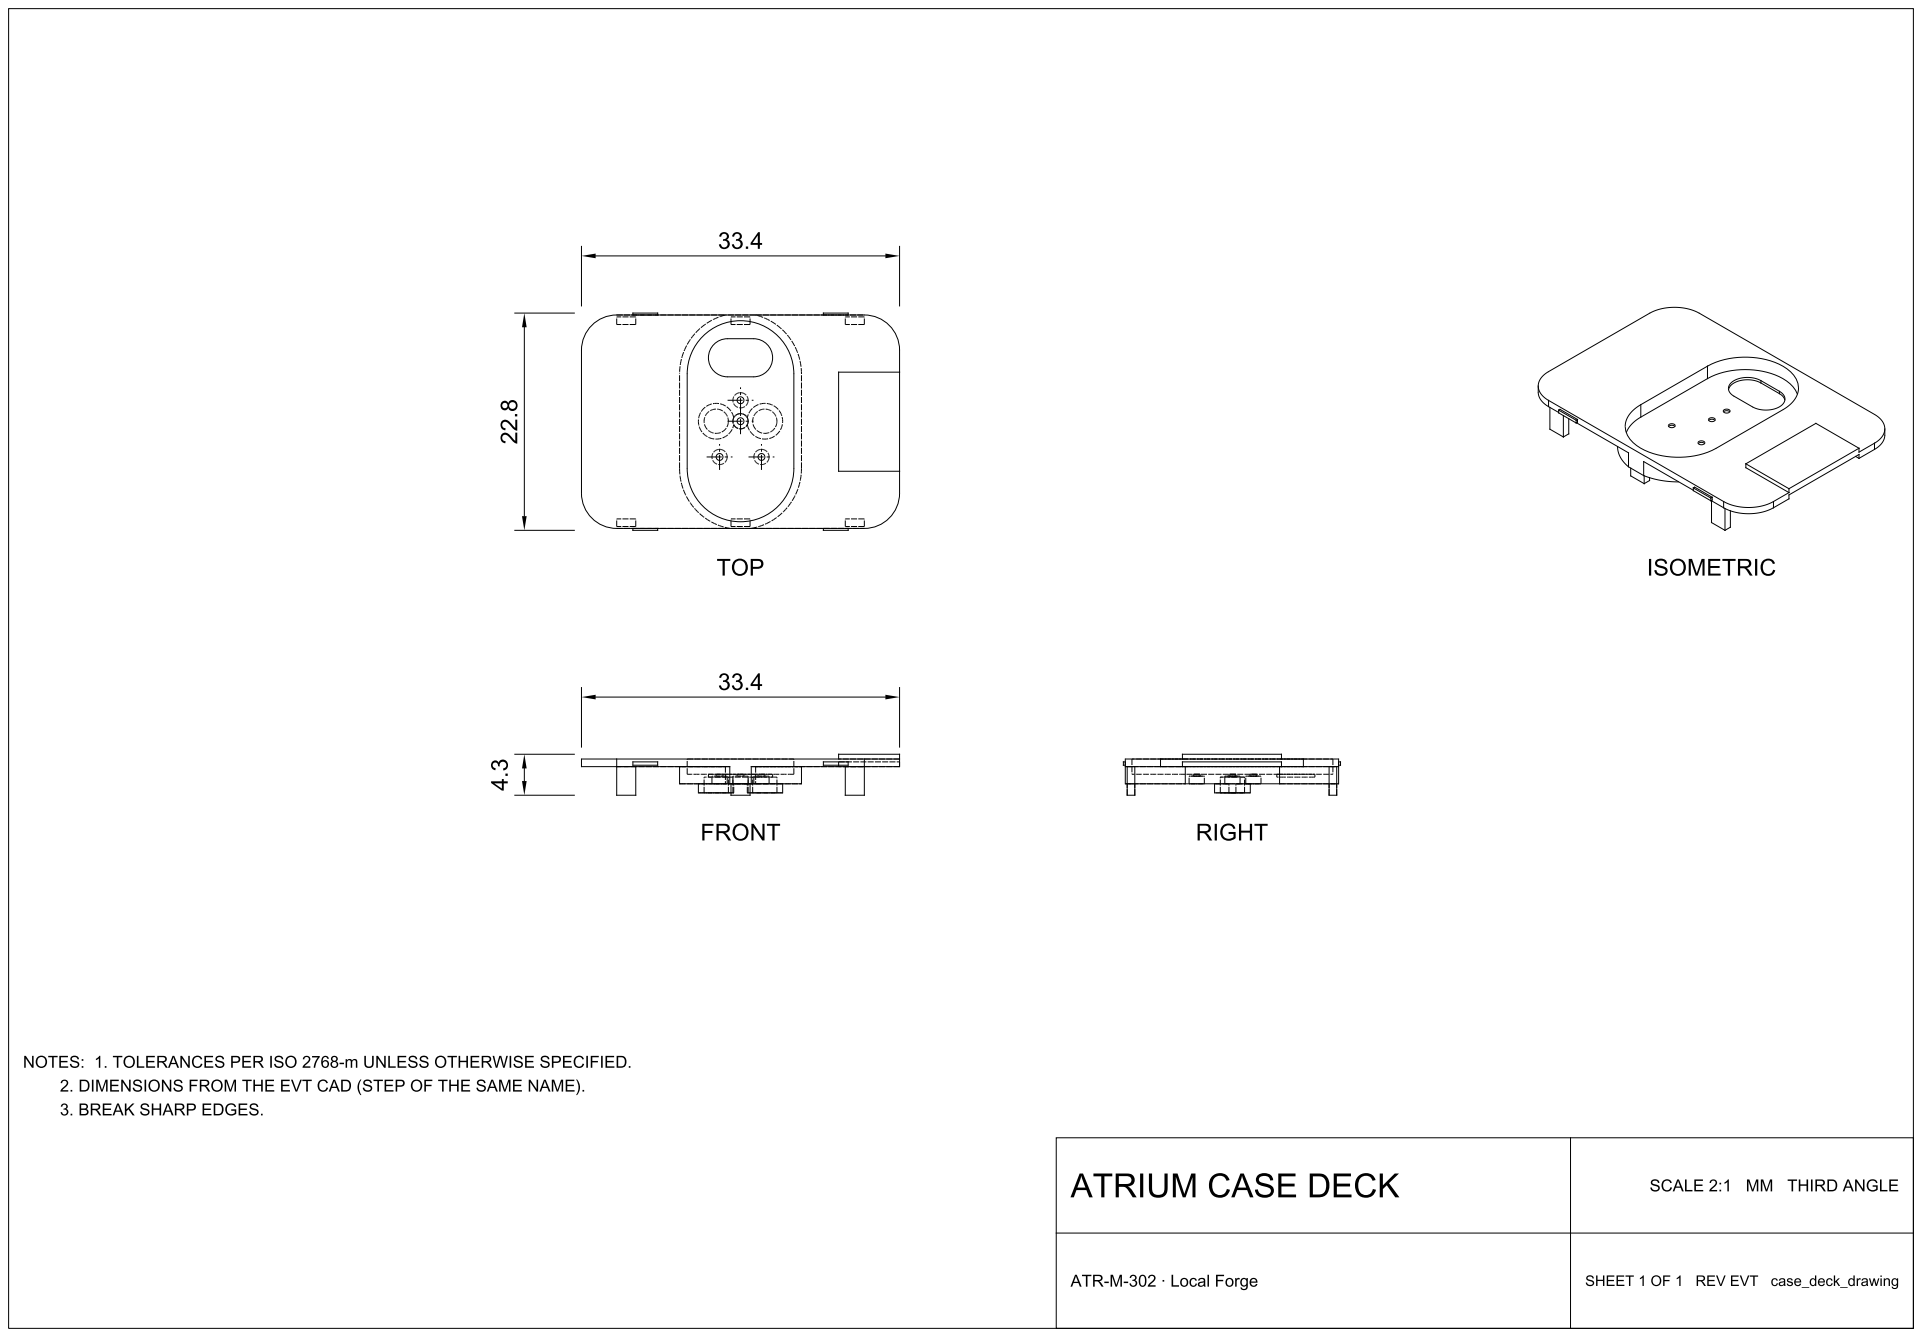
[picture p204: page 1]
