Het-Bhavsar/Atrium/mechanical/case/drawings/case_lid_drawing.pdf

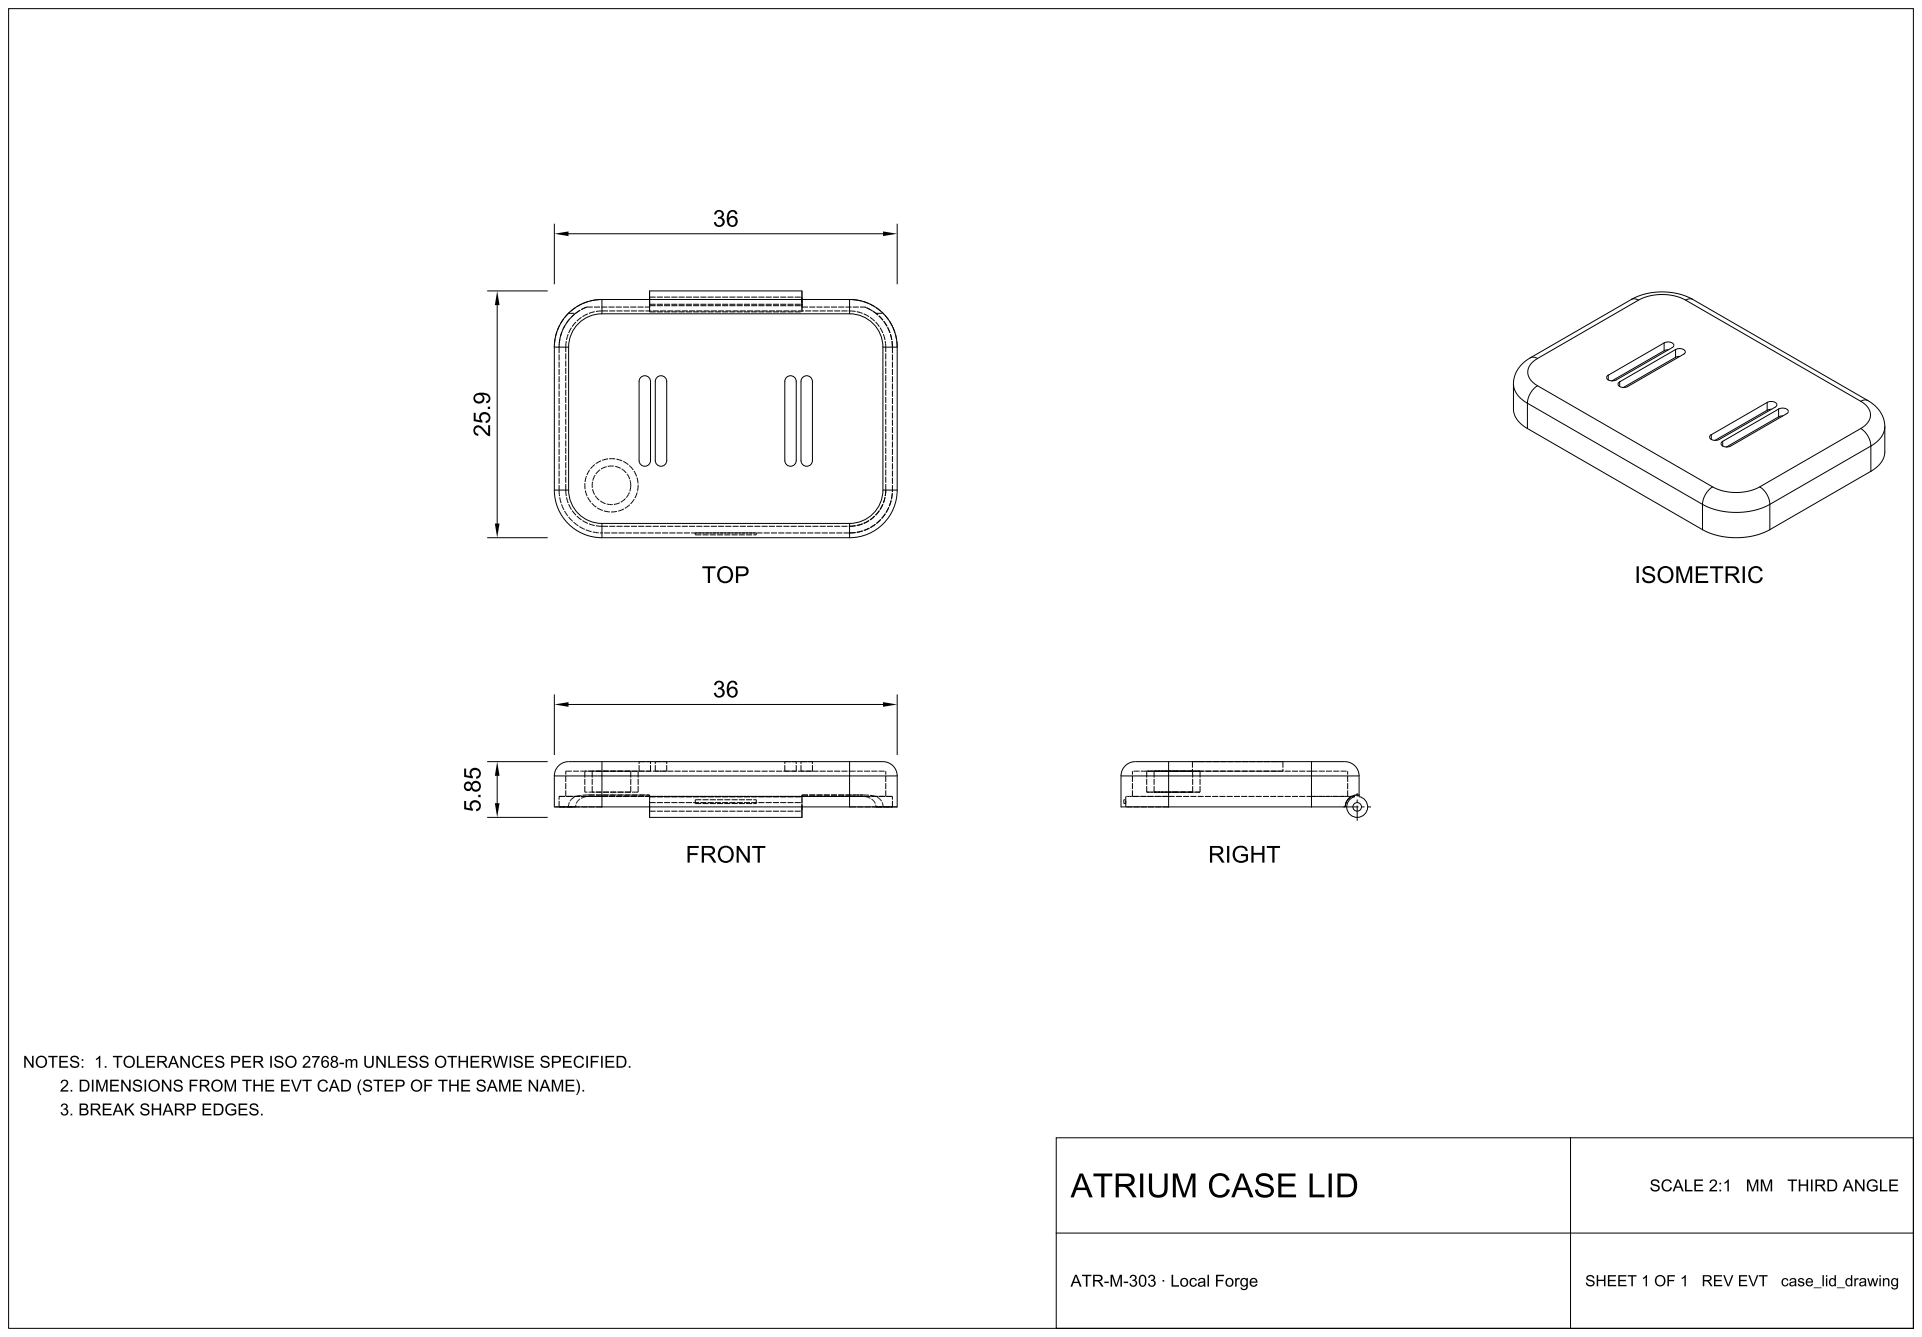
[picture p205: page 1]
