Het-Bhavsar/Atrium/mechanical/case/drawings/case_light_pipe_drawing.pdf

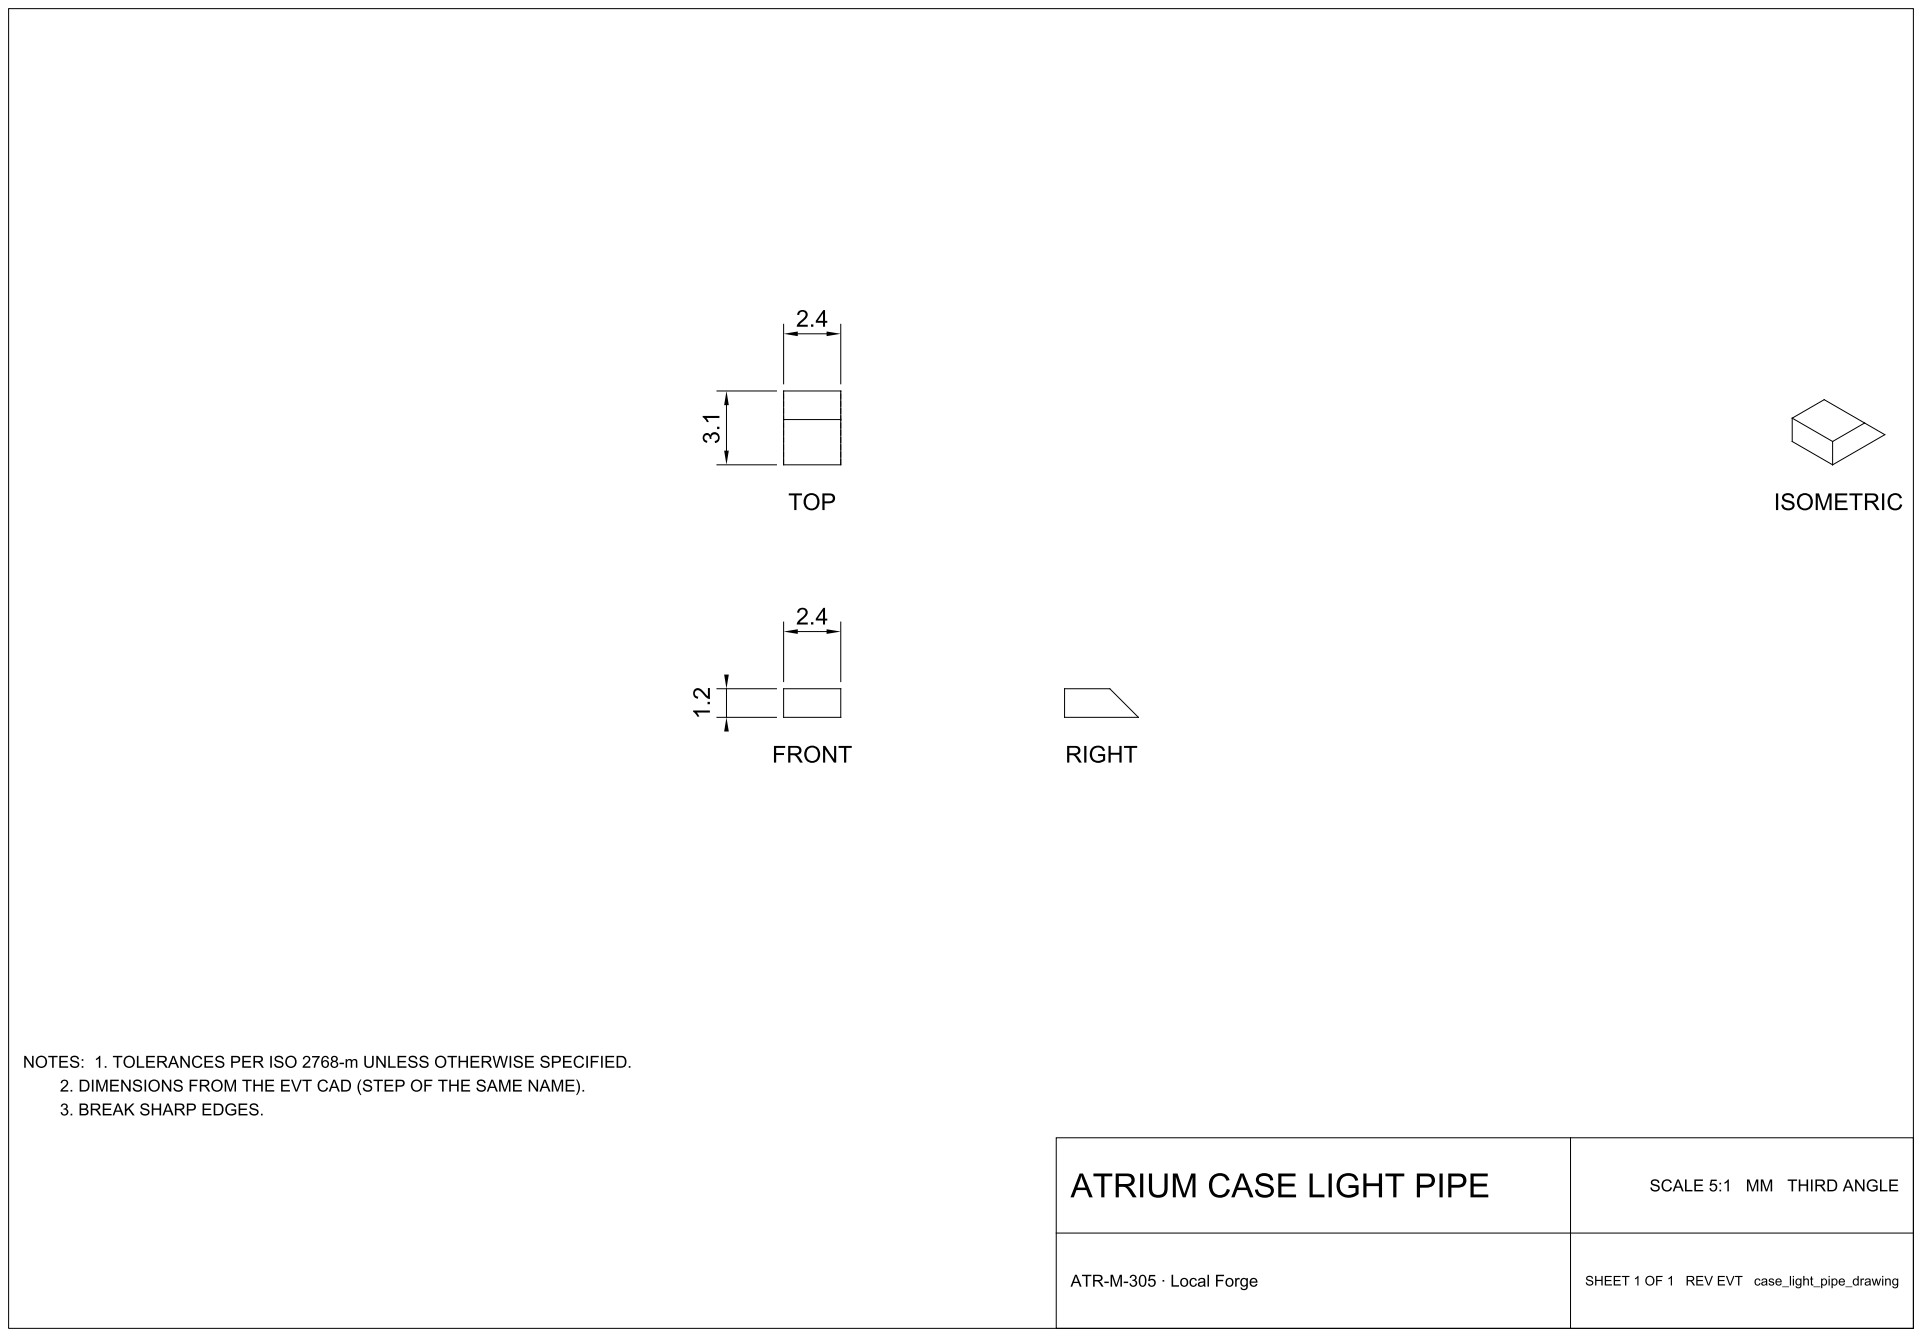
[picture p206: page 1]
