Het-Bhavsar/Atrium/mechanical/case/drawings/case_tub_drawing.pdf

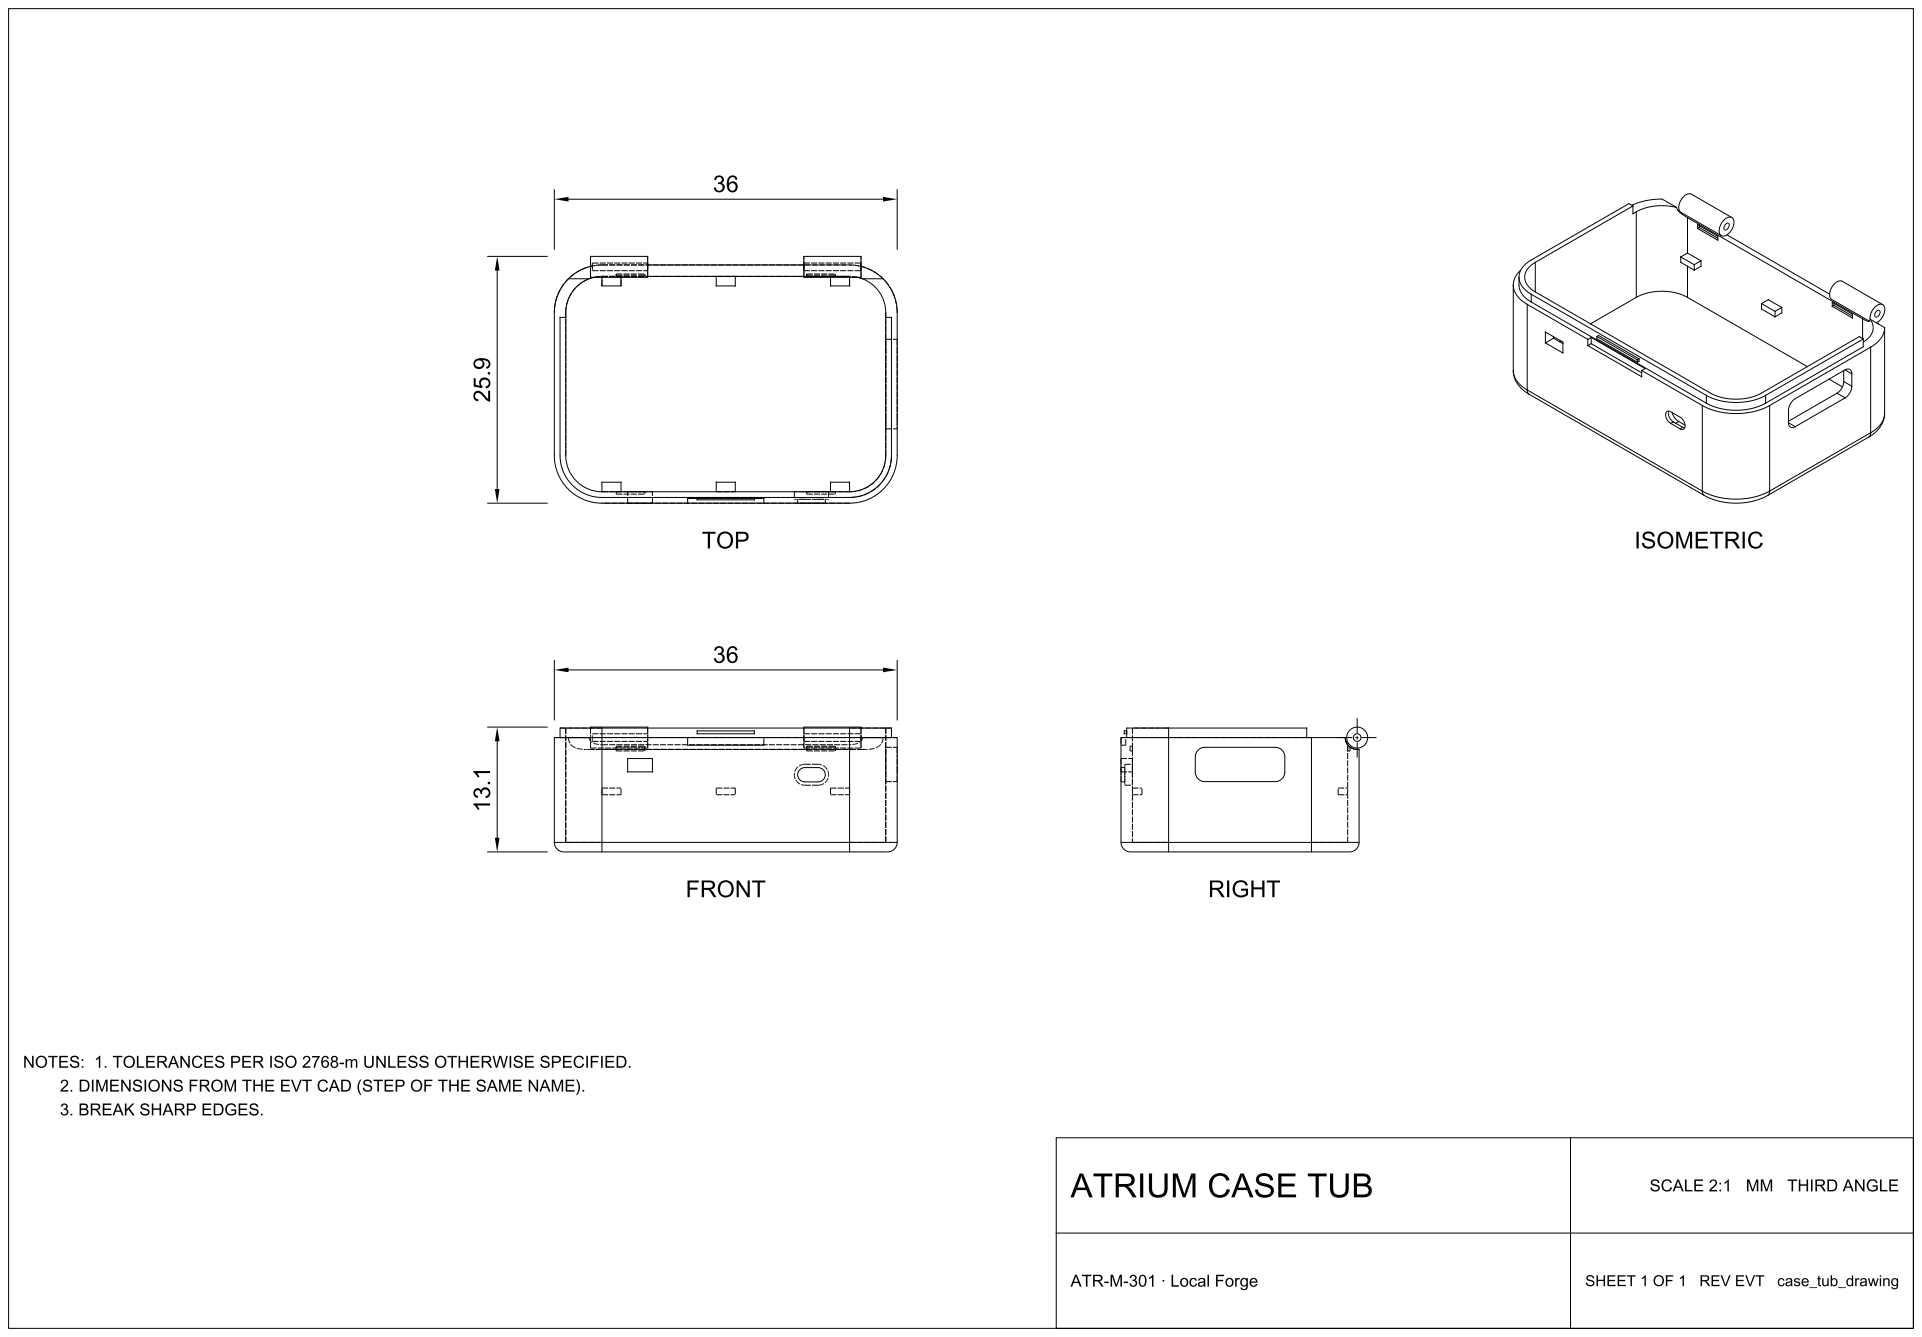
[picture p207: page 1]
