Het-Bhavsar/Atrium/mechanical/packaging/drawings/packaging_pulp_tray_drawing.pdf

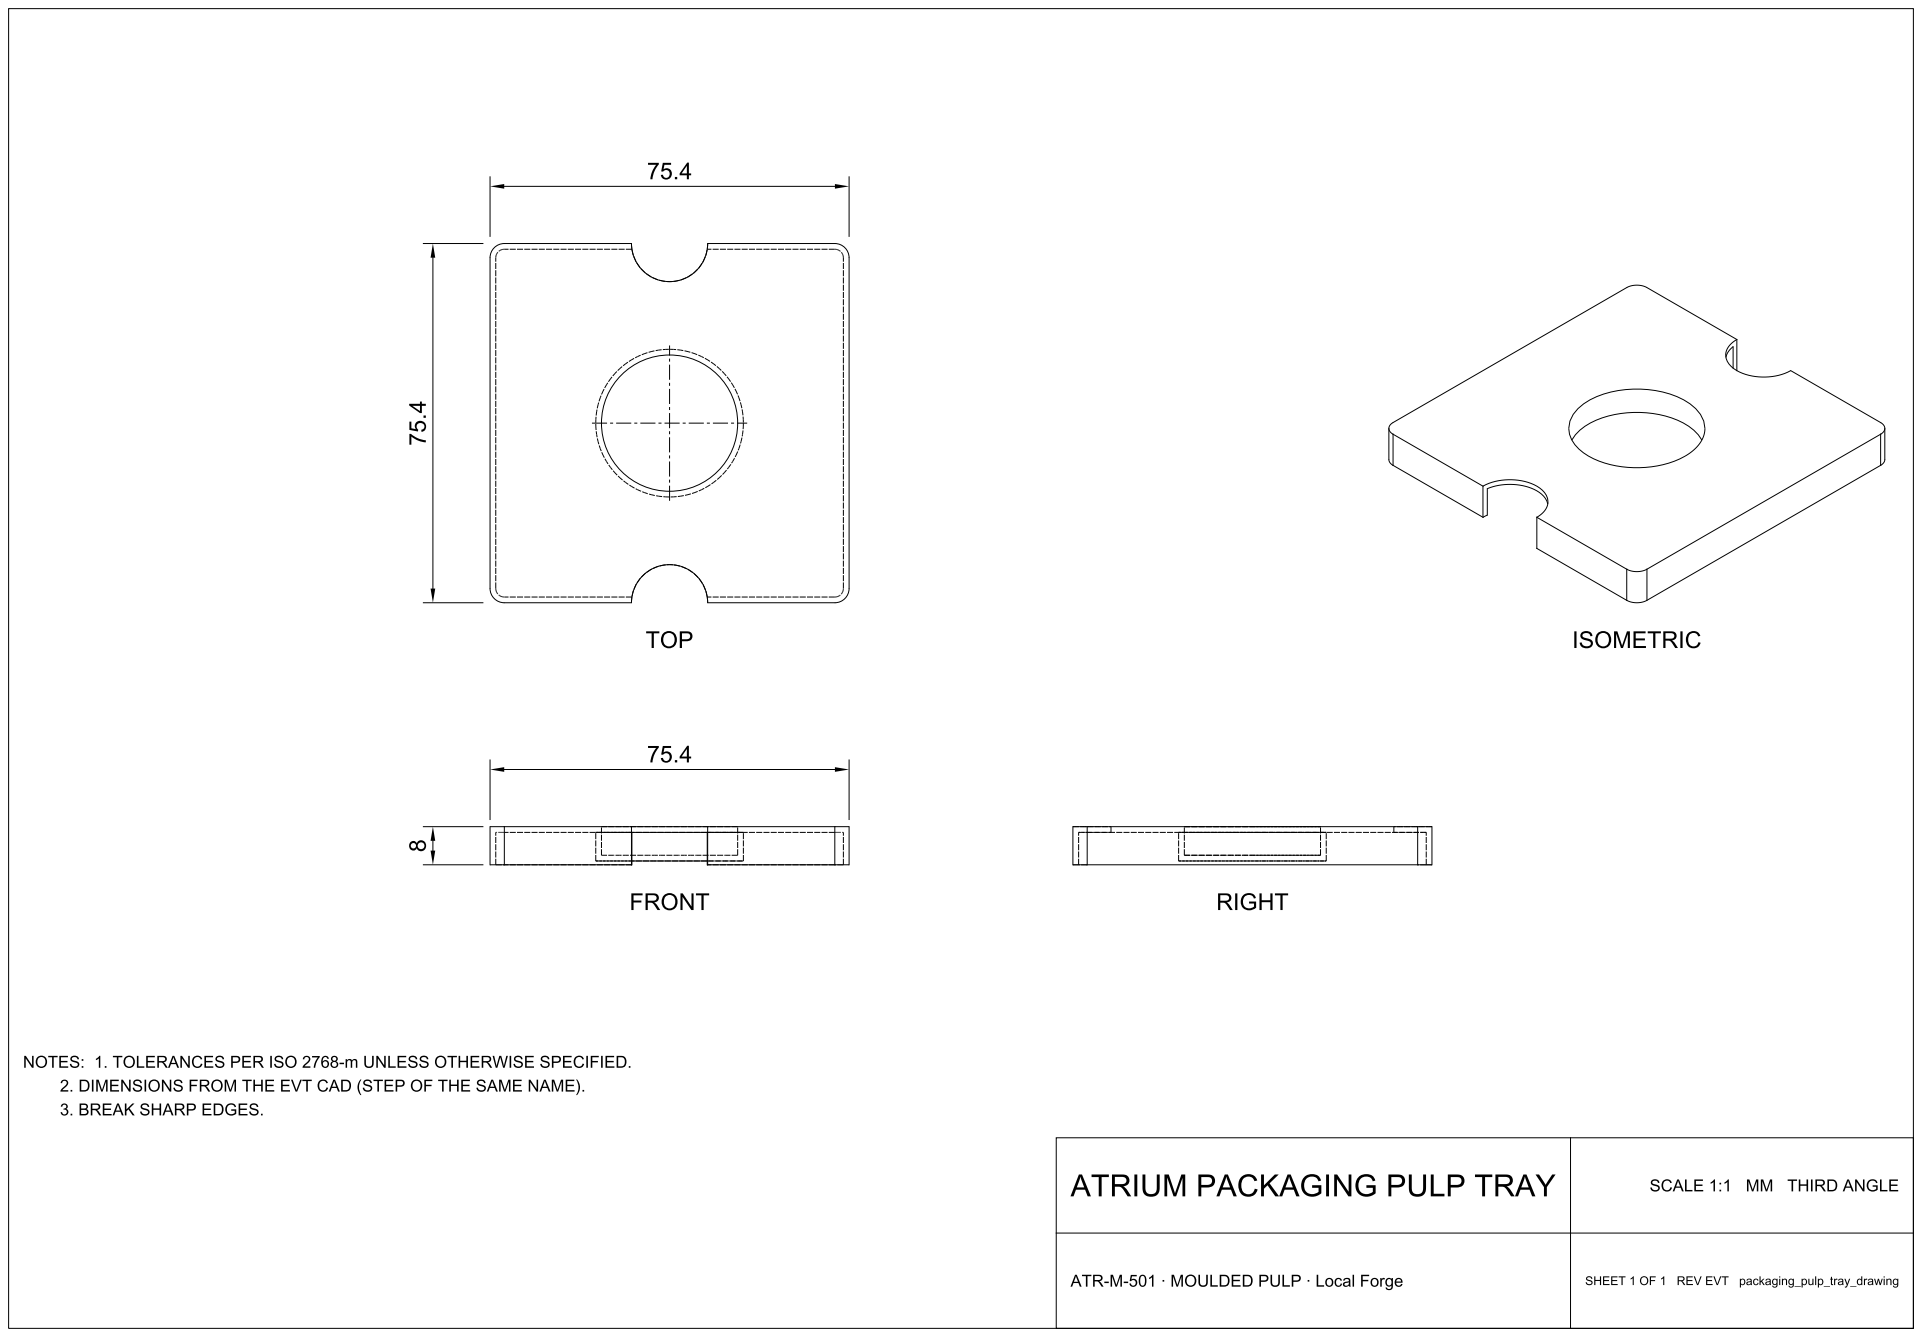
[picture p208: page 1]
