Het-Bhavsar/Atrium/mechanical/plinth/drawings/plinth_housing_drawing.pdf

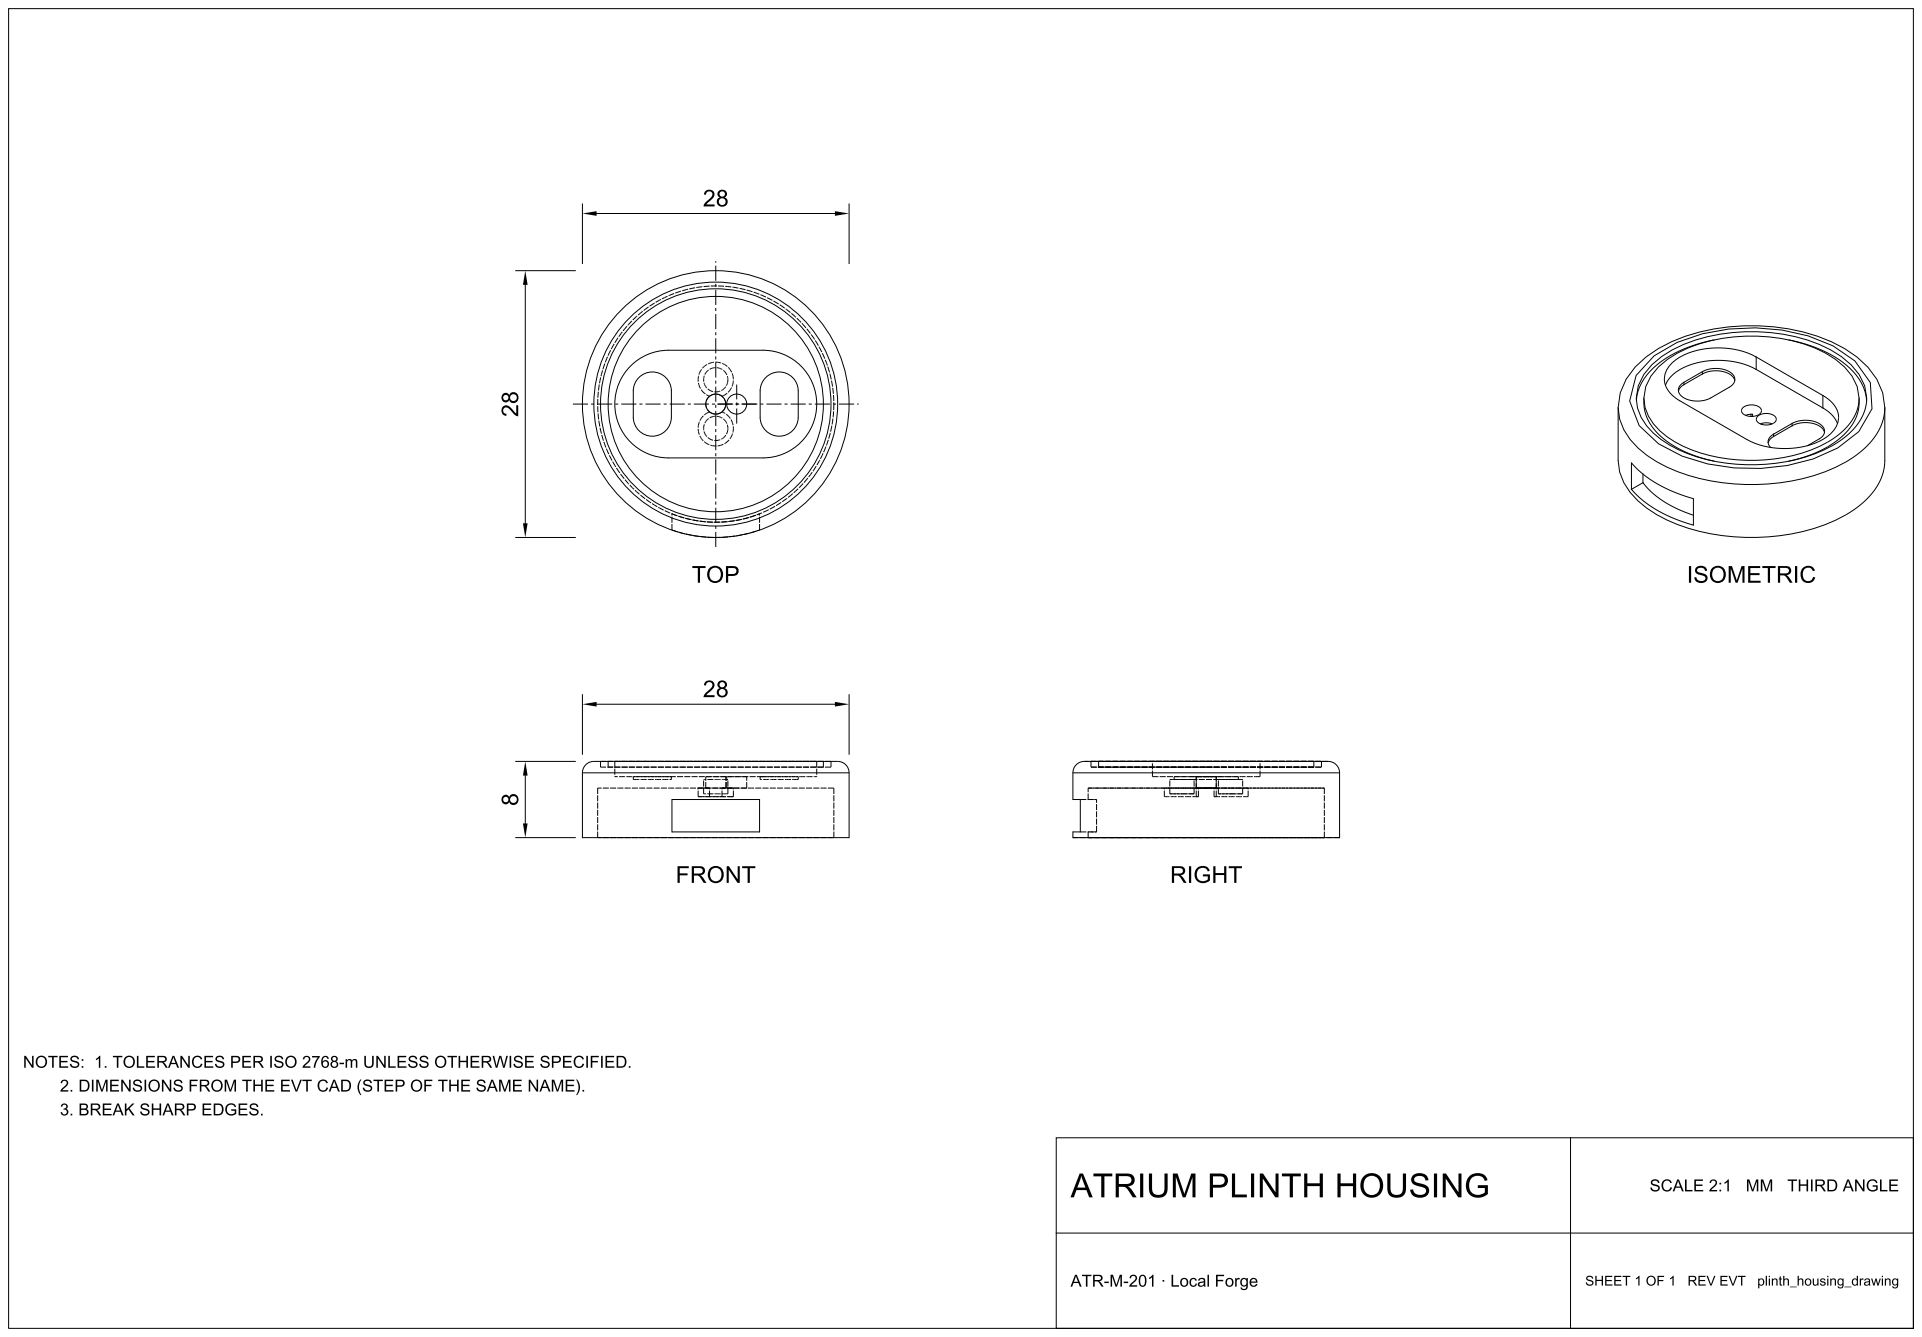
[picture p209: page 1]
