Het-Bhavsar/Atrium/mechanical/pod/drawings/pod_base_drawing.pdf

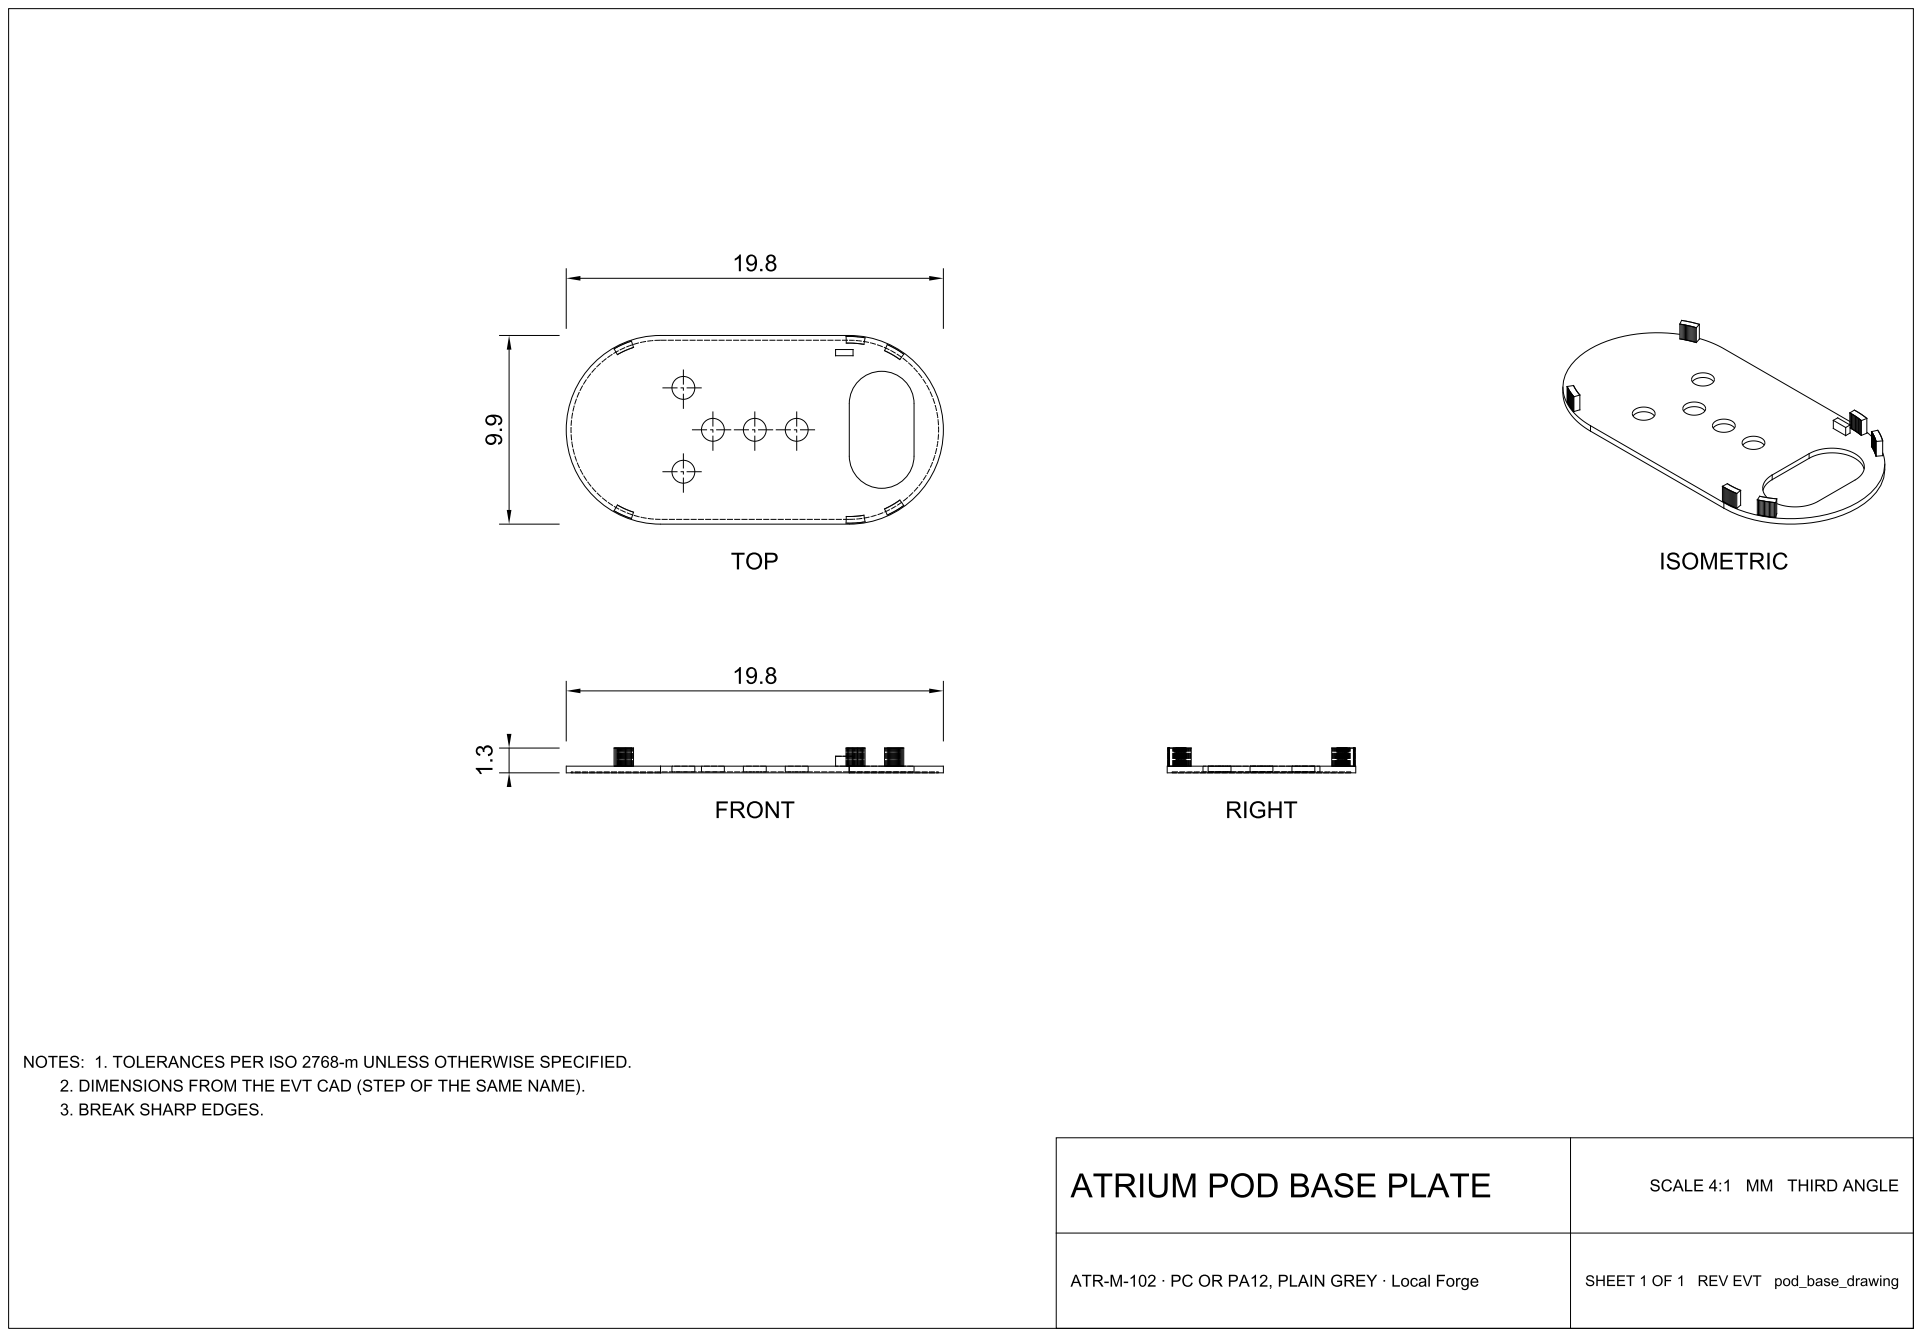
[picture p210: page 1]
