Het-Bhavsar/Atrium/mechanical/pod/drawings/pod_shell_drawing.pdf

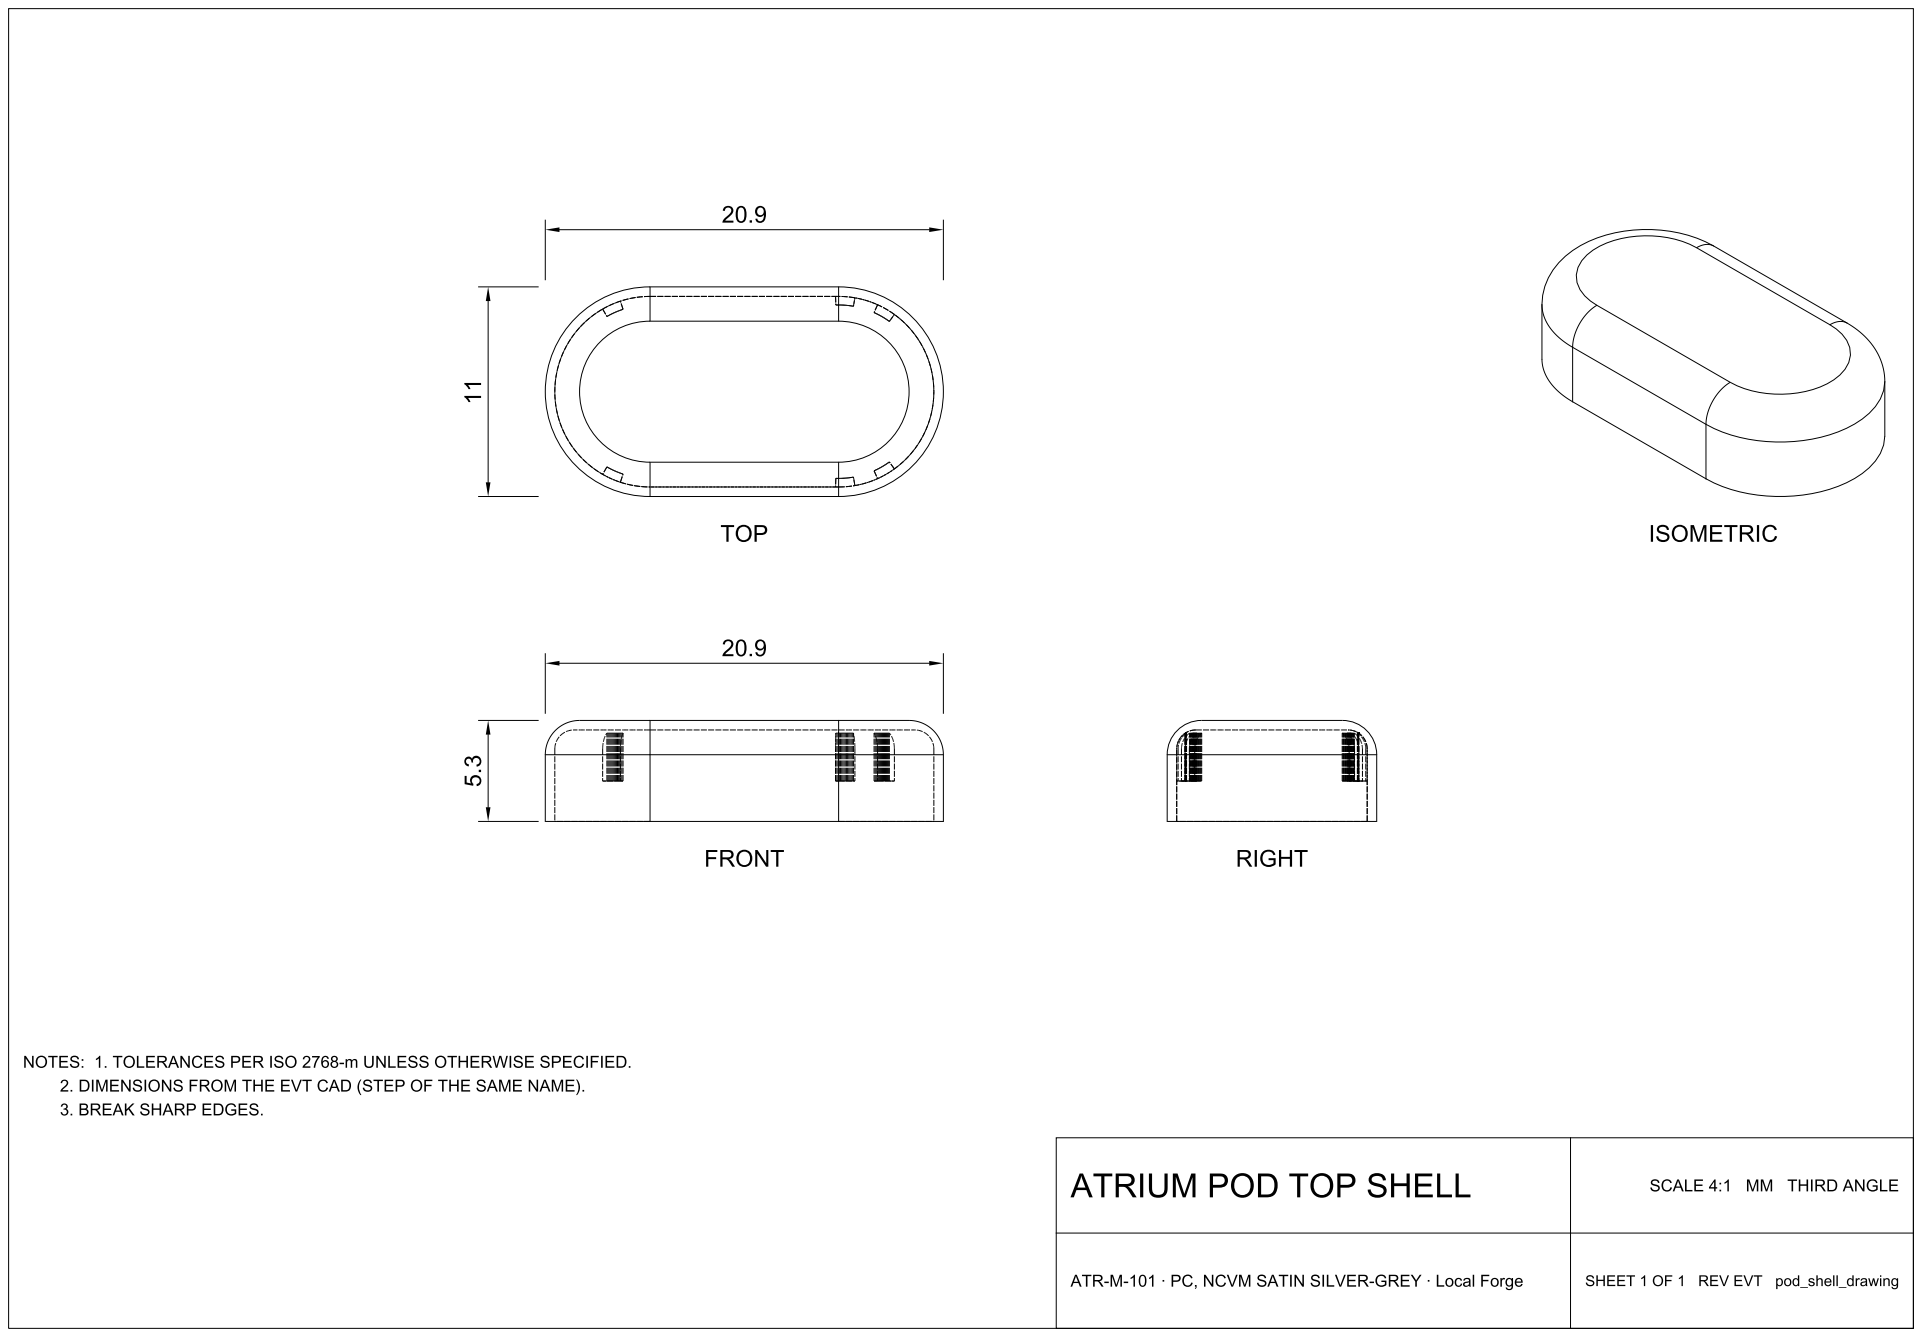
[picture p211: page 1]
