Het-Bhavsar/Atrium/mechanical/pod/drawings/pod_window_gasket_drawing.pdf

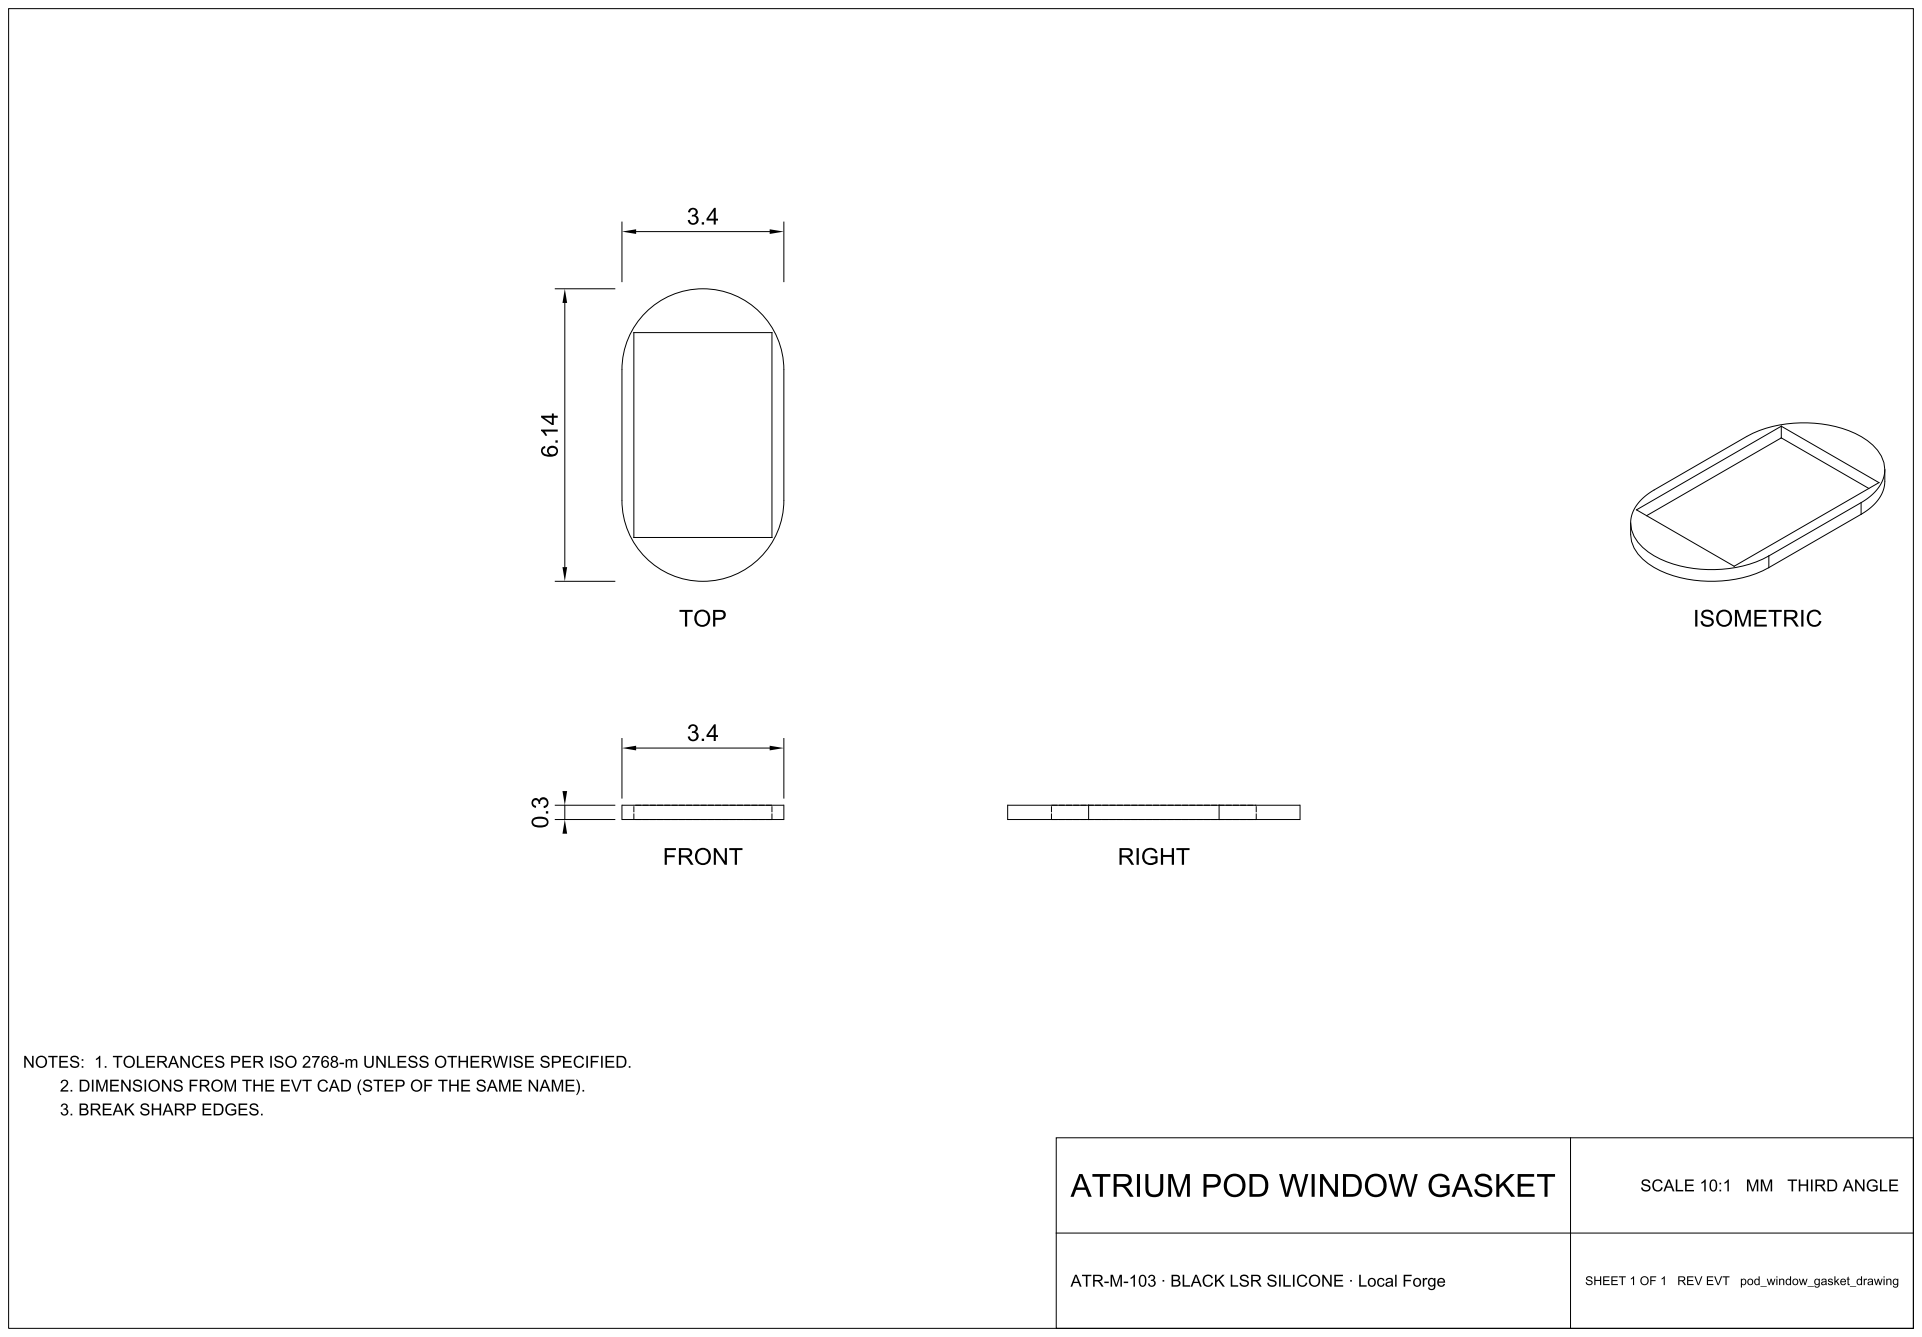
[picture p212: page 1]
