Het-Bhavsar/Atrium/mechanical/pod/drawings/skin_pad_drawing.pdf

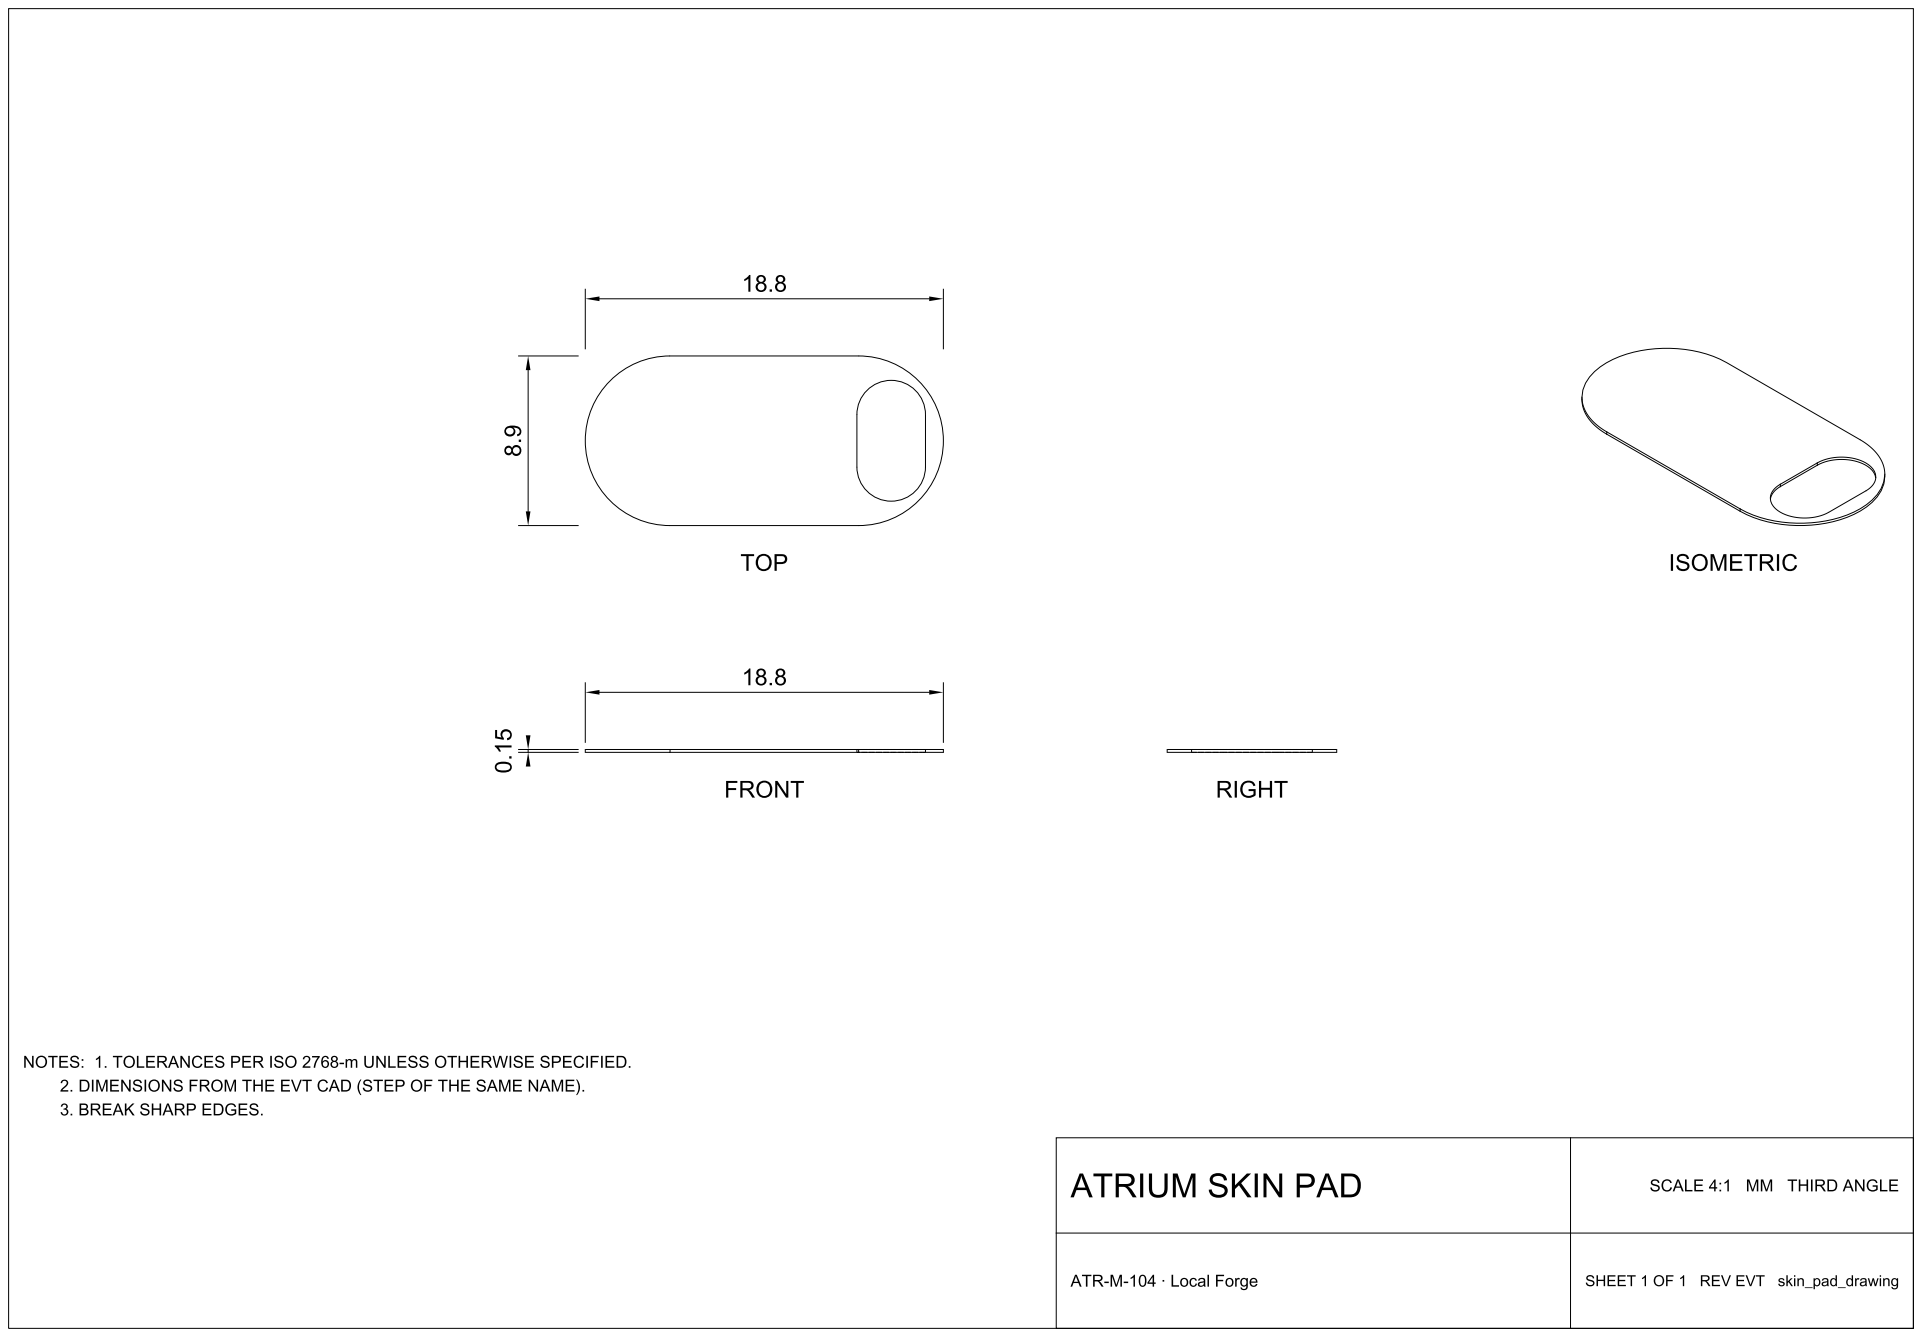
[picture p213: page 1]
