Het-Bhavsar/Atrium/mechanical/programming-jig/drawings/programming_jig_drawing.pdf

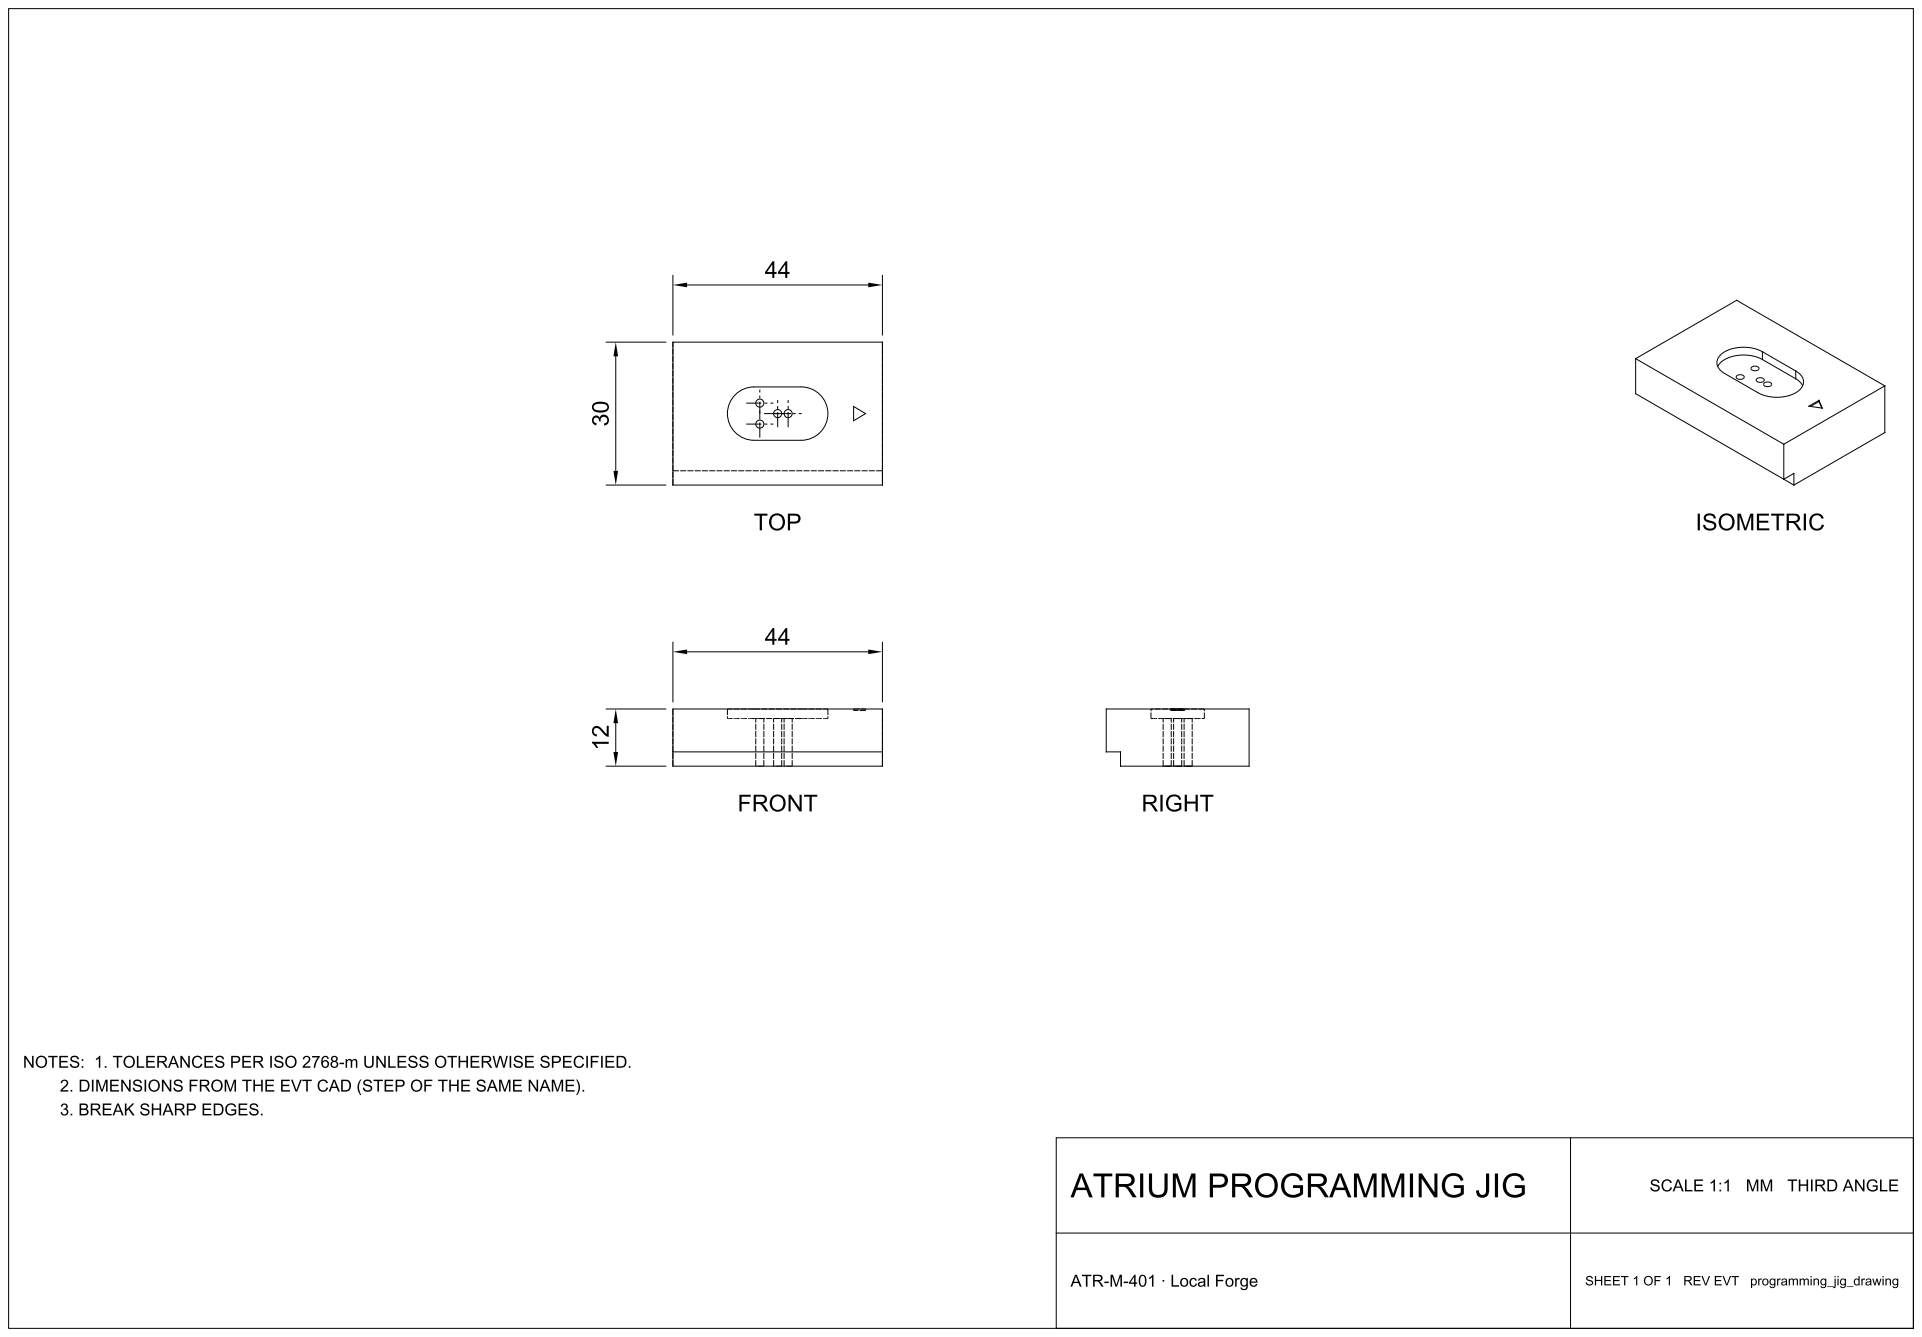
[picture p214: page 1]
