Het-Bhavsar/Atrium/hardware/case/charging-case/pcb/Atrium_Charging_Case_PCB.pdf

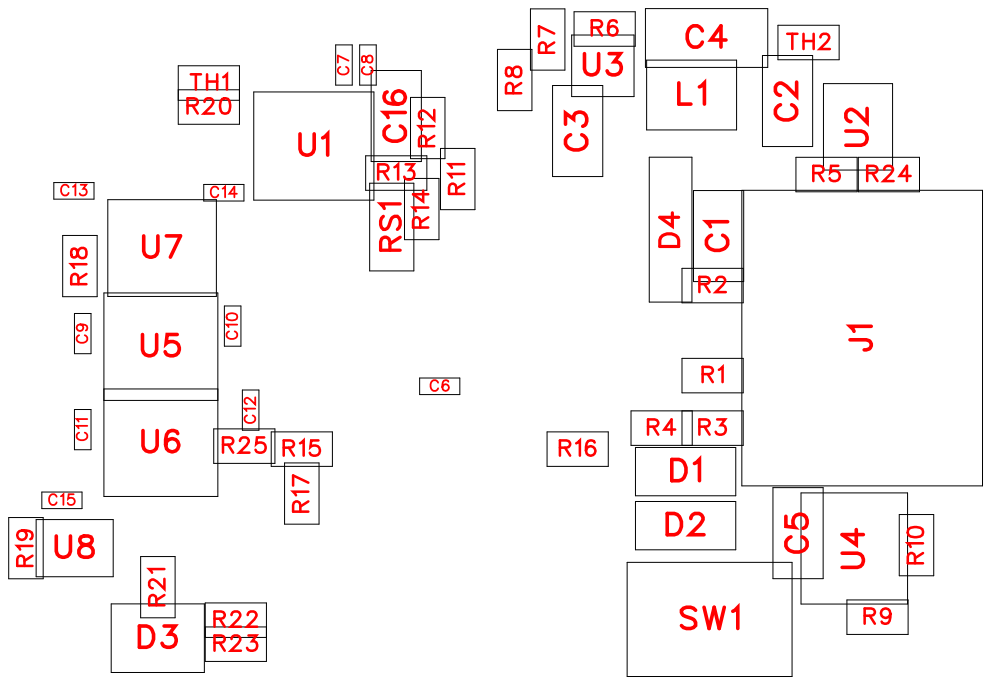
[picture p215: page 1]

R6 | C4
U3 | L1

No. | Quantity | Comment | Designator | Footprint | Value | Manufacturer Part | Manufacturer | Supplier Part | Supplier
1 | 3 | 10uF | C1,C3,C5 | C0603 | 10uF | CL10A106KP 8NNNC | SAMSUNG( ) 三星 | C19702 | LCSC
2 | 1 | 4.7uF | C2 | C0603 | 4.7uF | CL10A475K O8NNNC | SAMSUNG( ) 三星 | C19666 | LCSC
3 | 1 | 22uF | C4 | C0805 | 22uF | CL21A226M AYNNNE | SAMSUNG( 三星 ) | C602037 | LCSC
4 | 4 | 1uF | C6,C8,C13,C14 | C0402 | 1uF | CL05A105KA 5NQNC | SAMSUNG( 三星 ) | C52923 | LCSC
5 | 6 | 100nF | C7,C9,C10,C11,C12,C15 | C0402 | 100nF | CL05B104K O5NNNC | SAMSUNG( 三星 ) | C1525 | LCSC
6 | 1 | 100pF | C16 | C0603 | 100pF | CL10C101JB 8NNNC | SAMSUNG( ) 三星 | C14858 | LCSC
7 | 2 | 1N5819WS | D1,D2 | SOD-323_L1 .8-W1.3-LS2. 5-RD | | 1N5819WS | Hottech(合科 泰) | C191023 | LCSC
8 | 1 | XL-1615RGB C-RF | D3 | LED-ARRAY-SMD_4P-L1. 6-W1.5-BR_ XL-1615RGB C-RF | | XL-1615RGB C-RF | XINGLIGHT( ) 成兴光 | C965840 | LCSC
9 | 1 | TSD05DYFR | D4 | SOD-323_L1 .7-W1.3-LS2. 6_DYF0002A | | TSD05DYFR | TI(德州仪器 ) | C22396185 | LCSC
10 | 1 | TYPE-C 16PIN 2MD(073) | J1 | USB-C-SMD _TYPE-C-16 PIN-2MD-07 3 | | TYPE-C 16PIN 2MD(073) | SHOU HAN(首韩 ) | C2765186 | LCSC
11 | 1 | 1uH | L1 | IND-SMD_L2 .5-W2.0_WP N252012H | 1uH | WPN252012 H1R0MT | Sunlord(顺络 ) | C98348 | LCSC
12 | 2 | 5.1k | R1,R2 | R0402 | 5.1k | 0402WGF51 01TCE | UNI-ROYAL( ) 厚声 | C25905 | LCSC
13 | 2 | 2.2k | R3,R4 | R0402 | 2.2k | 0402WGF22 01TCE | UNI-ROYAL( 厚声 ) | C25879 | LCSC
14 | 1 | 2.7k | R5 | R0402 | 2.7k | 0402WGF27 01TCE | UNI-ROYAL( 厚声 ) | C25885 | LCSC
15 | 1 | 768k | R6 | R0402 | 768k | 0402WGF76 83TCE | UNI-ROYAL( 厚声 ) | C27017 | LCSC
16 | 3 | 100k | R7,R20,R25 | R0402 | 100k | 0402WGF10 03TCE | UNI-ROYAL( ) 厚声 | C25741 | LCSC
17 | 4 | 1M | R8,R10,R17,R18 | R0402 | 1M | 0402WGF10 04TCE | UNI-ROYAL( ) 厚声 | C26083 | LCSC
18 | 1 | 15k | R9 | R0402 | 15k | 0402WGF15 02TCE | UNI-ROYAL( 厚声 ) | C25756 | LCSC
19 | 1 | 10k | R11 | R0402 | 10k | 0402WGF10 02TCE | UNI-ROYAL( 厚声 ) | C25744 | LCSC
20 | 1 | 1.5M | R12 | R0402 | 1.5M | 0402WGF15 04TCE | UNI-ROYAL( 厚声 ) | C22276 | LCSC

21 | 2 | 1k | R13,R21 | R0402 | 1k | 0402WGF10 01TCE | UNI-ROYAL( 厚声 ) | C11702 | LCSC
22 | 1 | 20k | R14 | R0402 | 20k | 0402WGF20 02TCE | UNI-ROYAL( ) 厚声 | C25765 | LCSC
23 | 2 | 100 | R15,R16 | R0402 | 100 | 0402WGF10 00TCE | UNI-ROYAL( ) 厚声 | C25076 | LCSC
24 | 1 | 330k | R19 | R0402 | 330k | 0402WGF33 03TCE | UNI-ROYAL( 厚声 ) | C25778 | LCSC
25 | 2 | 330 | R22,R23 | R0402 | 330 | 0402WGF33 00TCE | UNI-ROYAL( 厚声 ) | C25104 | LCSC
26 | 1 | 2k | R24 | R0402 | 2k | 0402WGF20 01TCE | UNI-ROYAL( 厚声 ) | C4109 | LCSC
27 | 1 | 1 | RS1 | R0603 | 1 | 0603WAF10 0KT5E | UNI-ROYAL( ) 厚声 | C22936 | LCSC
28 | 1 | SKSCLAE01 0 | SW1 | SW-SMD_4P -L3.5-W2.9-P 1.30-LS4.8 | | SKSCLAE01 0 | ALPSALPIN E(阿尔卑斯阿 ) 尔派 | C130445 | LCSC
29 | 1 | NCU15WF10 4F6SRC | TH1 | R0402 | | NCU15WF10 4F6SRC | muRata(村田 ) | C458473 | LCSC
30 | 1 | NCP15XH10 3F03RC | TH2 | R0402 | | NCP15XH10 3F03RC | muRata(村田 ) | C77131 | LCSC
31 | 1 | CH32V003F4 U6 | U1 | QFN-20_L3.0 -W3.0-P0.40-TL-EP1.7 | | CH32V003F4 U6 | WCH(南京沁 恒) | C5299908 | LCSC
32 | 1 | BQ24040DS QR | U2 | WSON-10_L 2.0-W2.0-P0. 40-BL-EP | | BQ24040DS QR | TI(德州仪器 ) | C81080 | LCSC
33 | 1 | TPS61023D RLR | U3 | SOT-563-6_L 1.6-W1.2-P0. 5-LS1.6-BR | | TPS61023D RLR | TI(德州仪器 ) | C919459 | LCSC
34 | 1 | SY6280AAC | U4 | SOT-23-5_L3 .0-W1.7-P0.9 5-LS2.8-BL | | SY6280AAC | Silergy(矽力 杰) | C55136 | LCSC
35 | 2 | SN74LVC1T 45DBVR | U5,U6 | SOT-23-6_L2 .9-W1.6-P0.9 5-LS2.8-BR | | SN74LVC1T 45DBVR | TI(德州仪器 ) | C7843 | LCSC
36 | 1 | XC6206P182 MR | U7 | SOT-23-3_L2 .9-W1.6-P1.9 0-LS2.8-BR | | XC6206P182 MR | TOREX(特瑞 仕) | C21659 | LCSC
37 | 1 | HAL248 SW | U8 | DFN-6_HAL2 48_SW | | HAL248 SW | Hallwee(霍尔 ) 微电子 | C6320892 | LCSC

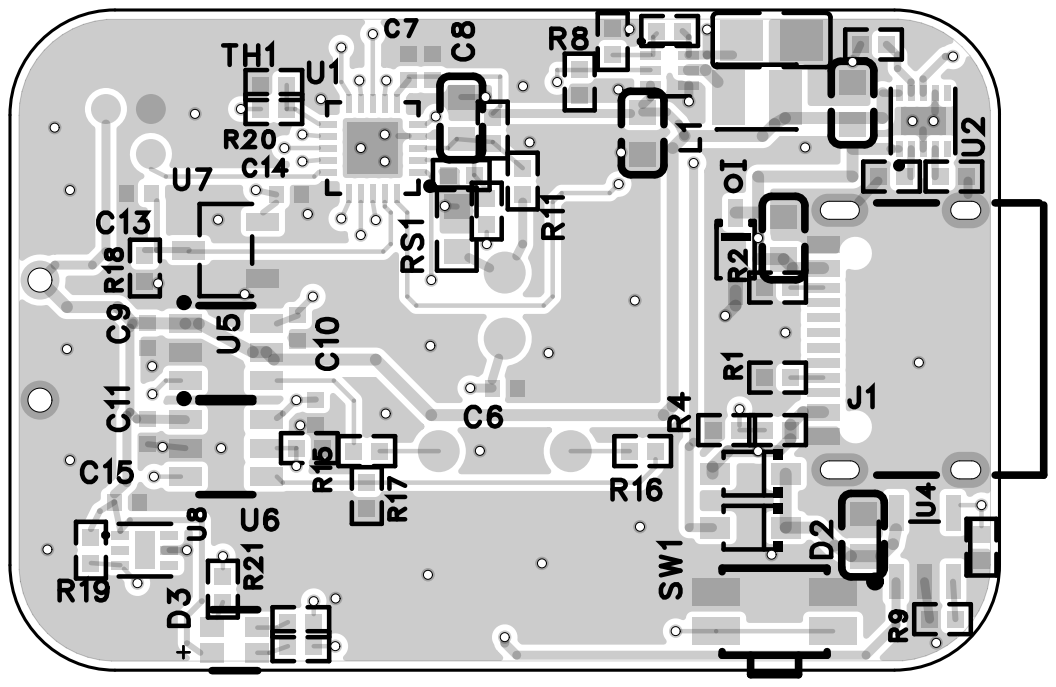
[picture p216: page 5]

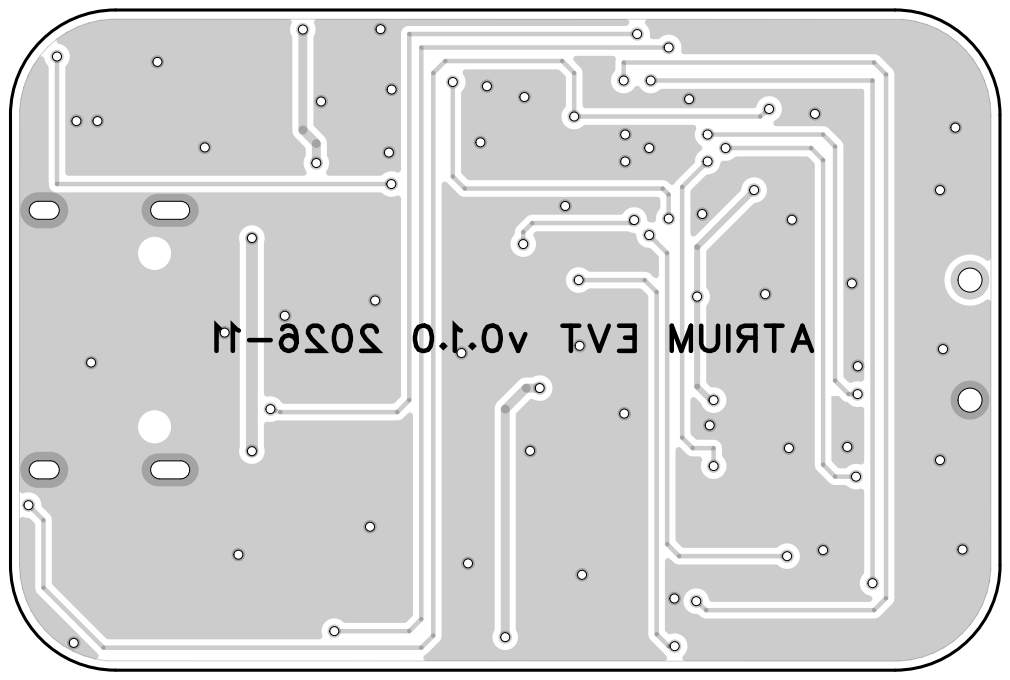
[picture p217: page 6]

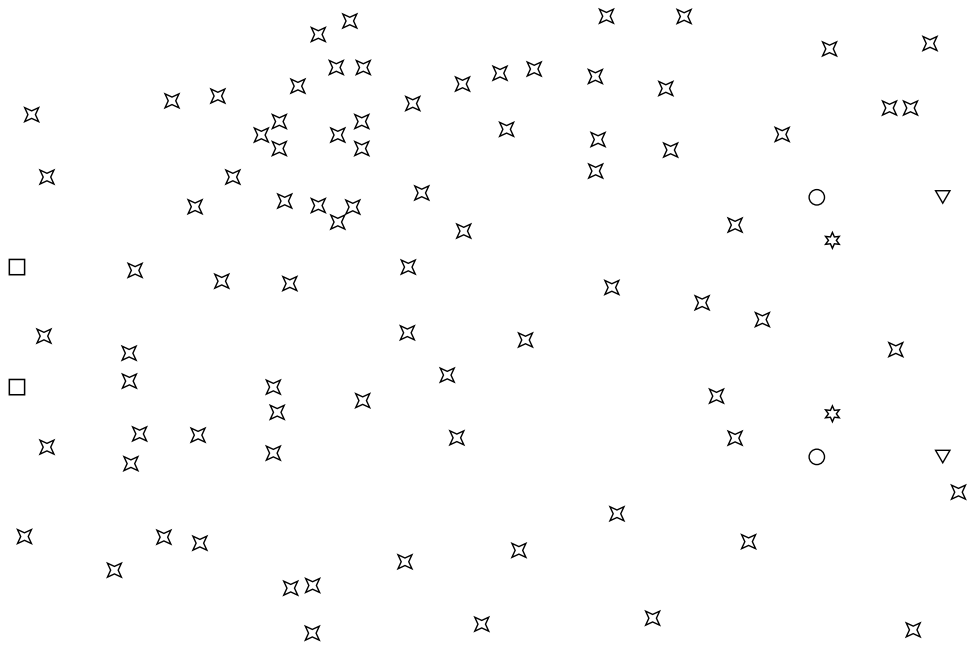
[picture p218: page 7]
