Het-Bhavsar/Atrium/(list of files, drawings)

Other design files:
hardware/case/charging-case/pcb/Atrium_Charging_Case.PcbDoc
hardware/case/charging-case/schematic/Atrium_Charging_Case.SchDoc
hardware/pod/flex-jumper/pcb/Atrium_Flex_Jumper.PcbDoc
hardware/pod/flex-jumper/schematic/Atrium_Flex_Jumper.SchDoc
hardware/pod/islands-panel-1x2/Pod_Islands_Panel_1x2.PcbDoc
hardware/pod/islands-panel/Pod_Islands_Panel.PcbDoc
hardware/pod/power-island/pcb/Atrium_Power_Island.PcbDoc
hardware/pod/power-island/schematic/Atrium_Power_Island.SchDoc
hardware/pod/radio-island/pcb/Atrium_Radio_Island.PcbDoc
hardware/pod/radio-island/schematic/Atrium_Radio_Island.SchDoc
legacy/rev-b1/altium/rev-b1_case_boost.SchDoc
legacy/rev-b1/altium/rev-b1_case_Case_PCB.PcbDoc
legacy/rev-b1/altium/rev-b1_case_charger.SchDoc
legacy/rev-b1/altium/rev-b1_pod_1_Power.SchDoc
legacy/rev-b1/altium/rev-b1_pod_3_Optical.SchDoc
legacy/rev-b1/altium/rev-b1_pod_4_Sensors.SchDoc
legacy/rev-b1/altium/rev-b1_pod_Case.SchDoc
legacy/rev-b1/altium/rev-b1_pod_Pod_PCB.PcbDoc
