Het-Bhavsar/Atrium/hardware/design-data/netlist/case_nets.yaml

# Atrium charging case (EVT, Rev B 2026-11-10: BQ24040 charger with cell-temperature cut-off): single 2-layer board under the nest. Spec: docs/charging-case.md.
# Same schema as atrium_nets.yaml. LCSC numbers checked against EasyEDA's LCSC-linked library 2026-11-08.
# Pads without an LCSC number are copper pads (cell tabs, pogo landings, programming pads): placeholder pad on the
# schematic, off the BOM.
meta:
  board_names: {CASE: case}
  mcu_pinmap: firmware session 2026-11-08 (CH32V003F4U6 QFN-20, ch32fun)

components:
  U1:  {board: CASE, side: top, part: CH32V003F4U6 RISC-V MCU, pkg: QFN-20 3x3 0.4p, lcsc: C5299908}
  U2:  {board: CASE, side: top, part: BQ24040DSQR linear Li-ion charger with battery-temperature (TS) input, pkg: WSON-10 2x2 0.4p EP, lcsc: C81080,
        note: "Rev B (2026-11-10), replaces the TP4054 (no temperature input, low stock). R5 2.7k on ISET: 540 / 2700 = 200 mA (189-207 mA, K_ISET 510-560 AΩ, SLUS941H table 7.5). ISET2 to VSS: the ISET current. R24 2k on PRE-TERM: termination 10 %, pre-charge 20 %. TS: TH2 10k NTC on the board above the cell (3.0 mm from U2, see build item B-10), 50 uA internal bias; outside the JEITA window the charger halves the current (cold) or drops to 4.06 V (warm) and stops at the limits, with no MCU involved. Fixed 10 h safety timer, 6.6 V input OVP. CHG open drain to PD6 as before; PG and NC unconnected. Thermal pad to GND"}
  U3:  {board: CASE, side: top, part: TPS61023DRLR boost (same part as DRLT on a 3k reel; DRLT stock was 555), pkg: SOT-563, lcsc: C919459, note: "5.21 V: 0.6 V x (1 + 768k / 100k)"}
  U4:  {board: CASE, side: top, part: SY6280AAC current-limited switch, pkg: SOT-23-5, lcsc: C55136,
        note: "ISET 15k: 6800 / 15000 = 0.45 A (hardware backstop; firmware trips at 80 mA)"}
  U5:  {board: CASE, side: top, part: SN74LVC1T45DBVR (SWDCLK, A -> B), pkg: SOT-23-6, lcsc: C7843}
  U6:  {board: CASE, side: top, part: SN74LVC1T45DBVR (SWDIO, DIR from MCU), pkg: SOT-23-6, lcsc: C7843}
  U7:  {board: CASE, side: top, part: XC6206P182MR 1.8 V LDO (powered from PD5), pkg: SOT-23-3, lcsc: C21659}
  U8:  {board: CASE, side: top, part: HAL248 SW omnipolar hall (lid), pkg: DFN-6, lcsc: C6320892}
  J1:  {board: CASE, side: top, part: USB-C 16-pin receptacle, lcsc: C2765186}
  L1:  {board: CASE, side: top, part: 1 uH 4.2 A 54 mohm 2520, lcsc: C98348}
  D1:  {board: CASE, side: top, part: 1N5819WS SOD-323 Schottky (VBUS -> 5V_POD; replaces B5819WS C179554, out of stock), lcsc: C191023,
        note: "SOD-323, not SOD-123: two stacked SOD-123 bodies (1.6 mm) did not fit between SW1 and J1 (mech fit 2026-11-08) [VERIFY Pd at the 0.45 A ISET limit]"}
  D2:  {board: CASE, side: top, part: 1N5819WS SOD-323 Schottky (boost -> 5V_POD; replaces B5819WS C179554, out of stock), lcsc: C191023,
        note: "SOD-323, not SOD-123: two stacked SOD-123 bodies (1.6 mm) did not fit between SW1 and J1 (mech fit 2026-11-08) [VERIFY Pd at the 0.45 A ISET limit]"}
  D4:  {board: CASE, side: top, part: TSD05DYFR 5 V unidirectional TVS (VRWM 5.5 V, VBR >= 6 V, clamp 11.5 V max at 24 A, leakage 50 nA max), pkg: SOD-323, lcsc: C22396185,
        note: "VBUS to GND beside C1, about 3 mm of track from J1 VBUS (2026-11-10). No 5 V TVS clamps under 6 V, so C1 (10 uF) still takes the ESD charge; D4 takes the surge energy"}
  D3:  {board: CASE, side: top, part: XL-1615RGBC-RF RGB LED, lcsc: C965840, note: "common anode to VDD [VERIFY pinout]"}
  SW1: {board: CASE, side: top, part: Alps SKSCLAE010 side-push tactile 3.5 x 2.9 x 1.25 (stem to the -Y wall), lcsc: C130445}
  TH1: {board: CASE, side: top, part: "NCU15WF104F6SRC 100k NTC, B 4250 K class (case cell, read by the MCU while feeding the pod; replaces the end-of-life NCP15WF104F03RC C77130) [VERIFY B against the firmware table]", lcsc: C458473}
  TH2: {board: CASE, side: top, part: "NCP15XH103F03RC 10k NTC B25/50 3380 K on the board above the case cell, for the charger TS input", lcsc: C77131}
  RS1: {board: CASE, side: top, part: 1 ohm 1 % 0603 shunt (low side, pod GND return), lcsc: C22936}
  R1:  {board: CASE, side: top, part: 5.1k CC1, lcsc: C25905}
  R2:  {board: CASE, side: top, part: 5.1k CC2, lcsc: C25905}
  R3:  {board: CASE, side: top, part: 2.2k VBUS_DET series, lcsc: C25879,
        note: "2.2k / 2.2k since 2026-11-10 (was 10k / 100k). With USB out and the boost on, D1 leaks up to about 60 uA at 70 C back into VBUS; into 4.4k that is 0.13 V at PC1, under VIL 0.71 V (100k gave a false USB detect). USB in: 0.5 x VBUS = 2.3-2.8 V, over VIH 1.88 V at VDD 4.2 V. 1.1 mA from VBUS while plugged in"}
  R4:  {board: CASE, side: top, part: 2.2k VBUS_DET to GND, lcsc: C25879}
  R5:  {board: CASE, side: top, part: 2.7k BQ24040 ISET (200 mA), lcsc: C25885}
  R6:  {board: CASE, side: top, part: 768k boost FB top, lcsc: C27017}
  R7:  {board: CASE, side: top, part: 100k boost FB bottom, lcsc: C25741}
  R8:  {board: CASE, side: top, part: 1M BOOST_EN pull-down, lcsc: C26083}
  R9:  {board: CASE, side: top, part: 15k SY6280 ISET, lcsc: C25756}
  R10: {board: CASE, side: top, part: 1M VIN_EN pull-down, lcsc: C26083}
  R11: {board: CASE, side: top, part: 10k shunt to OPA_P, lcsc: C25744}
  R12: {board: CASE, side: top, part: 1.5M VDD to OPA_P (offset pedestal), lcsc: C22276}
  R13: {board: CASE, side: top, part: 1k OPA Rg, lcsc: C11702}
  R14: {board: CASE, side: top, part: 20k OPA Rf, lcsc: C25765}
  R15: {board: CASE, side: top, part: 100 ohm SWDCLK series, lcsc: C25076}
  R16: {board: CASE, side: top, part: 100 ohm SWDIO series, lcsc: C25076}
  R17: {board: CASE, side: top, part: 1M SWDIO_B pull-down (pod presence), lcsc: C26083}
  R18: {board: CASE, side: top, part: 1M LDO_PWR pull-down, lcsc: C26083}
  R19: {board: CASE, side: top, part: 330k LID pull-up (the HAL248 output is open drain, Hallwee data sheet V3.3 p4), lcsc: C25778}
  R20: {board: CASE, side: top, part: 100k NTC divider top (from PD0), lcsc: C25741}
  R21: {board: CASE, side: top, part: 1k LED red, lcsc: C11702}
  R22: {board: CASE, side: top, part: 330 ohm LED green, lcsc: C25104}
  R23: {board: CASE, side: top, part: 330 ohm LED blue, lcsc: C25104}
  R24: {board: CASE, side: top, part: 2k BQ24040 PRE-TERM (10 % termination, 20 % pre-charge), lcsc: C4109}
  R25: {board: CASE, side: top, part: 100k SWDIO_DIR pull-down, lcsc: C25741,
        note: "Holds U6 DIR low (B to A: the pod drives, the MCU pin listens) from power-up until firmware sets PC7. DIR leakage 2 uA max gives 0.2 V at most (2026-11-10)"}
  C1:  {board: CASE, side: top, part: 10 uF 0603 VBUS, lcsc: C19702}
  C2:  {board: CASE, side: top, part: 4.7 uF 0603 charger OUT (BAT), lcsc: C19666}
  C3:  {board: CASE, side: top, part: 10 uF 0603 boost in, lcsc: C19702}
  C4:  {board: CASE, side: top, part: 22 uF 0805 boost out (CL21A226MAYNNNE), lcsc: C602037}
  C5:  {board: CASE, side: top, part: 10 uF 0603 5V_POD, lcsc: C19702}
  C6:  {board: CASE, side: top, part: 1 uF 0402 pogo VIN, lcsc: C52923}
  C7:  {board: CASE, side: top, part: 100 nF MCU VDD, lcsc: C1525}
  C8:  {board: CASE, side: top, part: 1 uF MCU VDD, lcsc: C52923}
  C9:  {board: CASE, side: top, part: 100 nF U5 VCCA, lcsc: C1525}
  C10: {board: CASE, side: top, part: 100 nF U5 VCCB, lcsc: C1525}
  C11: {board: CASE, side: top, part: 100 nF U6 VCCA, lcsc: C1525}
  C12: {board: CASE, side: top, part: 100 nF U6 VCCB, lcsc: C1525}
  C13: {board: CASE, side: top, part: 1 uF LDO in, lcsc: C52923}
  C14: {board: CASE, side: top, part: 1 uF LDO out, lcsc: C52923}
  C15: {board: CASE, side: top, part: 100 nF hall, lcsc: C1525}
  C16: {board: CASE, side: top, part: 100 pF OPA_P filter, lcsc: C14858}
  BT1: {board: CASE, side: bot, part: "cell + tab pad (Sharvi KP-502030)"}
  BT2: {board: CASE, side: bot, part: "cell - tab pad"}
  P1:  {board: CASE, side: top, part: "pogo VIN landing (pod VIN 10.45, 5.50)"}
  P2:  {board: CASE, side: top, part: "pogo GND landing (pod GND_B 12.65, 5.50)"}
  P3:  {board: CASE, side: top, part: "pogo SWDIO landing (pod 6.70, 3.30)"}
  P4:  {board: CASE, side: top, part: "pogo SWDCLK landing (pod 6.70, 7.70)"}
  TP1: {board: CASE, side: bot, part: "SWIO programming pad"}
  TP2: {board: CASE, side: bot, part: "VDD programming pad"}
  TP3: {board: CASE, side: bot, part: "GND programming pad"}

nets:
  GND:        [U1.VSS, U1.EP, U2.GND, U3.GND, U4.GND, U5.GND, U6.GND, U7.GND, U8.GND, J1.GND, J1.SHELL, BT2, RS1.2, R1.2, R2.2,
               R4.2, R7.2, R8.2, R10.2, R13.2, R17.2, R18.2, TH1.2, SW1.3, SW1.4, C1.2, C2.2, C3.2, C4.2, C5.2, C6.2, C7.2, C8.2,
               C9.2, C10.2, C11.2, C12.2, C13.2, C14.2, C15.2, C16.2, R9.2, R5.2, TP3,
               U2.VSS, U2.EP, U2.ISET2, R24.2, TH2.2, D4.2, R25.2]
  VBUS:       [J1.VBUS, U2.IN, D1.A, R3.1, C1.1, D4.1]
  CC1:        [J1.CC1, R1.1]
  CC2:        [J1.CC2, R2.1]
  VDD:        [BT1, U2.OUT, C2.1, U1.VDD, C7.1, C8.1, U3.VIN, L1.1, C3.1, U5.VCCA, U5.DIR, U6.VCCA, C9.1, C11.1, U8.VDD, C15.1,
               R12.1, R19.1, D3.A, TP2]
  BOOST_SW:   [U3.SW, L1.2]
  BOOST_OUT:  [U3.VOUT, C4.1, R6.1, D2.A]
  BOOST_FB:   [U3.FB, R6.2, R7.1]
  BOOST_EN:   [U1.PD2, U3.EN, R8.1]
  5V_POD:     [D1.K, D2.K, C5.1, U4.IN]
  VIN_EN:     [U1.PD0, U4.EN, R10.1, R20.1]
  ISET:       [U4.ISET, R9.1]
  POGO_VIN:   [U4.OUT, C6.1, P1]
  POGO_GND:   [P2, RS1.1, R11.1]
  OPA_P:      [U1.PA2, R11.2, R12.2, C16.1]
  OPA_N:      [U1.PA1, R13.1, R14.1]
  OPA_OUT:    [U1.PD4, R14.2]
  VBUS_DET:   [U1.PC1, R3.2, R4.1]
  CHRG:       [U1.PD6, U2.CHG]
  CHG_ISET:   [U2.ISET, R5.1]
  CHG_PRETERM: [U2.PRETERM, R24.1]
  CHG_TS:     [U2.TS, TH2.1]
  LID:        [U1.PC2, U8.OUT, R19.2]
  BTN:        [U1.PC3, SW1.1, SW1.2]   # SKSC symbol: 1-2 one contact bar, 3-4 the other
  NTC_ADC:    [U1.PC4, R20.2, TH1.1]
  LED_R:      [U1.PD3, R21.1]
  LED_G:      [U1.PC0, R22.1]
  LED_B:      [U1.PD7, R23.1]
  LED_RK:     [R21.2, D3.R]
  LED_GK:     [R22.2, D3.G]
  LED_BK:     [R23.2, D3.B]
  SWDCLK_A:   [U1.PC5, U5.A]
  SWDCLK_B:   [U5.B, R15.1]
  POGO_SWDCLK: [R15.2, P4]
  SWDIO_A:    [U1.PC6, U6.A]
  SWDIO_DIR:  [U1.PC7, U6.DIR, R25.1]
  SWDIO_B:    [U6.B, R16.1, R17.1]
  POGO_SWDIO: [R16.2, P3]
  LDO_PWR:    [U1.PD5, U7.VIN, C13.1, R18.1]
  V1V8:       [U7.VOUT, U5.VCCB, U6.VCCB, C10.1, C12.1, C14.1]
  SWIO:       [U1.PD1, TP1]

no_connect: [J1.DP1, J1.DN1, J1.DP2, J1.DN2, J1.SBU1, J1.SBU2, U2.PG, U2.NC]
