Het-Bhavsar/Atrium/firmware/case/src/oc_fast.c

/*
 * Copyright (c) 2026 Het Bhavsar
 * SPDX-License-Identifier: Apache-2.0
 */
#include "oc_fast.h"

void oc_fast_vin(struct oc_fast *f, bool on, uint32_t now_ms)
{
	if (on && !f->vin) {
		f->vin_t0 = now_ms;
		f->over = 0;
	}
	if (!on) {
		f->over = 0;
	}
	f->vin = on;
}

bool oc_fast_armed(const struct oc_fast *f, uint32_t now_ms, uint16_t blank_ms)
{
	return f->vin && now_ms - f->vin_t0 >= blank_ms;
}

bool oc_fast_sample(struct oc_fast *f, bool armed, int32_t i_ua, bool sat, int32_t limit_ua)
{
	if (!armed) {
		f->over = 0;
		return false;
	}
	if (sat || i_ua > limit_ua) {
		if (f->over < UINT8_MAX) {
			f->over++;
		}
		if (f->over >= OC_FAST_COUNT) {
			f->over = 0;
			return true;
		}
		return false;
	}
	f->over = 0;
	return false;
}
