Het-Bhavsar/Atrium/firmware/src/power/headroom.h

/*
 * Copyright (c) 2026 Het Bhavsar
 * SPDX-License-Identifier: Apache-2.0
 *
 * LED headroom policy. The MAXM86161A LEDs run straight from VBAT, and green has
 * the highest forward voltage: up to 3.4 V at 175 mA (MAXM86161A data sheet
 * 19-102034 Rev 1; the MAXM86161 was 3.8 V at 150 mA), plus the driver's
 * compliance. That puts green at about 3.1 V on the 31 mA range [VERIFY Vf
 * against current], below the 3.3 V cut-off. The cell sags by I x R during each LED pulse, so the
 * limit applied to the VSYS reading is green-min-mv plus that sag. Below it,
 * green becomes IR at the same current in the same slot; a mode that already
 * has IR (full) drops its green slot (mode_green_to_ir). Plain C, no Zephyr.
 */
#ifndef ATRIUM_HEADROOM_H_
#define ATRIUM_HEADROOM_H_

#include <stdbool.h>
#include <stdint.h>

#ifdef __cplusplus
extern "C" {
#endif

#define HEADROOM_HYST_MV 50

struct headroom {
	uint16_t limit_mv;
	bool green_ok;
};

/* VCELL limit for green: green_min_mv plus the pulse sag green_ma x cell resistance. */
uint16_t headroom_limit_mv(uint16_t green_min_mv, uint16_t green_ma, uint32_t cell_mohm);

void headroom_init(struct headroom *h, uint16_t limit_mv);

/* Feed each VCELL reading. Returns whether green may run. */
bool headroom_update(struct headroom *h, uint16_t vbat_mv);

#ifdef __cplusplus
}
#endif

#endif /* ATRIUM_HEADROOM_H_ */
