Het-Bhavsar/Atrium/(commit log)

2026-11-05 Add Atrium Rev B.1 hardware, enclosure CAD and documentation
    [atrium_adhesive_diecut_revB1-1.dxf, atrium_case_assembly_lid_off_revB1-1.step, atrium_case_assembly_open_revB1-1.step, atrium_case_assembly_revB1-1.step, atrium_case_base_revB1-1.3mf, atrium_case_base_revB1-1.step, atrium_case_base_revB1-1.stl, atrium_case_cell_LP602525_revB1-1.step]
2026-11-05 Apply schematic simulation fixes: BQ24073, SMF6.0A, case UVLO, pod VBUS sense and charge inhibit
    [case_bom.csv, case_pin_netlist.csv, pod_bom.csv, pod_pin_netlist.csv]
2026-11-06 Improve pod skin comfort and add the Why Atrium story
    [atrium_adhesive_diecut_revB1-1.dxf, atrium_case_assembly_lid_off_revB1-1.step, atrium_case_assembly_open_revB1-1.step, atrium_case_assembly_revB1-1.step, atrium_pod_adhesive_diecut_revB1-1.step, atrium_pod_adhesive_foam_0p5_revB1-1.step, atrium_pod_adhesive_foam_0p8_revB1-1.step, atrium_pod_adhesive_liner_revB1-1.step]
2026-11-06 Clear USB-C in the case: move dock +1.8 mm, relocate hall and magnet
    [atrium_case_assembly_lid_off_revB1-1.step, atrium_case_assembly_open_revB1-1.step, atrium_case_assembly_revB1-1.step, atrium_case_cradle_revB1-1.3mf, atrium_case_cradle_revB1-1.step, atrium_case_cradle_revB1-1.stl, atrium_case_lid_revB1-1.3mf, atrium_case_lid_revB1-1.step]
2026-11-09 Move Rev B.1 to legacy and keep the superseded concepts
    Rev B.1 boards, CAD and simulation results, the Rev B.2 compact forms and the
    EVT form studies, each with a note on why it was left. Design scripts are not
    part of the release.
    [atrium_adhesive_diecut_revB1-1.dxf, atrium_blade_board_revB2.dxf, atrium_case_assembly_lid_off_revB1-1.step, atrium_case_assembly_open_revB1-1.step, atrium_case_assembly_revB1-1.step, atrium_case_base_revB1-1.3mf, atrium_case_base_revB1-1.step, atrium_case_base_revB1-1.stl]
2026-11-09 Add the EVT boards: radio and power islands, flex, case and islands panel
    Each board has its schematic and layout (Altium SchDoc/PcbDoc and PDF), STEP
    model, renders, Gerbers, BOM, CPL and IPC netlist. The islands panel carries
    2 x 3 pod sets for one PCBA order. Design data, simulation reports and the
    stencil report are included.
    [Atrium_Charging_Case.PcbDoc, Atrium_Charging_Case.SchDoc, Atrium_Charging_Case.step, Atrium_Charging_Case_BOM.csv, Atrium_Flex_Jumper.PcbDoc, Atrium_Flex_Jumper.SchDoc, Atrium_Flex_Jumper.step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]
2026-11-09 Add the EVT mechanical design: pod, case, Plinth, jig and packaging
    Reference drawings (PDF), STEP, STL and GLB for every part, skin-pad die-lines,
    product renders and the fit-check reports.
    [atrium_pod_assembly.step, atrium_pod_assembly_ref.step, atrium_pod_in_skin.step, atrium_pod_on_pad.step, case_assembly.step, case_button.step, case_button.stl, case_deck.step]
2026-11-09 Add the EVT pod and charging-case firmware
    Pod firmware on Zephyr for the atrium_pod board with unit tests; case firmware
    for the CH32V003.
    [fit_dark.csv, fit_dark_input.csv, fit_good.csv, fit_good_input.csv, fit_moving.csv, fit_moving_input.csv, fit_noisy.csv, fit_noisy_input.csv]
2026-11-09 Add the Atrium app for Android and iOS
    Flutter app with demo and real-pod modes, the BLE client for the pod and the
    phone-side sleep and night algorithms. No account and no cloud.
    [fit_dark.csv, fit_good.csv, fit_moving.csv, fit_noisy.csv, fit_saturated.csv, fit_weak.csv, phone_baseline.csv, phone_epochs.csv]
2026-11-09 Rewrite the README and docs for the EVT release; add contributor guides
    Story, architecture, mechanical, placement, charging case, build and test,
    roadmap and open items; brochure and renders; CONTRIBUTING, Code of Conduct,
    security policy and issue and pull-request templates. Per-folder licences.
2026-11-09 Re-export the flex jumper after the ground via fix
    The GND via at the power end now sits inside the ground pour and the SWDCLK track is snapped to its pad, so the flex has no open copper. Gerbers, PDF, STEP, PcbDoc, IPC-D-356A netlist and renders are re-exported from the saved board. A Gerber connectivity check joins JP9, JR1, JR3, JR6 and both GND contacts on one net; JP6 stays isolated until the power island is soldered, by design.
    [Atrium_Flex_Jumper.PcbDoc, Atrium_Flex_Jumper.step]
2026-11-09 Support a production signing key and document nRF programming
    fw.sh build takes ATRIUM_SIGNING_KEY to sign MCUboot and the app with the project's own ECDSA P-256 key, and warns when it falls back to the development key. src/VERSION sets the image version to 0.1.0. The flashing guide now lists the five base pads, the nrfutil and nrfjprog steps, the flash map, debug access, key handling and case programming. Keys are ignored by git.
2026-11-09 Add a quick start guide and new README imagery
    docs/quick-start.md walks through trying the app, opening the files, building the firmware, ordering and assembling, and flashing and pairing. The README gains a monochrome portrait, a studio render with the pod's dimensions, full-width plates of the boards and the case, the island and case layouts, and a section on what comes next: a custom cell for a smaller pod, a voice option and the deeper-optics research. The app README no longer lists a folder that is not in the repository.
2026-11-09 Drop the small board thumbnails now shown as full-width layouts
2026-11-09 Show the product in every folder: app screens, layouts, drawings and diagrams
    The main README gains the app screens. app/ shows every screen of the demo build; hardware/ shows the island and case layouts, the panel and the schematics; mechanical/ shows renders, a section and drawing previews; firmware/ gets an architecture and flash map diagram; legacy/ shows each earlier revision; docs/ gets an index with the brochure cover.
2026-11-09 Answer the brain blood flow question with the physics and the numbers
    docs/brain-blood-flow.md explains how optical sensing depth depends on emitter-detector spacing, what sits under the temporal region, and what the photon model gives for the pod's integrated 2 mm module, the 18.5 mm far channel tried in Rev B.1 and a 30 mm fNIRS spacing. It covers why processing cannot recover the brain share, the questions to ask of any such claim, and the tests still to run. The README's outlook carries a short version with a light-depth diagram.
2026-11-09 Publish the depth study behind the brain blood flow answer
    docs/research/brain-blood-flow/ holds the pre-registered study: the report, hypotheses, recording protocol, data inventory and research-mode analysis, seven figures, and every result file (photon model output, 500-study power sweeps, simulated null, muscle and deep studies, and finger timing from a public PhysioNet dataset). Its README sums up the answer with the source of each number. The brain blood flow page and the README link to it.
    [finger_check.csv, power.csv, subjects.csv]
2026-11-09 Make every public claim match its evidence
    Brain blood flow: cite Strangman et al. 2013 for the 8-13 % at 25-35 mm and the outer 10-15 mm bias, Brigadoi and Cooper 2015 for the 8.4 mm short channel and an MRI study for the 3.7-17 mm temporalis range; drop the uncited depth rule of thumb and the 5 mm typical muscle; mark skull and CSF thicknesses as model assumptions; widen the shortfall to 20-450 times; say the research modes are in the firmware but untested, and use rev 14 for modes 8 and 9. README: label the portraits and app screens as illustrations and demo data, give the real DRC status, call the case charge count an estimate, and name Zephyr rather than nRF Connect SDK. Fix stale basel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
2026-11-09 Show the flex jumper layout and set out OSHWA readiness
    Add a top and bottom plate of the flex jumper to the hardware page and the README. docs/certification.md now checks Atrium against each OSHWA requirement, states what is open and which third-party parts are not, and lists what must happen before applying.
2026-11-09 Add the EasyEDA Pro project, an exploded pod infographic and colour plates
    hardware/easyeda/ holds the native EasyEDA Pro project with every board, the editable source of the released schematics and layouts. The README and mechanical page gain a labelled exploded view of the pod from the release CAD, the board and case plates are back in colour, and the OSHWA readiness table now counts the design files as ready.
2026-11-09 Publish an accurate public brochure, credit component makers and explain resale
    The brochure is marked public and no longer overstates: about 4 days per charge with the 3.6-8 day simulated range, no seamless claim, reset-only from the case, 1-2 days per pad, 2.5-3 h case charge, designed but not yet built, no cloud, copyright Het Bhavsar. THIRD_PARTY_NOTICES lists every component maker, with trademark and no-endorsement notes. The README licence section says plainly what anyone selling hardware made from these files must do.
2026-11-09 Track the optics part change and version marking; ask contributors to sign off
    Open items O-41 and O-42: the MAXM86161EFD+T in the BOMs is obsolete at DigiKey and the active A-code is not yet confirmed as a drop-in, and no board carries a version mark yet. Contributors keep the copyright in their own work and sign off each commit under the Developer Certificate of Origin. The OSHWA readiness table now says both open points plainly.
2026-11-09 Mark the release version on the case board and the flex
    Bottom silkscreen, 1.0 mm characters: ATRIUM EVT v0.1.0 2026-11 on the charging-case board and EVT v0.1 on the flex inside each pod; the islands have no room for legible text. Gerbers, PCB PDFs, PcbDocs, renders and the EasyEDA project are re-exported; copper and mask layers are unchanged and DRC shows only the known accepted items. Closes open item O-42.
    [Atrium_Charging_Case.PcbDoc, Atrium_Flex_Jumper.PcbDoc]
2026-11-09 Add OTA updates, sync status and oxygen trend; case charger with cell-temperature cut-off; MAXM86161A
    App
    - Real firmware updates over BLE (MCUmgr SMP), fetched from the GitHub release.
    - Sync status with a warning before the pod's log fills (about 20 h).
    - Oxygen trend card: relative to the wearer's own baseline, Labs only, never a percentage.
    Case
    - BQ24040 charger replaces the TP4054: R5 2.7 k sets 200 mA, R24 sets termination and pre-charge, and TH2 on TS cuts or reduces the charge when the cell is too cold or too hot. Re-placed and hand-routed with assembly spacing.
    - Firmware cuts the pod feed within about 40 ms of a short (host-tested, 45 of 45).
    - 1N5819WS diodes, TPS61023DRLR and C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
    [Atrium_Charging_Case.PcbDoc, Atrium_Charging_Case.SchDoc, Atrium_Charging_Case.step, Atrium_Charging_Case_BOM.csv, Atrium_Radio_Island.PcbDoc, Atrium_Radio_Island.SchDoc, Atrium_Radio_Island_BOM.csv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]
2026-11-09 Check what the MAXM86161A's brighter LEDs allow, and re-check brain flow
    The data sheets' production-test counts put the A part's detected green
    at 1.7x the MAXM86161's; red and IR read the same. The LED currents stay
    at 15 / 10 / 5 mA, so the extra light goes to signal margin on darker
    skin: in the optics model, Fitzpatrick V-VI at 15 mA meets the SNR
    target in 49 % of cases, against 9 %. Green stays at 21-30 % of the
    16 uA range, so neither the range nor any saturation handling changes.
    A green trim would save 2-9 % of battery for lighter skin only. It would
    break the fixed-current stream contract, so it is sized but not built;
    the bench data it needs is O-43.
    Brain blood flow, re-checked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
    [maxm86161.c, modes.c, sensors.c]
2026-11-09 Check whether impedance stroke-volume monitoring can work from the temporal region
    The method in Analog Devices' ICG article drives 65 kHz through four gel
    electrodes spanning the chest and reads thoracic impedance with a
    dedicated bioimpedance front end, then applies the Sramek-Bernstein
    formula. The pod has no impedance channel, its two skin pads are the
    charging contacts millimetres apart on the scalp, and its PPG reads
    scalp, so none of it carries over. Head ballistocardiography at rest is
    listed as a bench question only. No stroke-volume claim.
2026-11-09 Compare the other routes to brain blood flow against the pod
    Head impedance, laser speckle, 30 mm fNIRS and ultrasound Doppler each
    need wide spacing, electrodes across the head, or an ultrasound array.
    None fits the pod. The page lists what the pod can honestly offer near
    the topic: a scalp perfusion trend and the signals that drive brain
    blood flow, never brain blood flow itself.
2026-11-09 Take the pod's reported version from VERSION, so updates verify correctly
    The MCUboot header was signed with firmware/src/VERSION, but the BLE
    Firmware Revision came from a second number in CMakeLists. After an
    update the app compares the two, so bumping only VERSION would show a
    good update as failed, and bumping neither would show a new release as
    already installed. Both now come from VERSION. A signing version set by
    hand must match it or the build stops, and fw.sh build checks the
    signed image's header against the string inside it
    (tests/check_version.py, with a self-test in fw.sh test).
    [check_version.py]
2026-11-09 Bring the firmware docs in line with the code
    The firmware README, the case README, the BLE spec and the firmware
    parts of architecture, features and flashing are checked line by line
    against the code. Dropped: the revision history for boards that no
    longer exist (fuel gauge, external flash, a third NTC), dead references,
    and machine-specific notes. Corrected where the code differs:
    - the MAXM86161A part name; green-min-mv 3100;
    - the green-to-IR swap (full drops green, the others swap it in place);
    - advertising and connection intervals, ATT MTU and DLE, Motion Data size;
    - the 3.60 V update guard, now implemented; image and RAM sizes;
    - build output paths; case pins, TH1 part and test name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
    [board.h, dfu_health.h, headroom.h, modes.c, modes.h, ppg_maxm86161.c, sense.h, soc_est.h]
2026-11-09 App: verified OTA, background sync, Hive storage, real scores, calmer inner pages
    Builds on 5abe7be (OTA, sync status and oxygen trend).
    OTA (checked against docs/ble_gatt.md section 9 and firmware/src):
    - Check the image's own SHA-256 TLV and GitHub's asset digest before anything
    is sent; MCUmgr names the image by that hash.
    - Read the slot list first: skip an image already running and confirmed,
    refuse while a trial is still running.
    - Never confirm from the app: after the reset, watch the slot list until the
    pod's 60 s health check confirms the image, or report the revert; with no
    slot list, wait 90 s before the version check.
    - Limit images to the pod's 216938 B slot (was 222105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
2026-11-09 Islands panel 4 x 5 (20 pods, 83 x 71 mm) for JLC Standard assembly; wider part spacing on both islands
    - Panel rebuilt at 4 x 5 sets from the updated islands: above JLC's 70 x 70 mm minimum for Standard PCBA,
    1,040 placements, 280 mouse bites. Checked against both islands part by part and against an independent
    merged-Gerber build (all copper, mask and paste layers, 4,544 drill hits). DRC 0. CPL now in Gerber coordinates.
    - Islands: parts moved 0.01-0.06 mm to open pad gaps; gaps under 0.15 mm 20 -> 11 (radio) and 8 -> 4 (power),
    DRC 0, outlines and stack-up unchanged. What is left is listed in open item O-45.
    - Antenna keep-out, radio and flex outlines and the stack-up note in the de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
    [Atrium_Power_Island.PcbDoc, Atrium_Power_Island.step, Atrium_Radio_Island.PcbDoc, Atrium_Radio_Island.step, Pod_Islands_Panel.PcbDoc, Pod_Islands_Panel_BOM.csv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]
2026-11-10 README: the 57 s assembly film (1080p, with score) and its poster
2026-11-10 Release 0.1.1: case cut-off armed from every VIN switch-on, app fixes and real data export, fit reports re-run
    Case firmware: main arms the 20 ms over-current check itself, 10 ms after each
    VIN-on edge (feed start, signature and soft-reset pulses included), instead of
    waiting for the 100 ms state machine. A short is cut 30-50 ms after VIN comes
    on in the host timing model, down from 210-720 ms. 48 of 48 case tests.
    Pod firmware 0.1.1 (VERSION), the image the app updates to.
    App 0.1.1: OTA reports done only once the pod shows the image active and
    confirmed, with a pending state until then; empty heart-rate bins stay gaps;
    walks and runs split on time gaps over 2 min; Export data writes the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
    [case_sm.c, case_sm.h, main.c, oc_fast.c, oc_fast.h, test_oc_fast.c]
2026-11-10 Panel BOM: released nRF52832, MAXM86161A and LQM18DN parts; skip-via drill data noted on O-32
    The panel BOM still carried the superseded nRF52832-CIAA-R (C509405), MAXM86161EFD+T (C3178309) and
    LQM18FN100M00D (C86083). It now matches 20 times the radio and power island BOMs line for line.
    O-32 records that the released drill files show the L1-L5 and L2-L6 skip vias as single 0.10 mm holes
    with no buried via under them, so the stacked build must be agreed with JLC or the layout given buried
    vias. The panel README gives the 4,004 unique holes behind the 4,544 drill hits, and the pod netlist
    header now names the 6-layer 0.82 mm stack.
    [Pod_Islands_Panel_BOM.csv]
2026-11-10 Islands: blind vias moved clear of the routed edge (JLC HDI 0.35 mm); skip-via note corrected
    JLC's HDI rules ask for 0.35 mm from a blind or skip via's hole edge to the routed edge. 14 vias were
    at 0.28-0.32 mm. 12 are moved: on the radio island six GND stitching vias, VDD_1V8 (off the U1 ball
    onto a 45 degree stub) and VSYS, with DEC1 on Inner1 and VDD_1V8 on Inner2 re-routed to keep spacing;
    on the power island three GND vias and VDD_IMU, with a buried GND via moved out of its way. The same
    edits are applied to all 20 copies on the panel. EasyEDA DRC: 0 on both islands and the panel.
    Gerber re-check: no shorts or opens against the netlists, all copper and hole spacing at or above
    JLC's mi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
    [Atrium_Power_Island.PcbDoc, Atrium_Radio_Island.PcbDoc, Pod_Islands_Panel.PcbDoc]
2026-11-10 Island PCB PDFs re-exported after the edge-via change
    Same six pages as before (placement, BOM, assembly drawings, drill drawing), now showing the via
    positions from the 0.35 mm edge-clearance change.
2026-11-10 App 0.1.2: raw signal recording, raw export, real "On this phone"
    - Settings > Research > Raw signal recording (off by default). On every connect it sets PPG
    Control bits 0 and 1 and records PPG Data (0x0202) and Motion Data (0x0204) as received, one
    session file per connection, with phone receive time. PodLink ORs the fit guide's and the
    recording's PPG Control bits, so leaving the fit guide keeps a recording and vice versa.
    No new foreground service: it records while the system keeps the app's Bluetooth link.
    - Session list: start, end, duration, light samples per slot, motion samples, missed
    notifications and gaps from the sequence numbers (wrap at 65535).
    - 500 MB limit: a writ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
2026-11-10 Release 0.1.2: raw signal recording in the app, blind vias clear of the board edge
    Release checklist entry for v0.1.2-evt: app 0.1.2 (raw signal recording and export, real
    "On this phone"), the islands' blind-via edge change and corrected panel BOM, firmware unchanged
    at 0.1.1 (the same image files are re-attached so the app's update check finds the pod image on
    the latest release). Quick start and README point at the 0.1.2 APKs.
2026-11-10 Panel render regenerated from the panel Gerbers after the blind-via edge change
    Same layout and style as before (top and bottom copper, paste and placements, 4 x 5 sets);
    it now shows the moved vias. All other hardware deliverables were checked against fresh EasyEDA
    exports: Gerbers, drills, netlists, BOM and CPL of every board match the repository.
2026-11-10 Pre-fab review fixes: Nordic RF match order, ANT1 far pad unconnected, case lid pull-up fitted
    Pin-by-pin datasheet review of every board before fabrication found three faults:
    - Radio island RF match: the board had L3 (3.3 nH) at the nRF ANT ball and C3 (1.0 pF) after it.
    Nordic's CIAA DC/DC reference (PS v1.8, section 53.5, Figure 175) puts C3 as a shunt on the ANT
    node and L3 in series after it. C3, L3 and C42 (DNP) swap lands, so only C3 pin 1 changes net
    (RF_50R to ANT_NRF); one short ANT_NRF link and a C3 ground via are added, two microvias go.
    - ANT1 (KH-1608-H08) pin 1 was tied to GND. None of Kinghelm's reference layouts grounds the far end
    (spec V1.0 pages 4-6), so the tie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
    [Atrium_Charging_Case.PcbDoc, Atrium_Charging_Case.SchDoc, Atrium_Charging_Case.step, Atrium_Charging_Case_BOM.csv, Atrium_Radio_Island.PcbDoc, Atrium_Radio_Island.SchDoc, Atrium_Radio_Island.step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]
2026-11-10 Flex: tie JP6 to the flex ground pour
    JP6, a GND jumper pad at the power-island end, had a via onto an isolated bottom pad and no copper
    path to the flex ground. It was joined only once the power island is soldered, so a bare-board test
    against the flex's own IPC-D-356A netlist would report GND open, and the power island returned its
    ground through JP9 alone. A 0.14 mm bottom track now runs from the JP6 via between the via rows into
    the ground pour (0.12 mm to the neighbouring via pads; flex rules 0.10 track-to-via, 0.15 to holes).
    Re-exported from EasyEDA and checked: flex DRC 0 (a planted short is caught, then removed); the only
    Gerber change is the new bottom track; Gerber copper against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
    [Atrium_Flex_Jumper.PcbDoc, Atrium_Flex_Jumper.step]
2026-11-10 Power caps to 10 uF 0402, case VBUS TVS and USB-detect fix, SWD DIR pull-down, titled schematics
    - Power island: C50 (VIN) and C52 (CELL_P) go from 1 uF 0201 to 10 uF 10 V 0402
    (CL05A106MP5NUNC, C315248), about 2 uF left at 5.3 V. C52 now stands vertical on the
    bottom between the clamp band and R51; the through GND via beside it moved to (3.20, 1.62)
    and its old microvia is gone. All 20 power copies on the panel carry the same change.
    DRC 0 on the island and the panel.
    - Case: D4 TSD05DYFR (C22396185) from VBUS to GND beside C1. R3/R4 are now 2.2k (C25879),
    so up to 60 uA of D1 reverse leakage reads 0.13 V at PC1 instead of a false USB detect.
    R25 100k (C25741) holds U6 DIR low f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
    [Atrium_Charging_Case.PcbDoc, Atrium_Charging_Case.SchDoc, Atrium_Charging_Case.step, Atrium_Charging_Case_BOM.csv, Atrium_Flex_Jumper.SchDoc, Atrium_Power_Island.PcbDoc, Atrium_Power_Island.SchDoc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]
2026-11-11 Antenna on Kinghelm's land pattern; pre-fab datasheet items closed
    - ANT1 (KH-1608-H08) now uses Kinghelm's footprint from spec V1.0 p6: 0.70 x 0.90 mm pads at
    1.875 mm pitch. The old library land (0.60 x 1.15 mm at 1.512 mm) put copper 0.13 mm further
    under the body. Same centre; the pads end 0.27 mm from the board edge (was 0.20). The feed from
    Z41 is one straight 50 ohm line into pad 2, the top keep-out keeps a single notch for it, and the
    feed-end silk dot moved off the pad opening. All 20 panel copies carry the change. DRC 0 on the
    radio island and the panel; Gerber copper has no shorts or opens; only the antenna area of the
    top layers changes. O-50.
    - Datasheet items closed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
    [Atrium_Radio_Island.PcbDoc, Atrium_Radio_Island.step, Pod_Islands_Panel.PcbDoc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]
2026-11-11 Release checklist: v0.1.3-evt
    The unreleased entry becomes v0.1.3-evt: the 10 and 11 November pre-fabrication changes (O-48, O-49, O-50) on unchanged firmware 0.1.1 and app 0.1.2, whose files are attached to the release unchanged.
2026-11-11 Open items: antenna far-pad extension in Kinghelm's layouts (O-7, O-13)
    Kinghelm's layouts 2 and 3 run a floating copper extension from the far pad; ours has none, and the copper-free zone is half of their smallest. O-13 now expects the resonance high and names the DVT fallback.
2026-11-14 App: OTA checked against v0.1.3-evt, demo runs the real update, onboarding and on-photo colour
    - OTA: test against the real releases/latest reply of v0.1.3-evt (trimmed fixture): picks
    atrium-pod-0.1.1.bin, 213,968 B under the 216,938 B slot, with its GitHub digest. With
    ATRIUM_POD_IMAGE set, the same test parses the released image itself (MCUboot header,
    version 0.1.1, SHA-256 TLV, digest); the image is not stored here.
    - Pod software shows release notes only when an update is on offer: a release can carry the
    same pod image with notes about other parts.
    - Demo build: the real update flow and screen run against a simulated release, upload and pod
    (generated MCUboot image, trial sl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
2026-11-14 Case vias to 0.3 mm; 1 x 2 islands panel for a small EVT run
    - Charging case: all 81 via holes 0.20 -> 0.30 mm, pads stay 0.45 mm, so the board builds as a standard JLC
    2-layer order (no plugged-via or 4-wire-test surcharge). Copper, mask, paste and silk Gerbers are identical to
    v0.1.3-evt; hole edge to other-net copper is at least 0.225 mm. DRC unchanged (J1's own pads to its slots).
    Re-exported Gerbers, IPC, STEP, PcbDoc and PCB PDF.
    - New hardware/pod/islands-panel-1x2/: the islands panel cut to two sets (26 x 35.6 mm, 2 pods per panel) so an EVT
    build needs 4 pods, not 40. DRC 0; inside the frame every copper, paste and silk layer and every drill hit match
    the 4 x 5 panel. Gerb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
    [Atrium_Charging_Case.PcbDoc, Atrium_Charging_Case.step, Pod_Islands_Panel_1x2.PcbDoc, Pod_Islands_Panel_1x2_BOM.csv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]
